Spok1978/hybrid-radio/hardware/kicad/carriers/README.md

# Лист для макетирования доп. плат IP-Radio — отчёт

Срез на 2026-10-09. Это выполнение промпта «Схема одним листом для макетирования и
проверок». Формат — KiCad 10: установленная версия, по указанию заказчика вместо
KiCad 8.

## 1–3. Файлы

| № | Файл | Что это |
|---|---|---|
| 1 | `hybrid-radio-carriers.kicad_pro` | проект KiCad |
| 2 | `hybrid-radio-carriers.kicad_sch` | один лист A1, без иерархии, три зоны в рамках |
| 3 | `hybrid-radio-carriers.net` | нетлист, выгружен из листа командой `kicad-cli sch export netlist` |
| — | `sym-lib-table`, `fp-lib-table` | ссылки на библиотеки проекта `../hybrid-radio.*` |

Лист генерирует скрипт `hardware/skidl/make_carriers_sheet.py` из
`hardware/skidl/carrier.py` (через нетлист `hardware/kicad/Hybryd Radio.net`).
Правки схемы вносить в `carrier.py`, затем перезапускать скрипт.

Проверки, выполненные на этих файлах:

| Проверка | Результат |
|---|---|
| ERC, все уровни серьёзности (`kicad-cli sch erc --severity-all`) | 0 нарушений |
| Сверка соединений с нетлистом SKiDL (`compare_netlists.py`, без P4) | 66 цепей из 66, расхождений 0 |
| P4 ↔ J3, контакт в контакт | 40 из 40 совпадают |
| Деталей плат в нетлисте листа | 91 (плюс P4 и служебные #PWR, #FLG) |
| Позиционные обозначения | как в `docs/35-carrier-boards-parts.md`, без переаннотации |
| DNP | R14, R15 |
| Выводов без провода | 0 (провода: 938 отрезков, точек соединения 176) |

## Отличия от промпта и почему

| Требование промпта | Как сделано | Почему |
|---|---|---|
| KiCad 8, формат 20231120 | KiCad 10 | указание заказчика: формат установленной версии |
| «Полная прорисовка всех соединений» | Внутри каждой зоны все цепи, включая силовые, проведены проводами от вывода к выводу (938 отрезков, 176 точек соединения). У каждой силовой цепи в зоне один символ питания, подключённый проводом. Между зонами цепи связаны одноимёнными метками, как требует промпт. На каждой цепи стоит метка с её именем | Провода прокладывает `hardware/skidl/sch_router.py`: ортогонально, по сетке 1,27 мм. Чужие провода только пересекаются насквозь, без изгиба и ответвления в точке пересечения — KiCad их не соединяет. Отсутствие замыканий подтверждено сверкой нетлиста |
| Сверка скриптом `netlist/check_netlist.py` | сверка скриптом `hardware/skidl/compare_netlists.py` | `check_netlist.py` читает только `netlist/ip-radio.yaml` и не принимает `.net`; к тому же yaml описывает сборку на Raspberry Pi (см. «Расхождения») |
| Символы модулей «по присланной распиновке» | символы проекта из `hybrid-radio.kicad_sym`, распиновки — из `docs/33` §6, §13 | данные уже есть в репозитории (см. Фазу 1) |
| Плата P4 — коннектор «внешнее устройство» | символ P4 (`ESP32-P4-Board`): выводы 1–40 — гребёнка J3 по `docs/33` §2, выводы 41–42 — USB-C | `docs/30` содержит два варианта раскладки, итоговая — в `docs/33` |

## Фаза 1. Распиновки модулей

| Модуль | Какие выводы нужны | Что известно и откуда | Что ещё нужно |
|---|---|---|---|
| RRD-102 (RDA5807M) | VCC, GND ×3, SDA, SCL, LOUT, ROUT, ANT | все 10 выводов: библиотека JLCEDA/EasyEDA (LCSC C9900205627), совпадает с реверсом модуля (`docs/33` §13) | — |
| GY-PCM5102A | VIN, GND, BCK, LCK, DIN, SCK, FLT, DEMP, FMT, XSMT, L, R, AGND, A3V3 | ряды — по фото продавца; подписи 11–15 сняты с обратной стороны (`docs/33` §6) | сверить подписи на модуле при монтаже |
| MCP23017 CJMCU | VCC, GND, SDA, SCL, A0–A2, RESET, INTA, GPA0–6, GPB0–1 | по модулю (`docs/33` §6, §13); GPA7 и GPB7 — только выходы (Microchip DS20001952E) | какой столбец двойного ряда — GPA, какой — GPB (`docs/33` §8) |
| WeAct SY8205 | IN+, IN−, OUT+, OUT−, EN | по фото и замерам заказчика (`docs/33` §13) | работает ли модуль при неподключённом EN (`docs/33` §8) |
| HW-327 (TPA3118) | PWR±, OUT±, IN±, MUTE (2 площадки) | по фото (`docs/33` §6) | **на какой вывод TPA3118 идёт площадка MUTE: 2 (SDZ) или 12 (MUTE)** — от этого зависит выбор R14 или R15 |
| Вилка J3 ↔ гребёнка P4 | 40 контактов | таблица `docs/33` §2, сверена со схемой Waveshare, шелкографией и таблицей производителя | — |

## 5. Электрический аудит

### IRF4905 — защита от переполюсовки
- **Выводы.** По символу KiCad (`Transistor_FET:IRF4905`, наследует `IRF9540N`): 1 — G, 2 — D, 3 — S. По нетлисту: D (2) = 12V_FUSED (вход после F1), S (3) = +12V (нагрузка), G (1) = Q1_GATE через R1 100 кОм на GND.
- **Включение правильное** для P-канального ключа на «плюсе». При верной полярности ток сначала идёт через внутренний диод D→S, затвор оказывается на −12 В относительно истока, и канал открывается. При обратной полярности диод заперт, VGS ≈ 0 — ключ закрыт.
- **Напряжение затвора.** Предел VGS ±20 В; RDS(on) не больше 0,02 Ом при VGS = −10 В (даташит Infineon IRF4905PbF, Rev. 2.1, 2026-04-08). При 12 В на входе VGS = −12 В — в пределах.
- **Стабилитрон D1** (1N4744A, 15 В) стоит катодом на исток (+12V), анодом на затвор. Выводы `Device:D_Zener`: 1 — K, 2 — A; по нетлисту D1-1 = +12V, D1-2 = Q1_GATE. Он ограничивает VGS при выбросах значением 15 В, что меньше 20 В. Напряжение 15 В взято из номинала в перечне; с даташитом 1N4744A в этой сессии не сверено.

### Делитель PWR_SENSE (R2 39 кОм / R3 12 кОм, C3 100 нФ → GPIO50)
- **Коэффициент:** U = Uвх · 12 / (39 + 12) = 0,2353 · Uвх. При 12 В на выводе 2,82 В, при 11 В — 2,59 В, при 13 В — 3,06 В.
- **Пороги ESP32-P4:** VIH ≥ 0,75 · VDD = 2,48 В, предел — VDD + 0,3 = 3,6 В (даташит ESP32-P4 v0.7, табл. 5-4; `docs/ref/esp32-p4-datasheet-v0.7.pdf`).
- **Предельные входы:** 3,6 В на выводе получается при 3,6 / 0,2353 = 15,3 В на входе. Требование промпта «не больше 3,3 В» выполняется до 3,3 / 0,2353 = 14,0 В.
- **Сопротивление и фильтр:** выходное сопротивление делителя 39 ‖ 12 = 9,18 кОм; вместе с C3 постоянная времени 9,18 кОм × 100 нФ = 0,92 мс.
- **Риск.** Выброс, который пропускает TVS D2 (P6KE16A), даёт на выводе больше 3,6 В. При 22 В (оценка уровня ограничения из `docs/33` §14) будет 22 × 0,2353 = 5,2 В. Ток ограничен сопротивлением 9,18 кОм, но насколько вход ESP32-P4 выдерживает такой ток, в этой сессии не проверено. Варианты защиты: стабилитрон 3,3 В параллельно R3 или диод Шоттки на +3V3_ESP. **В схему не внесено — решение за заказчиком.**

### HT7333-A — 3,3 В для тюнера
- **Выводы TO-92:** 1 — GND, 2 — VIN, 3 — VOUT. Источник — даташит Holtek HT73xx rev. 1.30, сверено при создании символа (`make_symbols.py`). По нетлисту U2-1 = GND, U2-2 = LDO_IN, U2-3 = LDO_OUT — совпадает.
- **Цепочка питания:** +5V → L1 10 мкГн → +5V_FILT → FB1 → LDO_IN (C6 10 мкФ, C7 100 нФ) → U2 → LDO_OUT (C8 10 мкФ, C9 100 нФ) → FB2 → +3V3_FM, C27 100 нФ у вывода питания тюнера.
- **Запас по напряжению:** RDA5807M работает от 2,7…3,0…3,3 В (даташит RDA5807M V1.1, таблица рабочих режимов; `docs/ref/RDA5807M_datasheet.pdf`). 3,3 В — верхняя граница; допуск выходного напряжения HT7333 в этой сессии не сверен.
- **Не сверено:** какие конденсаторы на входе и выходе HT7333 рекомендует даташит и какие у них требования (ёмкость, ESR). Скачать даташит не удалось: ссылки Holtek и LCSC отвечают «файл не найден».

### C10, C11 — разделительные на выходах тюнера
- **Потенциалы:** выходы RDA5807M сидят на постоянном напряжении 1,0…1,05…1,1 В («Audio Output Common Mode», даташит RDA5807M V1.1, с. 7). Со стороны микшера 0 В: узел SUM привязан к GND через R9/R12 100 кОм.
- **Полярность верная.** По нетлисту C10-1 (+) = RDA_LOUT, C10-2 = TUNER_L; C11-1 (+) = RDA_ROUT, C11-2 = TUNER_R. Плюс — на стороне с большим потенциалом.
- **Номинал:** 25 В — с большим запасом к 1,1 В. Ёмкость 4,7 мкФ — как C3/C4 в типовой схеме производителя (рис. 8-1, с. 15).

### R4–R6, 47 Ом в линиях I²S
- Это последовательные демпфирующие резисторы у входа PCM5102A: линия идёт через шлейф.
- Довод «ограничивают ток через защитные диоды ЦАП» таблицей PCM5102A не подтверждается: абсолютный предел цифрового входа −0,3…3,9 В (`docs/33` §5, ссылка на с. 6 даташита).
- По `docs/33` §5 можно сначала впаять перемычки, а резисторы ставить, если на осциллографе виден звон.

### Подтяжки и фильтры энкодеров (R16–R19 10 кОм к +3V3_ESP, C23–C26 10 нФ на GND)
- **Постоянная времени:** τ = 10 кОм × 10 нФ = 100 мкс. До порога VIH = 0,75 · VDD фронт дорастает за t = τ · ln(1 / (1 − 0,75)) = 100 мкс × 1,386 = 139 мкс.
- **Запас:** это примерно в 70 раз быстрее интервала между импульсами при быстром ручном вращении. Пример для оценки: 20 импульсов на оборот и 5 об/с дают переход каждые 10 мс. Число импульсов на оборот у купленных EC11 не сверено.

### Микшер: тюнер через 1 кОм, ЦАП через 10 кОм, 100 кОм на землю, RV1/RV2 10 кОм
Расчёт для левого канала, правый такой же. Второй источник по переменному току считается землёй: выходные сопротивления ЦАП и тюнера малы по сравнению с плечами. Входное сопротивление усилителя за C14 не учтено.
- **Тюнер → SUM_L.** Нагрузка R8 ‖ R9 ‖ RV1 = 10 ‖ 100 ‖ 10 = 4,76 кОм; коэффициент K = 4,76 / (1 + 4,76) = 0,826.
- **ЦАП → SUM_L.** Нагрузка R7 ‖ R9 ‖ RV1 = 1 ‖ 100 ‖ 10 = 0,901 кОм; коэффициент K = 0,901 / (10 + 0,901) = 0,083.
- **Соотношение плеч** около 10 : 1 в пользу тюнера выравнивает уровни двух источников:
  - ЦАП: 2,1 В × 0,083 = 0,17 В — сходится с `docs/33` §12;
  - тюнер: 0,36 В (уровень по `docs/33` §12) × 0,826 = 0,30 В.
- **R9/R12 100 кОм** держат узел SUM на постоянном потенциале 0 В. На этом основан вывод о полярности C10/C11 выше.

## 6. Расхождения и УТОЧНИТЬ

### Расхождения источников

| Источник | Что в нём | Как поступлено |
|---|---|---|
| `netlist/ip-radio.yaml` (ревизия 2026-08-21, помечен «НЕАКТУАЛЬНО») | Сборка на Raspberry Pi: A1 — Raspberry Pi 3 B+, свои обозначения (B1, B2, C1, C2, E…, G…), одна цепь +3V3, один моно-сумматор SUM, AMP_IN, кнопки MENU/MEM/PREV/NEXT/SEEK | Для доп. плат не применим: другие обозначения и состав. Цепи взяты из нетлиста `carrier.py`, по которому составлен перечень 35 |
| `docs/16-connection-list.md` | Помечен в шапке «НЕАКТУАЛЬНО — ревизия на Raspberry Pi» | Не использован |
| `docs/30-pin-assignment.md` | Два варианта раскладки; GPIO3, 21, 22, 28–32, 46–49 совпадают с J3 в `docs/33` §2 | Совпадения подтверждают раскладку |
| `docs/30` против `docs/33` | В `docs/30` GPIO50 свободен; в `docs/33` §5 и в схеме это PWR_SENSE (предложение, нужна поддержка в прошивке) | В схеме — как в `docs/33` и `carrier.py` |
| Приоритет промпта «parts > yaml > connection-list > pin-assignment» | Перечень 35 не содержит цепей, а yaml и docs/16 описывают другую сборку | Цепи взяты из нетлиста `carrier.py` — того же источника, из которого сделан перечень 35 |

### УТОЧНИТЬ
1. **R14 или R15.** Нужно прозвонкой выяснить, на какой вывод TPA3118 модуля HW-327 идёт площадка MUTE:
   - вывод 2 (SDZ, LOW — выключено) → впаять R14 на GND;
   - вывод 12 (MUTE, HIGH — выключено) → впаять R15 на +3V3_ESP и инвертировать AMP_SD в прошивке.

   На листе оба резистора DNP, пояснение — у блока.
2. **Защита GPIO50** от выбросов через делитель PWR_SENSE (см. аудит).
3. **Конденсаторы HT7333** — сверить с даташитом Holtek.
4. **GAIN усилителей 26 дБ** — проверить номиналы делителя на модулях HW-327 (`docs/33` §8).
5. **GY-PCM5102A** — перемычки H1–H4 на обороте должны быть разомкнуты (`docs/33` §8).
6. **MCP23017 CJMCU** — какой столбец GPA, какой GPB (`docs/33` §8).
7. **SY8205** — работает ли модуль при неподключённом EN (`docs/33` §8).

## 7. Инструкция

1. **Где файлы:** `hardware/kicad/carriers/` в репозитории. Библиотеки подключаются по относительным путям из `hardware/kicad/hybrid-radio.kicad_sym` и `hybrid-radio.pretty`, поэтому папку не переносить отдельно от `hardware/kicad`.
2. **Открыть:** `hybrid-radio-carriers.kicad_pro` в KiCad 10, затем лист — в редакторе схем.
3. **ERC:** меню «Проверка → Проверка электрических правил» или команда `kicad-cli sch erc --severity-all hardware/kicad/carriers/hybrid-radio-carriers.kicad_sch`. Ожидается 0 нарушений.
4. **Сверка нетлиста:**
   ```
   kicad-cli sch export netlist --format kicadxml -o sch.xml hardware/kicad/carriers/hybrid-radio-carriers.kicad_sch
   .venv/Scripts/python hardware/skidl/compare_netlists.py sch.xml
   ```
   Выводы P4 скрипт покажет лишними: P4 — внешнее устройство, в нетлисте SKiDL его нет. Остальное должно сойтись: 66 цепей, 0 расхождений.
5. **Пересборка листа** после правок в `carrier.py`:
   ```
   .venv/Scripts/python hardware/skidl/carrier.py
   .venv/Scripts/python hardware/skidl/make_carriers_sheet.py
   ```

## 4. Таблица полноты: 91 деталь

Выгружено из нетлиста листа (`kicad-cli`). NC — вывод помечен «не подключено».

| № | Обозн. | Номинал | Зона листа | Цепи (вывод: цепь) | Статус |
|---|---|---|---|---|---|
| 1 | A1 | HW-327 | УСИЛИТЕЛИ | 1: +12V; 2: GND; 3: SPK_L+; 4: SPK_L-; 5: AMP_L_INP; 6: AMP_L_INN; 7: AMP_SD; 8: GND | учтена |
| 2 | A2 | HW-327 | УСИЛИТЕЛИ | 1: +12V; 2: GND; 3: SPK_R+; 4: SPK_R-; 5: AMP_R_INP; 6: AMP_R_INN; 7: AMP_SD; 8: GND | учтена |
| 3 | C1 | 470u 25V | ПИТАНИЕ | 1: +12V; 2: GND | учтена |
| 4 | C2 | 100n | ПИТАНИЕ | 1: +12V; 2: GND | учтена |
| 5 | C3 | 100n | ПИТАНИЕ | 1: PWR_SENSE; 2: GND | учтена |
| 6 | C4 | 470u 16V | ПИТАНИЕ | 1: +5V; 2: GND | учтена |
| 7 | C5 | 100n | ПИТАНИЕ | 1: +5V; 2: GND | учтена |
| 8 | C6 | 10u | СИГНАЛЬНАЯ | 1: LDO_IN; 2: GND | учтена |
| 9 | C7 | 100n | СИГНАЛЬНАЯ | 1: LDO_IN; 2: GND | учтена |
| 10 | C8 | 10u | СИГНАЛЬНАЯ | 1: LDO_OUT; 2: GND | учтена |
| 11 | C9 | 100n | СИГНАЛЬНАЯ | 1: LDO_OUT; 2: GND | учтена |
| 12 | C10 | 4u7 25V | СИГНАЛЬНАЯ | 1: RDA_LOUT; 2: TUNER_L | учтена |
| 13 | C11 | 4u7 25V | СИГНАЛЬНАЯ | 1: RDA_ROUT; 2: TUNER_R | учтена |
| 14 | C12 | 100p C0G | СИГНАЛЬНАЯ | 1: ANT_IN; 2: ANT | учтена |
| 15 | C13 | 100n | СИГНАЛЬНАЯ | 1: +5V; 2: GND | учтена |
| 16 | C14 | 3u3 film 63V | СИГНАЛЬНАЯ | 1: MIX_L; 2: AMP_L_INP | учтена |
| 17 | C15 | 3u3 film 63V | СИГНАЛЬНАЯ | 1: AMP_L_INN; 2: GND | учтена |
| 18 | C16 | 1000u 25V | УСИЛИТЕЛИ | 1: +12V; 2: GND | учтена |
| 19 | C17 | 100n | УСИЛИТЕЛИ | 1: +12V; 2: GND | учтена |
| 20 | C18 | 3u3 film 63V | СИГНАЛЬНАЯ | 1: MIX_R; 2: AMP_R_INP | учтена |
| 21 | C19 | 3u3 film 63V | СИГНАЛЬНАЯ | 1: AMP_R_INN; 2: GND | учтена |
| 22 | C20 | 1000u 25V | УСИЛИТЕЛИ | 1: +12V; 2: GND | учтена |
| 23 | C21 | 100n | УСИЛИТЕЛИ | 1: +12V; 2: GND | учтена |
| 24 | C22 | 100n | СИГНАЛЬНАЯ | 1: +3V3_ESP; 2: GND | учтена |
| 25 | C23 | 10n | СИГНАЛЬНАЯ | 1: ENC1_A; 2: GND | учтена |
| 26 | C24 | 10n | СИГНАЛЬНАЯ | 1: ENC1_B; 2: GND | учтена |
| 27 | C25 | 10n | СИГНАЛЬНАЯ | 1: ENC2_A; 2: GND | учтена |
| 28 | C26 | 10n | СИГНАЛЬНАЯ | 1: ENC2_B; 2: GND | учтена |
| 29 | C27 | 100n | СИГНАЛЬНАЯ | 1: +3V3_FM; 2: GND | учтена |
| 30 | D1 | 1N4744A 15V | ПИТАНИЕ | 1: +12V; 2: Q1_GATE | учтена |
| 31 | D2 | P6KE16A TVS | ПИТАНИЕ | 1: +12V; 2: GND | учтена |
| 32 | D3 | +12V green | ПИТАНИЕ | 1: GND; 2: LED_12V | учтена |
| 33 | D4 | +5V green | ПИТАНИЕ | 1: GND; 2: LED_5V | учтена |
| 34 | F1 | T5A | ПИТАНИЕ | 1: +12V_IN; 2: 12V_FUSED | учтена |
| 35 | FB1 | bead | СИГНАЛЬНАЯ | 1: +5V_FILT; 2: LDO_IN | учтена |
| 36 | FB2 | bead | СИГНАЛЬНАЯ | 1: LDO_OUT; 2: +3V3_FM | учтена |
| 37 | J1 | 12V 5.5x2.1 | ПИТАНИЕ | 1: +12V_IN; 2: GND; 3: NC | учтена |
| 38 | J2 | 5V to P4 USB-C | ПИТАНИЕ | 1: +5V; 2: NC; 3: NC; 4: GND; SH: GND | учтена |
| 39 | J3 | to P4 J3 | СИГНАЛЬНАЯ | 1: NC; 2: +3V3_ESP; 3: NC; 4: I2C_SDA; 5: GND; 6: I2C_SCL; 7: NC; 8: NC; 9: NC; 10: GND; 11: SPARE_GPIO5; 12: BTN_PWR; 13: GND; 14: SPARE_GPIO4; 15: ENC1_A; 16: ENC1_SW; 17: ENC1_B; 18: +3V3_ESP; 19: GND; 20: ENC2_A; 21: NC; 22: ENC2_B; 23: NC; 24: ENC2_SW; 25: NC; 26: GND; 27: NC; 28: NC; 29: GND; 30: NC; 31: EXP_INT; 32: AMP_SD_GPIO49; 33: GND; 34: PWR_SENSE; 35: I2S_BCK; 36: SPARE_GPIO51; 37: I2S_LRCK; 38: SPARE_GPIO52; 39: I2S_DIN; 40: GND | учтена |
| 40 | J4 | ANT | СИГНАЛЬНАЯ | 1: ANT_IN; 2: GND | учтена |
| 41 | J5 | SPK L | УСИЛИТЕЛИ | 1: SPK_L+; 2: SPK_L- | учтена |
| 42 | J6 | SPK R | УСИЛИТЕЛИ | 1: SPK_R+; 2: SPK_R- | учтена |
| 43 | J7 | PRESETS 1-4 | СИГНАЛЬНАЯ | 1: BTN_P1; 2: BTN_P2; 3: BTN_P3; 4: BTN_P4; 5: GND | учтена |
| 44 | J8 | SPARE | СИГНАЛЬНАЯ | 1: SPARE_GPIO4; 2: SPARE_GPIO5; 3: SPARE_GPIO51; 4: SPARE_GPIO52; 5: +3V3_ESP; 6: GND | учтена |
| 45 | J9 | EC11 | СИГНАЛЬНАЯ | 1: ENC1_A; 2: GND; 3: ENC1_B; 4: ENC1_SW; 5: GND | учтена |
| 46 | J10 | EC11 | СИГНАЛЬНАЯ | 1: ENC2_A; 2: GND; 3: ENC2_B; 4: ENC2_SW; 5: GND | учтена |
| 47 | J11 | BTN PWR | СИГНАЛЬНАЯ | 1: BTN_PWR; 2: GND | учтена |
| 48 | J12 | PRESETS 5-8 + MODE | СИГНАЛЬНАЯ | 1: BTN_P5; 2: BTN_P6; 3: BTN_P7; 4: BTN_P8; 5: BTN_MODE; 6: GND | учтена |
| 49 | J13 | 12V to AMP | ПИТАНИЕ | 1: +12V; 2: GND | учтена |
| 50 | J14 | 5V to SIGNAL | ПИТАНИЕ | 1: +5V; 2: GND; 3: PWR_SENSE | учтена |
| 51 | J15 | 5V IN | СИГНАЛЬНАЯ | 1: +5V; 2: GND; 3: PWR_SENSE | учтена |
| 52 | J16 | TO AMPS | СИГНАЛЬНАЯ | 1: AMP_L_INP; 2: AMP_L_INN; 3: AMP_R_INP; 4: AMP_R_INN; 5: AMP_SD; 6: GND | учтена |
| 53 | J17 | 12V IN | УСИЛИТЕЛИ | 1: +12V; 2: GND | учтена |
| 54 | L1 | 10uH 3A | СИГНАЛЬНАЯ | 1: +5V; 2: +5V_FILT | учтена |
| 55 | Q1 | IRF4905 | ПИТАНИЕ | 1: Q1_GATE; 2: 12V_FUSED; 3: +12V | учтена |
| 56 | R1 | 100k | ПИТАНИЕ | 1: Q1_GATE; 2: GND | учтена |
| 57 | R2 | 39k | ПИТАНИЕ | 1: +12V; 2: PWR_SENSE | учтена |
| 58 | R3 | 12k | ПИТАНИЕ | 1: PWR_SENSE; 2: GND | учтена |
| 59 | R4 | 47 | СИГНАЛЬНАЯ | 1: I2S_BCK; 2: DAC_BCK | учтена |
| 60 | R5 | 47 | СИГНАЛЬНАЯ | 1: I2S_LRCK; 2: DAC_LCK | учтена |
| 61 | R6 | 47 | СИГНАЛЬНАЯ | 1: I2S_DIN; 2: DAC_DIN | учтена |
| 62 | R7 | 1k | СИГНАЛЬНАЯ | 1: TUNER_L; 2: SUM_L | учтена |
| 63 | R8 | 10k | СИГНАЛЬНАЯ | 1: DAC_L; 2: SUM_L | учтена |
| 64 | R9 | 100k | СИГНАЛЬНАЯ | 1: SUM_L; 2: GND | учтена |
| 65 | R10 | 1k | СИГНАЛЬНАЯ | 1: TUNER_R; 2: SUM_R | учтена |
| 66 | R11 | 10k | СИГНАЛЬНАЯ | 1: DAC_R; 2: SUM_R | учтена |
| 67 | R12 | 100k | СИГНАЛЬНАЯ | 1: SUM_R; 2: GND | учтена |
| 68 | R13 | 1k | СИГНАЛЬНАЯ | 1: AMP_SD_GPIO49; 2: AMP_SD | учтена |
| 69 | R14 | 100k (SDZ) | СИГНАЛЬНАЯ | 1: AMP_SD; 2: GND | учтена (DNP) |
| 70 | R15 | 100k (MUTE) | СИГНАЛЬНАЯ | 1: AMP_SD; 2: +3V3_ESP | учтена (DNP) |
| 71 | R16 | 10k | СИГНАЛЬНАЯ | 1: ENC1_A; 2: +3V3_ESP | учтена |
| 72 | R17 | 10k | СИГНАЛЬНАЯ | 1: ENC1_B; 2: +3V3_ESP | учтена |
| 73 | R18 | 10k | СИГНАЛЬНАЯ | 1: ENC2_A; 2: +3V3_ESP | учтена |
| 74 | R19 | 10k | СИГНАЛЬНАЯ | 1: ENC2_B; 2: +3V3_ESP | учтена |
| 75 | R20 | 2k2 | ПИТАНИЕ | 1: +12V; 2: LED_12V | учтена |
| 76 | R21 | 1k | ПИТАНИЕ | 1: +5V; 2: LED_5V | учтена |
| 77 | RV1 | 10k 3296W | СИГНАЛЬНАЯ | 1: SUM_L; 2: MIX_L; 3: GND | учтена |
| 78 | RV2 | 10k 3296W | СИГНАЛЬНАЯ | 1: SUM_R; 2: MIX_R; 3: GND | учтена |
| 79 | TP1 | +12V | ПИТАНИЕ | 1: +12V | учтена |
| 80 | TP2 | +5V | ПИТАНИЕ | 1: +5V | учтена |
| 81 | TP3 | GND | ПИТАНИЕ | 1: GND | учтена |
| 82 | TP4 | +3V3_FM | СИГНАЛЬНАЯ | 1: +3V3_FM | учтена |
| 83 | TP5 | PWR_SENSE | СИГНАЛЬНАЯ | 1: PWR_SENSE | учтена |
| 84 | TP6 | SUM_L | СИГНАЛЬНАЯ | 1: SUM_L | учтена |
| 85 | TP7 | SUM_R | СИГНАЛЬНАЯ | 1: SUM_R | учтена |
| 86 | TP8 | GND | СИГНАЛЬНАЯ | 1: GND | учтена |
| 87 | U1 | WeAct-SY8205 | ПИТАНИЕ | 1: +12V; 2: GND; 3: +5V; 4: GND; 5: NC | учтена |
| 88 | U2 | HT7333-A | СИГНАЛЬНАЯ | 1: GND; 2: LDO_IN; 3: LDO_OUT | учтена |
| 89 | U3 | RRD-102 | СИГНАЛЬНАЯ | 1: I2C_SDA; 2: I2C_SCL; 3: NC; 4: NC; 5: +3V3_FM; 6: GND; 7: RDA_LOUT; 8: RDA_ROUT; 9: NC; 10: ANT | учтена |
| 90 | U4 | GY-PCM5102A | СИГНАЛЬНАЯ | 1: +5V; 2: GND; 3: DAC_LCK; 4: DAC_DIN; 5: DAC_BCK; 6: GND; 7: DAC_L; 8: GND; 9: DAC_R; 10: GND; 11: DAC_A3V3; 12: GND; 13: DAC_A3V3; 14: GND; 15: GND | учтена |
| 91 | U5 | MCP23017-CJMCU | СИГНАЛЬНАЯ | 1: GND; 2: GND; 3: GND; 4: +3V3_ESP; 5: NC; 6: NC; 7: I2C_SDA; 8: I2C_SCL; 9: GND; 10: +3V3_ESP; 11: +3V3_ESP; 12: NC; 13: BTN_MODE; 14: BTN_P8; 15: NC; 16: NC; 17: NC; 18: NC; 19: NC; 20: NC; 21: GND; 22: EXP_INT; 23: BTN_P1; 24: BTN_P2; 25: BTN_P3; 26: BTN_P4; 27: BTN_P5; 28: BTN_P6; 29: BTN_P7; 30: NC | учтена |
