Spok1978/hybrid-radio/docs/10-shutdown-and-data-safety.md

# 10. Выключение питания и сохранность данных

> **НЕАКТУАЛЬНО — ревизия на Raspberry Pi.** С 2026-08-26 приёмник строится
> только на плате Waveshare ESP32-P4-WIFI6-Touch-LCD-5 ([24](24-main-build-p4.md)),
> Raspberry Pi в проекте не используется. Документ сохранён как история
> решений; для сборки, схемы и прошивки не применять. Актуальное: доп. платы —
> [33](33-carrier-board.md), перечень деталей — [35](35-carrier-boards-parts.md),
> выводы P4 — [33](33-carrier-board.md) §2, прошивка — [26](26-firmware-spec.md).

> **Статус на 2026-08-26: применимо только к ревизии на Raspberry Pi.**
> Всё обоснование построено на Linux — overlayfs, `remount ro/rw`, атомарный
> `rename()` на ext4. У основной сборки на ESP32-P4 ([24](24-main-build-p4.md))
> ничего из этого нет, поэтому вывод «батарея не нужна» для неё **не
> доказан и отменён**: 2026-08-26 принято ставить батарею в штатный разъём
> платы. Что осталось установить — вопрос Q14 в [06](06-open-questions.md).

Вопрос: можно ли сделать так, чтобы дёрганье шнура не убивало карту памяти
и контроллер, и не придётся ли ради этого ставить батарею.

**Короткий ответ: батарея не нужна.** Причина порчи карты — не сам обрыв
питания, а **запись, прерванная на середине**. Если в обычной работе на карту
ничего не пишется, рвать питание можно сколько угодно.

## 1. Что на самом деле ломается

| Что | Ломается ли от снятия питания | Комментарий |
|---|---|---|
| Процессор Pi, модули, усилитель | **нет** | обрыв питания сам по себе электронику не повреждает |
| Электроника от **выбросов** при втыкании/выдёргивании | может | ровно для этого на входе TVS и фильтр, см. [09](09-power-supply.md), п. 4 |
| Файловая система на microSD | **да, это главный риск** | прерванная запись → повреждённые метаданные, «не грузится» |
| Сама карта на внутреннем уровне | **да, реже, но насмерть** | контроллер карты в момент записи переписывает свои служебные таблицы; обрыв здесь может окирпичить карту целиком |

То есть «сжечь контроллер» дёрганьем шнура нельзя. Убить можно карту — и
только если в этот момент шла запись.

Отсюда стратегия: **сделать так, чтобы записи в обычной работе не было вообще**,
а редкие записи сделать атомарными. Дальше по уровням, от бесплатного к дорогому.

## 2. Уровень 1 — корень только для чтения (обязательно)

Штатная возможность Raspberry Pi OS: `raspi-config` → Performance Options →
Overlay File System. Система монтирует корень **только для чтения** и все
изменения держит в оперативной памяти поверх него.

Что это даёт:

- в обычной работе на карту **не пишется ничего** — ни логи, ни временные
  файлы, ни отметки времени;
- питание можно снимать в любой момент, портиться нечему;
- побочный плюс: карта перестаёт изнашиваться, а прибор всегда стартует
  из одного и того же известного состояния.

Что настроить вместе с этим:

- `/var/log` и `/tmp` — в tmpfs (при overlayfs это получается само);
- **swap выключить** (`dphys-swapfile swapoff` и отключить службу) — иначе
  идёт постоянная запись;
- раздел `/boot` тоже смонтировать `ro`.

Остаточный риск: момент, когда мы сами что-то сохраняем. Про него — уровень 2.

## 3. Уровень 2 — атомарная запись пользовательских данных

Что мы вообще пишем: список станций, пресеты, профили Wi-Fi, настройки.
Это редкие события по команде пользователя, а не фоновая работа.

Правила:

1. **Отдельный небольшой раздел** под данные (например 200–500 МБ), а не
   корень. Тогда даже испорченный раздел данных не мешает прибору загрузиться —
   он поднимется с пустым списком станций, а не «не поднимется вообще».
2. Раздел смонтирован **`ro` по умолчанию**. Перед записью — `mount -o remount,rw`,
   после — сразу `remount,ro`. Окно записи меряется долями секунды.
3. **Запись только атомарная**, тремя шагами:

   ```
   1) пишем во временный файл  stations.json.tmp
   2) fsync()  — данные реально легли на карту, а не в кеш
   3) rename() — атомарная замена: либо старый файл, либо новый, третьего нет
   ```

   При обрыве питания в любой момент этой последовательности получаем либо
   прежний список станций, либо новый. Испорченного файла не бывает.

4. Дополнительно — **две копии по очереди** (A/B) с контрольной суммой:
   при старте берём ту, что проходит проверку. Дёшево и снимает вопрос совсем.

После уровней 1 и 2 дёрганье шнура перестаёт быть опасным **по конструкции**,
а не «если повезёт».

## 4. Уровень 3 — кнопка мягкого выключения со снятием питания

Это уже не про безопасность (её закрыли выше), а про удобство и про то, чтобы
дёрганье шнура вообще перестало быть обычным способом выключения.

Работает на двух штатных оверлеях Raspberry Pi OS:

```
dtoverlay=gpio-shutdown,gpio_pin=17     # кнопка → корректное выключение
dtoverlay=gpio-poweroff,gpiopin=26      # сигнал «выключился» → снять питание
```

Параметры из документации оверлеев (проверено 2026-08-18):

- **`gpio-shutdown`** — «Initiates a shutdown when GPIO pin changes»; вывод
  настраивается как кнопка, генерирующая событие `KEY_POWER`.
  Параметры: `gpio_pin` (по умолчанию 3), `active_low` (по умолчанию 1),
  `gpio_pull` (по умолчанию `up`), `debounce` (по умолчанию 100 мс).
  **Берём свободный вывод, не 3** — GPIO3 занят шиной I²C тюнера.
- **`gpio-poweroff`** — «Drives a GPIO high or low on poweroff (including halt)».
  Параметры: `gpiopin` (по умолчанию 26), `active_low` («Set if power control
  device requires high→low transition»), `active_delay_ms` (100),
  `inactive_delay_ms` (100), `timeout_ms` (3000).
  **Оговорка из той же документации:** «Using this overlay interferes with the
  normal power-down sequence, preventing the kernel from resetting the SoC» —
  то есть после этого плата уже не перезагружается сама, а ждёт снятия питания.
  Нам это и нужно, но знать надо.

Схема управления питанием:

```
   12 В ──[P-MOSFET, высокая сторона]──► остальная схема
              │ затвор
              │
        ┌─────┴───────────────────────────┐
        │  фиксирующий ключ (защёлка):    │
        │   • кнопка ВКЛ — включает       │◄── кнопка на панели
        │   • сигнал с GPIO26 — снимает   │◄── gpio-poweroff
        └─────────────────────────────────┘
```

Порядок работы получается такой:

1. нажал кнопку → защёлка включила питание → Pi загрузился, играет;
2. нажал кнопку ещё раз → `gpio-shutdown` увидел событие → система корректно
   завершилась → `gpio-poweroff` дёрнул GPIO26 → защёлка сняла питание.

Прибор ведёт себя как бытовая техника, и шнур трогать незачем.

Реализация защёлки — либо два транзистора россыпью, либо готовый модуль
«latching power switch / soft power controller» (продаются как раз под Pi).
Конкретную схему выберем при разводке; на макете можно жить и без неё.

## 5. Уровень 4 — запас хода на конденсаторах (не рекомендую)

Это единственный способ сделать **настоящее** корректное выключение при
внезапной пропаже питания без батареи: детектор пропадания 12 В на GPIO плюс
накопитель, который держит плату, пока идёт завершение работы.

Считаем честно. Держим на шине 12 В, преобразователь работает до ~7,5 В:

```
E = ½·C·(U₁² − U₂²) = ½·C·(12² − 7,5²) = 43,9·C   [Дж, C в фарадах]
```

Нагрузка при завершении работы (усилитель глушим сразу) ≈ 8 Вт.

| Что хотим успеть | Время | Нужная энергия | Нужная ёмкость |
|---|---|---|---|
| Дописать файл и перемонтировать в ro | 0,3 с | 2,4 Дж | **≈55 000 мкФ** |
| Полное корректное выключение Pi | ~8 с | 64 Дж | **≈1,5 Ф** (ионисторы) |

Первое — это две банки по 27 000 мкФ на 25 В: реально, но громоздко.
Второе — сборка из шести ионисторов 2,7 В / 10 Ф последовательно, плюс
балансировочные резисторы, плюс ограничитель пускового тока (иначе при
включении такая ёмкость просто посадит блок питания в защиту).

**Вывод: после уровней 1–3 это лишнее.** Если писать нечего, то и дописывать
при пропадании питания нечего.

## 6. Ещё один рычаг: сама карта памяти

Есть промышленные microSD с защитой от потери питания (power-loss protection),
у которых контроллер сам доводит начатую внутреннюю операцию до конца.
Стоят заметно дороже бытовых, но это прямое лекарство от самого неприятного
сценария — окирпичивания карты на уровне её собственных служебных таблиц.

Для нашего случая это **необязательно** (при read-only корне карта почти не
пишется), но если попадётся под руку — брать её, а не самую дешёвую.

## 7. Что делаем

| Уровень | Стоимость | Берём? |
|---|---|---|
| 1. Корень read-only (overlayfs), swap выключен | 0 | **да, обязательно** |
| 2. Отдельный раздел данных, `ro` по умолчанию, атомарная запись + A/B | 0 | **да** |
| 3. Кнопка мягкого выключения + автоматическое снятие питания | одна плата/пара транзисторов | **да, но после того как заработает основное** |
| 4. Ионисторы и детектор пропадания питания | дорого и громоздко | нет |
| Батарея | — | **не нужна** |

## 8. Что проверить на макете

1. Убедиться, что при работе на карту действительно ничего не пишется:
   ```bash
   sudo iotop -o -b -n 5     # либо grep -c '' /proc/diskstats до и после
   ```
2. **Тест на выживание:** 20 раз подряд снять питание рубильником во время
   работы (в том числе во время воспроизведения) и убедиться, что система
   каждый раз поднимается.
3. Отдельно: снять питание **в момент сохранения станции** несколько раз.
   Ожидаемый результат — либо старый список, либо новый, но система жива.
4. Проверить, что после `poweroff` GPIO26 действительно меняет уровень
   (тестером), прежде чем подключать к нему силовую защёлку.

## 9. Источники

- Описание и параметры оверлеев `gpio-shutdown` и `gpio-poweroff` (включая
  оговорку про вмешательство в последовательность выключения):
  https://github.com/raspberrypi/linux/blob/rpi-6.6.y/arch/arm/boot/dts/overlays/README
  (прочитано 2026-08-18)
- Overlay File System в `raspi-config` — штатная возможность Raspberry Pi OS.
- Расчёты энергии накопителя в п. 5 — арифметика по формуле E = ½CU²,
  показана в тексте.
