Spok1978/hybrid-radio/docs/12-audit-response.md

# 12. Ответ на внешний аудит от 2026-08-21

> **НЕАКТУАЛЬНО — ревизия на Raspberry Pi.** С 2026-08-26 приёмник строится
> только на плате Waveshare ESP32-P4-WIFI6-Touch-LCD-5 ([24](24-main-build-p4.md)),
> Raspberry Pi в проекте не используется. Документ сохранён как история
> решений; для сборки, схемы и прошивки не применять. Актуальное: доп. платы —
> [33](33-carrier-board.md), перечень деталей — [35](35-carrier-boards-parts.md),
> выводы P4 — [33](33-carrier-board.md) §2, прошивка — [26](26-firmware-spec.md).

Заказчик получил независимый аудит проекта, выполненный другой ИИ-системой,
и передал его на проверку. Здесь: что я перепроверил по первоисточникам,
с чем согласился, что исправлено и где ошибся сам аудит.

**Метод проверки.** Каждое проверяемое утверждение сверялось не с текстом
аудита, а с первоисточником: локальные копии даташитов RDA5807M и TPA31xxD2
(разбор текста из PDF), официальный список оверлеев Raspberry Pi (файл README
скачан целиком и просмотрен поиском по трём веткам ядра), живые запросы к API
Radio Browser.

## 1. Итог одной таблицей

| Замечание аудита | Вердикт | Что сделано |
|---|---|---|
| D6 (XL4015) противоречит требованию «синхронный buck» из документа 09 | **верно, моя ошибка** | D6 заменён, в 09 добавлен признак «как отличить синхронный» |
| TVS P6KE15A (V_RWM 12,8 В) стоит впритык к шине 12 В | **верно** | D9 → **P6KE16A**, документы 09 и 11 приведены к одному номиналу |
| Питание RDA5807M — 2,7–3,3 В, а не 2,7–3,6 В | **верно** | исправлено в 02 со ссылкой на страницы даташита |
| Усиление TPA3118 на 20 дБ: R1 = 5,6 кОм, R2 = OPEN; модули часто идут на 36 дБ | **верно** | внесено в 04, добавлен резистор E9 в список покупок |
| Разделительные конденсаторы: даташит рекомендует 1,5 мкФ при 20 дБ | **верно** | E3: 1 мкФ → **2,2 мкФ** |
| Чувствительность RDA5807M — не «средняя», узкое место в модуле | **верно** | формулировка в 02 уточнена |
| Панель Waveshare заводится мейнлайн-оверлеем, риск драйвера снят | **частично неверно** | см. §2 — для нашей 5″ (C) параметра нет, экран заменён |
| «Синхронный модуль класса MP1584» | **неверно** | MP1584 несинхронный, см. §2 |
| Оверлеи `rotary-encoder` и `gpio-key` вместо опроса GPIO | **верно и полезно** | принято, см. [13](13-gpio-map.md) |
| Составить карту GPIO до разводки | **верно** | сделано: [13-gpio-map.md](13-gpio-map.md) |
| Q7 (эфир OIRT) — главный стратегический риск | согласен, уже так и стоит | без изменений |

## 2. Где ошибается сам аудит

### 2.1. `5_0_inchC` в мейнлайн-оверлее не существует

Аудит утверждает: панель Waveshare 5inch DSI LCD (C) работает без драйвера
производителя, «достаточно строки `dtoverlay=vc4-kms-dsi-waveshare-panel,5_0_inchC`».

Проверка: файл README списка оверлеев скачан целиком (258 КБ) из репозитория
`raspberrypi/linux` и просмотрен поиском по веткам **rpi-6.6.y, rpi-6.12.y и
rpi-6.17.y**. Оверлей `vc4-kms-dsi-waveshare-panel` действительно есть,
но **строки `5_0_inchC` нет ни в одной ветке — 0 совпадений**. Все
пятидюймовые записи там — 720×1280 (`5_0_inch`, `5_0_inch_a`), а единственная
мейнлайн-панель 1024×600 — это **`7_0_inchC   7.0" C 1024x600`**.

Следствие: заявленный аудитом «снятый риск» для нашей панели **не снят**.
Зато нашлось решение лучше — перейти на **Waveshare 7inch DSI LCD (C)**:
те же ландшафтные 1024×600, но со штатной поддержкой. Требование R3
допускает и 5″, и 7″, так что переписывать требования не нужно.
Изменения внесены в [05](05-display-and-ui.md) и [11](11-shopping-list.md).

Побочно из того же списка параметров выяснилось полезное: у оверлея есть ключ
`i2c1`, сажающий тачскрин на GPIO2/3. По умолчанию тач сидит на шине
i2c_csi_dsi по шлейфу и с тюнером не конфликтует — **но этот ключ включать
нельзя**, иначе тач и тюнер окажутся на одних выводах.

### 2.2. MP1584 — не синхронный преобразователь

Аудит правильно ловит противоречие с XL4015, но в качестве замены называет
«класс распространённых модулей — на MP1584 и аналогах». По даташиту
Monolithic Power Systems MP1584 — «3A, 1.5MHz, 28V Step-Down Converter» со
**встроенным только верхним ключом**, и в типовой схеме ему нужен внешний
диод Шоттки. То есть он несинхронный ровно как XL4015, только на другой
частоте. Замена по такой рекомендации не исправила бы исходную ошибку.

В документ 09 внесён работающий признак: **у синхронного модуля нет внешнего
диода Шоттки рядом с дросселем**. Несинхронные из распространённых —
LM2596, XL4015, XL4016, MP1584. Синхронные — SY8205, MP2307, MP2315.

### 2.3. Мелочь: часть ссылок аудита ведёт на перепродавцов и обзоры

Номиналы и параметры я перепроверял по даташитам и официальной документации,
а не по этим ссылкам. На выводы это не повлияло — но брать оттуда цифры
в проект не стоит.

## 3. Что перепроверено и подтвердилось

**Даташит RDA5807M** (локальная копия, разбор текста PDF):

- стр. 1: «2.7 to 3.3 V operation voltage»;
- стр. 5: `VDD Supply Voltage 2.7 / 3.0 / 3.3 V`, `IVDD ... ENABLE=1 20 mA`
  — это подтверждает и поправку по питанию, и нашу оценку тока ~25 мА;
- стр. 6: чувствительность 1,2–1,5 мкВ на 65 МГц и 1,3–1,5 мкВ на 108 МГц.

**Даташит TPA31xxD2**, таблица 1 «Gain and Master/Slave»:

```
MODE    GAIN    R1 (to GND)   R2 (to GVDD)   INPUT IMPEDANCE
Master  20 dB   5.6 kΩ        OPEN           60 kΩ
Master  26 dB   20 kΩ         100 kΩ         30 kΩ
Master  32 dB   39 kΩ         100 kΩ         15 kΩ
Master  36 dB   47 kΩ         75 kΩ          9 kΩ
```

и рекомендованные разделительные конденсаторы: при 20 дБ — 1,5 мкФ (срез 1,8 Гц).

**Radio Browser**, живой запрос 2026-08-21: 62 725 станций, 241 страна,
софт 0.7.44, по коду RU — 3 191 станция. Аудит приводил 62 719 и 3 191 —
расхождение в пределах роста каталога за несколько часов. То есть аудит
действительно делал живые проверки, а не пересказывал документ.

**Оверлеи `gpio-shutdown` и `gpio-poweroff`** — параметры совпадают с тем,
что уже записано в [10](10-shutdown-and-data-safety.md).

## 4. Принятые рекомендации

| Что | Куда внесено |
|---|---|
| Оверлеи `rotary-encoder` и `gpio-key` вместо опроса GPIO из Python | [13](13-gpio-map.md) |
| Карта распределения GPIO до разводки | [13](13-gpio-map.md) |
| Кнопка питания: `gpio-shutdown` с `debounce` ≈ 3000 мс → выключение удержанием | [13](13-gpio-map.md), помечено «проверить на макете» |
| ОС: 64-битная Raspberry Pi OS **Lite**, минимум Bookworm | [13](13-gpio-map.md) |
| Проверить наличие `hls+https` в сборке MPD; разворачивать `.m3u8` своим кодом либо играть через mpv | [13](13-gpio-map.md) |
| Аппаратный watchdog + надзор systemd за службой воспроизведения | [13](13-gpio-map.md) |
| Честный ориентир по звуку: ~7–8 Вт при 1 % THD, 12–15 Вт — пиковые при 10 % | [04](04-audio-path.md) |
| Не блокировать архитектурно «прямую установку частоты» RDA5807 (рег. 08H) | ниже, §5 |

## 5. Принято к сведению, но не внесено в конструкцию

- **«Экспертный режим» прямой частоты RDA5807M** (регистр 07H бит FREQ_MODE +
  регистр 08H, шаг 1 кГц во всём диапазоне 50–115 МГц). Возможность
  недокументированная, известна по экспериментам радиолюбителей. В схеме
  ничего не меняет; учтено как требование к драйверу — не завязывать
  архитектуру жёстко на переключение BAND.
- **Внешнее антенное гнездо на корпусе.** Согласен, что для OIRT это часто
  разница между «шум» и «станция», но позиция зависит от корпуса и уже
  отложена вместе с Q8.
- **«Младшая» ревизия на Zero 2 W + SPI-экран 3,5″.** Как отдельный будущий
  прибор — имеет право на жизнь, но это другое устройство: R3 пришлось бы
  переписывать, а типовой SPI-экран даёт около 5 кадров в секунду штатно.
  В текущий проект не берём.
- **Подделки и перемаркировка TPA31xx.** Учтено как замечание к закупке C2,
  на конструкцию не влияет: нам нужны 8–12 Вт из заявленных 2×30.

## 6. Что это меняет в списке покупок

| Позиция | Было | Стало |
|---|---|---|
| A3 | Waveshare 5inch DSI LCD (C) | **Waveshare 7inch DSI LCD (C)**, мейнлайн-оверлей `7_0_inchC` |
| D6 | модуль на XL4015 | **синхронный** модуль без внешнего диода (SY8205 / MP2307) |
| D9 | P6KE15A | **P6KE16A** (или SMBJ14A) |
| E3 | плёночный 1 мкФ | плёночный **2,2 мкФ** |
| E9 | — | **резистор 5,6 кОм** под усиление 20 дБ |

## 7. Источники проверки

- Список оверлеев Raspberry Pi, ветки rpi-6.6.y / rpi-6.12.y / rpi-6.17.y:
  `https://raw.githubusercontent.com/raspberrypi/linux/<ветка>/arch/arm/boot/dts/overlays/README`
  (файлы скачаны целиком и просмотрены поиском 2026-08-21)
- Даташит RDA5807M — локальная копия, стр. 1, 5, 6, 9, 12
- Даташит TPA31xxD2 (Texas Instruments) — локальная копия, раздел 7.3.1 и таблица 1
- MP1584, топология: https://www.monolithicpower.com и подтверждающие обзоры
  («integrated internal high-side MOSFET», требуется внешний диод Шоттки)
- Radio Browser: `GET https://de1.api.radio-browser.info/json/stats` и
  `/json/countrycodes`, 2026-08-21
