Spok1978/hybrid-radio/docs/16-connection-list.md

# 16. Перечень соединений «откуда → куда»

> **НЕАКТУАЛЬНО — ревизия на Raspberry Pi.** С 2026-08-26 приёмник строится
> только на плате Waveshare ESP32-P4-WIFI6-Touch-LCD-5 ([24](24-main-build-p4.md)),
> Raspberry Pi в проекте не используется. Документ сохранён как история
> решений; для сборки, схемы и прошивки не применять. Актуальное: доп. платы —
> [33](33-carrier-board.md), перечень деталей — [35](35-carrier-boards-parts.md),
> выводы P4 — [33](33-carrier-board.md) §2, прошивка — [26](26-firmware-spec.md).

Для расстановки в Fritzing или для монтажа по списку. Обозначения позиций —
из [11-shopping-list.md](11-shopping-list.md), выводы Pi — из
[13-gpio-map.md](13-gpio-map.md). Пояснения — в [15](15-wiring-breadboard.md).

Узлы (цепи), к которым всё сходится: **+12V**, **+5V**, **+3V3**, **GND**, **SUM**.

Резисторы дозаказа обозначены `R1k`, `R20k`, `R100k+`.

---

## 1. Ввод 12 В — пайка, провод 20 AWG

| № | Откуда | Куда |
|---|---|---|
| 1 | D2 гнездо, центральный контакт | D3 выключатель, контакт 1 |
| 2 | D3 выключатель, контакт 2 | D4 держатель предохранителя, контакт 1 |
| 3 | D4 держатель, контакт 2 | D7 IRF4905, **сток** (вывод 2, он же фланец) |
| 4 | D7 IRF4905, **исток** (вывод 3) | цепь **+12V** |
| 5 | D7 IRF4905, **затвор** (вывод 1) | E2 100 кОм, вывод 1 |
| 6 | E2 100 кОм, вывод 2 | **GND** |
| 7 | D8 1N4744A, **анод** | D7 затвор |
| 8 | D8 1N4744A, **катод** (полоска) | D7 исток |
| 9 | D2 гнездо, внешний контакт | **GND** |
| 10 | D9 P6KE16A, **катод** (полоска) | **+12V** |
| 11 | D9 P6KE16A, **анод** | **GND** |
| 12 | E5 470 мкФ/25 В, «+» | **+12V** |
| 13 | E5 470 мкФ/25 В, «−» | **GND** — полярность электролитов не перепутать |
| 14 | E8 0,1 мкФ | параллельно E5 |

## 2. Преобразователь и цепь +5V

| № | Откуда | Куда |
|---|---|---|
| 15 | **+12V** | D6 преобразователь, IN+ |
| 16 | **GND** | D6 преобразователь, IN− |
| 17 | D6 преобразователь, OUT+ | цепь **+5V** |
| 18 | — | *(дроссель D11 перенесён в ветвь LDO, строки 26–27)* |
| 19 | D6 преобразователь, OUT− | **GND** |
| 20 | E6 470 мкФ/16 В, «+» | **+5V** |
| 21 | E6 470 мкФ/16 В, «−» | **GND** |
| 22 | E8 0,1 мкФ | параллельно E6 |

## 3. Питание Raspberry Pi

| № | Откуда | Куда |
|---|---|---|
| 23 | **+5V** | кабель micro-USB (дозаказ), красный провод (VBUS) |
| 24 | **GND** | кабель micro-USB (дозаказ), чёрный провод (GND) |
| 25 | разъём micro-USB | A1 Pi, гнездо питания |

## 4. Цепь +3V3 для тюнера

| № | Откуда | Куда |
|---|---|---|
| 26 | **+5V** | D11 дроссель 10 мкГн, вывод 1 |
| 27 | D11 дроссель, вывод 2 | F2 ферритовая бусина №1, вывод 1 |
| 27а | F2 бусина №1, вывод 2 | D10 HT7333-A, **VIN** |
| 28 | D10 HT7333-A, **GND** | **GND** |
| 29 | D10 HT7333-A, **VOUT** | F2 ферритовая бусина №2, вывод 1 |
| 30 | F2 бусина №2, вывод 2 | цепь **+3V3** |
| 31 | E7 10 мкФ №1, «+» / «−» | D10 VIN / **GND** |
| 32 | E7 10 мкФ №2, «+» / «−» | **+3V3** / **GND** |
| 33 | E8 0,1 мкФ | параллельно каждому E7 (2 шт.) |

## 5. Тюнер RDA5807M (B1)

| № | Откуда | Куда |
|---|---|---|
| 34 | **+3V3** | B1, вывод VCC |
| 35 | **GND** | B1, вывод GND |
| 36 | A1 Pi, **контакт 3** (GPIO2 / SDA) | B1, вывод SDIO (SDA) |
| 37 | A1 Pi, **контакт 5** (GPIO3 / SCL) | B1, вывод SCLK (SCL) |
| 38 | B1, вывод ANT | B3 RG-174, центральная жила |
| 39 | B3 RG-174, оплётка | B1, вывод GND |
| 40 | B3 RG-174, центральная жила (второй конец) | B2 антенна телескопическая |

## 6. ЦАП PCM5102A (C1)

| № | Откуда | Куда |
|---|---|---|
| 41 | **+5V** | C1, вывод VCC |
| 42 | **GND** | C1, вывод GND |
| 43 | A1 Pi, **контакт 12** (GPIO18) | C1, вывод BCK |
| 44 | A1 Pi, **контакт 35** (GPIO19) | C1, вывод LCK (LRCK) |
| 45 | A1 Pi, **контакт 40** (GPIO21) | C1, вывод DIN |
| 46 | C1, вывод **SCK** | **GND** — обязательно, иначе тишины |
| 47 | C1, площадка FLT | **GND** |
| 48 | C1, площадка DEMP | **GND** |
| 49 | C1, площадка FMT | **GND** |
| 50 | C1, площадка **XSMT** | **3,3 В платы C1** |

## 7. Сумматор звука

| № | Откуда | Куда |
|---|---|---|
| 51 | B1, вывод LOUT | R1k №1, вывод 1 |
| 52 | R1k №1, вывод 2 | цепь **SUM** |
| 53 | B1, вывод ROUT | R1k №2, вывод 1 |
| 54 | R1k №2, вывод 2 | цепь **SUM** |
| 55 | C1, выход L | E1 10 кОм №1, вывод 1 |
| 56 | E1 10 кОм №1, вывод 2 | цепь **SUM** |
| 57 | C1, выход R | E1 10 кОм №2, вывод 1 |
| 58 | E1 10 кОм №2, вывод 2 | цепь **SUM** |
| 59 | E2 100 кОм, вывод 1 | цепь **SUM** |
| 60 | E2 100 кОм, вывод 2 | **GND** |
| 61 | цепь **SUM** | C4 подстроечник, крайний вывод 1 |
| 62 | C4 подстроечник, крайний вывод 3 | **GND** |
| 63 | C4 подстроечник, средний вывод (движок) | E3 **3,3 мкФ**, вывод 1 |
| 64 | E3 3,3 мкФ, вывод 2 | C2, вход рабочего канала (IN) |

## 8. Усилитель TPA3118D2 (C2) и динамик

| № | Откуда | Куда |
|---|---|---|
| 65 | **+12V** | C2, вывод VCC (12 V) |
| 66 | **GND** | C2, вывод GND |
| 67 | E4 1000 мкФ/25 В, «+» / «−» | C2 VCC / **GND** |
| 68 | E8 0,1 мкФ | параллельно E4 |
| 69 | C2, вход неиспользуемого канала | **GND** |
| 70 | C2, выход рабочего канала «+» | H6 клеммник, контакт 1 |
| 71 | C2, выход рабочего канала «−» | H6 клеммник, контакт 2 |
| 72 | H6 клеммник, контакт 1 | C3 динамик, «+» |
| 73 | H6 клеммник, контакт 2 | C3 динамик, «−» |
| 74 | A1 Pi, **контакт 23** (GPIO11) | R1k №3, вывод 1 |
| 74а | R1k №3, вывод 2 | C2, вывод SD (SHDN) |
| 75 | E2 100 кОм, вывод 1 | C2, вывод SD |
| 76 | E2 100 кОм, вывод 2 | **GND** |
| 77 | R20k, вывод 1 / вывод 2 | C2 вывод GAIN/SLV / **GND** |
| 78 | R100k+, вывод 1 / вывод 2 | C2 вывод GAIN/SLV / GVDD платы C2 |

Строки 77–78: делитель усиления **уже стоит на плате** — эти два резистора
**заменяют** заводские, а не добавляются к ним. Нужное усиление — 26 дБ.

## 9. Кнопки и энкодеры

Второй вывод каждой кнопки — на **GND**. Внешние подтяжки не нужны.

| № | Откуда | Куда |
|---|---|---|
| 79 | G3 кнопка MENU, вывод 1 | A1 Pi, **контакт 7** (GPIO4) |
| 80 | G3 кнопка MEM, вывод 1 | A1 Pi, **контакт 13** (GPIO27) |
| 81 | G3 кнопка ◄, вывод 1 | A1 Pi, **контакт 15** (GPIO22) |
| 82 | G3 кнопка ►, вывод 1 | A1 Pi, **контакт 16** (GPIO23) |
| 83 | G3 кнопка SEEK, вывод 1 | A1 Pi, **контакт 18** (GPIO24) |
| 84 | G5 кнопка питания, вывод 1 | A1 Pi, **контакт 11** (GPIO17) |
| 85 | G1 энкодер 1, вывод A | A1 Pi, **контакт 29** (GPIO5) |
| 86 | G1 энкодер 1, вывод B | A1 Pi, **контакт 31** (GPIO6) |
| 87 | G1 энкодер 1, средний вывод (C) | **GND** |
| 88 | G1 энкодер 1, кнопка, вывод 1 | A1 Pi, **контакт 22** (GPIO25) |
| 89 | G1 энкодер 2, вывод A | A1 Pi, **контакт 26** (GPIO7) |
| 90 | G1 энкодер 2, вывод B | A1 Pi, **контакт 24** (GPIO8) |
| 91 | G1 энкодер 2, средний вывод (C) | **GND** |
| 92 | G1 энкодер 2, кнопка, вывод 1 | A1 Pi, **контакт 32** (GPIO12) |
| 93 | G6 кнопка MODE, вывод 1 | A1 Pi, **контакт 21** (GPIO9) |
| 94 | G6 кнопка MODE, вывод 2 | **GND** |
| 95 | все вторые выводы кнопок (79–84, 88, 92) | **GND** |

## 10. Дисплей (A3)

| № | Откуда | Куда |
|---|---|---|
| 96 | A3 шлейф FFC | A1 Pi, разъём DSI |
| 97 | **+5V** | A3, вход питания (отдельный кабель питания панели) |
| 98 | **GND** | A3, земля питания — вместе со строкой 97 |

Ревизию панели и способ её питания сверить с вики Waveshare при получении:
у старых ревизий сенсор выведен на I2C1 (GPIO2/3), см. [15](15-wiring-breadboard.md), п. 9.

## 11. Что сходится в точке GND-звезды

Внешний контакт D2 · вход и выход D6 · GND C2 · GND A1 (через micro-USB) ·
GND B1 вместе с оплёткой антенны · GND C1 · земляная шина макетки ·
нижний вывод C4 · вторые выводы всех кнопок и средние выводы энкодеров.

## 12. Не подключается на этом этапе

| Что | Почему |
|---|---|
| A1 Pi, контакт 37 (GPIO26) | сигнал `gpio-poweroff` для фиксирующего ключа; сам ключ ещё не разведён, [10](10-shutdown-and-data-safety.md), п. 4 |
| C2, второй канал усилителя | резерв под стерео |
| E9 резистор 5,6 кОм | остался от варианта с усилением 20 дБ |
