Spok1978/hybrid-radio/docs/21-board-search-criteria.md

# 21. Задание на поиск плат ESP32 с экраном

Чек-лист для отбора. Сначала отсекающие требования, затем балльная оценка.

## Отсекающие требования

Не выполняется хотя бы одно — плата не рассматривается.

| № | Требование | Почему |
|---|---|---|
| 1 | **PSRAM не менее 4 МБ** | буфер потока и рабочая память декодера; MiniWebRadio требует именно столько |
| 2 | **Wi-Fi** — свой или через сопроцессор | режим интернет-радио |
| 3 | **Цветной экран с подсветкой** | R3 |
| 4 | **Шина I²C, выведенная наружу** | тюнер RDA5807M управляется только по I²C |
| 5 | **Есть в продаже** | плата Waveshare на P4 отсутствовала на складе при проверке |

## Балльная оценка, всего 100

| Функция | Вес | Почему столько |
|---|---|---|
| **Кодек с аналоговым входом** (ES8311 или аналог, АЦП на входе) | **20** | выход тюнера заводится внутрь, микширование программное. Убирает целый узел: сумматор, аналоговый ключ, смещение |
| **Дисплей из списка, поддерживаемого MiniWebRadio** | **18** | SPI ILI9341, ILI9486, ILI9488, ST7796; RGB 800×480; DSI 1024×600. Иначе дисплейный порт писать самим |
| **Свободных GPIO не менее 8 на гребёнке 2,54 мм** | **16** | требование **R4.1**: энкодер и кнопки обязательны, прибор рассчитан в том числе на пожилых пользователей |
| **Диагональ 5–7″** | **12** | требование R3. Заказчик считает меньший экран допустимым, поэтому не отсекающее |
| **Слот microSD** | **10** | файл списка станций |
| **Разрешение не менее 800×480** | **8** | список станций плюс крупная частота на одном экране |
| **Wi-Fi на том же кристалле**, без сопроцессора | **8** | у связки P4 + C6 есть сообщения о нестабильности |
| **Ёмкостный тач** | **5** | второй способ управления по R4.1 и ввод пароля Wi-Fi |
| **Цена до 60 долларов** | **3** | |

### Две правки от 2026-08-21

**Критерий «поддержка Arduino» убран.** Он мерил не то: MiniWebRadio —
проект **ESP-IDF**, в репозитории лежат `CMakeLists.txt`, `sdkconfig.esp32s3`,
`sdkconfig.esp32p4` и определение платы `ESP32-P4-DevKitC-NRW32.json`.
Отсутствие Arduino ничего не усложняет.

**Вес свободных GPIO поднят с 10 до 16.** Причина — требование R4.1.
Сама прошивка физических органов не требует («no additional components such
as switches, rotary encoders… are required»), но **нам они нужны**, и
добавление модуля ввода — наша работа. Значит выводы должны быть, и лучше
на нормальной гребёнке 2,54 мм, а не на фирменных разъёмчиках.

## Что нам не нужно и баллов не даёт

Камера, датчик положения, микрофоны, Ethernet, RS485, реле, аккумулятор
с зарядкой, часы реального времени (есть свой DS3231), усилитель и динамик
на борту (есть свой TPA3118 на 10–15 Вт против типовых 3 Вт).

Эти позиции часто занимают половину описания платы и создают впечатление
богатой комплектации — на нашу задачу они не работают.

## Оценка уже рассмотренных плат

Пересчитано после правок от 2026-08-21.

| Плата | Баллы | Что теряет |
|---|---|---|
| **Espressif ESP32-P4-Function-EV-Board** | **92** | Wi-Fi через сопроцессор, форм-фактор отладочной платы |
| **Waveshare ESP32-P4-WIFI6-Touch-LCD-5** | **74** | дисплей 720×1280 не из списка, Wi-Fi через сопроцессор |
| Sunton ESP32-8048S050C, 5″ | 64 | нет аналогового входа у MAX98357A, гребёнки 2,54 нет — уточнять |
| Waveshare ESP32-S3-Touch-LCD-4.3B | 52 | **звука на плате нет вовсе**, свободных GPIO нет |
| Waveshare ESP32-P4-WIFI6-Touch-LCD-4B | 50 | дисплей не из списка, 4″, **нет в продаже** |
| Espressif ESP32-S3-BOX-3 | 34 | дисплей не из списка, 2,4″, нет карты, GPIO через Pmod |
| Waveshare ESP32-S3-Touch-LCD-2.8 | 26 | нет аналогового входа, дисплей не из списка, 2,8″, мало GPIO |
| M5Stack CoreS3 | 24 | нет аналогового входа, 2,0″, дисплей не из списка |
| Seeed SenseCAP Indicator D1 | 20 | нет аналогового входа, дисплей не из списка, два Grove |
| LILYGO T-Display-S3 | 11 | нет звука, нет тача, 1,9″, нет карты |

Обе платы на P4 вышли вперёд именно из-за R4.1: у них **40-контактная
гребёнка 2,54 мм**.
Это единственные две платы в списке, куда энкодер и кнопки подключаются
без расширителя портов.

## Минусы трёх лучших

**Espressif ESP32-P4-Function-EV-Board, 92 балла.** В комплекте за 55 долларов
идут плата, экран 7″ 1024×600 с ёмкостным тачем, камера 2 Мп и кабели.
На борту ES8311 с усилителем 3 Вт, микрофон, разъём динамика, слот microSD,
16 МБ флеш, Ethernet, два USB и **40-контактная гребёнка J1**.

- Wi-Fi не на кристалле, а через модуль ESP32-C6-MINI-1; у этой связки есть
  сообщения о нестабильности;
- разработка практически только в ESP-IDF, поддержка Arduino для P4 сырая —
  в обсуждениях у людей не заводится тот самый ES8311;
- это **отладочная плата, а не изделие**: камера, Ethernet, два USB и
  отладочный мост занимают место и нам не нужны;
- экран — отдельная панель на шлейфе, «моноблока» нет, крепление в корпус
  придётся придумывать;
- встроенный усилитель 3 Вт против наших 10–15 Вт.

**Waveshare ESP32-P4-WIFI6-Touch-LCD-4B, 50 баллов.**

- **нет в продаже** на момент проверки — отсекающее требование не выполнено;
- дисплей 720×720 не из списка MiniWebRadio, дисплейный порт писать самим;
- 4″, требование R3 не выполняется;
- форм-фактор настенной панели 86×86 мм под монтажную коробку;
- Wi-Fi через сопроцессор, только ESP-IDF.

**Espressif ESP32-S3-BOX-3, 34 балла.**

- экран 2,4″ 320×240 — мало под список станций;
- **нет слота карты**, список станций пришлось бы держать во флеш-памяти,
  а MiniWebRadio ожидает карту;
- дисплей ILI9342C не из списка прошивки;
- 16 GPIO выведены через разъёмы Pmod, а не гребёнки 2,54 мм — на макетке
  неудобно;
- закрытый корпус голосового ассистента: выводить наружу тюнер и антенну
  неудобно.

## Sunton ESP32-8048S050C, 5″ — 64 балла

Проверено 2026-08-21. Семейство Sunton: одинаковые платы на ESP32-S3,
**8 МБ PSRAM, 16 МБ флеш, экран 800×480 IPS RGB с ёмкостным тачем**,
в трёх размерах — 4,3″, 5″ и 7″.

**Усилитель MAX98357A стоит на версиях 5″ и 7″, на 4,3″ его нет.**

Почему 5″ лучше рассмотренных Waveshare:

- **дисплей RGB 800×480 с тачем по I²C** — из списка MiniWebRadio, порт писать не надо;
- **5 дюймов — требование R3 выполняется**;
- звук на плате есть, значит выводы I²S разведены и к ним можно подключить
  наш ЦАП с усилителем, если 3,2 Вт комплектного мало;
- цена заметно ниже комплекта на P4.

Минусы: у MAX98357A **аналогового входа нет** — он только ЦАП с усилителем,
поэтому эфирный тракт остаётся с нашим сумматором, как и спроектировано;
сколько GPIO реально выведено, надо проверять по конкретной ревизии.

## Waveshare ESP32-S3-Touch-LCD-4.3B, 52 балла

Проверено по вики Waveshare (SKU 27848, есть версия в корпусе — 28141).

**Что даёт баллы:** ESP32-S3-WROOM-1-N16R8 с **8 МБ PSRAM** и 16 МБ флеш;
экран **4,3″ 800×480 RGB IPS с ёмкостным тачем по I²C** — это в точности
то сочетание, которое MiniWebRadio поддерживает; слот TF-карты; Wi-Fi
на кристалле; Arduino и ESP-IDF оба поддержаны.

**Два плюса сверх таблицы:**

- **питание 7–36 В постоянного тока** помимо Type-C. Наш блок 12 В
  подключается напрямую, понижающий преобразователь для платы не нужен —
  из силового узла уходит целая позиция;
- **часы PCF85063 на борту** — DS3231 не понадобится.

**Главный риск, который надо снять до покупки: свободен ли I²S.**
Звука на плате нет вообще — ни кодека, ни усилителя, ни разъёма динамика.
Значит наш ЦАП PCM5102A с усилителем остаются как есть, но для них нужны
три вывода I²S. А выводов на плате в обрез: параллельный RGB на 800×480
съедает около двадцати линий, плюс тач, карта, CAN, RS485 и опто-развязанные
входы-выходы. Косвенный признак нехватки — **на плате стоит расширитель
портов по I²C**, его ставят именно тогда, когда выводы кончились.

Проверять по схеме платы, которую Waveshare выкладывает в вики. Если I²S
свободного нет — плата для нас непригодна независимо от остальных баллов.

**Прочие минусы:** 4,3″ вместо 5–7″ по R3; CAN, RS485 и промышленные
опто-входы нам не нужны, но занимают выводы; свободных линий под энкодеры
и кнопки, скорее всего, нет — управление уйдёт на тач и на шину I²C.

## Что спрашивать в описании платы

1. Объём PSRAM цифрой, а не «стековая память».
2. Точное название микросхемы кодека и есть ли у неё **вход** АЦП.
3. Контроллер дисплея и разрешение — именно контроллер, а не «IPS 2,8″».
4. Сколько GPIO выведено на разъёмы и какие из них не заняты внутри платы.
5. Есть ли слот карты и по какому интерфейсу.
6. Wi-Fi на том же кристалле или через сопроцессор.
7. Заявлена ли поддержка Arduino или только ESP-IDF.
