Spok1978/hybrid-radio/docs/33-carrier-board.md

# 33. Плата-носитель модулей

Решение заказчика от 2026-10-01: отдельная плата, на которой стоят все
вспомогательные модули — FM-тюнер, ЦАП, усилитель, микшер, расширитель
кнопок, питание. Плата ESP32-P4, динамики, кнопки, энкодеры, питание
и антенна подключаются к ней проводами.

Проект KiCad — `hardware/kicad/Hybryd Radio.kicad_pro`.

## 1. Исходные решения

| Что | Решение | Откуда |
|---|---|---|
| Звук | стерео: PCM5102A → микшер → оба канала TPA3118D2 → два динамика | заказчик, 2026-10-01 |
| Кнопки | вариант 1 из [30](30-pin-assignment.md): 8 пресетов + MODE на MCP23017 | заказчик, 2026-10-01 |
| Питание | один вход 12 В; усилитель от 12 В, плата P4 через DC-DC 12→5,0 В | заказчик, 2026-10-01 |
| Модули | купленные модули на гребёнках, не микросхемы | заказчик, 2026-10-01 |
| Монтаж | ручная пайка, только выводные детали, по возможности без SMD | заказчик, 2026-10-01 |
| Разъёмы | JST XH 2,5 мм для сигналов, винтовые клеммы для силовых цепей | заказчик, 2026-10-01 |
| Габарит | под плату P4: тот же контур и крепёж, «бутерброд» за экраном | заказчик, 2026-10-01 |

## 2. Гребёнка J3 платы P4 — сверено

Открытый пункт из [30](30-pin-assignment.md) («привязка цепь → номер
контакта двоилась») закрыт. Три независимых источника совпадают
во всех сорока контактах:

- таблица 40PIN на странице `docs.waveshare.com/ESP32-P4-WIFI6-Touch-LCD-5`;
- фото шелкографии с той же страницы;
- символ J3 на листе 1 схемы `ref/ESP32-P4-WIFI6-Touch-LCD-5-Schematic.pdf`;
- **подписи на живом экземпляре**, прочитанные заказчиком 2026-10-01
  (верхняя строка — чётные контакты, нижняя — нечётные, счёт от края
  с разъёмом RTC).

| Конт. | Сигнал | Наше назначение | | Конт. | Сигнал | Наше назначение |
|---|---|---|---|---|---|---|
| 1 | VCC_5V | **не подключать** (§3) | | 2 | ESP_3V3 | питание MCP23017 |
| 3 | VCC_5V | **не подключать** (§3) | | 4 | GPIO7 SDA | I²C SDA |
| 5 | GND | GND | | 6 | GPIO8 SCL | I²C SCL |
| 7 | GPIO37 | занят платой (UART) | | 8 | GPIO2 | не подключать |
| 9 | GPIO38 | занят платой (UART) | | 10 | GND | GND |
| 11 | GPIO5 | резерв | | 12 | GPIO3 | кнопка питания |
| 13 | GND | GND | | 14 | GPIO4 | резерв |
| 15 | GPIO21 | энкодер 1 A | | 16 | GPIO28 | энкодер 1 кнопка |
| 17 | GPIO22 | энкодер 1 B | | 18 | ESP_3V3 | питание MCP23017 |
| 19 | GND | GND | | 20 | GPIO29 | энкодер 2 A |
| 21 | GPIO24 (USB1P1_N) | не подключать | | 22 | GPIO30 | энкодер 2 B |
| 23 | GPIO25 (USB1P1_P) | не подключать | | 24 | GPIO31 | энкодер 2 кнопка |
| 25 | USBD_N | не подключать | | 26 | GND | GND |
| 27 | USBD_P | не подключать | | 28 | GPIO34 | резерв (strapping) |
| 29 | GND | GND | | 30 | GPIO35 | занят платой (автосброс) |
| 31 | GPIO32 | прерывание MCP23017 | | 32 | GPIO49 | приглушение TPA3118 (SD) |
| 33 | GND | GND | | 34 | GPIO50 | **признак 12 В** (§5, предложение) |
| 35 | GPIO46 | I²S BCK | | 36 | GPIO51 | резерв |
| 37 | GPIO47 | I²S LRCK | | 38 | GPIO52 | резерв |
| 39 | GPIO48 | I²S DIN | | 40 | GND | GND |

Соединение — **плоский шлейф 2×20 IDC**: на плате P4 штыри, на нашей
плате угловая или прямая вилка 2×20 в кожухе с ключом. Нумерация
контактов на обоих концах совпадает, перепутать провода нельзя.

## 3. Питание платы P4: через USB-C, а не через гребёнку

По листу 1 схемы Waveshare:

- контакты 1 и 3 гребёнки — шина `VCC_5V`, с TVS SMF5.0CA на землю;
- `USB0_5V` (разъём H1) и `USB1_5V` (H2) идут через идеальные диоды
  Q2/Q3 (AO3401 + MMDT3906) на `VCC'_5V`, оттуда через Q4 на `VCC_5V`;
- **зарядник батареи ETA6098 (U19) питается от `VCC'_5V`**, то есть
  только со стороны USB;
- батарея через повышающий SCT12A0 (U17) и диод Q7 тоже выходит на `VCC_5V`.

Следствие: 5 В, поданные на гребёнку, плату запитают, но **батарею
заряжать не будут** — `VCC'_5V` от гребёнки отделён диодом Q4. А батарея
в изделии нужна для сохранности данных ([24](24-main-build-p4.md), Q14).

**Поэтому 5,0 В с нашего DC-DC отдаются в разъём USB-A на плате, а оттуда
коротким кабелем USB-A → USB-C в порт H2 платы P4.** Контакты 1 и 3
шлейфа на нашей плате ни к чему не подключаются.

Не проверено на железе: что идеальные диоды действительно не пускают
ток обратно и что ETA6098 нормально заряжает от 5,0 В. Проверяется
амперметром в разрыве кабеля при первом включении.

## 4. Блоки платы

| Блок | Состав | Источник номиналов |
|---|---|---|
| Вход 12 В | клеммник, предохранитель **T5A** (было 3 А, изменено 2026-10-02, §10), защита от переполюсовки на IRF4905 (затвор: 100 кОм + стабилитрон 15 В), TVS P6KE16A, 470 мкФ/25 В + 100 нФ | [09](09-power-supply.md), [16](16-connection-list.md), прошли три внешних разбора |
| 5,0 В | модуль WeAct SY8205 (синхронный, 5 А) → 470 мкФ/16 В + 100 нФ → USB-A | [11](11-shopping-list.md), D6 |
| 3,3 В тюнера | LDO HT7333-A от 5,0 В через ферритовые бусины, 10 мкФ + 100 нФ с обеих сторон | [16](16-connection-list.md) |
| Тюнер | RRD-102V2.0; разделительные 4,7 мкФ на LOUT/ROUT (выходы на постоянке ~1,05 В); антенна на клеммник через 100 пФ (§11) | [02](02-fm-frontend.md) |
| ЦАП | GY-PCM5102A, I²S с шлейфа | [04](04-audio-path.md) |
| Микшер | на каждый канал: тюнер через 1 кОм, ЦАП через 10 кОм, узел 100 кОм на землю, подстроечник 10 кОм 3296W, плёночный 3,3 мкФ на вход усилителя | [04](04-audio-path.md), [17](17-audit-response-wiring.md): при 26 дБ вход TPA3118 30 кОм, даташит рекомендует 3,3 мкФ |
| Усилитель | два модуля HW-327 (моно), 12 В, у каждого 1000 мкФ/25 В + 100 нФ; линия отключения через 1 кОм с GPIO49, 100 кОм вниз или вверх — по прозвонке (§11) | [04](04-audio-path.md), [30](30-pin-assignment.md) |
| Расширитель | MCP23017, адрес 0x20, питание от ESP_3V3 со шлейфа, 100 нФ. Пресеты 1–7 на GPA0–6, пресет 8 на **GPB1**, MODE на GPB0; GPA7/GPB7 не подключены (§10) | [30](30-pin-assignment.md) |
| Кнопки и энкодеры | органы стоят на корпусе, провода **паяются в плату**: отверстия под провод 0,25 мм², шаг 4,2 мм (`Connector_Wire:SolderWire-0.25sqmm`). J9/J10 — энкодеры (A, C, B, кнопка, кнопка), J11 — кнопка питания, J7 — пресеты 1–4 + GND, J12 — пресеты 5–8, MODE + GND (серия в KiCad до 6 контактов). J8 «резерв» остался на JST XH. Решение 2026-10-07 | [30](30-pin-assignment.md) |

Схема микшера — на каждый канал свой экземпляр (стерео), без сведения
в моно. Номиналы 1 к / 10 к выведены для
PCM5102A (2,1 В) и тюнера. **[исправлено 2026-10-05]** Уровень тюнера в
даташите есть: 360 мВ типовой при девиации 22,5 кГц (§11). Как он
соотносится с уровнем ЦАП на реальном вещании — проверяется замером;
подстроечники и регистр громкости тюнера на этот случай.

## 5. Что добавлено сверх прежних решений

- **Признак внешнего питания.** Делитель 39 кОм / 12 кОм от шины 12 В
  на GPIO50 с конденсатором 100 нФ. При 12 В на выводе 2,82 В,
  при 11 В — 2,59 В. Порог логической единицы ESP32-P4 — 0,75 × VDD
  = 2,48 В, предел — VDD + 0,3 = 3,6 В (даташит ESP32-P4 v0.7, с. 89),
  3,6 В достигается при 15,3 В на входе. Это закрывает открытый пункт
  «обнаружение пропадания питания» ([26](26-firmware-spec.md), §9):
  прошивка видит, что 12 В пропали, а сама живёт от батареи.
  **Предложение, нужна поддержка в прошивке.**
- **MCP23017 питается от ESP_3V3**, а не от своего LDO:
  тогда расширитель включается и выключается вместе с P4 и не может
  подпитать P4 через линию прерывания, когда она выключена.
- **Места под резисторы 47 Ом в I²S** у входа PCM5102A. По умолчанию
  впаять перемычки; резисторы — если на осциллографе виден звон.
  **[исправлено 2026-10-05]** Прежний довод «ограничивают ток через
  защитные диоды ЦАП» таблицей PCM5102A не подтверждается: предел
  цифрового входа там абсолютный, −0,3…3,9 В (с. 6).

## 6. Купленные модули — по фото продавцов (2026-10-01)

| Модуль | Выводы | Замечания |
|---|---|---|
| RRD-102 V2.0 | 10 полуотверстий, шаг 2,0 мм, ряды через 11,0 мм. 1 SDA, 2 SCL, 3 NC, 4 NC, 5 VCC, 6 GND, 7 L-OUT, 8 R-OUT, 9 NC, 10 ANT (3 и 9 в библиотеке JLCEDA — GND, но на модуле заказчика на землю не звонятся, прозвонка 2026-10-18; ANT–GND — обрыв) | распиновка и площадки — из официальной библиотеки JLCEDA/EasyEDA (LCSC C9900205627). Ставится на SMD-площадки 2×1,2 мм — единственная «SMD-пайка» на плате |
| GY-PCM5102A (TZT) | ряд 6: VIN, GND, LCK, DIN, BCK, SCK; ряд 9: L, G, R, G, A3V3, FMT, XSMT, DEMP, FLT | подписи 5–9 сняты с обратной стороны (зеркально лицевым «4 3 2 1»), сверить на модуле |
| TPA3118 (HW-327) | POWER +/−, OUT +/−, INPUT +/−, MUTE — по 2 площадки | **один выход и один вход — моно (PBTL).** Для стерео нужны два модуля |
| ~~XL4015 5A~~ | IN+, IN−, OUT+, OUT− по углам | несинхронный, с диодом SS54 — тот тип, от которого [11](11-shopping-list.md) отказался из-за помех в полосе FM. **Не ставим** |
| **WeAct SY8205, 5 В / 5 А** (ставим) | IN+, IN−, OUT+, OUT− — по две площадки на вывод; площадка EN; перемычки 3,3 / 9 / 12 В на обороте, по умолчанию 5 В | вход 7–30 В. Синхронный, как требует [11](11-shopping-list.md) |
| TPA3118D2 стерео с Bluetooth («Digital audio amplification board») | гнездо питания с надписью DC24V, клеммы OUTL, OUTR, гнездо 3,5 мм, потенциометр B50K | в проект не берём: свой Bluetooth-приёмник и регулятор громкости в тракте, отдельного входа и линии приглушения по фото не видно |
| MCP23017 (CJMCU) | ряд 10: A2, A1, A0, RESET, NC/SO, NC/CS, SDA, SCL, GND, VCC; двойной ряд 2×10: VCC/GND, INTB/INTA, B0/A0 … B7/A7 | A0–A2 на землю (адрес 0x20), RESET (активный низкий) на VCC. Есть ли подтяжки на самом модуле, по фото не видно — на нашей плате задаём явно |
| EC11 | A, C, B (шаг 2,5 мм) + кнопка D, E | ставятся на панель, к плате — проводом через JST XH 5 |

## 7. Схема: как она собирается и проверяется

Источник истины — `hardware/skidl/carrier.py` (SKiDL). Схему в KiCad
руками не править: правка в коде, затем пересборка.

```
.venv/Scripts/python hardware/skidl/make_symbols.py    # символы модулей
.venv/Scripts/python hardware/skidl/carrier.py         # ERC SKiDL + нетлист
.venv/Scripts/python hardware/skidl/check_carrier.py   # сверка с прошивкой и с J3
.venv/Scripts/python hardware/skidl/make_schematic.py  # Hybryd Radio.kicad_sch
kicad-cli sch export netlist --format kicadxml -o sch.xml "hardware/kicad/Hybryd Radio.kicad_sch"
.venv/Scripts/python hardware/skidl/compare_netlists.py sch.xml
```

- `check_carrier.py` сводит три источника: макросы `board_pins.h`,
  таблицу 40PIN Waveshare и нетлист. Проверка на поломку проводилась:
  вывод BCK, перенесённый с контакта 35 на 33, она ловит.
- `compare_netlists.py` сравнивает, какие выводы соединены в нетлисте
  SKiDL и в схеме, которую прочитал сам KiCad.
- Встроенный в SKiDL генератор схемы (`generate_schematic`, версия 2.3.0)
  **не используется**: он клал детали друг на друга, и в схеме
  замыкались GND с выходами тюнера и ЦАП, вход LDO с выходом — поймано
  `compare_netlists.py`. Своя раскладка в `make_schematic.py`: каждая
  деталь в отдельной клетке, соединения только метками, проводов нет.
- Состояние на 2026-10-05 (после §11): 86 деталей, 66 цепей. ERC SKiDL — 0 ошибок и 0 предупреждений;
  ERC KiCad — 6 предупреждений «нет посадочного места hybrid-radio:…»
  (ждут замеров модулей); сверка с прошивкой и J3 — сошлось; схема
  против нетлиста — 66 цепей из 66, расхождений 0.

## 8. Что сверить на модулях до разводки

| Модуль | Что проверить | Чем |
|---|---|---|
| HW-327 | на какой вывод TPA3118 идёт площадка MUTE: 2 (SDZ, LOW — выкл.) или 12 (MUTE, HIGH — выкл.); вторая площадка — земля? | прозвонка до выводов микросхемы |
| HW-327 | есть ли на модуле свои разделительные конденсаторы на входе | осмотр от площадок INPUT к микросхеме |
| HW-327 | какое усиление выставлено делителем GAIN; микшер рассчитан на 26 дБ ([04](04-audio-path.md)) | номиналы резисторов у вывода GAIN |
| GY-PCM5102A | перемычки H1–H4 на обороте разомкнуты. Прозвонено заказчиком 2026-10-18: H1L — FLT, H2L — DEMP, H3L — XSMT, H4L — FMT (средняя площадка — вывод, крайние — H = 3,3 В и L = земля). Либо задавать выводы проводами (так в схеме), либо перемычками: H1L, H2L, H4L на L, H3L на H; одновременно провода и перемычки нельзя — замыкание 3,3 В на землю | осмотр; соответствие — **проверено** |
| MCP23017 | какой столбец двойного ряда — GPA, какой — GPB | подписи на модуле |
| WeAct SY8205 | включён ли модуль при неподключённом EN | подать 12 В, измерить выход |

## 9. Чего не хватает для разводки

Посадочные места модулей. У клонов с одинаковым названием расстояния
и порядок выводов разные ([30](30-pin-assignment.md), примечание в шапке
`netlist/ip-radio.yaml`), брать их из чужих библиотек нельзя. Нужно
по каждому купленному модулю: фото с обеих сторон, габарит, расположение
и шаг выводов, подписи.

Размеры платы P4 на чертеже со страницы Waveshare: 118,50 мм
по горизонтали и 64,50 мм по вертикали, отверстия в 3,25 и 3,75 мм
от края. К чему именно привязаны выносные линии — к краю платы или
к центрам отверстий — по картинке однозначно не читается. Сверить
штангенциркулем на живой плате перед выводом контура.

## 10. Внешние разборы схемы (2026-10-02) и что из них внесено

Четыре разбора разными нейросетями проверены по нетлисту, документам
проекта и даташитам производителей. Разбор №3 описывал другую плату
(SMAJ15A, QM9005, MP2315, AMS1117, TDA2822M, плата LCD-7B) — из него
верен один пункт, но важный.

**Внесено в схему:**

| Изменение | Основание |
|---|---|
| Пресет 8 перенесён с GPA7 на **GPB1**; GPA7/GPB7 не подключены | Microchip DS20001952E, с. 1 и таблица выводов на с. 11: «GPA7, GPB7 are output only for MCP23017». Входом использовать нельзя — по описанию производителя искажается SDA. В ревизии C даташита этого не было |
| F1 3 А → **T5A**, БП **12 В / 5 А** (решение заказчика) | Предел мостового выхода при 12 В на 4 Ом: U²/(2R) = 144/8 = 18 Вт на канал; 2 канала при КПД ~0,9 — ~40 Вт, ~3,3 А, плюс P4 |
| Светодиоды +12 В (2,2 кОм, 4,5 мА) и +5 В (1 кОм, 3 мА) | разборы №2, №4 |
| Контрольные точки +12V, +5V, +3V3_FM, PWR_SENSE, SUM_L, SUM_R, GND × 2 | разбор №2 |
| Надписи на схеме: GAIN 26 дБ у A1/A2, перемычки H1L–H4L у U4, подбор R14, GPA7/GPB7 | разбор №4: требования были только в документах |

**Отклонено:**

| Утверждение | Почему |
|---|---|
| «TVS стоит до предохранителя» (№1) | D2 на +12V, после F1 и Q1 |
| «Добавить ёмкость после Q1» (№2) | C1 470 мкФ уже на +12V |
| LC 10 мкГн + 0,68 мкФ на выход усилителя (№2) | на HW-327 уже есть выходные дроссели «100»; второй фильтр подряд не просчитан |
| Подтяжки I²C 4,7–10 кОм (№2, №3) | на плате P4 уже 2,2 кОм (схема и вики Waveshare) |
| Микшер 1,5 кОм / 12 кОм (№2) | не обосновано измерением; номиналы — после замера уровня тюнера |
| Нижнее плечо PWR_SENSE 12k → 10k (№4) | при 12 В дало бы 2,45 В — ниже порога 0,75 × VDD = 2,48 В (даташит ESP32-P4 v0.7, с. 89), цифровой признак перестал бы работать |
| Убрать PCM5102A в пользу ES8311 (№3) | ES8311 моно (даташит Everest), выбрано стерео |
| Перенести I²C на другие выводы (№3) | адреса не пересекаются: 0x10/0x11, 0x20 против 0x5D/0x14, 0x18, 0x40 |

**Осталось открытым:** подтяжка линии отключения — по прозвонке MUTE на HW-327 (§11); прошивка — включить
расширитель, GPPU у MCP23017 (по умолчанию выключены), чтение PWR_SENSE
(GPIO50 = ADC2_CH1, даташит ESP32-P4 v0.7, с. 25); документы — перевести
[04](04-audio-path.md) и [06](06-open-questions.md) на стерео, «5,0 В»
в [09](09-power-supply.md).

## 11. Самопроверка 2026-10-05: найденные ошибки

| Было | Что не так | Исправлено |
|---|---|---|
| Выходы тюнера соединены с микшером напрямую | У RDA5807M выходы на постоянном напряжении 1,0–1,1 В (даташит V1.1, с. 7, «Audio Output Common Mode Voltage»); в типовой схеме производителя (рис. 8-1) стоят разделительные 4,7 мкФ. Без них постоянка шла в узел микшера и через 10 кОм — в выход ЦАП | электролиты 4,7 мкФ / 25 В на LOUT и ROUT, плюс к тюнеру |
| «Антенне ничего не нужно, документа нет» (ответ на разборы) | В той же типовой схеме RDA5807M на входе FMIN — разделительный 100 пФ (C7) и TVS | последовательный 100 пФ C0G между J4 и ANT; TVS — по желанию, если антенна выносная |
| «Перепаять перемычку GAIN» | Перемычки нет: усиление задаётся делителем на выводе 8 (GAIN/SLV): R1 на GND, R2 на GVDD (вывод 7). 26 дБ — 20 к / 100 к (даташит TI, табл. на с. 14) | формулировки на схеме и в документах |
| «MUTE модуля = SD, 100 кОм вниз удерживает усилитель выключенным» | У TPA3118 два вывода с обратной логикой: 2 SDZ (LOW — выкл.) и 12 MUTE (HIGH — выкл.), даташит с. 4. Куда идёт площадка MUTE на HW-327, неизвестно | места под 100 кОм вниз (SDZ) и вверх на +3V3_ESP (MUTE), впаивается один по прозвонке; при MUTE — инвертировать PIN_AMP_SD в прошивке |
| «Уровень тюнера даташитом не подтверждён» (здесь, в [04](04-audio-path.md), [26](26-firmware-spec.md)) | Даташит даёт 360 мВ типовой при громкости 1111 и девиации 22,5 кГц (с. 7). Выход ЧМ-детектора пропорционален девиации, поэтому на пиках вещания (75 кГц) — около 360 × 75 / 22,5 ≈ 1,2 В: это вывод из пропорциональности, не цифра даташита | баланс тюнер/ЦАП — регистром громкости тюнера и подстроечниками; уточнить замером |
| В прошивке не записано, как читать кнопки порта B | Прерывание заведено только INTA, а MODE и пресет 8 на порту B. Нужен бит IOCON.MIRROR = 1 — тогда INTA и INTB объединены (даташит MCP23017 DS20001952E, с. 20) | добавлено в открытые пункты прошивки |
| «5,1 В» в §1, §3, §4 | Модуль WeAct SY8205 выдаёт 5,0 В по перемычкам | исправлено на 5,0 В |
| §5: 47 Ом «ограничивают ток через диоды ЦАП» | см. правку в §5 | исправлено |

Проверено и подтвердилось: подтяжка ESP32-P4 45 кОм (даташит v0.7, с. 90);
GPIO50 = ADC2_CH1 (с. 25); порог единицы 0,75 × VDD (с. 89); подтяжки I²C
2,2 кОм на плате P4 (R49/R50 на листе 1 схемы Waveshare); распиновка HT7333-A
(Holtek rev. 1.30); входы TPA3118 смещены на 3 В, вход 30 кОм при 26 дБ.

Не проверено мной (взято из разборов): адрес ES7210 0x40; цифры P6KE16A.

**Открыто по прошивке:** включить расширитель; IOCON.MIRROR = 1; GPPU
у MCP23017; чтение PWR_SENSE; при площадке MUTE на выводе 12 — инверсия
PIN_AMP_SD.

## 12. Динамики и уровни (2026-10-05)

Динамики: 2 шт., маркировка LY2102-3 (сменные для JBL Charge 3, 53 мм),
4 Ом, 10 Вт, 82 ± 2 дБ/Вт, 130 Гц – 17 кГц — по данным продавца; по
маркировке документации не нашлось. Второй HW-327 и второй динамик заказаны.

- Совместимость: минимальная нагрузка TPA3118D2 — 3,2 Ом в BTL и 1,6 Ом
  в PBTL (даташит TI SLOS708G, с. 5). 4 Ом подходит.
- Потолок 10 Вт на 4 Ом — √(10 · 4) = 6,3 В эфф. на динамике; при 26 дБ
  (×20) это 0,32 В на входе усилителя. Усилитель от 12 В способен на
  большее (идеальный предел 8,5 В эфф., 18 Вт), поэтому ограничение нужно.
- Ток при 2 × 10 Вт и КПД ~0,9: 22 Вт / 12 В ≈ 1,9 А плюс P4 — БП 5 А и
  T5A с запасом.

Уровни на динамике при текущем микшере, 26 дБ и подстроечнике на максимуме
(расчёт; веса узла: тюнер 0,826, ЦАП 0,083):

| Источник | В узле | На динамике | Мощность на 4 Ом |
|---|---|---|---|
| ЦАП, 0 dBFS (2,1 В, даташит PCM5102A) | 0,17 В | 3,5 В | 3,0 Вт |
| Тюнер, 360 мВ (девиация 22,5 кГц, даташит RDA5807M) | 0,30 В | 5,9 В | 8,8 Вт |
| Тюнер на пиках вещания, ~1,2 В (вывод из пропорциональности) | 0,99 В | ограничение | перегрузка |

Вывод: при 26 дБ интернет-радио упирается в ~3 Вт, а эфир на пиках
перегружает динамик. Решать вместе с усилением HW-327 (по замеру U8/U7):
либо 26 дБ и R8/R11 10 к → 5,1 к (ЦАП 0 dBFS ≈ 10 Вт), либо заводское
усиление и калибровка подстроечником. В обоих случаях — потолок регистра
громкости тюнера в прошивке. Схему не меняем до замера.

## 13. Габариты модулей и платы (замеры заказчика, 2026-10-07)

| Модуль | Габарит, мм | Ещё |
|---|---|---|
| GY-PCM5102A | 36,9 × 22,4 | «расстояние между пинами 8,2 мм» — уточнить, между чем |
| HW-327 | 40,5 × 51,2 | — |
| MCP23017-CJMCU | 31,7 × 26,2 | у продавца на фото 26,4 × 21,4 — расхождение, уточнить; «8,2 мм между пинами» — уточнить |
| WeAct SY8205 | 25 × 32,3 | — |

Решение заказчика: плата-носитель может быть больше платы P4. Корпус
шире P4 примерно на 10 см (динамики) и выше примерно на 5 см (кнопки).
Оценка площади деталей без дорожек — 8 000–9 000 мм², из них два
HW-327 — 4 150 мм²; на плату размером с P4 (габарит со стеклом
126,9 × 70,7 мм по чертежу Waveshare) с дорожками не помещается.

**Посадочные места** (`hardware/skidl/make_footprints.py`, проверены 2026-10-07):

| Модуль | Монтаж | Источник геометрии | Состояние |
|---|---|---|---|
| RRD-102 | SMD-площадки, **микросхемой вверх** | библиотека JLCEDA (LCSC C9900205627); раскладка совпала с реверсом модуля (briankhuu.com, 2015, вид со стороны RDA5807M) | готово |
| GY-PCM5102A | гнёзда 2,54, микросхемой вверх, штыри вниз (подтверждено) | шаг 2,54 — стандартная гребёнка встала; ряды — по центрам отверстий на фото продавца: «1» на 6,43 мм левее и 0,43 мм ниже SCK; сходится с замером 7,13 − 0,64 = 6,49 мм | готово, проверить печатью 1:1 |
| MCP23017-CJMCU | гнёзда 2,54, микросхемой вверх, штыри вниз (подтверждено) | ряды напротив друг друга (заказчик); одиночный ряд — столбец A 7 шагов = 17,78 мм (замер 18,57 по штырям; 8 шагов не влезает в 21,4 мм); A — внешний (маркировка на обороте) | готово, проверить печатью 1:1 |
| WeAct SY8205 | 2 стойки по диагонали + провода 0,5 мм² (штырей модуль не предусматривает) | отверстия 15,4 × 14,6 мм между центрами, ~1,8 мм (под M1,6) — замер; IN слева, OUT справа, отверстия у OUT− и IN+ — фото продавца; симметрия отверстий принята | готово, проверить печатью 1:1 |
| HW-327 | 4 стойки + провода 0,5 мм² | отверстия по углам 29,2 × 39,8 мм между центрами, 2,55 мм — замер; MUTE и INPUT сверху, POWER и OUT снизу — фото продавца | готово, проверить печатью 1:1 |

Номера площадок всех пяти посадочных мест совпадают с выводами символов —
проверка в `make_footprints.py` (на поломке проверена: удалённую площадку
находит). ERC KiCad после этого — 0 нарушений.

**Открыто:** крепёж модулей. Отверстия на нашей плате под стойки сейчас
3,2 мм — заглушка; диаметр поставить, когда выбран крепёж (отверстия
модулей: SY8205 ~1,8 мм — M1,6; HW-327 2,55 мм — M2 или M2,5).

**Контур платы** (решение заказчика 2026-10-07): **200 × 70 мм**. Основная
плата с двумя динамиками по бокам занимает 25 × 9 см, плата-носитель — не
больше. Четыре отверстия M3 (3,2 мм) по углам, центры в 4 мм от краёв.
Делает `hardware/skidl/make_board.py` (запускать питоном KiCad); отверстия
помечены «только на плате». DRC пустой платы — 0 нарушений.

## 14. Плата: требования и правила по руководству разводки (2026-10-08)

Руководство заказчика «Руководство по разводке печатных плат для ИИ (KiCad)»,
этапы 0–4.

| Параметр | Значение | Откуда |
|---|---|---|
| Слои | 2, 1,6 мм, медь 1 oz; низ — сплошная GND, верх — сигналы + GND со сшивкой | руководство, §3, 2-слойный стек |
| Напряжения | ≤ 13 В (TVS ограничивает импульсы ~22 В) → зазор по IPC-2221 0,1 мм; ставим 0,2 мм | §4.3 |
| Быстрые сигналы | нет: I²S BCK 1,4 МГц, I²C 100 кГц; длинный участок — шлейф | §4.4 |
| Ток +12 В | 2 × 10 Вт / 0,9 + DC-DC ~11 Вт ≈ 33 Вт → 2,75 А; × 1,5 = 4,1 А | расчёт |
| Ток +5 В | до 2 А (P4, оценка) × 1,5 = 3 А | оценка, не замер |
| Ток динамика | 10 Вт / 4 Ом → 1,58 А эфф.; × 1,5 = 2,4 А | расчёт |

Ширина по IPC-2221 (I = 0,048 · ΔT^0,44 · A^0,725, ΔT = 10 °C, 1 oz;
формула воспроизводит таблицу руководства 0,5…5 А):

| Класс цепей | Цепи | По IPC-2221 | Задано |
|---|---|---|---|
| POWER_12V | +12V, +12V_IN, 12V_FUSED | 2,1 мм | 2,5 мм, виа 0,8/0,4 |
| POWER_5V | +5V | 1,37 мм | 1,5 мм, виа 0,8/0,4 |
| SPEAKER | SPK_* | 1,0 мм | 1,5 мм |
| GND | GND | — (полигон) | 1,5 мм для отдельных дорожек |
| Default | остальные | — | 0,25 мм, зазор 0,2, виа 0,6/0,3 |

Ограничения платы (Constraints): дорожка/зазор ≥ 0,2 мм, виа ≥ 0,6/0,3 мм,
кольцо ≥ 0,13 мм, медь до края ≥ 0,5 мм — с запасом к минимумам JLCPCB
для 2 слоёв из руководства (0,127 / 0,3 / 0,13 / 0,3 мм). Классы
применяются: проверено через pcbnew (`FindNet().GetNetClassName()`).

**Блокер компоновки (§6.3 руководства):** в один ярус на 200 × 70 не
помещается 32 детали из 85 (place_parts.py). Разводить по руководству
нельзя, пока компоновка не проходит — нужен выбор: второй ярус для HW-327,
уплотнение или иная форма платы.

## 15. Сигнальная плата: сверка с руководством разводки (2026-10-08)

Плата 230 × 70 мм, 2 слоя, самостоятельное изготовление. Конвейер:
`place_parts.py signal` → `route_board.py signal 40` (Freerouting, затем
расширение узких дорожек и срез углов) → `add_gnd_zone.py signal` → DRC
`kicad-cli pcb drc --schematic-parity --refill-zones`.

Итог DRC: 0 нарушений, 0 неразведённых, 0 расхождений со схемой.

| Пункт руководства | Что сделано | Результат |
|---|---|---|
| §4.5 развязка у вывода питания | Добавлен C27 100 нФ на +3V3_FM у вывода 5 RRD-102 (в типовой схеме RDA5807M — C2 22 нФ «close to pin7», рис. 8-1 даташита; есть ли он на модуле — не подтверждено). Расстановка ставит развязку к выводу (`near` в boards.py) | между площадками: C27 1,2; C22 (MCP VCC) 1,9; C7/C9 (HT7333) 1,9/0,9; C13 (PCM VIN) 3,7 мм — ближе не пускает контур модуля (площадка в 2,0 мм от края модуля); 10 мкФ C6/C8 — вторыми, 4,2/3,7 мм |
| §7.2, §11.7 без углов 90° и острых | срез отрезком 45° после трассировки (`chamfer` в route_board.py) | 0 (углы внутри площадок закрыты медью и не считаются) |
| §7.5, §8.1 земля обеих сторон, сшивка | полигоны GND F/B, зазор 0,6 мм (был 1,0 — резал спицы и рвал заливку); переходы GND сеткой 20 мм (λ/20 при ~350 МГц; на FM 108 МГц λ/20 ≈ 65 мм в FR-4) и не меньше двух на кусок заливки; выводные площадки GND считаются сшивкой | 29 переходов сшивки |
| §5.2 термобарьеры, ≥ 2 спиц | solid для J15-2 (земля входа 5 В — силовая) и 5 площадок с мелкими кусками заливки (`SOLID_PADS` в add_gnd_zone.py) | 0 starved_thermal |
| §9.2 шелкография не на падах, читаемые обозначения | контур RRD-102 охватывает площадки; обозначения ставятся в свободное место | 0 silk-замечаний; R13, R14 — внутри своего корпуса (снаружи места нет), после пайки закрыты |
| §9.2 название, ревизия, дата | надпись `IP-Radio signal board rev 1 2026-10-08` | есть |
| §7.2 минимум переходов на сигналах | J3 отодвинут от края на 6 мм, вокруг мелких ИС поле 3 мм | переходов сигнальных цепей 30 (было 54) |

Каждый переход на самодельной плате — отверстие 0,8 мм и проволочка,
пропаянная с двух сторон: всего 60 (30 сигнальных + 30 GND).

Не проверено: соответствие 3D-корпусов (коллизии по высоте), печать 1:1
по модулям.

### 15.1. Плата питания: сверка с руководством (2026-10-08)

Плата 125 × 70 мм, односторонняя (медь только B.Cu), тот же конвейер.
DRC: 0 расхождений со схемой; 1 неразведённая связь — проволочная перемычка
+12V Q1-3 → D1-1 (цепь стабилитрона затвора, ток ничтожный); 2 замечания
silk_edge_clearance — линия края платы в посадочном месте USB-A J2 (Molex
67643) выходит за край на 0,11 мм: гнездо стоит фланцем по краю (вариант 2,
принят заказчиком), оставлено осознанно.

| Пункт | Что сделано | Результат |
|---|---|---|
| §4.7 DC-DC: входной керамический вплотную к VIN | C2/C5 100 нФ к выводам VIN/VOUT модуля U1 (SY8205), C1/C4 470 мкФ — вторыми | C2 и C5 — 1,4 мм между площадками; C1 8,2, C4 7,2 мм |
| §4.1 ширина по току | после трассировки дорожки уже своего класса расширяются до него (`fit_class_widths` в route_board.py), где не даёт зазор — остаются | +12V 2,5 мм (был участок 25 мм шириной 1,9); остались короткие сужения у площадок: +12V/12V_FUSED 1,9 мм на 2,3–2,7 мм, +5V 0,9–1,1 мм на ~1 мм |
| §5.2 solid для силовых площадок | J1-2, J13-2, J14-2, J2-4, U1-2, U1-4, C1-2, C4-2, D2-2 | паять паяльником помощнее |
| §7.2 углы | срез 45° | 0 углов 90° |
| §7.5 земля | полигон GND на B.Cu, зазор 0,6 мм | один кусок, островов нет |
| §9.2 надпись | `IP-Radio power board rev 1 2026-10-08` | есть |

Переходных отверстий нет (одна сторона).

## 16. Питание: модули AC-DC внутри корпуса — рассмотрено и отклонено (2026-10-13)

Вариант заказчика: вместо платы питания поставить готовые модули AC-DC
(Hi-Link / Mean Well) на 12 В, 5 В и 3,3 В от сети 220 В.

**Решение: оставляем внешний блок питания 12 В / 5 А** и плату питания как есть.

| Довод | Суть |
|---|---|
| 220 В в корпусе | появляются сетевой разъём, выключатель и провода 220 В внутри; самодельная плата с сетью требует больших зазоров и закрытого корпуса. Сейчас сеть остаётся снаружи ([06](06-open-questions.md), Q6) |
| 3,3 В тюнеру | импульсный модуль шумнее линейного HT7333 от 5 В; третий модуль не нужен при любом варианте |
| Hi-Link | по 12 В на ток ≥ 2,8 А (2 × 10 Вт / 0,9 / 12 В × 1,5) модели не найдено; цифры у продавцов расходятся (HLK-10M12: 0,83 или 0,9 А), официальные даташиты получить не удалось |
| Mean Well | годится, если вернуться к варианту: IRM-60-12 (12 В 5 А, до 120 мВ п-п) + IRM-30-5 (5 В 6 А), EN55032 Class B — спецификации IRM-60 2025-11-21, IRM-30 2026-04-03 |

Не проверено: реальная помеха модулей на тюнер в корпусе — только на макете.
