Spok1978/hybrid-radio/docs/26-firmware-spec.md

# 26. ТЗ на прошивку гибридного радиоприёмника (ESP32-P4)

Основа — черновик заказчика от 2026-08-26 (`ТЗ_гибридное_радио_ESP32-P4.md`).
Здесь он дополнен данными проекта и исправлен там, где расходился с принятыми
решениями. Правки помечены **[исправлено]** и **[добавлено]**, чтобы заказчик
видел, что именно изменилось.

> **Кто исполнитель.** Уточнено 2026-08-26: прошивку пишем сами, внешнему
> подрядчику документ не передаётся. Поэтому это не задание на сторону,
> а рабочая спецификация: то, к чему приводится код, и то, с чем сверяются
> решения по ходу работы.
>
> Пункты, помеченные **[не подтверждено]**, содержат данные, ещё не снятые
> с реального железа. Не выдавать их за факты и предусматривать, что значения
> изменятся.

---

## 1. Цель и общее описание

Прошивка гибридного радиоприёмника с двумя источниками сигнала:

1. **Эфирный тюнер** (аппаратный чип RDA5807M).
2. **Интернет-радио** (потоковое вещание через Wi-Fi).

Список интернет-станций формируется поиском в открытом каталоге
**Radio-Browser.info** и хранится на карте microSD. Управление — два энкодера
с кнопками, кнопки пресетов, кнопка режима и сенсорный экран. Интерфейс
на русском языке, в стиле Material Design.

**[добавлено]** Прибор рассчитан в том числе на пожилых пользователей.
Требование R4.1 проекта: **сенсорный экран и физические органы управления
работают одновременно и равноправно**. Физические органы — не запасной
вариант, а заявленная особенность прибора. Ни один сценарий не должен
требовать обязательного касания экрана, кроме ввода длинных строк.

## 2. Аппаратная платформа

| Компонент | Модель / интерфейс | Назначение |
|---|---|---|
| Микроконтроллер | ESP32-P4, плата **Waveshare ESP32-P4-WIFI6-Touch-LCD-5** **[исправлено]** | Центральный контроллер |
| Wi-Fi | **сопроцессор ESP32-C6 по SDIO** **[добавлено]** | У ESP32-P4 своего радиомодуля нет |
| Дисплей | Штатная панель платы, **5″, 720×1280, MIPI-DSI**, ёмкостный тач **[исправлено]** | Интерфейс, сенсорный ввод |
| Эфирный тюнер | RDA5807M, I²C, адреса **0x10** и **0x11** **[добавлено]** | УКВ OIRT и FM CCIR, RDS |
| Аудиокодек | **ES8311 на плате** **[исправлено]** | ЦАП для интернет-радио; про аналоговый вход — §2.2 |
| Карта памяти | microSD, слот TF на плате | Список станций, пресеты, настройки |
| Энкодер 1 с кнопкой | инкрементальный EC11, 20 импульсов на оборот | Навигация, выбор, перестройка |
| Энкодер 2 с кнопкой | инкрементальный EC11, 20 импульсов на оборот | Громкость; кнопка — Mute |
| Кнопка MODE | без фиксации, 1 GPIO | Переключение эфир ↔ интернет |
| Кнопка питания | 1 GPIO | Включение и выключение |
| Кнопки пресетов | 6 или 8, по числу свободных GPIO **[не подтверждено]** | Быстрый вызов пресетов обоих режимов |
| Батарея | Li-Ion 3,7 В в штатный разъём MX1.25 платы **[добавлено]** | Защита данных от провалов питания |

**[исправлено] Плата не Espressif ESP32-P4-Function-EV-Board.** Заказана
и будет использоваться Waveshare ESP32-P4-WIFI6-Touch-LCD-5: плату Espressif
найти в продаже не удалось. Последствия существенные:

- панель **720×1280, книжной ориентации**, а не 1024×600 альбомной;
- ~~готового драйвера дисплея под неё нет, дисплейный порт пишется~~
  **[исправлено 2026-08-26] по результатам проверки:** готовый стек
  опубликован в ESP Component Registry — BSP платы
  `waveshare/esp32_p4_wifi6_touch_lcd_5` (в т.ч. управление подсветкой
  `bsp_display_brightness_set(0–100)`) и драйвер панели
  `waveshare/esp_lcd_hx8394`; параметры панели и тача берутся из них
  и из схемы платы в репозитории Waveshare, снимать с железа не требуется (§2.1);
- на плате **ES8311**, отдельный ЦАП PCM5102A не нужен;
- на плате держатель батарейки RTC **1220, только перезаряжаемые 3–3,3 В**
  (LIR1220/ML1220; обычную CR1220 ставить нельзя) **[исправлено]**,
  отдельные часы DS3231 не нужны;
- на плате штатная кнопка **POWER** (длинное нажатие 2 с — выключение).
  **Решение заказчика 2026-08-26: она остаётся внутри корпуса и в
  пользовательских сценариях не участвует** — только сервисная роль
  (аварийное полное обесточивание при вскрытии). Пользовательская кнопка
  питания — своя, на GPIO (§6.4) **[добавлено]**.

### 2.1. Дисплей: ориентация и поворот

Интерфейс **альбомный** — решение заказчика, пересмотру не подлежит.
Панель физически книжная, поэтому кадр поворачивается на 90°.

**[добавлено]** У DSI-панелей в video mode собственного поворота, как правило,
нет. На ESP32-P4 поворот делается **аппаратно**: в чипе есть PPA — Pixel
Processing Accelerator, операция SRM (scale-rotate-mirror), углы 0/90/180/270
против часовой стрелки (`ppa_srm_rotation_angle_t`), заголовок `driver/ppa.h`,
функция `ppa_do_scale_rotate_mirror()`. Программного разворота буфера
не требуется. Источник — документация ESP-IDF по ESP32-P4, раздел PPA,
прочитано 2026-08-26.

**[добавлено 2026-08-26] по проверке:** в порте LVGL от Espressif поворот
через PPA включается одной опцией `CONFIG_LVGL_PORT_ENABLE_PPA`, без
дополнительного кода. Оговорка: производительность PPA зависит от
пропускной способности PSRAM, при конкуренции за неё с другой периферией
падает — поэтому draw-буферы LVGL делаем частичными, а не полноэкранными.

**[исправлено 2026-08-26]** Параметры панели с железа снимать не нужно —
они известны из документации платы и готовых компонентов:

| Параметр | Значение | Источник |
|---|---|---|
| Контроллер панели | **HX8394** | драйвер `waveshare/esp_lcd_hx8394` в ESP Component Registry |
| Режим | **video mode** | документация платы Waveshare |
| Интерфейс | MIPI-DSI, 2 data lanes | спецификация платы |
| Тачскрин | **GT911**, ёмкостный, I²C (адреса 0x5D/0x14), до 5 точек | спецификация платы |
| Тайминги, последовательность инициализации, reset/питание/подсветка | готовые в драйвере и BSP | `waveshare/esp_lcd_hx8394`, BSP `waveshare/esp32_p4_wifi6_touch_lcd_5` |
| Подсветка | через BSP: `bsp_display_brightness_init()`, `bsp_display_brightness_set(0–100)` | BSP платы |

Исполнителю: использовать BSP и драйвер как есть; собственные значения,
если понадобятся, по-прежнему выносить в один конфигурационный заголовок.

### 2.2. Коммутация звука

Два источника на один усилитель. **[исправлено]** Решение зависит от факта,
который проверяется первым при получении платы: **выведен ли аналоговый вход
кодека ES8311 наружу**.

| Случай | Схема |
|---|---|
| ~~Вход ES8311 выведен~~ **ОТПАЛ 2026-08-27** | По схеме платы выводы 17 и 18 кодека **ни к чему не подключены** (§2.5). Вариант был бы лучшим, но физически невозможен без пайки к корпусу QFN |
| Вход не выведен | **Схема 1:** пассивная сумма на резисторах, неактивный источник глушится программно. Номиналы **разные** — выходные уровни источников не равны. **[исправлено 2026-08-26]** Уровень «2,1 В у ЦАП» из черновика относился к удалённому PCM5102A и к ES8311 неприменим: полношкальный выход кодека берётся из его даташита (зависит от AVDD) или измеряется на плате; уровень тюнера 360 мВ **[не подтверждено]** — в даташите RDA5807M заявлено лишь «line-level», измерить. **[исправлено 2026-10-05]** В даташите RDA5807M V1.1 на с. 7 есть: 360 мВ типовой при девиации 22,5 кГц; выходы смещены на 1,0–1,1 В ([33](33-carrier-board.md), §11). Расчёт делителей — по измеренным значениям |
| Схема 1 не проходит по шуму | **Схема 2, запасная:** аналоговый ключ ADG884 под управлением GPIO. Односупплайному ключу нужны смещение к середине питания и развязка конденсаторами с обеих сторон: диапазон сигнала ADG884 ограничен шиной питания 0…VDD (по даташиту Analog Devices) |

**[добавлено 2026-08-26]** К проверке входа ES8311: делается **заранее по
опубликованной схеме платы**, не дожидаясь железа. Схема найдена 2026-08-27
в репозитории `waveshareteam/ESP32-P4-WIFI6-Touch-LCD-5`, каталог
`hardware/schematic` (§2.3).

**[уточнено 2026-08-27] Свидетельство скорее против «предпочтительного»
варианта.** По `docs/IO.md` того же репозитория линия **I²S DIN (GPIO11)
занята записью с ES7210**, а за ES8311 закреплено только воспроизведение
(DOUT, GPIO9). То есть слот записи на общей шине I²S уже отдан микрофонному
кодеку. Это не доказывает, что аналоговый вход ES8311 никуда не разведён,
но означает, что даже при наличии входа завести его звук внутрь по I²S
без переделки не выйдет — шину пришлось бы делить.

Прежний косвенный довод «микрофоны обслуживает ES7210, значит вход ES8311
свободен» **ослаблен**: свободен он или нет, тракт записи всё равно занят.
Окончательный ответ — по схеме.

Во всех случаях **режимом распоряжается программа**, а не орган на панели:
физического переключателя тракта в приборе нет.

**Решено 2026-08-26: внешний усилитель ставим.** **TPA3118D2**, один канал
BTL от 12 В, динамик **4 Ω, 10 Вт** — штатных 2 Вт платы может не хватить.
Динамик подобран, но ещё не куплен **[не подтверждено]**. Каналы L и R
сводятся в моно. Схема питания усилителя за заказчиком, решение не принято.
Разделительный конденсатор на входе усилителя обязателен: входы смещены на 3 В
(по даташиту TI).

**[добавлено 2026-08-26] по проверке:**

- **Точка подключения:** TPA3118 подключается к выходу кодека ES8311
  **до штатного усилителя платы NS4150B** (2 Вт, 8 Ом, линия включения
  `PA_Ctrl` = GPIO53), а не к клеммам динамика — иначе двойное усиление.
  Штатный NS4150B в изделии не используется и удерживается выключенным.
- **Защита динамика:** на 12 В / 4 Ω усилитель способен отдать больше 10 Вт;
  мощность ограничивается аппаратно через вывод **PLIMIT** (встроенный
  лимитер мощности семейства TPA31xxD2, по даташиту TI) и/или программным
  потолком громкости.
- Линия **SD** у TPA3118 — shutdown (LOW → выходы в Hi-Z); использование
  в §6.4 для приглушения перед сном корректно.

### 2.3. Карта выводов платы

**[добавлено 2026-08-27]** Найден официальный репозиторий платы —
`waveshareteam/ESP32-P4-WIFI6-Touch-LCD-5`. В нём 12 примеров под ESP-IDF,
заводская прошивка и **схема платы** (каталог `hardware/schematic`), которой
не было ни на странице товара, ни в вики. Файл `docs/IO.md` — список выводов,
о котором сказано, что он сверен с исходником BSP и со схемой.

| Назначение | Вывод | Примечание |
|---|---|---|
| I²C SDA | **GPIO7** | общая шина платы: кодеки и тач |
| I²C SCL | **GPIO8** | там же |
| Подсветка панели | **GPIO26** | LEDC PWM, 5 кГц, 10 бит |
| Сброс панели | **GPIO27** | HX8394 |
| I²S MCLK | **GPIO13** | шина ES8311 / ES7210 |
| I²S BCLK | **GPIO12** | |
| I²S LRCK / WS | **GPIO10** | |
| I²S DOUT | **GPIO9** | воспроизведение, ES8311 |
| I²S DIN | **GPIO11** | **запись, ES7210** |
| Включение усилителя динамика | **GPIO53** | активный высокий уровень |
| microSD D0…D3 | **GPIO39…GPIO42** | SDMMC, 4 бита |
| microSD CMD | **GPIO44** | |
| microSD CLK | **GPIO43** | |
| Сброс тача TP_RST | GPIO23 | через R37 (0 Ω) |
| Прерывание тача TP_INT | GPIO2 | через **необязательный** R108 (NC/0R) — зависит от того, что напаяно |

Панель: 720×1280, MIPI-DSI на **2 линии**, контроллер HX8394, скорость линии
**700 Мбит/с**. Память платы: **32 МБ PSRAM и 32 МБ флеш** — буферам потока
и декодеру этого с запасом.

Адреса на шине I²C: **GT911** — 0x5D или 0x14 (выбирается уровнем INT при
сбросе, поэтому драйвер репозитория опрашивает оба), **ES8311** — 0x18,
**ES7210** — 0x40. Тюнер RDA5807M (0x10/0x11) и расширитель портов
(0x20–0x27) с ними не конфликтуют.

**Что это значит для нас.** Заняты выводы 7, 8, 9, 10, 11, 12, 13, 23, 26,
27, 39–44 и 53, плюс, возможно, 2. Что бы ни оказалось выведено на
40-контактную гребёнку, эти выводы для наших кнопок и энкодеров недоступны.
Самой таблицы гребёнки в `IO.md` нет: сказано, что это разъём и что смотреть
надо схему. Схема теперь есть — Q11 из «нечего читать» превратился
в «прочитать схему».

**Важное предупреждение оттуда же:** транспортные выводы P4 ↔ C6 в документе
намеренно не приводятся, и прямо сказано — **не переносить их с другой
платы**. Это ровно тот случай, о котором предупреждает
[27](27-reference-sheet.md), §1.5: сведения про esp-hosted у нас взяты
из проекта под CrowPanel, а не под нашу плату.

### 2.4. Совместимость версий Wi-Fi через сопроцессор

**[добавлено 2026-08-27]** Из `docs/P4_C6_HOSTED_WIFI.md` того же
репозитория — диапазоны, заявленные в манифесте примера и проверяемые
сборкой в CI:

| Ветка ESP-IDF | `esp_wifi_remote` | `esp_hosted` |
|---|---|---|
| до 6.0, включая v5.5.5 | 0.14.* | 1.4.* |
| 6.0 и новее, включая v6.0.2 | ≥1.6, <2.0 | ≥2.12, <3.0 |

**Складывается с нашим выбором:** ADF закрепляет ESP-IDF v5.5.3
([27](27-reference-sheet.md), §1.1), то есть верхняя строка — `esp_wifi_remote`
0.14.\* и `esp_hosted` 1.4.\*. Драйвер панели требует IDF не ниже 5.3, что
тоже выполняется. Конфликта версий между звуковым трактом, сетью и дисплеем
на бумаге нет.

Две оговорки прямо из документа: **успешная сборка не доказывает связь
с конкретным образом прошивки C6**, а исходников и инструкций сборки этой
прошивки в репозитории нет — заводской образ поставляется как есть.

#### [добавлено 2026-08-27] ADF требует другую версию esp_hosted

ESP-ADF склонирован, и его собственный манифест прочитан:
`examples/player/pipeline_http_mp3/main/idf_component.yml`, правила для цели
`esp32p4`:

| Компонент | Правило ADF |
|---|---|
| `espressif/esp_hosted` | IDF < 5.4.0 → `~1.1`; **IDF ≥ 5.4.0 → `^2.6.4`** |
| `espressif/esp_wifi_remote` | IDF ≤ 5.4.0 → `~0.4`; 5.4–5.5 → `~0.6`; **IDF ≥ 5.5.0 → `>=0.10,<2.0`** |

Сопоставление с таблицей Waveshare при закреплённой ADF версии IDF 5.5.3:

| Компонент | Waveshare (под свою плату) | ADF | Пересекается? |
|---|---|---|---|
| `esp_wifi_remote` | `0.14.*` | `>=0.10,<2.0` | **да**, 0.14 попадает в диапазон |
| `esp_hosted` | **`1.4.*`** | **`^2.6.4`** | **НЕТ** |

**Диапазоны по `esp_hosted` не пересекаются.** Это не мелочь: они отвечают
на разные вопросы. Waveshare говорит, какая версия **хоста** разговаривает
с тем образом прошивки C6, который залит на их плату. ADF говорит, с чем
**он сам** проверялся. Отсюда риск: собрать по версиям ADF — соберётся,
но может не заговорить с нашим сопроцессором. Waveshare об этом
и предупреждает дословно: «Compile success does not prove communication
with every C6 slave image».

#### [СНЯТО 2026-08-27] Конфликта нет: это требование примеров, а не ADF

Разобрано по склонированному дереву. **Ни один компонент ESP-ADF
не требует `esp_hosted`** — проверено по манифестам всех компонентов
в `components/`. И **код ADF не вызывает ни одной функции `esp_hosted`**:
поиск по исходникам компонентов не даёт ни единого совпадения.

Требование `^2.6.4` живёт только в манифестах **примеров** ADF —
`examples/player/pipeline_http_mp3/main/idf_component.yml` и подобных.
Пример объявляет зависимость для себя, чтобы собраться на плате
Espressif; к компонентам, которые мы берём в проект, это отношения
не имеет.

**Следствие для нас.** Мы не собираем примеры ADF — мы берём его
компоненты (`audio_pipeline`, `audio_stream`, кодеки) в свой проект,
а `esp_hosted` объявляем сами, по версиям Waveshare. Никто ни с кем
не спорит.

Подтверждено разрешением зависимостей нашего проекта:

| Компонент | Разрешилось у нас | У вендора платы |
|---|---|---|
| `espressif/esp_hosted` | **1.4.7** | 1.4.7 |
| `espressif/esp_wifi_remote` | **0.14.5** | 0.14.5 |

Совпадает до версии. Прежний разбор ниже оставлен как история —
он объясняет, почему тревога вообще возникла.

> Три пути, которые рассматривались, пока конфликт считался настоящим:
> закрепить `esp_hosted` на `1.4.*` поверх требования ADF; обновить
> прошивку сопроцессора до совместимой с 2.x; либо начать с примера
> самой Waveshare, а не ADF. Был выбран третий, и он же привёл
> к разгадке: собрав сначала пример вендора, а затем свой проект
> на его версиях, мы увидели, что ADF в этот спор не вступает.

### 2.5. Разбор схемы платы

**[добавлено 2026-08-27]** Схема `ESP32-P4-WIFI6-Touch-LCD-5-Schematic.pdf`
из репозитория платы прочитана. Два вопроса, висевших с самого начала,
закрыты.

#### Аналоговый вход ES8311 наружу не выведен

**Выводы 17 (MIC1N) и 18 (MIC1P/DMIC_SDA) кодека U12 ни к чему
не подключены** — у них нет ни цепи, ни площадки, ни контрольной точки.
Проверено визуально на большом увеличении: соседние выводы 21 (EP),
20 (CE), 19 (CDATA) и 16 (VMID) имеют отходящие проводники, а 17 и 18
заканчиваются обрубком вывода символа.

Прежний косвенный довод «микрофоны обслуживает ES7210, значит вход ES8311
свободен» оказался верным по факту и бесполезным по следствию: вход
действительно свободен, но никуда не разведён. Цепи `MIC1_P`/`MIC1_N`,
которые могли навести на мысль об обратном, идут к **ES7210** (U14,
выводы 15 и 16) через конденсаторы C128 и C130.

**Следствие: «предпочтительный» вариант из §2.2 невозможен.** Завести эфир
в АЦП кодека без пайки к выводу корпуса QFN нельзя. Работаем по **Схеме 1**
(пассивная сумма), запасной остаётся **Схема 2** (ключ ADG884).

#### Штатный звуковой тракт платы

| Звено | Что |
|---|---|
| Кодек | **U12 ES8311**, выходы **OUTP (вывод 12)** и **OUTN (13)** |
| Развязка | C107 и C106, по 1 мкФ |
| Вход усилителя | через C115/C133 (100 нФ) и R94/R96 (150 кОм) на `PA_INL+` / `PA_INL−` |
| Усилитель | **U15 NS4150B**, входы IN+ (3) и IN− (4), выходы OUT+ (8) и OUT− (5) |
| Включение | `PA_CTRL` ← **GPIO53** через R100 (0 Ω), подтяжка вниз R101 10 кОм |
| Выход | через ферриты L5 и L7 на разъём динамика |

**Важное следствие, которого не было в расчётах:** выход кодека
**дифференциальный**, а не однотактный. Для TPA3118D2 это удобно — у него
дифференциальные входы, и пара `OUTP`/`OUTN` заводится прямо на них.
Но **пассивное подмешивание однотактного стерео с тюнера в дифференциальную
пару — задача сложнее той, что описана в [04](04-audio-path.md)**: тот расчёт
делался под однотактный выход PCM5102A. Схему сумматора надо пересчитывать
под дифференциальный вход, либо ставить перед усилителем свой узел.

Точка врезки TPA3118 подтверждена: цепи `OUTP`/`OUTN` **до** NS4150B,
а сам NS4150B удерживается выключенным низким уровнем на GPIO53.

#### Куда физически можно подключиться

**[добавлено 2026-08-27]** Заказчик заметил на фотографии платы разъём
**Speaker Header, GH1.25, 2 контакта, с замком**. Это верное и важное
наблюдение: разъём есть, но на нём **уже усиленный** сигнал — выход
NS4150B после ферритов L5 и L7. Отсюда пришлось пересобрать всю картину
доступности.

| Точка | Что там | Как добраться |
|---|---|---|
| Разъём динамика GH1.25 | выход класса D, мостовой, после ферритов | **разъём**, паять не надо |
| `OUTP` / `OUTN` — линейный выход кодека | дифференциальный, до усилителя | только площадки C106/C107 (1 мкФ, типоразмер 0201) |
| `PA_INL+` / `PA_INL−` — вход усилителя | тот же сигнал после развязки | только площадки C115/C133 (100 нФ, 0201) |
| Шина I²S | GPIO9…GPIO13 | **на гребёнку не выведена** |

**Контрольных точек на звуковом тракте нет.** Во всей схеме их всего две,
TP1 и TP2, и обе у дисплея. То есть единственный разъёмный аудиовыход платы —
динамиковый, и он усиленный.

#### Три пути, и рекомендация

**A. Обойтись штатным усилителем.** Динамик прямо в разъём, ничего не паяем.
Но: разъём рассчитан на **8 Ω / 2 Вт**, а подобран динамик **4 Ω / 10 Вт** —
такую нагрузку NS4150B не тянет, пришлось бы менять динамик на 8-омный.
И главное — **эфир всё равно некуда завести**: вход кодека не разведён
(см. выше), значит подмешивать тюнер пришлось бы к тем же площадкам 0201.
Простоты, ради которой этот путь и рассматривается, не получается.

**B. Внешний TPA3118, врезка на площадках `PA_INL±`.** Два провода к 0201,
туда же пассивная сумма с тюнером, NS4150B держим выключенным низким уровнем
на GPIO53. Сигнал линейного уровня и чистый. Минусы: пайка к площадкам
0,6×0,3 мм и **дифференциальная** пара вместо однотактной — сумматор
из [04](04-audio-path.md) под неё не считался.

**C. Свой ЦАП по I²S на выводах гребёнки — рекомендую.** У ESP32-P4
**три контроллера I²S** (документация ESP-IDF, раздел I2S), штатный кодек
занимает один. Если вывести I²S на свободные выводы гребёнки, снаружи
ставится собственный **PCM5102A** (уже куплен), и дальше всё по уже посчитанной схеме.

Что это даёт:

- **пайки к 0201 нет вообще**, всё на гребёнке и на своей плате;
- выход ЦАП **однотактный**, а значит расчёт пассивного сумматора
  из [04](04-audio-path.md) — четыре резистора, 2,1 В у ЦАП против
  360 мВ у тюнера — **снова становится верным**, а не требует пересмотра;
- штатные кодек и усилитель просто не используются, GPIO53 держим низким;
- динамик 4 Ω / 10 Вт остаётся как выбран, его питает наш TPA3118.

**[не подтверждено]** Условие, от которого этот путь зависит: **маршрутизируется
ли I²S у ESP32-P4 на произвольные выводы через матрицу GPIO.** Страница I2S
в документации ESP-IDF об этом не говорит; проверять по Technical Reference
Manual. У прежних ESP32 такая маршрутизация есть, но переносить это
на P4 без проверки нельзя. Если окажется, что выводы жёсткие — работаем
по варианту **B**.

#### Гребёнка J3: 40 контактов

Гребёнка на схеме — **J3**, чётные выводы слева, нечётные справа.
На неё выведены:

| Что | Цепи |
|---|---|
| Питание | `ESP_3V3`, `VCC_5V` |
| Земля | несколько выводов `GND` |
| Шина I²C платы | **GPIO7 (SDA), GPIO8 (SCL)** — та же, где GT911, ES8311 и ES7210 |
| Свободные GPIO | **3, 4, 5, 21, 22, 28, 29, 30, 31, 32, 34, 46, 47, 48, 49, 50, 51, 52** — исправлено 2026-08-27, см. ниже |
| Выведены, но **занятые** | **GPIO35** — цепочка автосброса (U7); **GPIO37**, **GPIO38** — отладочный UART моста CH343P |
| Условно занятые | `GPIO2` — прерывание тача, только если напаян R108; `GPIO24`/`GPIO25` — альтернатива цепям `USB1P1_N`/`USB1P1_P` |
| USB | `USBD_N`, `USBD_P`, `USB1P1_N`, `USB1P1_P` |

**Это закрывает Q11.** Свободных выводов **восемнадцать**, а нужно
семнадцать: восемь пресетов, два энкодера по три линии, кнопка MODE, кнопка
питания и линия приглушения усилителя. **Расширитель портов не нужен**,
восемь кнопок ставятся. Тюнер садится на ту же шину I²C, которая
на гребёнку уже выведена.

**[исправлено 2026-08-27]** Сначала здесь стояло «порядка двадцати одного,
с запасом». Это было неверно: **GPIO35** занят транзисторной цепочкой
автосброса (U7 EMH4T2R, по DTR/RTS), а **GPIO37** и **GPIO38** — отладочным
UART моста CH343P (выводы RXD и TXD). Кнопка на любом из трёх сломала бы
прошивку или консоль. Разбор — [29](29-yaml-review.md).

Восемнадцать против семнадцати — **запаса практически нет**. Если он нужен:
шесть кнопок вместо восьми (заказчик 2026-08-26: число некритично), либо
две ячейки на экранные плитки.

**[не подтверждено]** Две вещи проверить перед разводкой:

1. **Точная нумерация выводов J3.** Состав цепей прочитан надёжно, но
   привязка «цепь → номер вывода» снималась с картинки: метки на схеме стоят
   между строками, и автоматическое сопоставление двоило часть значений.
   Перед пайкой сверить по схеме ещё раз или прозвонить.
2. **Какие из этих GPIO у ESP32-P4 являются strapping-выводами** и что
   у них на уровне при старте. Кнопка, посаженная на strapping-вывод, может
   мешать загрузке.

### 2.6. Подключение эфирного модуля RDA5807M

**[добавлено 2026-08-27]** Три из четырёх соединений тюнера решаются
однозначно и уже проверены по схеме.

| Вывод модуля | Куда на J3 | Основание |
|---|---|---|
| **VCC** | `ESP_3V3` | Питание чипа **2,7–3,3 В**, 5 В подавать нельзя ([02](02-fm-frontend.md)). Ток около 20 мА по даташиту |
| **GND** | любой из выводов `GND` | их на гребёнке несколько |
| **SDA / SDIO** | **GPIO7** | шина I²C платы, `ESP_I2C_SDA` |
| **SCL / SCLK** | **GPIO8** | шина I²C платы, `ESP_I2C_SCL` |
| **ANT** | антенна | около 1 м для УКВ, коаксиалом |
| **L / R** | зависит от варианта в §2.5 | единственный открытый пункт |

**Шина I²C годится как есть.** Проверено по схеме 2026-08-27: подтяжки
**R49 и R50 по 2,2 кОм к `ESP_3V3`** уже стоят на плате, то есть шина
**трёхвольтовая** и своих резисторов подтяжки ставить не надо. Адреса
тюнера `0x10` и `0x11` не конфликтуют с GT911 (`0x5D`/`0x14`),
ES8311 (`0x18`) и ES7210 (`0x40`).

**Свою шину I²C заводить нельзя — не по стилю, а по бюджету выводов.**
Отдельная шина съела бы ещё две линии из восемнадцати свободных, а нужно
уже семнадцать. Штатная шина выведена на гребёнку именно для этого,
и другого варианта бюджет не оставляет.

#### Бюджет выводов: вариант C по звуку в него не влезает

Пересчёт с учётом поправок от 2026-08-27:

| Что | Линий |
|---|---|
| Кнопки пресетов | 8 |
| Энкодер 1: A, B, кнопка | 3 |
| Энкодер 2: A, B, кнопка | 3 |
| Кнопка MODE | 1 |
| Кнопка питания | 1 |
| Приглушение нашего TPA3118 (вход SD) | 1 |
| **Итого** | **17** |

Свободно **18**. Пока сходится.

Но **вариант C** из §2.5 — свой ЦАП по I²S — требует вывести на гребёнку
ещё **BCLK, LRCK и DOUT**, то есть **плюс три линии**. Итого 20 против 18.
**Не влезает.** (MCLK, скорее всего, не нужен: PCM5102A умеет получать
тактирование из BCLK внутренней ФАПЧ — **[не подтверждено]**, сверить
с даташитом.)

Отдельно: `PA_CTRL` штатного усилителя сидит на **GPIO53**, а он
**на гребёнку не выведен**. Это не проблема — держать NS4150B выключенным
можно прямо из прошивки, вывод наружу для этого не нужен.

#### Три выхода из конфликта

| Путь | Кнопок пресетов | Чем платим |
|---|---|---|
| **Вариант B** (врезка на `PA_INL±`) | **8** | пайка к двум площадкам 0201 и пересчёт сумматора под дифференциальный вход |
| **Вариант C + меньше кнопок** | **6** (18 линий ровно) или 5 (запас 1) | заказчик 2026-08-26 сказал, что число некритично |
| **Вариант C + расширитель портов** | **8** | лишняя микросхема MCP23017 на той же шине I²C плюс одна линия прерывания |

Третий путь стоит пояснить: расширитель возвращается **не потому, что
не хватает выводов под кнопки**, а чтобы освободить место под I²S. Восемь
кнопок уходят на расширитель, взамен тратится одна линия прерывания — итого
десять линий вместо семнадцати, и три линии I²S помещаются свободно.
Адрес расширителя `0x20–0x27` с тюнером и платой не конфликтует, а шина
и подтяжки уже есть.

**Рекомендую третий путь**, если подтвердится маршрутизация I²S на
произвольные выводы (§2.5). Он даёт и чистый звук по уже посчитанной
схеме, и восемь кнопок без ухищрений. Если маршрутизация не подтвердится —
остаётся вариант B с восемью кнопками и пайкой к 0201.

### 2.7. Ограничения по выводам: strapping и пробуждение из сна

**[добавлено 2026-08-27]** Два ограничения, которые раньше стояли как
непроверенные, закрыты по даташиту ESP32-P4 (v0.7) и документации esptool.

#### Strapping-выводы

Даташит, раздел 3 «Boot Configurations», таблица 3-1:

| Вывод | Что задаёт | Состояние по умолчанию |
|---|---|---|
| **GPIO34** | источник сигналов JTAG | не подтянут |
| **GPIO35** | режим загрузки чипа | слабая подтяжка вверх (=1) |
| **GPIO36** | режим загрузки + вывод сообщений ПЗУ | не подтянут |
| **GPIO37** | режим загрузки | не подтянут |
| **GPIO38** | режим загрузки | не подтянут |

Важная деталь оттуда же: у всех strapping-выводов есть защёлки, которые
считывают уровень при сбросе и хранят его до выключения, **«и далее выводы
освобождаются для использования как обычные IO»**. То есть strapping-вывод
не запрещён к применению — ограничение только на уровень **в момент сброса**.

Из нашего списка свободных под это попадает **только GPIO34**: GPIO35, 37
и 38 уже исключены как занятые платой, GPIO36 на гребёнку не выведен.

Кнопка на GPIO34 при нажатии в момент включения переключила бы источник
JTAG. Не смертельно — тем более что соответствующий бит eFuse по умолчанию
не прошит, — но при нашем нулевом запасе по выводам лучше держать GPIO34
в резерве, а не занимать кнопкой.

#### Пробуждение из deep sleep — только LP-домен

Документация ESP-IDF: «Only GPIOs powered by the VDD_LP power domain can be
used as Deep-sleep GPIO wakeup sources», а конкретный список — в даташите.
Разобрана сводная таблица выводов (приложение A):

> **LP-домен, то есть способные будить из сна: GPIO0 … GPIO15.** Всего 16.
> Всё остальное, GPIO16 … GPIO54, питается от доменов VDD_IO_0, VDD_IO_4,
> VDD_IO_5 и VDD_IO_6 и **будить не умеет**.

Наложение на наши восемнадцать свободных выводов даёт жёсткий вывод:

| Вывод | Домен | Пригодность |
|---|---|---|
| **GPIO3** | VDD_LP/VDD_BAT | **будит из сна** |
| **GPIO4** | VDD_LP | **будит из сна** |
| **GPIO5** | VDD_LP | **будит из сна** |
| GPIO21, 22 | VDD_IO_0 | обычный ввод-вывод |
| GPIO28–32, 34 | VDD_IO_4 | обычный ввод-вывод (34 — ещё и strapping) |
| GPIO46–48 | VDD_IO_5 | обычный ввод-вывод |
| GPIO49–52 | VDD_IO_6 | обычный ввод-вывод |

**Кнопка питания обязана сидеть на GPIO3, GPIO4 или GPIO5** — других
вариантов на гребёнке нет. Это не пожелание, а свойство кремния.

Побочно: GPIO2–GPIO5 несут альтернативные функции JTAG (MTCK, MTDI, MTMS,
MTDO), а выбор источника JTAG задаёт как раз GPIO34. Заняв GPIO3–GPIO5
кнопками, мы отказываемся от отладки через выводы в пользу отладки через
USB — она и стоит по умолчанию, бит eFuse не прошит. Для нас это приемлемо.

#### Что это меняет в бюджете

Число свободных выводов не изменилось — **восемнадцать**. Изменилось
распределение: три из них теперь «именные», и один нежелателен.

| Конфигурация | Нужно | Влезает |
|---|---|---|
| 8 кнопок + I²S, без расширителя | 20 | нет |
| **6 кнопок + I²S, без расширителя** | 18 | **только заняв strapping-вывод GPIO34** |
| 8 кнопок на расширителе + I²S | 11 | да, с запасом в семь линий |

То есть ответ на вопрос «поможет ли уменьшение до шести кнопок» стал
точнее: **поможет, но ценой занятия strapping-вывода**, и запас при этом
остаётся нулевым. Раньше выглядело так, будто шесть кнопок просто влезают.

## 3. Программная платформа и требования к коду

**Решено 2026-08-26: прошивка пишется с нуля**, не на базе
`schreibfaul1/ESP32-MiniWebRadio`. Следствия:

- список станций — просто наш файл, чужого формата обходить не надо.
  Решение по Q13 о проекции `/stations.json` этим **отменяется**
  ([25](25-station-storage.md), §10);
- предел в 999 станций, четырёхполевой формат и особенности чужого парсера
  перестают быть ограничениями;
- **но приём потока и декодирование ложатся на нас.**

**Оговорка по «с нуля».** Писать декодеры mp3, aac, opus, vorbis и flac
руками нереалистично и здесь не имеется в виду. «С нуля» означает **своё
приложение на готовом звуковом тракте**. Своими остаются приложение,
интерфейс, эфирный тракт, хранение и вся логика; чужими — приём потока
и кодеки.

**Решено 2026-08-26: звуковой тракт берём из ESP-ADF.** Официальный
аудиофреймворк Espressif **поддерживает ESP32-P4** — подтверждено по README
репозитория `espressif/esp-adf`, где P4 назван в списке поддерживаемых SoC.
Даёт MP3, AAC, FLAC, WAV, OGG, OPUS, источники HTTP и HLS, и прямо называет
Internet Radio среди сценариев. Ближайшие примеры — `pipeline_http_mp3`
и особенно `pipeline_http_select_decoder`: выбор декодера по типу потока,
без которого часть станций играть не будет.

Условия, которые ADF накладывает: ветка **`release/v2.x`** (master с ней
несовместим), ESP-IDF подключён подмодулем с закреплённой версией и
**патчится** каталогом `idf_patches`, то есть версию IDF выбирает ADF,
а не мы. Разбор и грабли — [27](27-reference-sheet.md), §1.1.

**Первая проверка, до всего остального:** собрать `pipeline_http_mp3` под
нашу плату и получить звук. ADF писался под чипы с собственным радио, а у нас
Wi-Fi через сопроцессор; стык ADF с `esp_wifi_remote` **[не подтверждено]**
и обесценивает или подтверждает весь этот выбор. Предпосылка благоприятная:
`esp_wifi_remote` предоставляет приложению стандартный API `esp_wifi` поверх
транспорта сопроцессора, так что ADF видит обычный Wi-Fi (документация
esp-hosted-mcu). **[добавлено]** Два условия совместимости: компонент
`esp-extconn` из проекта удалить (несовместим с esp_hosted) и версии
host/slave компонентов держать синхронными.

**[добавлено 2026-08-26]** С версии ADF v2.7 `user_agent` в `http_stream`
настраивается штатно — требование Radio-Browser о «внятном User-Agent» (§4)
выполняется конфигурацией, без патчей.

- **Фреймворк:** ESP-IDF, актуальная стабильная ветка 5.x, FreeRTOS.
- **GUI:** LVGL 9.x поверх собственного дисплейного порта (§2.1).
- Язык: C, для отдельных модулей допустим C++.
- Комментарии и документация в коде — на русском.
- Модульная структура компонентов ESP-IDF: `fm_tuner` (RDA5807M),
  `net_radio` (HTTP и ICY-поток, декодирование), `audio` (I²S, ES8311,
  громкость и mute), `storage` (SD, файлы), `ui` (LVGL), `input` (энкодеры,
  кнопки, очередь событий), `net` (Wi-Fi через C6, DHCP, NTP, Radio-Browser).
- Весь ввод — через единую очередь событий FreeRTOS; программный антидребезг
  с параметрами, вынесенными в конфигурацию.
- Поддержка одинарного, двойного и длинного нажатия (§6.1).
- Конфигурация через Kconfig: пины, параметры сети, NTP, таймауты.

**[добавлено] Один владелец состояния.** Режим, станция, частота, громкость
и mute живут в одном месте — конечном автомате. Остальные компоненты его
читают, а меняют только отправкой сообщения в очередь. Двух копий истины быть
не должно. Это требование, а не рекомендация: из него прямо следует поведение
громкости и пресетов (§6.2, §6.3).

**[добавлено] Wi-Fi идёт через сопроцессор.** У ESP32-P4 нет ни Wi-Fi,
ни Bluetooth. На плате их обслуживает ESP32-C6 по SDIO. Исполнителю учесть
это в компоненте `net` (esp_wifi_remote / esp_hosted), предусмотреть время
инициализации сопроцессора при старте и обработку его недоступности.

**[добавлено] PSRAM.** Буфер потока и рабочая память декодера живут в PSRAM.
Проверять её наличие и объём при старте, при нехватке деградировать
предсказуемо, а не падать.

### 3.1. Как прошивка запускается

**[добавлено]** На ESP32 нет операционной системы, нет служб и нет списка
автозапуска. **Прошивка и есть приложение**: в флеш-памяти лежит ровно одна
программа, и она стартует сама. Добавлять что-либо в автозапуск не нужно,
потому что запускать больше нечего.

Цепочка старта:

1. ROM-загрузчик в кристалле;
2. второй загрузчик из ESP-IDF — читает таблицу разделов и выбирает раздел
   приложения;
3. приложение стартует, ESP-IDF поднимает FreeRTOS и вызывает `app_main()`;
4. в `app_main()` создаются наши задачи, дальше прибор живёт ими.

Подали питание — работает. Это и есть «автозапуск».

Что действительно проектируется — **таблица разделов** (`partitions.csv`):

| Раздел | Зачем |
|---|---|
| `nvs` | настройки, которые должны пережить обновление прошивки |
| `phy_init` | калибровочные данные радиотракта |
| `ota_0`, `ota_1` | две копии приложения, нужны для обновления по воздуху |
| `otadata` | какая из копий активна |

Карта microSD в таблице разделов не участвует — это отдельный носитель
со своей файловой системой.

### 3.2. Порядок инициализации

**[добавлено]** Порядок подчинён одному требованию: **эфир не ждёт сеть.**

1. Базовое железо: тактирование, I²C, карта.
2. Панель и LVGL — **как можно раньше**, чтобы показать заставку, а не чёрный
   экран на всё время подъёма остального.
3. Чтение сохранённого состояния: последний режим, станция, громкость.
4. Если последний режим эфирный — тюнер поднимается за миллисекунды, звук
   появляется почти сразу.
5. Параллельно и не блокируя пункты выше: инициализация сопроцессора C6,
   Wi-Fi, DHCP, NTP.
6. Если последний режим интернет — воспроизведение начинается после
   подключения и наполнения буфера; до этого на экране «подключение»,
   а не тишина без объяснений.

## 4. Сеть

- Wi-Fi STA, DHCP-клиент.
- Автоматический реконнект с отображением статуса в интерфейсе.
- NTP-клиент (`pool.ntp.org`), при недоступности — ручная установка (§5.3.3.2).

**[добавлено] Правила обращения к Radio-Browser**, из документации сервиса:

- список зеркал берётся **через DNS**: A-записи `all.api.radio-browser.info`
  либо SRV-запись `_api._tcp.radio-browser.info`; сервер выбирается
  **случайно**, при отказе — переключение на другой;
- **обязателен внятный `User-Agent`** вида `ipradio/0.1` — требование
  документации сервиса; в ESP-ADF настраивается штатно (§3);
- **[добавлено]** поле `country` в ответах API устарело — использовать
  **`countrycode`** (явное указание документации сервиса); идентификатор
  станции — `stationuuid`;
- ключа и регистрации не требуется, лимиты не документированы;
- при запуске станции полагается дёрнуть `/json/url/{stationuuid}` — это
  счётчик кликов каталога. Вежливость, не обязанность.

Основные запросы: `/json/stations/byname/…`, `/json/stations/bytag/…`,
`/json/stations/bycountrycodeexact/XX?hidebroken=true`,
`/json/stations/search?…`, справочники `/json/countries`, `/json/tags`.

**[добавлено] Каталог не является источником истины.** Radio-Browser
используется **только как поисковик**. Найденная станция сохраняется в базу
прибора, и дальше прибор играет из своей базы: интернет нужен для потока,
а не для каталога. Кэш результатов поиска — одноразовый, при повреждении
просто удаляется, атомарности не требует. В оперативную память его класть
нельзя: прибор гасят питанием, и кэш терялся бы ровно тогда, когда нужен.

## 5. Глобальные режимы работы

Три основных режима и один ждущий.

### 5.1. Режим «Эфир»

#### [РЕШЕНИЕ ЗАКАЗЧИКА 2026-08-28] УКВ пока не делаем

Работы хватает и без него; вернуть решено потом, если понадобится.

**Диапазон не вырезан из кода, а выключен.** Тюнер умеет оба — коды
диапазона и шага пишутся в регистр 03H, это уже написано и работает.
Удалять рабочий код, чтобы через месяц писать заново, — плохой размен.
Выключено ровно то, что торчит наружу: выбор диапазона, подписи
и перестройка по сетке УКВ.

Выключатель один: `IPRADIO_ENABLE_OIRT` в `firmware/main/ipradio_state.h`.
Чтобы вернуть — поставить единицу и добавить орган переключения
на экране настройки эфира. Больше ничего.

Одна тонкость, из-за которой чтение диапазона из файла настроек
пришлось обойти: в `ipradio.json` может лежать `last_band = УКВ`
от сборки, где он был включён. Прочитав его при выключенном УКВ,
приёмник встал бы на частоту, которой в FM не существует. Поэтому
при `IPRADIO_ENABLE_OIRT = 0` диапазон всегда CCIR, что бы ни лежало
в файле.

Ниже — исходное требование, оно остаётся в силе на будущее.

**[исправлено] Диапазонов два, а не один.** Требование R1.1 проекта:

| Диапазон | Границы | Состояние |
|---|---|---|
| **УКВ OIRT** | 65,8–74 МГц | **отложен 2026-08-28** |
| FM CCIR | 87,5–108 МГц | делаем |

**[добавлено 2026-08-26] На экране диапазоны подписываются коротко — «УКВ»
и «FM», без OIRT и CCIR.** Решение заказчика по итогам просмотра образцов
экранов ([28](28-screen-mockups.md)). Стандартные обозначения остаются
в документации: пользователю они ничего не говорят, а место на экране
занимают. Это относится и к переключателю диапазона в §5.3.1.

В черновике ТЗ был указан только 87,5–108. RDA5807M перекрывает оба штатно:
регистр `BAND=3` даёт 65–76 МГц (дополнительно бит `65M_50M MODE` в регистре
07H). Питание чипа **2,7–3,3 В, 5 В подавать нельзя**. Автопоиск аппаратный —
SEEK вверх и вниз с порогом по уровню (`SEEKTH[3:0]`), то есть делается
командой в чип, а не перебором частот в коде. RDS в чипе есть: регистр 0AH,
флаги `RDSR` (группа готова) и `RDSS` (декодер синхронизирован).

**[добавлено 2026-08-26] из даташита RDA5807M:**

- бит `DMUTE` (регистр 02H, бит 14) имеет **инверсную логику**: 0 — mute,
  1 — нормальная работа; учесть в драйвере;
- при `VOLUME=0000` выход не просто тихий, а переходит в **высокоимпедансное
  состояние** — на пользу схеме пассивной суммации (§2.2): «заглушённый»
  тюнер почти отключён от сумматора;
- есть бит `DHIZ` (регистр 02H, бит 15) — принудительный Hi-Z выхода.

- Главный экран: название станции крупно по центру (из RDS); если названия
  нет — только частота. Время мелко в левом верхнем углу.
- Энкодер 1 — перебор сохранённых станций. Энкодер 2 — громкость,
  его кнопка — Mute.

### 5.2. Режим «Интернет-радио»

- Пресеты, сохранённый список, поиск по Radio-Browser, сохранение найденного.
- Главный экран: название станции крупно (из базы или из ICY-метаданных),
  время мелко в левом верхнем углу.
- Энкодер 1 — перебор станций. Энкодер 2 — громкость, кнопка — Mute.
- Буферизация потока и восстановление воспроизведения при обрывах сети.

**[добавлено 2026-08-26] Поведение, когда сети нет.** «Нет Wi-Fi» —
это три разных состояния, и обходятся с ними по-разному:

Уточнено заказчиком 2026-08-26, поведение у трёх состояний **разное**:

| № | Состояние | Кнопка MODE | Что на экране |
|---|---|---|---|
| 1 | Сеть **не настроена** | не переключает, а **приглашает настроить** | «Wi-Fi ещё не настроен» + кнопка «Настроить Wi-Fi», ведущая прямо в настройку сети, и «Не сейчас» |
| 2 | Настроена, **связи нет** | **не переключает**, выдаёт предупреждение | «Нет связи с сетью *имя*», идёт переподключение. В настройки **не ведём** — связь, скорее всего, вернётся сама |
| 3 | Связь есть, **станции нет** | — (мы уже в интернет-режиме) | «Станция не отвечает», прямо сказано, что дело в станции, а не в сети; сразу предлагаются другие станции, включая эфирную |

Общие правила:

1. **Переключение в интернет-режим блокируется**, пока сеть недоступна.
   Экраны 10–12 в [28](28-screen-mockups.md) показывают все три случая.
2. **NET-ячейки пресетов гаснут заранее** и получают значок перечёркнутого
   Wi-Fi. Недоступность видна **до** нажатия, а не после — нажатие не должно
   отвечать тишиной.
3. **Прибор ни в одном из случаев не замолкает.** Диалог показывается поверх
   играющего эфира, и на нём прямо написано, что эфир не прерывался. Иначе
   человек решит, что сломалось всё, а не только интернет.
4. **При старте**, если последняя станция была интернетная, а сеть за 15 секунд
   не поднялась — включается последняя эфирная станция и мелко пишется
   «интернет недоступен, играет эфир». Радио, молчащее после включения,
   выглядит неисправным. Самовольно переключаться обратно, когда сеть
   появится, **нельзя** — решение уже показано пользователю.
5. Как только связь появилась, кнопка MODE и NET-ячейки **работают снова**
   без каких-либо действий пользователя.

**[добавлено] Переход «эфир → интернет» не мгновенный.** Перестройка тюнера —
запись в регистр по I²C, единицы миллисекунд. Запуск потока — разрешение
имени, TCP-соединение и наполнение буфера, то есть секунды. Требования:

- Wi-Fi держится подключённым постоянно, в том числе пока играет эфир;
- задача плеера не выгружается при уходе в эфирный режим;
- на экране показывается «буферизация», а не молчание;
- обратный переход практически мгновенный, дополнительных мер не требует.

### 5.3. Режим настройки (меню)

Навигация: энкодер 1 — перемещение, кнопка энкодера 1 — вход в пункт,
кнопка энкодера 2 — выход на уровень вверх.

#### 5.3.1. Настройка эфирных станций

- На экране шкала диапазона. **[исправлено]** Диапазон переключается
  (УКВ или FM), шкала рисуется по текущему.
- Энкодер 1 — плавная перестройка; кнопка энкодера 1 — автопоиск по всему
  диапазону с сохранением найденного в банк пресетов.
- После автопоиска — предложение подписать станции без RDS-названия: список
  найденного, энкодер 1 выбирает, кнопка входит в редактирование, экранная
  клавиатура; крутилка выбирает букву, кнопка вводит, **двойное нажатие
  сохраняет**.

**[добавлено]** Пользовательское имя станции и RDS-имя хранятся **раздельно**,
чтобы показывать «как в эфире» и «как назвал пользователь» по отдельности.

#### 5.3.2. Поиск и настройка интернет-станций

Поиск по каталогу (название, жанр, страна), добавление в список и пресеты.
**[исправлено]** Формат хранения задан в §8 и в проектировании не нуждается —
в черновике он был оставлен исполнителю.

#### 5.3.3. Системные настройки

- **5.3.3.1. Wi-Fi:** сканирование, список сетей (энкодер 1 — навигация,
  кнопка — выбор), ввод пароля экранной клавиатурой (русская, английская,
  спецсимволы), сохранение, выход кнопкой энкодера 2.
- **5.3.3.2. Часы:** по умолчанию NTP. Ручной режим — время, часовой пояс,
  дата; формат 24 часа по умолчанию, переключаемый на AM/PM.
- **5.3.3.3. Яркость дисплея** в процентах.
- **5.3.3.4. Редактирование списка станций:** переименование, удаление,
  правка пресетов обоих режимов.
- **5.3.3.5. Состояние прибора [добавлено].** Экран диагностики без
  подключения к компьютеру: IP и уровень сигнала Wi-Fi, состояние карты,
  наличие внешнего питания и заряд батареи, версия прошивки, последняя ошибка.

### 5.4. Ждущий режим

- Вход: 3 минуты без нажатий, поворотов и касаний.
- Часы во весь экран, яркость принудительно 50 %.
- Любое действие возвращает экран играющей станции; воспроизведение
  не прерывается.

## 6. Органы управления

### 6.1. Сводная таблица

**[исправлено]** Кнопка MODE работает в обоих режимах воспроизведения,
а не только в эфирном.

| Орган | Эфир | Интернет | Меню |
|---|---|---|---|
| Энкодер 1, вращение | перебор сохранённых станций | перебор станций | навигация; перестройка частоты; выбор букв; настройка часов и яркости |
| Кнопка энкодера 1 | коротко — ОК и играть, длинно — вход в меню | то же | вход в пункт; автопоиск; ввод буквы; двойное — сохранить |
| Энкодер 2, вращение | громкость | громкость | громкость, глобально |
| Кнопка энкодера 2 | Mute вкл/выкл | Mute вкл/выкл | выход на уровень вверх |
| Кнопка MODE | переход в интернет на последнюю игравшую станцию | переход в эфир на последнюю частоту | — |
| Кнопки пресетов | вызов пресета; длинное нажатие — записать текущую станцию | то же | — |
| Кнопка питания | вкл/выкл | вкл/выкл | вкл/выкл |

Предлагаемые тайминги, уточняются на макете: короткое нажатие — до 400 мс,
двойное — два коротких с паузой между ними до 350 мс, длинное — от 700 мс.

**[исправлено]** В черновике вход в меню был у кнопки энкодера 1 без
различения длительности, при том что короткое нажатие уже занято выбором.
Разведено: коротко — ОК, длинно — меню.

### 6.2. Пресеты: один банк на оба режима

**[исправлено]** В черновике было «на кнопки сохраняются станции 1–3 при
шести кнопках или 1–4 при восьми» — это противоречит и самому себе,
и назначению кнопок.

Принятое решение проекта: **один банк ячеек, тип хранится в самой записи.**

```json
{"n": 1, "type": "fm",  "band": "ccir", "freq_khz": 102500, "name": "Retro FM"}
{"n": 2, "type": "net", "url": "http://...", "name": "Radio Record"}
```

Нажатие пресета делает две вещи: выставляет режим по полю `type` и запускает
станцию. **Пресет сам переключает прибор между эфиром и интернетом** — именно
поэтому физического переключателя режимов в приборе нет, а есть кнопка MODE.

Число кнопок — 6 или 8, по числу свободных выводов **[не подтверждено]**.
Заказчик 2026-08-26: вопрос не критичный, решается по ходу, докупить кнопки
не проблема. Поэтому число кнопок **не должно быть зашито в логику** —
только в конфигурацию.
Размер банка от числа кнопок **не зависит**: банк может быть больше, а кнопки
адресуют первые N ячеек; остальные доступны плитками на экране и перебором
энкодером. Скрытых вторых функций у кнопок пресетов быть не должно —
запрещено вешать ячейки 7 и 8 на долгое нажатие кнопок 1 и 2, это прямо
противоречит R4.1.

### 6.3. Громкость и Mute

**[добавлено]** Громкость — **одно логическое значение 0–100** в конечном
автомате плюс поправка, своя для каждого режима. При смене режима значение
перекладывается на активный механизм:

| Режим | Чем регулируется физически |
|---|---|
| Эфир | регистр 05 тюнера RDA5807M, поле `VOLUME` |
| Интернет | микшер программного тракта или кодек |

Без этого громкость скачет при нажатии пресета другого типа, потому что
у двух трактов оказываются разные значения.

**У эфирной громкости 16 ступеней, и это потолок.** Поле `VOLUME` — 4 бита,
`0000` минимум, `1111` максимум. В аналоговом тракте тюнера программной
ступени нет, поэтому больше ступеней взять негде. Принято как рабочий
вариант, пересматривается по результатам эксплуатации. Энкодер даёт
20 импульсов на оборот — сколько щелчков приходится на ступень, подбирается
на макете. **[исправлено 2026-08-26]** Форма шкалы тюнера подтверждена
даташитом: **логарифмическая** («Volume scale is logarithmic», даташит
RDA5807M). Кривая пересчёта и согласование с кривой интернет-тракта считаются
от логарифмической шкалы, чтобы ручка ощущалась одинаково в обоих режимах.

**Mute — это отдельный бит, а не громкость в ноль.** У RDA5807M для этого
есть свой бит. В схеме с пассивной суммой оба источника постоянно связаны
электрически, и работоспособность держится на том, что неактивный источник
заглушён по-настоящему. Выход из Mute возвращает прежний уровень — значение
не теряется.

**[добавлено 2026-08-26] Индикация Mute.** Значок динамика в статусной строке
становится **красным и перечёркнутым**, число громкости — зачёркнутым. Плюс
крупная плашка «ЗВУК ВЫКЛЮЧЕН» по центру экрана: значка 22 пикселя в углу
пользователю, ради которого заведено R4.1, недостаточно. Воспроизведение при
этом **не прерывается** — поток идёт, тюнер настроен; отключён только звук.

**[добавлено 2026-08-26] Поворот энкодера 2 снимает Mute** и сразу выставляет
новый уровень. Альтернатива — менять уровень молча, оставаясь в Mute — отклонена:
пользователь крутит ручку, ничего не происходит, он крутит дальше, и при снятии
Mute получает неожиданно громко.

### 6.4. Кнопка питания

**Решено 2026-08-26: удержание кнопки переводит прибор в deep sleep.**
Внешний фиксирующий ключ, снимающий питание, не делаем. Кнопка — своя,
на GPIO, на лицевой панели. Штатная кнопка POWER платы (длинное нажатие 2 с —
аппаратное выключение) находится **внутри корпуса, в пользовательских
сценариях не участвует** и остаётся сервисной: аварийное полное
обесточивание при вскрытии (§2). При сборке убедиться, что штатная цепь
питания не мешает пробуждению от внешней кнопки.

Перед уходом в сон:

- остановить воспроизведение и приглушить усилитель по линии SD у TPA3118;
- погасить подсветку панели;
- сохранить состояние (§8, §9);
- настроить пробуждение по кнопке питания.

**Особенность, которую надо заложить в код:** выход из deep sleep — это
**не продолжение с места остановки**. Выполнение начинается заново
с `app_main()`, переживают только RTC-память и NVS. То есть путь «проснулись»
и путь «подали питание» — один и тот же, различаются лишь причиной
пробуждения (`esp_sleep_get_wakeup_cause()`). Отдельной ветки «возобновить
работу» писать не нужно; нужно быстро восстанавливать состояние — §3.2.

**[не подтверждено]** Ток в deep sleep на этой плате микроамперным не будет:
рядом висят DSI-панель, сопроцессор C6 и карта. Сколько они потребляют
в этом режиме и можно ли их обесточить, по схеме неизвестно — меряется
на плате. Если «выключенный» прибор будет заметно есть, вопрос внешнего
ключа питания придётся открыть заново.

## 7. Пользовательский интерфейс

- Язык интерфейса — русский, все надписи и сообщения.
- Стиль Material Design: цветовая схема, экраны-списки, AppBar со статусом
  (Wi-Fi, время). **[добавлено]** Опираться на готовый фреймворк
  **ESP-Brookesia** (Android-подобный UI поверх LVGL от Espressif): в примерах
  платы есть `esp_brookesia_phone`, демонстрирующий Android-подобный интерфейс
  именно на этом железе. С нуля стилизацию не рисовать без необходимости.
- **Экранная клавиатура** в стиле Android: русская раскладка по умолчанию,
  переключение на английскую, спецсимволы. Управляется **и энкодером 1,
  и пальцем одновременно** — по R4.1.
- Кириллические шрифты LVGL подключить или сгенерировать, способ указать.

**[добавлено]** Раскладка проектируется под **альбомную** ориентацию;
рабочее разрешение после поворота — 1280×720.

**[добавлено]** Крупный шрифт названия станции — не декоративное пожелание,
а требование к читаемости с расстояния для пожилого пользователя. То же
относится к элементам списков и к экранным кнопкам.

## 8. Хранение данных

Всё на microSD, человекочитаемым JSON.

**[добавлено] Один файл — источник истины**, `/ipradio.json`. Прошивка своя
(§3), поэтому чужой формат не поддерживается и проекция не нужна:

| Раздел | Содержимое |
|---|---|
| `presets` | банк ячеек, каждая с полем `type` (`fm` или `net`), см. §6.2 |
| `stations` | интернет-станции: `name`, `url`, `countrycode` **[исправлено]** — поле `country` в API Radio-Browser устарело (§4), `stationuuid`, `codec`, `bitrate`, `last_verified`, `source` (`radiobrowser` / `manual` / `import`); пользовательское имя отдельно от каталожного |
| `fm_stations` | эфирные: диапазон, частота, RDS-имя, пользовательское имя |
| `settings` | сети Wi-Fi и пароли, часовой пояс, формат времени, яркость, последний режим и станция, громкость |

`stationuuid` хранится ради двух вещей: отметить клик в каталоге и
**подтянуть новый URL, когда вещатель его сменил**.

Правила записи:

- запись **атомарная**: временный файл, сброс на носитель, переименование;
- при отсутствии или повреждении файла создаётся дефолтный, прибор
  поднимается с пустым списком, а не отказывается стартовать;
- кэш результатов поиска — отдельным файлом, одноразовый, атомарности
  не требует;
- имена станций **санитизируются** при записи: кавычки и переводы строк
  из них вычищаются.

**[не подтверждено]** Что гарантирует драйвер FAT в ESP-IDF при пропадании
питания в момент записи и является ли переименование атомарным — не
установлено. Исполнителю не полагаться на это как на данность: предусмотреть
**две копии по очереди с контрольной суммой** и выбор исправной при старте.

## 9. Нефункциональные требования

- Watchdog; корректная работа без карты, без сети, без RDS.
- Отзывчивость интерфейса; **звук не прерывается при навигации по меню**
  и при перерисовке экрана.
- После подачи питания: автоматический вход в последний режим,
  автоподключение к сохранённой сети, воспроизведение последней станции.

**[добавлено] Питание и сохранность данных.** В штатный разъём платы ставится
литиевая батарея, чтобы снятие внешнего питания не обрывало запись на карту.
Батарея сама по себе задачу не решает: прибор должен **узнавать о пропадании
внешнего питания** и по этому признаку прекращать запись и предупреждать
на экране. Наличие такой линии на плате **[не подтверждено]**, выясняется
по факту. Усилитель питается от внешних 12 В и на батарее не работает —
речь только о сохранности данных.

## 10. Критерии приёмки

1. Проект собирается ESP-IDF без ошибок под ESP32-P4.
2. Режимы и ждущий режим работают по §5; органы управления соответствуют §6.
3. Эфир: приём **обоих диапазонов**, RDS-названия, автопоиск, запись пресетов.
4. Интернет: поиск в Radio-Browser, воспроизведение, сохранение пресетов.
5. Пресет с записью другого типа **сам переключает режим**, без кнопки MODE.
6. Громкость не скачет при переходе между режимами.
7. Все настройки переживают перезагрузку и снятие питания.
8. Интерфейс полностью на русском, клавиатура с переключением раскладок,
   и каждый сценарий проходим **без касания экрана**, кроме ввода длинных строк.

## 11. Что осталось решить

1. Схема коммутации звука — по §2.2, в зависимости от наличия аналогового
   входа ES8311. **[исправлено]** Проверяется **заранее по схеме платы**
   из репозитория Waveshare, до получения железа.
2. Финальная распиновка и число кнопок пресетов — по остатку свободных
   выводов. Если их не хватает, расширитель портов по I²C (диапазон адресов
   `0x20–0x27` с тюнером не конфликтует). **[добавлено]** Уже заняты платой:
   I²C — GPIO7 (SDA) и GPIO8 (SCL), I²S — GPIO9–13, включение штатного
   усилителя `PA_Ctrl` — GPIO53; на шине I²C висят GT911 (0x5D/0x14) и
   ES8311 (0x18) — тюнер 0x10/0x11 и расширитель 0x20–0x27 с ними
   не конфликтуют.
3. Тайминги короткого, двойного и длинного нажатия — уточнить на макете.
4. ~~Библиотека декодирования~~ — **решено:** ESP-ADF (§3). Осталось
   подтвердить его совместимость с Wi-Fi через сопроцессор.
5. Стратегия восстановления потока при обрыве сети: сколько попыток,
   с какими паузами, когда показывать ошибку.
6. Схема питания внешнего усилителя — за заказчиком.
7. Потребление в deep sleep и нужен ли внешний ключ питания (§6.4).
8. **[добавлено 2026-08-26] Ревизия кристалла ESP32-P4.** Свежие ESP-IDF
   по умолчанию поддерживают только ревизии ≥3.1; для rev1.x нужны особые
   настройки SDK. Определить ревизию на своём экземпляре при первом запуске.

   **[уточнено 2026-08-27]** У вендора платы для этого есть два готовых
   профиля, `sdkconfig.defaults.rev1_3` и `sdkconfig.defaults.rev3_x`
   (пример `04_wifistation`). Оба скопированы к нам в `firmware/`.
   Что в них:

   | Ключ | rev1.x | rev3.x |
   |---|---|---|
   | `CONFIG_ESP32P4_SELECTS_REV_LESS_V3` | `y` | `n` |
   | `CONFIG_ESP32P4_REV_MIN_*` | `_100=y` | `_300=y` |
   | `CONFIG_SPIRAM_SPEED` | **200** | **250** |

   **Главное отсюда: скорость PSRAM зависит от ревизии кристалла.**
   Это объясняет расхождение, на которое я едва не наступила: в наборе
   ADF стоит 200 МГц, у Waveshare — 250. ADF выбрал консервативное
   значение, работающее на обеих ревизиях. Ставить 250 на rev1.x нельзя.

   До определения ревизии собирать по профилю **rev1_3**.

**Закрыто 2026-08-26:** прошивка пишется с нуля (§3), кнопка питания
переводит в deep sleep (§6.4), внешний усилитель ставим (§2.2), число
кнопок пресетов уходит в конфигурацию (§6.2). Штатная кнопка POWER платы —
внутри корпуса, сервисная (§2, §6.4).

**Закрыто проверкой по документации 2026-08-26:** драйвер дисплея и BSP
готовы — порт не пишется (§2.1); параметры панели и тача известны (§2.1);
шкала громкости тюнера логарифмическая по даташиту (§6.3); уровень «2,1 В
у ЦАП» относился к удалённому PCM5102A и пересчитывается под ES8311 (§2.2).
