Spok1978/hybrid-radio/docs/02-fm-frontend.md

# 02. Приёмный тракт УКВ/FM (режим 1)

Задача: R1.1–R1.7. Диапазоны **УКВ OIRT 65,8–74 МГц** и **FM CCIR 87,5–108 МГц**,
автопоиск, индикация частоты, название станции, пресеты.

Строим из готовых модулей: собственный супергетеродин на россыпи не делаем —
современные однокристальные DSP-тюнеры дают лучше параметры и сразу отдают
цифровой интерфейс для автопоиска и RDS.

## 1. Важное про «название станции» — прочитать до выбора железа

Название станции в эфире передаётся службой **RDS**, поле PS (Programme Service,
8 символов), плюс RadioText. RDS — это поднесущая 57 кГц в стандартном
FM-вещании CCIR (87,5–108 МГц).

В диапазоне **УКВ OIRT** ситуация другая (это знание модели, требует проверки
приёмом на месте):

- стереовещание там исторически с **полярной модуляцией** (поднесущая 31,25 кГц),
  а не с пилот-тоном 19 кГц как в CCIR;
- RDS в этом диапазоне, как правило, **не передаётся**.

Из этого два практических следствия:

1. **В диапазоне 65,8–74 МГц названия станций из эфира взять, скорее всего,
   не получится.** Их придётся подписывать вручную при сохранении в пресет
   (или брать из локального справочника «частота → название» для города).
2. **Стерео в OIRT DSP-тюнер, скорее всего, не декодирует** — чипы рассчитаны
   на пилот-тон 19 кГц. Ожидать надо моно. Проверяется на макете за 10 минут.

Отдельно: OIRT-вещание в большинстве стран бывшего СССР уже выключено
(по сообщениям профильных форумов — в Азербайджане, Грузии, Казахстане,
Латвии, Литве, Узбекистане, Эстонии станций в 64–74 МГц нет). В России часть
станций ещё работала, но диапазон много лет сокращается. **Перед закупкой
стоит проверить, есть ли вообще что принимать в 65,8–74 МГц в твоём городе** —
иначе требование R1.1 выполняется формально (диапазон поддержан), но слушать
там будет нечего.

## 2. Кандидаты

### Вариант A — RDA5807M (модуль RRD-102V2.0 и аналоги)

Проверено по даташиту RDA5807M (RDA Microelectronics), регистр 03H:

```
Fin  FM Input Frequency Range (Adjust BAND Register)  50 … 115 MHz

03H  bits 3:2  BAND[1:0]  Band Select
     00 = 87–108 MHz (US/Europe)
     01 = 76–91  MHz (Japan)
     10 = 76–108 MHz (world wide)
     11 = 65–76  MHz (East Europe)  или 50–65 MHz
                (что именно — задаёт бит 9 регистра 07H)

     частота = BAND=0: SPACE × CHAN + 87,0 МГц
               BAND=1|2: SPACE × CHAN + 76,0 МГц
               BAND=3: SPACE × CHAN + 65,0 МГц
```

RDS/RBDS в чипе есть (регистр 0AH: `RDSR` — группа готова, `RDSS` —
декодер синхронизирован, есть FIFO-режим).

- Интерфейс: **I²C** (SCLK/SDIO), питание **2,7–3,3 В** — **5 В на модуль нельзя**.
  (Исправлено 2026-08-21: раньше здесь стояло «2,7–3,6 В» — это с описания
  на сайте-обзоре. Даташит на стр. 1 говорит «2.7 to 3.3 V operation voltage»,
  а таблица электрических параметров на стр. 5 — `VDD Supply Voltage 2.7 / 3.0 / 3.3 V`.
  Там же ток потребления: `IVDD ... ENABLE=1 20 mA`.)
- **Адреса на шине I²C: `0x10`** — последовательный доступ, сразу набор
  регистров, и **`0x11`** — доступ к одному заданному регистру. Взято из
  `src/RDA5807.h` библиотеки `pu2clr/RDA5807`, ветка master, прочитано
  2026-08-25: `I2C_ADDR_FULL_ACCESS 0x10`, `I2C_ADDR_DIRECT_ACCESS 0x11`.
  С диапазоном `0x20–0x27`, где сидят расширители портов, не пересекается.
- **Регистровые детали, важные для драйвера** (даташит RDA5807M, прочитано
  2026-08-26): диапазон УКВ включается `BAND=3` плюс бит `65M_50M MODE`
  в регистре 07H; порог автопоиска — поле `SEEKTH[3:0]`; бит `DMUTE`
  (регистр 02H, бит 14) **инверсный** — 0 это mute; при `VOLUME=0000` выход
  уходит в **высокоимпедансное состояние**, есть и отдельный бит `DHIZ`
  (02H, бит 15). Шкала громкости **логарифмическая**. Разбор последствий —
  [23](23-volume-control.md), §3.
- Автопоиск: аппаратный SEEK up/down с порогом по уровню — то есть R1.2
  делается одной командой в чип, а не перебором частот в коде.
- Выход: аналоговый звуковой, рассчитан на наушники; в линейный вход
  усилителя заводится через разделительные конденсаторы и делитель.
- Антенна: кусок провода ≈75 см (четвертьволновый на 100 МГц) на вывод
  антенны; для 65–74 МГц оптимальнее ≈1 м.
- Библиотека: `pu2clr/RDA5807` (Arduino/ESP32); регистры простые, в прошивке
  на ESP32-P4 работа с ними идёт напрямую по I²C.

Плюсы: самый дешёвый и распространённый, **штатно перекрывает оба диапазона**,
RDS есть, автопоиск аппаратный.

Минусы — формулировка уточнена 2026-08-21. **У самого чипа чувствительность
хорошая**: по даташиту (стр. 6) 1,2–1,5 мкВ при S/N = 26 дБ на 65 МГц и
1,3–1,5 мкВ на 108 МГц. Слабое место — не кристалл, а **конкретный дешёвый
модуль**: разводка, отсутствие входного фильтра и работа вплотную к цифровой
плате. Поэтому план «проверить на макете, при нехватке перейти на Si4735»
остаётся в силе, но причина — окружение, а не характеристики микросхемы.

### Вариант B — Si4735-D60 / Si4732-A10 (модуль «all band receiver»)

По данным библиотеки `pu2clr/SI4735` и обзоров на datasheet4u:
FM (VHF) **64–108 МГц**, плюс AM/LW/MW/SW 150 кГц – 30 МГц, у -D60/-A10
дополнительно SSB. RDS есть.

- Интерфейс I²C, питание 3,3 В.
- Перекрывает УКВ OIRT целиком (64 < 65,8).
- Заметно лучше по приёму, чем RDA5807, и даёт бонусом ДВ/СВ/КВ.
- Дороже; модулей-«кирпичиков» меньше, чаще встречается в виде готовых
  плат приёмников (ATS-20 и клоны) или отдельной платы под пайку.

### Вариант C — RTL-SDR + программный демодулятор

> **Неактуально: отклонён.** Вариант требовал Linux-платформы (ранняя ревизия
> на Raspberry Pi, отменена 2026-08-26, [24](24-main-build-p4.md)). С ESP32-P4
> он не работает — см. строку «Работает с ESP32» в таблице ниже.

Свисток на R820T2/RTL2832U, тюнер перекрывает примерно 24–1766 МГц,
то есть оба наших диапазона с запасом. Демодуляция и RDS — софтом
(`rtl_fm`, `redsea`).

Плюсы, которые важны именно нам:

- **Единый звуковой тракт.** Звук эфира выходит из той же звуковой карты Pi,
  что и интернет-радио → не нужен коммутатор аналоговых сигналов,
  не нужен второй регулятор громкости (см. [04](04-audio-path.md)).
- Один и тот же код рисует спектр/уровень, легко сделать «водопад» на экране.
- Потом можно добавить что угодно: авиадиапазон, любительские, даже DAB+
  (через отдельный софт).

Минусы: постоянная нагрузка на CPU (демодуляция FM в реальном времени),
свисток греется и шумит по питанию/эфиру рядом с самим Pi, чувствительность
в 65–74 МГц у R820T2 хуже, чем в 100 МГц — нужен нормальный антенный вход.

### Отвергнутые

| Модуль | Почему нет |
|---|---|
| TEA5767 | 76–108 МГц, **нет RDS** → не выполняет ни R1.1 (нет OIRT), ни R1.4 |
| Si4703 / Si4705 | 76–108 МГц → не перекрывает УКВ OIRT (R1.1) |

## 3. Сравнение

| Критерий | A. RDA5807M | B. Si4735/Si4732 | C. RTL-SDR |
|---|---|---|---|
| УКВ 65,8–74 МГц | да (BAND=3) | да (от 64 МГц) | да |
| FM 87,5–108 | да | да | да |
| RDS | да, в чипе | да, в чипе | софтом (redsea) |
| Автопоиск | аппаратный SEEK | аппаратный SEEK | скан софтом |
| Нагрузка на процессор | ~ноль | ~ноль | заметная |
| Звук | аналоговый выход → нужен коммутатор | то же | цифровой, общий тракт |
| Доп. диапазоны | нет | ДВ/СВ/КВ/SSB | всё до 1,7 ГГц |
| Работает с ESP32 | да | да | **нет** |
| Цена модуля | самый дешёвый | средняя | средняя |

## 4. Что предлагаю

**A (RDA5807M) как основной вариант для первой сборки** — потому что он
единственный, кто одновременно: дёшев, перекрывает ровно оба нужных диапазона
штатным регистром, имеет аппаратные автопоиск и RDS, и работает с ESP32.

**B (Si4735/Si4732)** — как замена «капля в каплю» по I²C, если на макете
выяснится, что чувствительности RDA5807 не хватает. Схема и код меняются мало,
разъём тот же.

**C (RTL-SDR)** — неактуально: на ESP32-P4 не работает (см. выше).

Решение вынесено в [06-open-questions.md](06-open-questions.md), вопрос Q2.

## 5. Как это выглядит на схеме (блок-уровень, вариант A)

```
   антенна ~75 см…1 м
        │
   ┌────┴──────────┐  I²C (SDA/SCL, 3,3 В)   ┌──────────────┐
   │  RDA5807M     │◄───────────────────────►│              │
   │  модуль       │                          │ управляющая  │
   │               │  L/R аналог (наушн.)     │  плата       │
   └───────┬───────┘──────────────┐           │ (док. 03)    │
                                  │           │              │
                                  ▼           └──────┬───────┘
                          коммутация/сумма           │ I²S
                          источников (док. 04)◄──────┘
                                  │
                                  ▼
                            УНЧ → динамик
```

## 6. Источники

- Даташит RDA5807M (RDA Microelectronics), стр. 6, 9, 12 — диапазоны, регистр
  BAND, регистры RDS. Файл получен с https://done.land/assets/files/rda5807m_datasheet.pdf,
  прочитан локально 2026-08-17.
- Библиотека и описание Si473X: https://pu2clr.github.io/SI4735/ и
  https://github.com/pu2clr/SI4735 (прочитано 2026-08-17) — «FM (VHF) from 64 to 108 MHz».
- Библиотека RDA5807: https://github.com/pu2clr/RDA5807
- Пример двухрежимного приёмника (RDA5807 + интернет-радио на XIAO ESP32S3):
  https://www.pcbway.com/project/shareproject/All_in_one_DSP_Radio_RDA5807_and_Internet_Radio_xiao_esp32s3_5874fd0a.html
- redsea (декодер RDS для RTL-SDR): https://www.rtl-sdr.com/new-rtl-sdr-radio-data-system-rds-decoder-redsea/
- Состояние вещания в УКВ OIRT — обсуждения на профильных форумах:
  https://www.radioscanner.ru/forum/topic52110.html ,
  https://forum.vcfm.ru/viewtopic.php?f=5&t=1658 (просмотрено 2026-08-17,
  форумные данные — не официальный источник, требуют перепроверки на месте)
