Spok1978/hybrid-radio/docs/04-audio-path.md

# 04. Звуковой тракт: ЦАП, усилитель, динамик, коммутация режимов

Требование R5: **один громкоговоритель работает в обоих режимах**. Значит надо
свести два источника звука в один усилитель и иметь одну общую громкость.

## 1. Откуда берётся звук в каждом режиме

| Режим | Источник | Вид сигнала |
|---|---|---|
| 1. Эфир (тюнер RDA5807/Si4735) | выход тюнера | **аналоговый**, уровень наушников |
| 1. Эфир (вариант RTL-SDR) | звуковая карта вычислителя | цифровой → аналог там же |
| 2. Интернет | вычислитель | цифровой I²S / USB-звук |

В сборке на ESP32-P4 звук интернет-радио выходит по I²S на внешний ЦАП
PCM5102A, а эфир — аналоговым выходом тюнера; оба сводятся пассивным
микшером ([33](33-carrier-board.md)).

## 2. Три схемы сведения источников

### Схема 1 — «программное приглушение + пассивная сумма» (рекомендую)

Оба аналоговых источника заводятся на вход усилителя через резисторы
(суммирующий узел). Неактивный источник **глушится программно**: у RDA5807
есть регистры mute и громкости 0–15, у вычислителя — микшер ALSA.

```
   тюнер L ──╮ 10 к
   тюнер R ──┴───┬─── 4,7 мк ──► вход УНЧ (моно)
                 │
   ЦАП L ────╮ 10 к
   ЦАП R ────┴───┘
```

- Деталей: 4 резистора + 1 конденсатор.
- Щелчков при переключении нет — переход делается плавно (mute → пауза → unmute).
- Минус: два источника всегда электрически связаны, поэтому шум/наводка
  от неактивного слышна, если он не заглушён по-настоящему. Проверяется
  на макете.

### Схема 2 — аналоговый коммутатор

Ключ CD4053 / TS3A24159 / малогабаритное реле, управляется отдельной линией
GPIO — режим задаёт софт, а не орган на панели ([22](22-mode-switching.md)).

- Полная развязка источников.
- Минус: лишний корпус, щелчок при переключении, ещё один узел, который
  может шуметь.

**Уточнение 2026-08-21.** Разбор двух похожих проектов показал, что оба их
автора выбрали именно этот путь: MAX4544 у одного, ADG884 у другого. Схема 2
переведена из отклонённых в **запасной план №1** на случай, если измерение
покажет проблемы с пассивной суммой. Важная деталь, которой нет ни в одном
из тех проектов: наш сигнал с ЦАП центрирован на земле и уходит ниже нуля,
поэтому односупплайному ключу нужны смещение к середине питания и развязка
конденсаторами с обеих сторон. Разбор — [18](18-similar-projects.md).

### Схема 3 — единый цифровой тракт

> **Неактуально.** Схема требовала Linux-платформы (ранняя ревизия на
> Raspberry Pi, отменена 2026-08-26, [24](24-main-build-p4.md)); на ESP32-P4
> не применяется.

- либо **RTL-SDR** (вариант C в [02](02-fm-frontend.md)) — эфир демодулируется
  софтом, звук идёт из той же звуковой карты. Коммутация не нужна **вообще**;
- либо аналоговый выход тюнера заводится в **линейный вход USB-звуковой карты**,
  а вычислитель проигрывает его через ALSA. Тоже единый тракт и единая
  громкость, но добавляется задержка (десятки миллисекунд — для радио не
  важно) и лишний АЦП в тракте.

## 3. ЦАП и усилитель

Три рабочих комплектации, от простой к качественной:

| Вариант | Состав | Мощность | Комментарий |
|---|---|---|---|
| **Минимум** | MAX98357A (I²S → ЦАП + УНЧ в одном) | 3,2 Вт на 4 Ω при 5 В (10 % THD), 1,8 Вт на 8 Ω | Моно. Питание 2,7–5,5 В. Подключается по I²S. Для настольного приёмника достаточно |
| **Стерео** | PCM5102A (I²S → линейный выход) + PAM8403 или TPA3116 | 2×3 Вт (PAM8403) / 2×50 Вт (TPA3116) | Разделены ЦАП и УНЧ → проще бороться с шумом, легче подмешать аналог с тюнера |

**[добавлено 2026-08-26] Точка подключения внешнего усилителя на плате P4.**
TPA3118D2 подключается к выходу кодека ES8311 **до штатного усилителя платы
NS4150B** (2 Вт на 8 Ω, линия включения `PA_Ctrl` = GPIO53), а не к клеммам
динамика — иначе получится двойное усиление. Штатный NS4150B в изделии
не используется и удерживается выключенным.

Мощность: на 12 В при 4 Ω TPA3118 способен отдать больше 10 Вт, то есть
больше, чем выдержит выбранный динамик. Ограничивается аппаратно выводом
**PLIMIT** (встроенный лимитер мощности семейства TPA31xxD2) и программным
потолком громкости.

**Для схемы 1 (пассивная сумма) удобнее вариант «стерео»**: MAX98357A принимает
только I²S, аналог с тюнера в него не подмешать — пришлось бы городить схему 3.

## 3.1. Решение от 2026-08-17

**Стерео-ЦАП PCM5102A + моно-усилитель + один динамик.** Каналы сводятся в
моно в том же пассивном узле, что и оба источника — то есть один узел решает
сразу две задачи: стерео→моно и «эфир + интернет».

Почему стерео-ЦАП, а не MAX98357A: MAX98357A принимает только I²S, аналог
с тюнера в него подмешать нечем. С линейного выхода ЦАП и тюнер приходят
в одну точку.

Почему один динамик: в УКВ OIRT стерео всё равно не будет (см. [02](02-fm-frontend.md)),
корпус проще, а возможность стерео остаётся — ЦАП стерео, при желании позже
ставится второй усилитель и второй динамик, схема не переделывается.

### Усилитель — уточнено 2026-08-18 после выбора питания 12 В

Изначально был выбран **PAM8302A** (2,5 Вт на 4 Ω, питание до 5,5 В). После
решения питать прибор от 12 В (см. [09](09-power-supply.md)) он заменён на
**TPA3118D2**: PAM8302A выше 5,5 В не питается и упирается в свои 2,5 Вт,
а TPA3118 работает от 12 В напрямую, мимо преобразователя.

Что даёт: расчётный потолок мостового каскада `P ≈ V²/(2R) = 12²/8 = 18 Вт`
на 4 Ω. Практический ориентир (уточнён 2026-08-21): **12–15 Вт — это пиковые
цифры при 10 % искажений**, а «громко и чисто», при 1 % THD, — примерно
**7–8 Вт**. Динамик на 15 Вт это выдерживает с запасом.

Параметры из даташита TPA31xxD2 (Texas Instruments), важные для схемы:

| Параметр | Значение | Что из этого следует |
|---|---|---|
| Питание PVCC | до 26 В | 12 В — рабочая точка, запас есть |
| Усиление | фиксированное **20 / 26 / 32 / 36 дБ**, задаётся делителем на выводе GAIN/SLV, **защёлкивается при подаче питания** | берём **26 дБ** (уточнено 2026-08-21 после расчёта уровней, см. [15](15-wiring-breadboard.md), п. 7): по таблице 1 даташита это **R1 = 20 кОм на землю, R2 = 100 кОм на GVDD**. Покупные модули часто выпаяны на 36 дБ (R1 = 47 к, R2 = 75 к) — **делитель проверить и перепаять** |
| Входное сопротивление | 60 кОм при 20 дБ … 9 кОм при 36 дБ | при 20 дБ наши резисторы 10 кОм в сумматоре не «сажают» вход |
| Смещение входов | **+3 В** | разделительные конденсаторы на входе **обязательны** |
| Вывод SD | ноль — выключен, единица — включён; даташит требует **держать SD в нуле при подаче питания** | цепь приглушения при загрузке, [09](09-power-supply.md), п. 10 |
| Режим PBTL | есть (LINP/LINN на землю) | **нам не нужен**: PBTL для 2 Ω, на 4 Ω хватает одного канала BTL |

Модуль берём обычный стерео, задействуем **один канал** — второй вход сажаем
на землю через конденсатор, выход не подключаем.

### Итоговый узел

```
   тюнер L ──[1 к]───┐
   тюнер R ──[1 к]───┤            подстроечник 10 к
                     ├──┬────────►│ верх / движок ├──[3,3 мк]──► IN TPA3118
   ЦАП L  ───[10 к]──┤  │                                        (усиление 26 дБ)
   ЦАП R  ───[10 к]──┘  │                                             │
                        │                                        динамик 4 Ω
                    [100 к] на землю                              10–15 Вт
```

**Номиналы разные не случайно:** у тюнера выход 360 мВ (даташит, стр. 6),
у ЦАП — 2,1 В, разница около 15 дБ. Одинаковые резисторы дали бы заметно
более тихий эфир, а регулятор громкости общий. Расчёт — [15](15-wiring-breadboard.md), п. 7.1.

> **[уточнено 2026-08-27]** Нужен ли пересчёт — зависит от выбора точки
> подключения, см. [26](26-firmware-spec.md), §2.5. Если ставится **свой
> ЦАП PCM5102A по I²S** (рекомендуемый путь), то расчёт ниже **верен как
> есть**: выход однотактный, 2,1 В, всё как считалось. Пересчёт нужен только
> при врезке в дифференциальный тракт платы.
>
> **[снято 2026-10-10]** В сборке на P4 стоит свой PCM5102A
> ([33](33-carrier-board.md)), поэтому значение 2,1 В действует. Ниже —
> прежняя оговорка, на случай врезки в кодек платы.
>
> **[пересчитать 2026-08-26]** Значение 2,1 В — это выход PCM5102A; если
> вместо него использовать кодек платы **ES8311**, и полношкальный уровень у него свой,
> зависящий от AVDD, — берётся из даташита Everest или меряется на плате.
> Значение 360 мВ у тюнера тоже помечено как **[не подтверждено]**:
> в даташите RDA5807M заявлено только «line-level». **[исправлено
> 2026-10-05]** Это неверно: даташит RDA5807M V1.1, с. 7 даёт 360 мВ
> типовой при громкости 1111 и девиации 22,5 кГц, и там же — постоянное
> смещение выходов 1,0–1,1 В, поэтому нужны разделительные конденсаторы
> ([33](33-carrier-board.md), §11). Делители считаются
> по измеренным значениям, а не по этим. Подробности —
> [26](26-firmware-spec.md), §2.2.
>
> Отдельно: **ES8311 монофонический**, поэтому стереовыход тюнера сводится
> в моно **до** входа кодека.

**Зачем подстроечник, а не как раньше.** У PCM5102A на выходе около 2,1 В
действующего значения. При усилении 20 дБ (×10) это дало бы 21 В на выходе —
далеко за пределы питания, то есть жёсткий клиппинг. Поэтому между сумматором
и усилителем ставится делитель-подстроечник, который выставляется **один раз**:
на максимальной программной громкости не должно быть искажений. Дальше
громкость регулируется только программно — регистром громкости RDA5807 (0–15)
в эфире и микшером ALSA в интернет-режиме.

Отсюда следствие, записанное 2026-08-25: **в эфире у громкости ровно
16 ступеней, и в этой схеме это потолок** — программной ступени в аналоговом
тракте тюнера нет. Энкодер даёт 20 импульсов на оборот, то есть меньше оборота
проходит весь диапазон. Принято 2026-08-26 оставить 16 ступеней как рабочий
вариант и пересмотреть по результатам макета или эксплуатации — разбор и
поводы вернуться в [23](23-volume-control.md), §3.

**Разделительный конденсатор на входе усилителя обязателен** — входы TPA3118
смещены на 3 В. При выбранном усилении **26 дБ** входное сопротивление 30 кОм,
и таблица даташита для этого случая рекомендует **3,3 мкФ** (срез 1,6 Гц).
Уточнено 2026-08-21: раньше здесь стояло 2,2 мкФ — значение под усиление
20 дБ, от которого отказались.

**А вот на выходе ЦАП конденсаторы не нужны.** У PCM5102A выходы типа
DirectPath: сигнал 2,1 В действующего центрирован относительно земли,
постоянной составляющей нет. Лишний конденсатор там только завалит низы.
Постоянка есть только у тюнера, и её блокирует тот же общий конденсатор
на входе усилителя.

**Динамик пересмотрен:** под 10–15 Вт нужен **4 Ω, 10–15 Вт, 4″ (100 мм)**
вместо прежних 3–5 Вт. Иначе на большой громкости он долго не проживёт.

## 4. Громкоговоритель

Для настольного приёмника с 5–7″ экраном:

- широкополосный динамик **4 Ω, 3–5 Вт, диаметр 3″ (77 мм) или 4″ (100 мм)**;
- обязателен **закрытый объём** (корпус) — динамик «в воздухе» звучит
  как телефон;
- вариант с двумя динамиками имеет смысл только если решим делать стерео
  (см. вопрос Q5 в [06](06-open-questions.md)); в эфире УКВ OIRT стерео,
  скорее всего, не будет в любом случае.

Мощности 3 Вт на канал хватает для комнаты. Больше 10 Вт для этой задачи —
это уже про корпус и питание, а не про громкость.

## 5. Питание

- Блок **12 В / 5 А**: усилители питаются от 12 В напрямую отдельной парой
  проводов (звёздная земля), плата P4 — через DC-DC 12 → 5 В по USB-C
  ([33](33-carrier-board.md)). Иначе в динамике будет слышна работа процессора.
- Развязка: электролит 470–1000 мкФ у входа питания УНЧ + керамика 0,1 мкФ.
- Тюнер питать 3,3 В **от отдельного линейного стабилизатора**, а не от шины,
  на которой сидит цифра — это самый дешёвый способ убрать «цыканье» в эфирном
  режиме.

## 6. Источники

- MAX98357A, параметры:
  https://learn.adafruit.com/adafruit-max98357-i2s-class-d-mono-amp
  (прочитано 2026-08-17)
- PAM8302A, параметры платы (вариант до перехода на 12 В):
  https://www.adafruit.com/product/2130 (проверено 2026-08-17)
- Даташит TPA31xxD2 (TPA3116D2 / TPA3118D2 / TPA3130D2), Texas Instruments —
  питание до 26 В, усиления 20/26/32/36 дБ через вывод GAIN/SLV, входы
  смещены на 3 В, входное сопротивление 60 кОм…9 кОм, режим PBTL, требование
  держать SD в нуле при подаче питания:
  https://www.ti.com/lit/ds/symlink/tpa3118d2.pdf (прочитан локально 2026-08-18)
