Spok1978/hybrid-radio/docs/06-open-questions.md

# 06. Открытые вопросы — решаем вместе

Пока вопрос не закрыт, дальше по нему не проектируем. Закрытые вопросы
переносятся в соответствующий документ с датой и обоснованием.

## Q1. Откуда берём список интернет-станций

Разбор — [01-station-directories.md](01-station-directories.md).

| Вариант | Суть |
|---|---|
| **Q1-a (предлагаю)** | Radio Browser как поисковик + своя локальная база станций + ручной ввод URL |
| Q1-b | Только свой файл-список: никакой зависимости от внешнего сервиса |
| Q1-c | Q1-a + периодический снапшот каталога, чтобы поиск работал и без интернета |

Статус: **РЕШЕНО 2026-08-17 — вариант Q1-a.**
Radio Browser используется только как поисковик, найденные станции сохраняются
в локальную базу приёмника, ручной ввод URL остаётся.

**Формат уточнён 2026-08-26:** локальная база — штатный `/stations.json`
прошивки MiniWebRadio в корне карты; одна запись — массив из четырёх строк
(признак избранного, код страны, название, URL потока). Проверено по
исходникам, разбор — [24](24-main-build-p4.md), §2. Прежняя запись про
`stations.csv` в документах 03 и 08 была устаревшей и исправлена. Чего в этом
формате не хватает и где жить эфирным пресетам — вопрос Q13.

## Q2. Эфирный тракт

Разбор — [02-fm-frontend.md](02-fm-frontend.md).

| Вариант | Суть |
|---|---|
| **Q2-a (предлагаю)** | Модуль RDA5807M: дёшево, оба диапазона штатно, RDS и SEEK в чипе |
| Q2-b | Si4735-D60 / Si4732-A10: дороже, лучше приём, бонусом ДВ/СВ/КВ/SSB |
| Q2-c | RTL-SDR: единый звуковой тракт, спектр на экране, но грузит процессор и требует Linux-платформы — **неактуально** (ревизия на Pi отменена) |

Статус: **РЕШЕНО 2026-08-17 — вариант Q2-a, модуль RDA5807M.**
Причина: единственный дешёвый модуль, который штатным регистром BAND
перекрывает и УКВ OIRT, и FM, имеет аппаратные SEEK и RDS.
Si4735/Si4732 остаётся заменой по тому же I²C, если не хватит чувствительности.

## Q3. Платформа управления, конкретная плата

**Действует: плата Waveshare ESP32-P4-WIFI6-Touch-LCD-5** (решение 2026-08-26,
[24](24-main-build-p4.md)). Ниже — история вопроса; всё про Raspberry Pi
**неактуально**.

Разбор — [03-controller-platform.md](03-controller-platform.md),
стоимость и выбор платы — [08-cost-and-board-choice.md](08-cost-and-board-choice.md).

**Решено 2026-08-17:** платформа — **Raspberry Pi** (не ESP32). Требование:
плата поменьше и подешевле, «не ставить большую плату под простую задачу».

Осталось выбрать комплектацию:

| Вариант | Плата | Экран |
|---|---|---|
| **V1** | Pi 3A+ | Touch Display 2 **5″** ($40) — самый дешёвый комплект с родным DSI |
| **V2** | Pi 3A+ | Touch Display 2 **7″** ($60) |
| V3 | Pi Zero 2 W | HDMI-панель (Touch Display 2 **физически не подходит** — у Zero нет DSI) |
| V4 | Pi 4 2 ГБ | Touch Display 2 7″ — с запасом, работает браузерный стек как в cable-tester |

Следствие выбора V1/V2/V3: **512 МБ ОЗУ → интерфейс не браузерный**,
пишем на PyQt5 или pygame поверх KMS, воспроизведение — MPD/mpv в фоне.

Статус: **РЕШЕНО.**
2026-08-17 — вариант V1: Touch Display 2 5″, интерфейс без браузера.
**2026-08-18 — плата уточнена: Raspberry Pi 3 Model B+** вместо 3A+.
Тот же SoC BCM2837B0 @1,4 ГГц и тот же шлейф 15→15, но **1 ГБ ОЗУ** вместо
512 МБ, плюс Ethernet и 4×USB. Разбор — [08](08-cost-and-board-choice.md), п. 9.
**2026-08-26 — решение изменено: основная сборка на ESP32-P4**, плата
Waveshare ESP32-P4-WIFI6-Touch-LCD-5. Ревизия на Pi отменена, её документы
помечены «НЕАКТУАЛЬНО». Разбор и последствия — [24](24-main-build-p4.md).

## Q4. Экран

**Действует: штатный экран платы P4, 5″ DSI 720×1280, книжный, сенсорный**
(2026-08-26, [24](24-main-build-p4.md)); отдельная панель не покупается.
Ниже — история вопроса для ревизии на Raspberry Pi, **неактуально**.

Разбор — [05-display-and-ui.md](05-display-and-ui.md).

**Решено 2026-08-17:** Raspberry Pi **Touch Display 2**, с сенсором
(сенсор снимает проблему ввода пароля Wi-Fi). Панель портретная 720×1280,
в ландшафт поворачивается программно — учесть при проектировании корпуса.

**Уточнено 2026-08-18 по доступности.** Оригинальный Touch Display 2
(артикул SC1975) продаётся только через авторизованных продавцов, на
AliExpress его нет.

**Пересмотрено 2026-08-21 по итогам аудита** ([12](12-audit-response.md), §2.1).
Решающим критерием оказался не размер, а наличие панели в **штатном оверлее**
`vc4-kms-dsi-waveshare-panel`: если она там есть, драйвер производителя не
нужен и обновление ОС ничего не ломает.

| | Модель | Разрешение | Ориентация | Штатный оверлей |
|---|---|---|---|---|
| A3-a | Raspberry Pi Touch Display 2, 5″, **SC1975** | 720×1280 | портрет, нужен поворот | есть, но нет на AliExpress |
| **A3-b** | **Waveshare 7inch DSI LCD (C)** | **1024×600** | **ландшафт** | **есть: `7_0_inchC`** |
| A3-c | Waveshare 5inch DSI LCD (C) | 1024×600 | ландшафт | **нет** — только вендорский |

Статус: **РЕШЕНО — вариант A3-b, Waveshare 7inch DSI LCD (C), 1024×600,
сенсорный, интерфейс DSI.** Требование R3 допускает и 5″, и 7″.
A3-c берётся, только если 7″ не влезет в корпус, и тогда риск вендорского
драйвера принимается осознанно.

Интерфейс рассчитываем на **1024×600**. Подробности и что проверить в
карточке товара — [11-shopping-list.md](11-shopping-list.md), раздел A3.

**Отменено 2026-08-26 переносом основной сборки на ESP32-P4**
([24](24-main-build-p4.md)): экран у платы свой, 5″ 720×1280 книжной
ориентации, отдельная панель не покупается. Варианты выше относились к отменённой
ревизии на Pi и неактуальны. Раскладка интерфейса под новое разрешение — Q12.

## Q5. Стерео или моно, мощность звука

Статус: **РЕШЕНО 2026-08-17, уточнено 2026-08-18 — стерео-ЦАП PCM5102A,
усилитель TPA3118D2 (один канал BTL) от 12 В, один динамик 4 Ω на 10–15 Вт.**

Замена PAM8302A → TPA3118D2 — следствие перехода на питание 12 В: PAM8302A
выше 5,5 В не питается. Подробности — [04](04-audio-path.md), п. 3.1.

Каналы L/R сводятся в моно в том же пассивном узле, где подмешивается аналог
с тюнера — один узел на четырёх резисторах решает обе задачи. Возможность
стерео сохраняется: ЦАП стерео, позже ставится второй усилитель и динамик
без переделки схемы. Подробности — [04-audio-path.md](04-audio-path.md), п. 3.1.

**Частично отменено 2026-08-26** ([24](24-main-build-p4.md)): отдельный ЦАП
PCM5102A на плате ESP32-P4 не нужен, там свой кодек ES8311. Усилитель
TPA3118D2, динамик 4 Ω и сведение в моно остаются в силе. Нужен ли вообще
пассивный сумматор, зависит от того, выведен ли аналоговый вход ES8311
наружу — первый пункт приёмки платы, [08](08-cost-and-board-choice.md), §10.

## Q6. Питание и режим включения

**Действует (сборка на P4, [33](33-carrier-board.md)):** блок 12 В / 5 А,
предохранитель T5A, защита от переполюсовки на IRF4905 и TVS P6KE16A;
усилители — от 12 В напрямую, плата P4 — 5 В от DC-DC SY8205 через USB-C
(иначе не заряжается её батарея), тюнер — свой LDO HT7333 с ферритами;
батарея в штатный разъём платы ставится (Q14). Ниже — решение 2026-08-18
для ревизии на Raspberry Pi: блок 3 А, ввод в Pi через micro-USB,
overlayfs, «аккумулятор не нужен» — **неактуально**.

Разбор — [09-power-supply.md](09-power-supply.md).

**РЕШЕНО 2026-08-18: вход 12 В от внешнего блока питания** (вариант C).
Разбор трёх вариантов — [09-power-supply.md](09-power-supply.md), раздел 0.

- блок **внешний, 12 В / 3 А**, стабилизированный, гнездо 5,5×2,1, «плюс»
  в центре; сетевое напряжение в корпус прибора не заводится;
- на входе: предохранитель 3 А, защита от переполюсовки на P-MOSFET,
  TVS **на 12 В** (не на 5!);
- усилитель питается 12 В напрямую, Pi и дисплей — через понижающий
  преобразователь ≥3 А, выставленный на 5,1 В, ввод в Pi через micro-USB;
- тюнер — через свой малошумящий LDO 3,3 В с ферритом;
- корневая ФС только для чтения (overlayfs), поэтому снимать питание можно
  в любой момент.

**Принятая плата:** помеха от преобразователя ложится прямо в полосу приёма
65–108 МГц. Меры заложены (разнос, экран, LC-фильтр, ферриты, отдельный LDO),
но проверяются только приёмом на макете — [09](09-power-supply.md), п. 6 и 13.

**Аккумулятор — РЕШЕНО 2026-08-18: не нужен.** Защита карты памяти решается
не запасом энергии, а тем, что в обычной работе на карту ничего не пишется:
read-only корень, отдельный раздел данных и атомарная запись. Разбор и
расчёты (в том числе почему ионисторы не нужны) —
[10-shutdown-and-data-safety.md](10-shutdown-and-data-safety.md).

Дополнительно принято: **кнопка мягкого выключения** — `gpio-shutdown` на
свободном выводе плюс `gpio-poweroff` на GPIO26, снимающий питание через
фиксирующий ключ. Ставим после того, как заработает основное.

Статус: **закрыт**

## Q7. Есть ли что принимать в 65,8–74 МГц

**Проверить фактом, а не рассуждением.** До закупки: взять любой приёмник с
УКВ OIRT (или SDR-свисток) и прослушать диапазон в твоём городе. Если пусто —
требование R1.1 остаётся, но приоритет диапазона падает, и это может изменить
выбор в Q2.

Статус: **открыт, нужна проверка на месте**

## Q8. Корпус

Настольный? Материал (фанера/пластик/печать)? Кто изготавливает? Влияет на
выбор экрана (портрет/ландшафт), динамика и компоновки антенны.

Статус: **открыт**

## Q9. Веб-интерфейс с телефона

Вопрос попал в список в самом начале, когда рассматривалась Linux-платформа
(Raspberry Pi 4, ревизия отменена) с интерфейсом на NiceGUI: там веб-интерфейс получался сам собой, как в cable-tester,
и решал ввод пароля Wi-Fi при несенсорном экране.

**С тех пор оба основания отпали:**

1. Экран выбран **сенсорный** (Touch Display 2) — пароль Wi-Fi набирается
   пальцем на экранной клавиатуре, никакого телефона для этого не нужно.
2. Интерфейс решено писать **нативным** (PyQt5/pygame без браузера) —
   значит веб-интерфейс стал бы **вторым, отдельным интерфейсом**: свой
   список станций, свои пресеты, свои настройки, и всё это надо держать
   в согласии с основным. Это уже не «бесплатно», а заметная работа.

Что закрывает те же потребности дешевле:

| Потребность | Чем закрываем |
|---|---|
| Обслуживание, логи, обновление | **SSH** — работы ноль |
| Добавить станцию | поиск по Radio Browser прямо на приборе, ввода текста почти нет |
| Ввести длинный URL руками | редкий случай: экранная клавиатура, либо воткнуть USB-клавиатуру (у 3B+ четыре порта) |
| Залить сразу много станций | **импорт `.m3u`/`.pls` с USB-флешки**: воткнул → «импортировать станции?» → готово. Проще веб-сервера и работает без сети |

Статус: **РЕШЕНО 2026-08-18 — не делаем.**

Единственное, что делаем сейчас ради возможного будущего: держим ядро
(база станций, управление воспроизведением, тюнер) **отдельным модулем
с внятным API**, чтобы веб-слой при желании можно было надстроить сверху,
а не переписывать прибор. Это ничего не стоит и просто хорошая структура.

## Q10. Бюджет и сроки

Ориентир по стоимости комплекта и к какому сроку хочется рабочий макет.

Статус: **открыт**

## Q11. Чем нажимать восемь пресетов

Поставлен 2026-08-25 вместе с отменой тумблера ([22](22-mode-switching.md)).
Пресеты стали одним банком из 8 ячеек со станциями обоих типов, и появилось
желание иметь восемь отдельных кнопок 1–8.

На отменённой ревизии на Raspberry Pi они не помещались (свободно было
четыре вывода на восемь кнопок, [13](13-gpio-map.md) — неактуально).

Направление, выбранное заказчиком: делать на второй платформе, Waveshare
ESP32-P4-WIFI6-Touch-LCD-5 с 40-контактной гребёнкой, плюс дублирование
плитками на сенсорном экране.

Чего не хватает для решения: **таблицы распределения 40 контактов этой платы.**
Проверено 2026-08-25 — Waveshare её не публикует: страница вики представляет
собой заглушку «Wiki resources are under urgent production», страница
документации таблицы не содержит, схемы платы в разделе Resources нет вовсе.
Заявлено только «40PIN, 2.54 mm».
Остаётся прозвонка по приходу платы либо тикет в поддержку Waveshare.

**Схема платы найдена 2026-08-27.** Прежний вывод «Waveshare её не
публикует» был верен для страницы товара и вики, но неверен вообще: схема
лежит в официальном репозитории платы `waveshareteam/ESP32-P4-WIFI6-Touch-LCD-5`,
каталог `hardware/schematic`. Там же `docs/IO.md` — список выводов, сверенный
с исходником BSP и со схемой.

Полная карта занятых выводов перенесена в [26](26-firmware-spec.md), §2.3.
Коротко: платой заняты **GPIO7, 8, 9, 10, 11, 12, 13, 23, 26, 27, 39–44, 53**
и, возможно, GPIO2. На шине I²C — GT911 (0x5D/0x14), ES8311 (0x18),
ES7210 (0x40); тюнер (0x10/0x11) и расширитель (0x20–0x27) с ними
не конфликтуют.

**Чего по-прежнему нет:** таблицы самой 40-контактной гребёнки. В `IO.md`
сказано, что это разъём и что смотреть надо схему. То есть вопрос перешёл
из «нечего читать» в **«прочитать схему»** — работа, которую можно сделать
до прихода платы.

Запасные варианты выбраны 2026-08-25 и расписаны в [22](22-mode-switching.md),
§6: сначала уменьшить число кнопок на панели, не трогая размер банка, затем —
расширитель MCP23017 по I²C. Адреса сверены: тюнер `0x10`/`0x11`, расширитель
`0x20–0x27`, конфликта нет. Отдельно учтено, что `gpio-key` к выводам
расширителя не привязывается и читать их придётся из программы.

**ЗАКРЫТ 2026-08-27 по схеме платы.** На гребёнку J3 выведены питание,
земля, шина I²C платы (GPIO7/GPIO8, на неё садится тюнер) и свободные
выводы:

> **GPIO3, 4, 5, 21, 22, 28, 29, 30, 31, 32, 34, 46, 47, 48, 49, 50, 51, 52**

Нужно семнадцать линий: восемь пресетов, два энкодера по три, MODE, питание
и приглушение усилителя. Свободных **восемнадцать**.

**[исправлено в тот же день]** Первая редакция насчитала двадцать один
и называла это запасом. Ошибка: **GPIO35** сидит в цепочке автосброса,
**GPIO37** и **GPIO38** — отладочный UART. Кнопка на любом из них сломала бы
прошивку или консоль. Разбор — [29](29-yaml-review.md).

Статус: **РЕШЕНО** — ставим **восемь** кнопок пресетов, расширитель портов
не нужен. Разбор — [26](26-firmware-spec.md), §2.5. Осталось сверить точную
нумерацию выводов гребёнки и проверить, нет ли среди выбранных
strapping-выводов.

## Q12. Раскладка интерфейса под экран 720×1280

Поставлен 2026-08-26 переносом основной сборки на ESP32-P4
([24](24-main-build-p4.md)).

Весь документ [05](05-display-and-ui.md) построен на 1024×600 **альбомной**
ориентации: главный экран с частотой и списком пресетов в строку, структура
меню. Панель выбранной платы — 720×1280, то есть **книжная**. Прежняя
оговорка «раскладка та же, строк в списке меньше» ([08](08-cost-and-board-choice.md),
§10) к этому случаю не относится.

Два пути:

| Вариант | Суть |
|---|---|
| Книжная раскладка заново | частота сверху, список станций вниз по всей высоте — под 720×1280 это естественно |
| Повернуть на 90° | получаем 1280×720 и сохраняем логику документа 05 |

Что надо выяснить перед выбором: поддерживает ли поворот дисплейный порт,
который нам всё равно писать под HX8394, и как при повороте ведёт себя
сенсор. Плюс углы обзора у IPS-панелей несимметричны, и «положенный на бок»
экран может выглядеть хуже — проверяется только глазами по приходу платы.

Отдельно: у MiniWebRadio раскладка живёт в `src/mwr_src/layout.hpp` и написана
под поддерживаемые разрешения. Насколько она параметризуется — не смотрел.

**РЕШЕНО 2026-08-26 — раскладка альбомная.** Указание заказчика: ориентация
однозначно альбомная, и если ради этого придётся писать дисплейный порт —
пишем.

Панель физически 720×1280, поэтому альбомный вид получается поворотом
картинки на 90°. У DSI-панелей в video mode собственного поворота обычно нет:
контроллер непрерывно гонит строки, и приём с регистром адресации, как у
SPI-панелей, здесь не работает. Значит поворачивать надо кадр.

**На ESP32-P4 это делается железом.** Проверено 2026-08-26 по документации
ESP-IDF (`esp32p4/api-reference/peripherals/ppa.html`): в чипе есть PPA,
Pixel Processing Accelerator, операция SRM (scale-rotate-mirror), углы
поворота 0/90/180/270 против часовой стрелки (`ppa_srm_rotation_angle_t`),
заголовок `driver/ppa.h`, функция `ppa_do_scale_rotate_mirror()`. То есть
поворот не съедает процессор и не требует программного разворота буфера.

### Что понадобится, когда придёт плата

| Что | Зачем |
|---|---|
| Модель контроллера панели (ожидается HX8394) | под неё пишется таблица инициализации |
| Video mode или command mode | определяет всю схему вывода |
| Число линий MIPI DSI и скорость на линию | расчёт пропускной способности |
| Тайминги HSA, HBP, HFP, VSA, VBP, VFP и пиксельная частота | без них панель не синхронизируется |
| Последовательность инициализации от вендора | набор DCS- и фирменных команд |
| Выводы reset, включения питания панели, подсветки (PWM или драйвер) | порядок включения имеет значение |
| Модель тачскрина, шина и адрес I²C, выводы INT и RESET | сенсор нужен по R4.1 |

Откуда это берётся: схема платы, если Waveshare её опубликует; пример из их
SDK; либо чтение прошивки-примера, если она идёт с платой.

**ЗАКРЫТ 2026-08-26 по проверке в ESP Component Registry.** Снимать
параметры с железа не требуется — Waveshare публикует готовый стек
в собственном пространстве имён реестра компонентов:

| Компонент | Версия | Что даёт |
|---|---|---|
| `waveshare/esp32_p4_wifi6_touch_lcd_5` | 1.0.4 | BSP платы: инициализация HX8394, подсветка `bsp_display_brightness_init()`, `bsp_display_backlight_on/off()`, `bsp_display_brightness_set(0–100)` |
| `waveshare/esp_lcd_hx8394` | 2.1.0 | драйвер контроллера панели по MIPI-DSI, `HX8394_PANEL_BUS_DSI_2CH_CONFIG()` — две линии; требует ESP-IDF 5.3 и выше |

Оба заявлены под цель `esp32p4`, проверено 2026-08-26.

Поворот в альбомную ориентацию включается опцией `CONFIG_LVGL_PORT_ENABLE_PPA`
в порте LVGL от Espressif — своего кода не требует. Оговорка: пропускная
способность PSRAM у PPA делится с остальной периферией, поэтому draw-буферы
LVGL делаем **частичными**, а не полноэкранными.

**Одна деталь остаётся к проверке при первой сборке.** В примере драйвера
фигурирует конфигурация `HX8394_1024_600_PANEL_30HZ_DPI_CONFIG` — под
1024×600, а не под нашу панель 720×1280. Тайминги нашей панели должны
приходить из BSP платы, а не из этого макроса; убедиться при первом выводе
картинки.

Статус: **РЕШЕНО** — раскладка альбомная, порт не пишем, берём BSP и драйвер
как есть. Подробности — [26](26-firmware-spec.md), §2.1.

## Q13. Где живут эфирные пресеты и недостающие поля станции

Поставлен 2026-08-26. Разбор — [24](24-main-build-p4.md), §3.

Штатный `/stations.json` MiniWebRadio держит в записи четыре строки:
признак избранного, код страны, название, URL. В него не влезают
`stationuuid`, `codec`, `bitrate`, `last_verified`, `source`, которые мы
собирались хранить ([14](14-software-stack.md), §3), и **нет места для
эфирных пресетов** — прошивка про УКВ/FM ничего не знает, а в
[22](22-mode-switching.md) принят единый банк из 8 ячеек с типом в записи.

| Вариант | Суть | Цена |
|---|---|---|
| Отдельный файл под наше | `/stations.json` не трогаем, рядом кладём свой файл с пресетами и дополнительными полями | два файла надо держать согласованными |
| Расширить формат | пятое и далее поля в той же записи | это уже форк парсера прошивки, обновления апстрима придётся переносить руками |
| Отказаться от лишних полей | живём тремя полями | теряем подтягивание URL по `stationuuid` при смене вещателем |

Наиболее болезненная потеря — `stationuuid`: без него нельзя ни отметить
клик в каталоге, ни обновить URL станции, когда вещатель его сменил
([14](14-software-stack.md), §3).

**Развёрнутая постановка — [25](25-station-storage.md)**, написана 2026-08-26
как самостоятельный документ для обсуждения со стороны. Там же разобрано,
**почему пятое поле в записи не работает**: парсер прошивки не разбирает JSON,
а считает кавычечные строки по кругу и не сбрасывает счётчик на границе
записи, поэтому лишний элемент сдвигает весь остаток файла на одно поле.

**РЕШЕНО 2026-08-26 — «перевёрнутый» вариант 1.** Мастером становится наш
файл `/ipradio.json`, а `/stations.json` — производная проекция, которую
генерирует наш код и перечитывает прошивка вызовом `updateStationsList()`.
Связь нужна только в одну сторону, поэтому вопрос ключа исчезает, а не
решается. Форк не берём.

Решение принято по двум сторонним разборам; их ключевые утверждения
проверены по исходникам, плюс проверено то, чего не проверил ни один разбор:
`updateStationsList()` начинается с `clearStations()` и сброса счётчика,
поэтому повторный вызов не удваивает список. Разбор целиком —
[25](25-station-storage.md), §9.

Подтверждено там же: веб-интерфейс переписывает `/stations.json` целиком
при любой правке; предел 999 станций реально зашит в парсере
(`if (m_staCnt > 999) break;`); поле `fav` занято прошивкой под отметки
`*`, `1`, `2`, `3`.

**Отменено 2026-08-26 в тот же день.** Прошивка пишется с нуля
([26](26-firmware-spec.md), §3), чужого парсера в приборе нет, и схема
«мастер + проекция» вместе с ним теряет смысл. Список станций — просто наш
файл `/ipradio.json`. Разбор сохранён: [25](25-station-storage.md), §10.

Статус: **снят** — вопрос исчез вместе с зависимостью, а не был решён

## Q14. Сохранность данных при снятии питания на ESP32

Поставлен 2026-08-26.

Документ [10](10-shutdown-and-data-safety.md) обосновывает, почему прибор
можно гасить питанием и почему **батарея не нужна**. Всё обоснование
построено на Linux: корень в overlayfs, отдельный раздел данных под `ro`
с `remount,rw` на время записи, атомарная замена через `rename()` на ext4.
На ESP32 с картой, смонтированной как FAT, ничего из этого нет — значит,
и вывод «дёрнуть шнур безопасно **по конструкции**» больше ничем не
подкреплён.

Что надо установить, прежде чем повторять этот вывод:

1. что гарантирует драйвер FATFS в ESP-IDF при пропадании питания в момент
   записи — и является ли там переименование файла атомарным;
2. насколько устойчива NVS, куда по [08](08-cost-and-board-choice.md), §9
   пишутся настройки Wi-Fi, громкость и последняя станция;
3. нужна ли схема A/B с контрольной суммой на уровне наших файлов, раз
   файловая система гарантий не даёт.

Ни один из трёх пунктов по документации не проверялся — это работа,
а не пересказ.

**Решение заказчика 2026-08-26: ставим батарею**, чтобы не было провалов
питания. Штатный разъём на плате для этого есть — в описании товара Waveshare
указан «MX1.25 Lithium Batt header, MX1.25 2PIN, for 3.7V Lithium Batt,
supports charging and discharging» (прочитано 2026-08-26).

Что батарея даёт и чего не даёт:

| | |
|---|---|
| **Закрывает** | внезапное пропадание питания в момент записи на карту: начатая запись успевает завершиться |
| **Не закрывает сама по себе** | софт не узнаёт, что внешнее питание исчезло, и прибор работает дальше, пока батарея не сядет — тогда получаем тот же резкий обрыв, только позже и в непредсказуемый момент |
| **Не закрывает** | случай снятой или деградировавшей батареи; атомарности записи от батареи не появляется |

Поэтому к батарее нужны две вещи:

1. **Признак «внешнее питание пропало»** — линия состояния зарядника либо
   наличие VBUS. Выведена ли такая линия на этой плате, неизвестно: схему
   Waveshare не публикует (та же причина, что в Q11). Выясняется по приходу.
2. **Что прибор по этому признаку делает** — как минимум перестать писать
   на карту и предупредить на экране, лучше — завершиться корректно.

Усилителя TPA3118 это не касается: он питается от внешних 12 В, на батарее
звук пропадёт в любом случае. Речь только о сохранности данных.

**[добавлено 2026-08-27 по схеме]** Измерение напряжения батареи на плате
**есть**: `BAT` → R12 200 кОм → `BAT_ADC` → R15 100 кОм → земля, то есть
делитель **1:3**, и цепь заведена на **GPIO20**. Полные 4,2 В дают 1,4 В
на входе АЦП.

Это **не прямой** признак «внешнее питание исчезло», но косвенно работает:
пока внешние 5 В есть, зарядник держит батарею у напряжения заряда, как
только пропали — напряжение начинает падать. С неизбежной задержкой.

**[проверено 2026-08-27] У зарядника ETA6098 (U19) выход состояния есть —
вывод 9 `STAT`, цепь подписана «change» (очевидная описка разработчика
платы вместо «charge»). Но на процессор он не разведён: идёт только
на контрольную точку **TP1** и больше никуда.**

Это, впрочем, хорошая новость. Контрольная точка — нормальная площадка,
паять к ней несравнимо проще, чем к конденсатору типоразмера 0201. Провод
с TP1 на любой свободный вывод даёт **прямой** признак.

Как их сочетать:

| Источник | Что даёт | Чего не даёт |
|---|---|---|
| `STAT` с TP1 | быстрый фронт в момент пропадания питания | сам по себе не различает «заряд окончен» и «питания нет» — в обоих случаях выход обычно в высокоимпедансном состоянии |
| `BAT_ADC` на GPIO20 | уровень напряжения батареи | реагирует с задержкой |

Вместе они дают однозначную картину: `STAT` ловит момент, `BAT_ADC`
отличает «зарядились и стоим» от «питание пропало и разряжаемся».

Свободные выводы под провод с TP1 есть в обеих раскладках
([30](30-pin-assignment.md)); в варианте с расширителем их шесть.

Статус: **батарея принята, обоснование неполное** — нужен признак пропадания
внешнего питания и проверка гарантий FATFS и NVS (пункты 1 и 2 выше).
