Spok1978/hybrid-radio/docs/09-power-supply.md

# 09. Питание

> **НЕАКТУАЛЬНО — ревизия на Raspberry Pi.** С 2026-08-26 приёмник строится
> только на плате Waveshare ESP32-P4-WIFI6-Touch-LCD-5 ([24](24-main-build-p4.md)),
> Raspberry Pi в проекте не используется. Бюджет тока, ввод 5 В и измерения
> здесь — под Pi. Из документа в действующую схему перенесены только входная
> защита (§4) и отдельные 3,3 В тюнера (§8); их актуальное описание и номиналы —
> [33](33-carrier-board.md) и [35](35-carrier-boards-parts.md). Остальное для сборки не применять.

**Решение от 2026-08-18: вход 12 В от внешнего блока питания.**
Плата — Raspberry Pi 3 Model B+.

Раздел 0 — почему так, а не 5 В (сохранён разбор трёх вариантов).
Дальше расписан принятый вариант.

## 0. Почему 12 В, а не 5 В

Вопрос возник так: «раз с Type-C столько возни, не проще ли 12 В?»
Честный ответ: **сама по себе 12 В не проще** — она не убирает узлы, а
добавляет понижающий преобразователь. Возня с Type-C сводилась к двум
резисторам 5,1 кОм и исчезала при покупке готовой платы-переходника.

| | A. Type-C 5 В | B. Гнездо 5 В | **C. Гнездо 12 В** |
|---|---|---|---|
| Лишние узлы | нет | нет | **buck 12→5 В** |
| Резисторы CC 5,1 к | нужны | не нужны | не нужны |
| Чувствительность к проводам | высокая (запас 0,3 В) | высокая | **отсутствует** |
| Источник | зарядник телефона | блок 5 В / 3 А | блок 12 В / 3 А |
| Максимум по звуку | 2,5 Вт | 2,5 Вт | **10–15 Вт** |
| Риск помех приёмнику | низкий | низкий | **средний, требует проверки** |
| Автономная работа | повербанк | повербанк | 12 В свинец / авто |

Выбран **вариант C** ради двух вещей:

1. **Проблема просадки снимается полностью.** Стабилизатор стоит внутри
   прибора, поэтому сопротивление шнура и разъёма перестаёт иметь значение.
   Вся дисциплина «20 AWG, короткий кабель, запас 0,3 В» уходит с повестки.
2. **Усилитель питается 12 В напрямую, мимо преобразователя.** Это меняет
   класс звука: вместо 2,5 Вт получаем расчётный потолок

   ```
   P_max ≈ V² / (2·R) = 12² / (2·4) = 18 Вт   на 4 Ω, теоретический предел
   ```

   реально меньше на потери в ключах и выходном фильтре — ориентир
   10–15 Вт при 10 % THD; точное значение смотреть по графику
   «Maximum Output Power vs Supply Voltage» в даташите модуля.

Плата за это — раздел 6: преобразователь шумит ровно в той полосе, которую
мы принимаем.

**Следствие для звукового тракта:** усилитель меняется с PAM8302A (максимум
5,5 В питания) на **TPA3118D2**, см. [04-audio-path.md](04-audio-path.md).

## 1. Архитектура

```
   внешний блок 12 В / 3 А
            │
   гнездо 5,5×2,1 (центр «+»)
            │
     [предохранитель 3 А]
            │
     [защита от переполюсовки: P-MOSFET]
            │
     [TVS на 12 В: SMBJ13A]───GND
            │
      ТОЧКА ЗВЕЗДЫ 12 В ──────┬──────────────────────────┐
            │                 │                          │
            │          УНЧ TPA3118D2                buck 12→5 В
            │          + 470…1000 мкФ / 25 В        (модуль ≥3 А,
            │                 │                      выход 5,1 В)
            │              динамик 4 Ω                    │
            │                                    ТОЧКА ЗВЕЗДЫ 5 В
            │                                             │
            │                              ┌──────────────┴────────┐
            │                        Pi 3B+ (micro-USB)      LDO 3,3 В
            │                        └─ дисплей с GPIO       → тюнер
            │                                                (феррит + LC)
           GND ── все земли сходятся в одной точке у гнезда
```

## 2. Исходные данные (официальные)

Из документации Raspberry Pi (`power-supplies.adoc`, проверено 2026-08-18):

| Параметр Pi 3 Model B+ | Значение |
|---|---|
| Рекомендуемый ток блока питания | 2,5 А (по шине 5 В) |
| Типовое потребление самой платы | 500 мА |
| Максимальный суммарный ток на USB-порты | 1,2 А |
| Порог схемы контроля напряжения | срабатывает ниже **4,63 В (±5 %)** |

Порог 4,63 В никуда не делся — просто теперь за него отвечает преобразователь
внутри прибора, а не шнур от зарядника. Поэтому выход buck настраиваем на
**5,1 В** (не выше 5,25 В — это предел шины 5 В по спецификации USB).

## 3. Бюджет тока и выбор блока питания

По шине 5 В (за преобразователем):

| Потребитель | Ток |
|---|---|
| Pi 3B+ в работе | 0,5 А типовое, пики выше при Wi-Fi и загрузке |
| Экран 7″ DSI (C) | ≈0,5 А — **оценка**, производители цифру не публикуют |
| Тюнер через LDO 3,3 В | ~25 мА |
| **Итого по 5 В** | **≈1,0–1,7 А** |

Пересчёт на вход 12 В при КПД преобразователя ~85 %:

```
P(5 В) = 5,1 В × 1,7 А ≈ 8,7 Вт   →   I(12 В) ≈ 8,7 / (12 × 0,85) ≈ 0,85 А
```

Усилитель питается от 12 В напрямую:

```
при отдаче 12 Вт и КПД класса D ~90 %  →  P(вход) ≈ 13,5 Вт  →  I ≈ 1,1 А
на музыке средний ток заметно ниже, пики выше
```

**Итого: ~2 А в пике. Блок питания берём 12 В / 3 А (36 Вт)** — запас нужен,
иначе на басовых пиках просядет напряжение и вылезут искажения.

Требования к блоку:

- **стабилизированный импульсный**, а не трансформаторный нестабилизированный:
  у последних без нагрузки на выходе бывает 16–18 В;
- разъём **5,5×2,1 мм, центральный контакт «плюс»** — записать в документацию
  прибора и подписать на корпусе;
- внешний, в корпус прибора сетевое напряжение не заводим вообще.

## 4. Входной узел

| Элемент | Номинал | Зачем |
|---|---|---|
| Гнездо питания | 5,5×2,1 мм | вход |
| Предохранитель | 3 А (плавкий или самовосстанавливающийся) | КЗ внутри прибора |
| **Защита от переполюсовки** | P-канальный MOSFET в плюсовой шине | «плюс» на гнезде — не стандарт де-факто, рано или поздно воткнут не тот блок |
| TVS-диод | **P6KE16A** (осевой) либо SMBJ14A (SMD) | выбросы при горячем подключении |
| Электролит на входе | 220–470 мкФ / 25 В | буфер перед преобразователем |

Про переполюсовку — **включение исправлено 2026-08-21**, раньше здесь было
написано наоборот и защита бы не работала:

```
   от предохранителя ──► СТОК (вывод 2, он же фланец TO-220)
                          IRF4905
   шина 12 В        ◄──── ИСТОК (вывод 3)
   ЗАТВОР (вывод 1) ──[100 кОм]──► GND
   стабилитрон 1N4744A: анод к затвору, катод к истоку
```

Почему именно так. У P-канального транзистора паразитный диод направлен
**от стока к истоку** (анод — сток). При правильной полярности он смещён
в прямом направлении, ток идёт сразу, а затем затвор оказывается на 12 В
ниже истока и канал открывается полностью. При переполюсовке паразитный
диод заперт, и затвор не ниже истока — транзистор закрыт, нагрузка
обесточена.

Если поменять сток и исток местами (как было написано в первой редакции),
то при переполюсовке паразитный диод окажется **смещён в прямом направлении**
и пропустит обратный ток в устройство. Защита превратится в её видимость.

Потери: RDSon около 0,02 Ом при VGS −10 В, то есть ~0,2 Вт при 3 А —
радиатор не нужен. Диод Шоттки на этом же месте рассеивал бы ~0,8 Вт.

**Внимание на номинал TVS:** здесь 12 В, а не 5. TVS на 5 В, поставленный
по привычке, просто закоротит вход.

**И на запас по напряжению.** Рабочее обратное напряжение TVS (V_RWM) должно
быть заметно выше 12 В: у стабилизированного блока с допуском ±5 % на выходе
бывает 12,6 В, а ток утечки TVS растёт задолго до напряжения пробоя.
Поэтому **P6KE16A (V_RWM 13,6 В)**, а не P6KE15A (12,8 В) и не SMBJ13A (13 В) —
последние стоят к шине слишком близко. Исправлено 2026-08-21 по итогам аудита.

## 5. Преобразователь 12 → 5 В

Требования:

- ток **не менее 3 А непрерывно** при выходе 5 В (нужно 1,6 А, берём вдвое);
- **синхронный** модуль. Как отличить: у синхронного нет внешнего диода
  Шоттки — нижний ключ встроен в микросхему. Если на плате рядом с дросселем
  стоит диод (SS34, B540 и т. п.) — модуль несинхронный, не берём.
  **Несинхронные, вопреки распространённому мнению: LM2596, XL4015, XL4016,
  MP1584.** Синхронные из распространённых — SY8205, MP2307 («Mini360»),
  MP2315. Проверено по даташитам 2026-08-21;
- почему это важно именно нам: у несинхронного модуля весь ток в фазе
  выключения идёт через внешний диод, а его жёсткое восстановление даёт
  широкополосный «мусор» — прямо в нашу полосу приёма 65–108 МГц;
- выход регулируемый — **выставить 5,1 В до подключения Pi**, измерив
  тестером на холостом ходу, и только потом подключать нагрузку;
- собственная развязка: 220 мкФ на входе, 220–470 мкФ на выходе, керамика
  0,1 мкФ рядом с выводами;
- **регулируемый, а не с фиксированными 5,0 В.** У SY8205 в продаже есть обе
  версии, на фиксированной выставить 5,1 В не получится;
- про MP2307 («Mini360»): чип заявлен на 3 А, но сам модуль с крошечным
  дросселем и без теплоотвода длительно отдаёт заметно меньше. Нам нужно
  1,7 А непрерывно — запас почти нулевой. **Предпочтителен SY8205.**

### Фильтр: не в общей шине, а в чувствительных ветвях

**Исправлено 2026-08-21.** В первой редакции дроссель 10 мкГн стоял
последовательно в общей шине 5 В, перед всеми потребителями. Так делать не надо:

- последовательный дроссель с большой ёмкостью после него образует
  колебательный контур, а нагрузка со стороны Pi импульсная;
- на активном сопротивлении дросселя теряется напряжение как раз там, где
  запас и так мал.

Правильнее фильтровать **только те ветви, которым это нужно**:

```
   выход преобразователя ──┬──► Pi + дисплей   (напрямую, + 470 мкФ и 0,1 мкФ)
                           │
                           └──[дроссель 10 мкГн]──► LDO 3,3 В → тюнер
                                                     (+ ферриты, п. 8)
```

ЦАП PCM5102A питается от общей шины: у него своя внутренняя стабилизация,
и по шине 5 В он некритичен.

Порядок настройки (обязательно именно так):

1. подать 12 В на модуль, к выходу ничего не подключать;
2. крутить подстроечник, пока тестер не покажет **5,10 В**;
3. отключить питание, подключить Pi, включить, измерить снова под нагрузкой —
   должно остаться не ниже 4,9 В;
4. измерить **на самой плате Pi** (контакты 2 и 6 колодки), а не только на
   выходе преобразователя: падение на кабеле micro-USB как раз то, что
   съедает запас.

## 6. Помеха от преобразователя — главный риск конструкции

Buck работает на сотнях килогерц, и его гармоники с широкополосным «мусором»
попадают ровно в наши **65–108 МГц**. Проявление: подъём шума, «цыканье»,
пропадание слабых станций. Это плата за 12 В, и она реальна.

Меры, по убыванию эффективности:

1. **Разнести физически.** Преобразователь — в дальнем от тюнера и антенны
   углу корпуса. Антенный ввод и тюнер — в противоположном.
2. **Экран.** Преобразователь в жестяной коробочке, соединённой с землёй
   в одной точке.
3. **LC-фильтр на выходе преобразователя**: дроссель 10 мкГн + 100–220 мкФ,
   затем керамика 0,1 мкФ.
4. **Ферритовые кольца** на входном и выходном проводах преобразователя
   (2–3 витка).
5. **Отдельный LDO 3,3 В для тюнера** (раздел 8) — линейный стабилизатор
   давит остатки пульсаций, которые прошли фильтр.
6. Питание тюнера и его земля — отдельной витой парой от точки звезды,
   а не «по дороге» вместе с цифрой.

**Проверяется только приёмом на макете.** Порядок проверки — раздел 13, п. 4.
Если помеха окажется неустранимой, запасной ход: питать тюнер от отдельного
маленького линейного источника или вернуться к варианту B (5 В на входе).

## 7. Ввод 5 В в Raspberry Pi

| Способ | Плюсы | Минусы |
|---|---|---|
| **micro-USB разъём Pi** (короткий кабель от преобразователя) | сохраняется штатная входная защита платы | контактное сопротивление разъёма |
| GPIO, контакты 4 (+5 В) и 6 (GND) | нет потерь на micro-USB | обходит входную защиту Pi |

Рекомендую micro-USB: через него идут только Pi и дисплей (≈1,0–1,6 А).
При переходе на питание через GPIO обязательно ставить свой предохранитель
2,5–3 А взамен обойдённого штатного.

**Никогда не подавать питание одновременно и в micro-USB, и в GPIO.**

Дисплей питается штатно — своим кабелем с контактов 2 и 6 GPIO, то есть
его ток идёт через вход Pi. Так предусмотрено производителем.

## 8. Отдельные 3,3 В для тюнера

RDA5807M питается **2,7–3,3 В** (по даташиту, см. [02](02-fm-frontend.md)),
**5 В на него подавать нельзя**.

Брать 3,3 В с колодки GPIO технически можно (25 мА — мелочь), но эта шина
общая с цифрой и шумная, а на ней у нас висит радиоприёмник. Ставим свой
LDO от шины 5 В:

- **MCP1700-3302 / HT7333 / LP2985-3.3 — малошумящие**, предпочтительны;
- AMS1117-3.3 — доступнее, но шумнее и с большим током покоя.

Обвязка: 10 мкФ + 0,1 мкФ на входе и на выходе, ферритовая бусина
последовательно по питанию тюнера.

## 9. Земля и разводка

- Все земли сходятся в **одной точке** — у входного гнезда.
- Земля усилителя и земля цифровой части в других местах не соединяются.
- Земля суммирующего аудиоузла (см. [04](04-audio-path.md), п. 3.1) —
  одним проводом к земле усилителя.
- Оплётка антенного кабеля — к земле тюнера, оттуда одним проводом к точке звезды.
- Силовые линии 12 В внутри корпуса — 20 AWG (0,5 мм²), пайка. Требование
  мягче, чем было при 5 В, но DuPont-перемычкам в цепи питания по-прежнему
  не место: у них велико и сопротивление, и переходное сопротивление контакта.

## 10. Приглушение усилителя при загрузке

TPA3118 имеет вход SD (shutdown): логический ноль выключает выходной каскад,
единица включает. Даташит семейства TPA31xxD2 прямо рекомендует **держать
вывод SD в нуле при подаче питания**.

Делаем так:

```
   SD усилителя ──┬── резистор 100 кОм ── GND   (по умолчанию выключен)
                  │
                  └── GPIO Raspberry Pi        (софт поднимает, когда готов)
```

Зачем: при подаче питания и во время загрузки Pi на его выходах мусор, и без
этой цепочки в динамике будут щелчки и хлопки на каждом включении. С резистором
на землю усилитель молчит, пока программа не скажет обратное. Она же глушит
его при выключении и при переключении режимов.

## 11. Выключение и целостность карты памяти

Вынесено в отдельный документ: **[10-shutdown-and-data-safety.md](10-shutdown-and-data-safety.md)**.

Коротко, что оттуда влияет на схему питания:

- корень файловой системы — **только для чтения** (overlayfs), поэтому снимать
  питание можно в любой момент; батарея и запас хода на ионисторах не нужны;
- предусматриваем **кнопку мягкого выключения**: `gpio-shutdown` на свободном
  выводе (не GPIO3 — он занят шиной I²C тюнера) и `gpio-poweroff` на GPIO26,
  который через фиксирующий ключ снимает 12 В;
- значит на входной шине 12 В, кроме механического выключателя, появляется
  **электронный ключ с защёлкой** — учесть при компоновке.

## 12. Диагностика питания

```bash
vcgencmd get_throttled
```

Битовая маска: бит 0 — просадка **сейчас**, бит 16 — просадка **была** с
момента включения. Опрашивать раз в несколько секунд и показывать значок
питания в меню «О приборе». Прибор сам скажет, что виноват блок питания,
а не программа.

## 13. Что проверить на макете

1. **До подключения Pi:** выход преобразователя выставлен на 5,10 В на холостом ходу.
2. Полярность гнезда и работа защиты от переполюсовки — подать 12 В наоборот
   и убедиться, что дальше защиты напряжения нет.
3. Напряжение на плате Pi (контакты 2 и 6 GPIO) под нагрузкой: громкий звук
   плюс загрузка Wi-Fi. **Не ниже 4,9 В.**
4. **Помеха от преобразователя.** Настроиться на слабую станцию, послушать.
   Затем выключить преобразователь (питая Pi временно от отдельного блока
   5 В) и сравнить уровень шума. Разница и есть вклад buck.
5. `vcgencmd get_throttled` после часа работы — должно быть `0x0`.
6. Реальный ток дисплея — амперметром в его питающий провод.
7. Отсутствие щелчков при включении и выключении (проверка цепи SD).
8. Десять циклов «выключил рубильником — включил» — система должна подниматься
   (это проверка overlayfs).

## 14. Перечень по питанию

| Поз. | Наименование | Кол-во |
|---|---|---|
| P1 | Блок питания внешний **12 В / 3 А**, стабилизированный, штекер 5,5×2,1 «+» в центре | 1 |
| P2 | Гнездо питания 5,5×2,1 на корпус | 1 |
| P3 | Держатель предохранителя + предохранитель 3 А | 1 |
| P4 | P-канальный MOSFET для защиты от переполюсовки + резистор 100 кОм + стабилитрон 12–15 В | 1 компл. |
| P5 | TVS-диод **SMBJ13A / SMAJ14A** (12 В) | 1 |
| P6 | Понижающий преобразователь 12→5 В, синхронный, **≥3 А**, регулируемый | 1 |
| P7 | Электролиты: 220–470 мкФ / 25 В (вход), 220–470 мкФ / 10 В (выход buck), 470–1000 мкФ / 25 В (у УНЧ) | 3 |
| P8 | Керамика 0,1 мкФ | 5–6 |
| P9 | Дроссель 10 мкГн (фильтр на выходе buck) | 1 |
| P10 | LDO 3,3 В малошумящий (MCP1700-3302 / HT7333) + 10 мкФ ×2 | 1 |
| P11 | Ферритовые бусины / кольца | 3–4 |
| P12 | Провод 20 AWG (0,5 мм²) | ~1 м |
| P13 | Выключатель питания на входе 12 В (3 А и выше) | 1 |
| P14 | Короткий кабель от преобразователя к micro-USB Pi | 1 |

## 15. Источники

- Официальная таблица питания Raspberry Pi (2,5 А для 3B+, типовое потребление
  платы 500 мА, порог контроля напряжения 4,63 В ±5 %):
  https://github.com/raspberrypi/documentation/blob/master/documentation/asciidoc/computers/raspberry-pi/power-supplies.adoc
  (прочитано 2026-08-18)
- Даташит TPA31xxD2 (TPA3116D2 / TPA3118D2 / TPA3130D2), Texas Instruments:
  диапазон питания до 26 В; фиксированные усиления 20 / 26 / 32 / 36 дБ,
  задаются делителем на выводе GAIN/SLV; входы смещены на 3 В (нужны
  разделительные конденсаторы); входное сопротивление от 60 кОм при 20 дБ
  до 9 кОм при 36 дБ; режим PBTL (LINP/LINN на землю); рекомендация держать
  вывод SD в нуле при включении питания.
  https://www.ti.com/lit/ds/symlink/tpa3118d2.pdf (прочитан локально 2026-08-18)
- Питание дисплея с контактов 2 и 6 GPIO:
  https://www.raspberrypi.com/documentation/accessories/touch-display-2.html
- `gpio-shutdown` и пробуждение замыканием GPIO3 (вывод пробуждения не
  переносится): https://forums.raspberrypi.com/viewtopic.php?t=113200
- Расчёт мощности мостового каскада P ≈ V²/(2R) и пересчёт токов через КПД —
  арифметика, показана в тексте.

Ссылки проверены 2026-08-18.
