Spok1978/hybrid-radio/docs/18-similar-projects.md

# 18. Разбор похожих проектов

Оба — гибриды «эфир + интернет» с тем же тюнером RDA5807, что у нас.
Смотрела на предмет решений, которые можно забрать.

## 1. Что это за проекты

**A. «1960s Clock Radio Pi Makeover», Alan Boris** (Hackster, апрель 2024, GPL3+).
Часы-радио шестидесятых, переделанные на Raspberry Pi.

| Узел | Что стоит |
|---|---|
| Вычислитель | Raspberry Pi 4 Model B |
| Экран | Adafruit PiTFT Plus 480×320, 3,5″ |
| Тюнер | модуль RDA5807 (по I²C) |
| **Коммутация звука** | **аналоговый ключ MAX4544 (SPDT), управляется с GPIO** |
| Усилитель | TPA2016, 2×2,8 Вт класс D |
| Ввод | энкодер Stemma QT по I²C, кнопки |
| Питание | панельное гнездо USB-C |
| Софт | balenaCloud, пять контейнеров: звук, браузер, контроллер на Python, fbcp, веб-сервер на Node |

**B. «All in one DSP Radio + Internet Radio», asmnoak** (PCBWay + GitHub).
XIAO ESP32S3, тюнер RDA5807FP, ЦАП PCM5102, экран SSD1306 64×32,
управление через браузер, недельное расписание включения.

| Узел | Что стоит |
|---|---|
| **Коммутация звука** | **аналоговый ключ ADG884** |
| Громкость | **регулируется отдельно для каждого режима** |
| Список станций | частоты и названия **прописаны в скетче руками** |

## 2. Главная находка: оба выбрали аналоговый ключ, а не пассивную сумму

Два независимых автора решали ровно нашу задачу — свести эфирный тракт и
интернет-тракт на один усилитель — и **оба поставили аналоговый ключ**:
MAX4544 у одного, ADG884 у другого. Пассивным сумматором не пошёл никто.

Это ровно тот вариант, который у нас разобран в [04](04-audio-path.md) как
«Схема 2 — аналоговый коммутатор» и отклонён в пользу пассивной суммы. И это
именно то место, к которому цеплялись внешние аудиты: предположение, что
заглушённый источник ведёт себя как низкоомный шунт, расчётом не доказывается.

### Чем ключ реально лучше в нашем случае

- источники полностью развязаны, взаимного влияния нет;
- **у каждого источника может быть свой подстроечник уровня** — а это снимает
  всю возню с подбором резисторов 1 кОм против 10 кОм под разницу 360 мВ и
  2,1 В. Уровни выставляются раздельно и независимо;
- управление ложится на отдельную линию GPIO, режимом распоряжается софт.

### Чего оба автора не написали, а нам это важно

**Односупплайный аналоговый ключ не пропустит наш сигнал без смещения.**
Выход PCM5102A центрирован относительно земли, 2,1 В действующего — это
около **±3 В амплитуды**, то есть сигнал уходит ниже нуля. КМОП-ключ с
питанием от одной шины 5 В отрежет всю отрицательную полуволну.

Лечится, но не бесплатно: каждый вход ключа надо развязать конденсатором и
подтянуть к середине питания делителем, а после ключа снова развязать.
Это плюс четыре-шесть деталей и ещё одно место, где можно ошибиться.

У Alan Boris этой проблемы почти нет: он коммутирует выход звуковой карты
Pi, у которого уровень заметно ниже, а MAX4544 умеет работать и от
двуполярного питания. У нас источник горячее.

### Что делаем

**Порядок не меняем, макет собираем на пассивном сумматоре как спроектировано.**
Причины: детали уже едут, сумматор — это четыре резистора, а его слабое место
проверяется измерением за десять минут ([15](15-wiring-breadboard.md), п. 7.2).

**Аналоговый ключ переводим из отклонённых в запасной план №1.** Если замер
покажет, что источники влияют друг на друга или уровни не выравниваются
номиналами — ставим ключ, и тогда:

- MAX4544 (SPDT) или ADG884 (два SPDT) — если найдутся; 74HC4053 — бюджетная
  замена, у неё выше сопротивление открытого канала, но вход усилителя 30 кОм
  это стерпит;
- L и R каждого источника по-прежнему суммируются двумя резисторами, ключ
  выбирает уже готовое моно;
- **обязательно** смещение середины питания на входах ключа и развязка
  конденсаторами с обеих сторон;
- перед переключением звук глушится программно, иначе будет щелчок.

## 3. Приём с интерфейсом у Alan Boris — интересный, но не наш

Он не стал писать интерфейс вообще. Локальный веб-сервер на Node отдаёт
страницы, браузер показывает их на экране через fbcp, а нажатия кнопок с GPIO
уходят по WebSocket и дёргают JavaScript на этой же странице.

Побочный эффект: **веб-интерфейс с телефона получается сам собой** — это та
самая развилка, которую мы закрыли в Q9 отказом. У него она разрешена в другую
сторону: интерфейс один, и он веб.

Почему не берём: у нас плата ESP32-P4 с нативным интерфейсом на сенсорном
экране, браузера нет, веб-интерфейс отклонён (Q9 в [06](06-open-questions.md)).
Плюс пять контейнеров на balena — это инфраструктура толще самого прибора.

## 4. Мелочи, которые стоит забрать

**Раздельная громкость по режимам** (проект B) — ровно то, что у нас уже
записано как `VolumeBackend` в [14](14-software-stack.md). Независимое
подтверждение, что это не выдумка, а нормальная практика.

**Механическая кнопка старого корпуса плюс микропереключатель на стойках**
(проект A): он сохранил родную большую кнопку «дремать» с длинным толкателем,
подставив под неё игровой микрик. Пригодится, если по Q8 пойдём в корпус
от старой техники.

**Недельное расписание включения** (проект B) — приёмник сам включается в
заданное время. В наших требованиях этого нет, но идея хорошая: будильник из
радиоприёмника получается почти бесплатно.

Часы для этого у платы P4 свои, на плате есть разъём батарейки
([24](24-main-build-p4.md), §1), отдельный модуль RTC не нужен.

*Неактуально (ревизия на Raspberry Pi, отменена 2026-08-26):* принято в
развитие 2026-08-21 — модули DS3231 у заказчика уже есть,
покупать нечего. Проработка — [19-future-features.md](19-future-features.md), п. 1,
включая приём, до которого авторы обоих проектов не дошли: выход будильника
DS3231 подаётся на тот же фиксирующий ключ, что и кнопка питания, и прибор
включается сам, ничего не потребляя в выключенном состоянии.

**Adafruit делает фирменный модуль RDA5807** с документированной распиновкой.
Если у купленного клона RRD-102V2.0 окажется каша с выводами — это запасной
вариант, где хотя бы понятно, что куда.

## 5. Итог

| Что | Решение |
|---|---|
| Аналоговый ключ вместо пассивной суммы | **запасной план №1**, с обязательным смещением середины питания |
| Браузер как единственный интерфейс | не берём (Q9) |
| Раздельная громкость по режимам | уже есть у нас |
| Родная кнопка корпуса через микрик | забрать, если корпус будет винтажный |
| Расписание включения | отложенная идея; часы у платы P4 свои |
| Фирменный модуль RDA5807 | запасной вариант при проблемах с клоном |

Из заказа при этом ничего не меняется.

## 6. Третий проект: iRadio (radiolab81) — архитектура из демонов

Прочитано 2026-08-21. Сначала поправка к описанию, которое пришло вместе
со ссылкой: `mediaplayerd` там отвечает не за воспроизведение вообще, а за
**обнаружение и проигрывание с USB-носителей**; звук рендерит **VLC**,
завёрнутый в демон `vlcd`. Отдельного демона тюнера RDA5807 нет — есть
`dabd` для DAB+, а RDA5807 один из нескольких способов приёма.

### Что это

C/C++, Raspbian, платы от Pi 1A до Pi 4. Демоны: `gpiod` (кнопки, энкодеры,
жесты), `displayd` (экраны), `dabd`, `mediaplayerd`, `vlcd`, `speakingd`
(синтез речи), `magicEyed` (имитация лампового индикатора EM34/EM84),
`noised` (шум настройки). Обмен — **UDP на localhost** (например, порт 9914
для команд DAB, 9294 для сведений о звуке). Центрального хранилища состояния
нет: каждый демон держит своё и синхронизируется сообщениями.

Приёмные тракты: RDA5807 по I²C, RTL-SDR, DAB+, и даже передача на GPIO4.

### Почему у них так — и почему это не наш случай

Разделение на демоны у них не про надёжность, а про **комбинаторику
железа**. iRadio — это конструктор: платы от Pi 1 до Pi 4, экраны LCD /
OLED / TFT / e-Ink, приём интернет / DAB+ / УКВ / SDR. Демон на класс
устройств — естественная граница подключаемого модуля. У нас **одна**
зафиксированная конфигурация и один разработчик.

### Разбор по каждому демону применительно к нам

| Их демон | Что он изолирует | У нас |
|---|---|---|
| `gpiod` | потерю нажатий, если UI занят | **уже решено ядром**: ввод идёт через оверлеи `gpio-key` и `rotary-encoder`, события ждут в очереди `/dev/input` и не теряются |
| `vlcd` / плеер | падение проигрывателя | **уже отдельный процесс** — MPD, и его писали не мы |
| тюнер | зависание управления приёмом | RDA5807 после настройки **играет аппаратно**, без софта в звуковом тракте: наш процесс может умереть, эфир продолжит звучать |
| `displayd` | падение отрисовки | единственное место, где падение реально видно. Но при этом MPD играет, тюнер играет, а systemd поднимает процесс за секунды |

То есть три изоляции из четырёх у нас **уже есть**, просто получены другими
средствами. Отдельные процессы добавили бы к ним межпроцессный обмен.

### Чем платят они

Выбор UDP показателен: это обмен без гарантий доставки и порядка. На
localhost потери редки, но при переполнении буфера возможны. Для «крутнули
ручку на три щелчка» это терпимо, для «режим сменился на эфирный» потерянный
пакет означает неверное состояние на экране до следующей рассылки — значит
состояние приходится периодически перевещать. Плюс **центрального владельца
состояния нет**, а это классическая почва для расхождения: два компонента
по-разному думают, что сейчас играет.

Отдельно про наше железо: каждый демон на Python — свой интерпретатор,
десятки мегабайт. Четыре штуки на плате с 1 ГБ — заметная доля памяти,
ради которой мы эту плату и выбирали.

### Что забираем

Не количество процессов, а **дисциплину**: один владелец состояния, обмен
через очередь сообщений, ввод-вывод в отдельных потоках и маленький
управляющий сокет для отладки «послал команду — посмотрел». Записано в
[14](14-software-stack.md), §2. При такой структуре вынести любой компонент
в отдельный процесс — механическая работа.

## 7. Источники

- Alan Boris, «1960s Clock Radio Pi Makeover»:
  https://www.hackster.io/alan-boris/1960s-clock-radio-pi-makeover-867e49
  (прочитано 2026-08-21; страница отдаёт 403 обычному запросу, читалась браузером)
- Заметка о нём же на Adafruit:
  https://blog.adafruit.com/2024/05/01/upcycling-a-1960s-clock-with-raspberry-pi/
- iRadio (radiolab81): https://github.com/radiolab81/iRadio (прочитано 2026-08-21)
- asmnoak, «All in one DSP Radio-RDA5807 and Internet Radio-xiao_esp32s3»:
  https://github.com/asmnoak/All_in_one_DSP_Radio-RDA5807_and_Internet_Radio-xiao_esp32s3
  и карточка проекта на PCBWay (схема, гербер, BOM в CSV)
