Spok1978/hybrid-radio/docs/19-future-features.md

# 19. Развитие: что делаем после рабочего макета

Одно место для всего, что решено не тащить в первую сборку. Раньше это было
разбросано по документам 06, 09, 10, 14 и 18.

## 1. Часы реального времени и расписание — принято в развитие

> **Неактуально в части подключения.** Раздел написан для ревизии на
> Raspberry Pi (отменена 2026-08-26, [24](24-main-build-p4.md)): у неё не было
> часов, отсюда модуль DS3231 и выводы колодки Pi. У платы ESP32-P4 часы свои,
> на плате разъём батарейки ([24](24-main-build-p4.md), §1). Идея будильника
> (включение по расписанию через фиксирующий ключ) остаётся.

**Статус: принято 2026-08-21.** Модули **DS3231 уже есть в наличии**,
покупать ничего не нужно.

Зачем: у Raspberry Pi 3B+ **нет часов реального времени**. Без сети после
включения он не знает, который час. С DS3231 появляются сразу две вещи:
корректное время всегда и **включение по расписанию** — приёмник становится
ещё и будильником. Идея пришла из проекта asmnoak ([18](18-similar-projects.md)).

### Подключение

Та же шина I²C, что у тюнера — контакты 3 и 5 (GPIO2/GPIO3). Конфликта нет:

| Устройство | Адрес |
|---|---|
| Тюнер RDA5807M | 0x10 и 0x11 |
| DS3231 | **0x68** |
| EEPROM AT24C32 на том же модуле (если есть) | 0x57 |

Питание — с шины 3,3 В, той же, что у тюнера: тогда уровни на шине
совпадают. DS3231 работает в диапазоне, который 3,3 В перекрывает.

В `config.txt`:

```ini
dtoverlay=i2c-rtc,ds3231
```

Параметр проверен по официальному списку оверлеев: `i2c-rtc` — «Adds support
for a number of I2C Real Time Clock devices», среди параметров есть `ds3231`.

После включения оверлея нужно **отключить `fake-hwclock`**, иначе система при
загрузке будет подставлять время из файла вместо чтения микросхемы.

### Ловушка дешёвых модулей — проверить свой

У распространённых плат DS3231 (типа ZS-042) на борту стоит цепь **заряда**
батарейки. Она рассчитана на аккумуляторную LIR2032. Если в такой модуль
поставить обычную **неперезаряжаемую CR2032**, её начнёт «заряжать» — это
приводит к вздутию и течи. Лечится выпаиванием резистора зарядной цепи.

Перед установкой: посмотреть, что за батарейка стоит и есть ли цепь заряда.

### Как это ложится на наше выключение — красиво

У DS3231 есть выход будильника (INT/SQW). У нас в планах фиксирующий ключ
питания, который включается кнопкой и выключается сигналом `gpio-poweroff`
([10](10-shutdown-and-data-safety.md), п. 4).

Эти две вещи соединяются напрямую: **выход будильника DS3231 подаётся на тот
же вход защёлки, что и кнопка питания.** Тогда прибор:

- в выключенном состоянии не потребляет ничего, кроме батарейки часов;
- сам включается в заданное время и начинает играть.

Это настоящий будильник, а не «контроллер всё время включён и ждёт». Схему защёлки
проектировать сразу с двумя входами — кнопка и будильник.

## 2. Аналоговый ключ вместо пассивного сумматора: чего он стоит

Проработка запасного плана №1 по запросу от 2026-08-21. **Сейчас ничего
не меняем** — замер сумматора занимает десять минут и может показать, что
всё это не нужно ([15](15-wiring-breadboard.md), п. 7.2).

> **Поправка от 2026-08-21.** В первой редакции этого раздела я смотрела
> корпус микросхемы и не проверила готовые платы. Плата в этом классе
> существует и снимает почти все возражения — но она **не на ADG884**,
> а на MAX4544. Причём для нас она подходит лучше, чем подошёл бы ADG884.
> См. «Готовая плата» ниже; итоговая рекомендация изменена.

### Откуда взялись «±3 В» и почему это проблема только для ключа

Речь **не о питании прибора** — там всё в порядке. Речь об амплитуде
звукового сигнала.

Выход ЦАП PCM5102A — **2,1 В действующего значения**. Для синусоиды
амплитуда получается умножением на √2:

```
2,1 В × 1,414 ≈ 2,97 В  ≈ ±3 В
```

И второе: у PCM5102A выход типа **DirectPath, центрированный относительно
земли**, без постоянной составляющей. Значит сигнал ходит **от −3 В до +3 В
относительно нашей земли**, то есть половину времени находится ниже нуля.

Для сравнения, тюнер даёт 360 мВ действующего — это ±0,51 В, и он ни в
какие ограничения не упирается.

**В нынешней схеме проблемы нет вообще.** Пассивный сумматор — это резисторы
и конденсатор, а они полярности не различают: сигнал ниже нуля проходит
через резистор ровно так же, как выше. Вход усилителя TPA3118 сам смещён
внутри на +3 В, и разделительный конденсатор E3 переносит наш переменный
сигнал на это смещение. Всё сходится само.

**Проблема появляется ровно в тот момент, когда мы ставим аналоговый ключ.**
КМОП-ключ — это микросхема с питанием, и пропускать она умеет только то, что
лежит **между её шинами питания**. Сигнал, уходящий ниже нуля, ей не просто
«обрежется»: он открывает внутренние защитные диоды. Отсюда и требование
поднять сигнал к середине питания ключа.

Дальше уже арифметика запаса:

| Ключ | Питание | Середина | Максимальный размах | Наши ±3 В влезают? |
|---|---|---|---|---|
| ADG884 | до 5,5 В | 2,75 В | ±2,75 В | **нет** |
| ADG884 при питании 3,3 В (под логику контроллера) | 3,3 В | 1,65 В | ±1,65 В | **нет** |
| Плата на MAX4544 | **до 12 В** | 6 В | **±5 В** | **да, с запасом** |

Вот это и есть причина, по которой рекомендация сменилась с ADG884 на плату
с MAX4544: у неё хватает питания, чтобы наш сигнал прошёл целиком, без
предварительного ослабления.

### Что за деталь

ADG884 (Analog Devices), «0.5 Ω CMOS, Dual 2:1 MUX/SPDT Audio Switch»:

| Параметр | Значение | Следствие для нас |
|---|---|---|
| Питание | **однополярное 1,8–5,5 В** | сигнал должен лежать **между шинами питания** |
| Диапазон сигнала | «extends to the supplies» | центрированный на земле сигнал **не пройдёт без смещения** |
| Сопротивление открытого канала | 0,41–0,5 Ом | отлично, потерь нет |
| Каналы | два независимых SPDT | один под наше моно, второй — резерв под стерео |
| Переключение | break-before-make | правильно, замыкания источников не будет |
| **Корпуса** | **WLCSP 2×1,5 мм, LFCSP, MSOP-10** | **все SMD, корпуса DIP не существует** |

### Три статьи расходов

**1. Корпус — главная цена на макете.** В беспаечную плату ADG884 не
воткнуть. Нужен переходник MSOP-10 → DIP и пайка шага 0,5 мм.

**2. Смещение сигнала.** Питание однополярное, значит каждый вход ключа
надо развязать конденсатором и подтянуть к середине питания делителем.
Плюс блокировочный конденсатор по питанию ключа.

**3. Уровни.** При питании 3,3 В (чтобы совпадало с логикой контроллера) середина
1,65 В, практический размах около ±1,4 В. Наши сигналы после подстроечников
(~0,3 В действующего) влезают с запасом. Но **полный сигнал ЦАП 2,1 В
действующего — это ±3 В, и через ключ он не пройдёт.** Значит подстроечник
обязательно **до** ключа, а не после.

### Как меняется схема

```
   тюнер L ──[1 к]──┐
   тюнер R ──[1 к]──┴──► подстроечник 1 ──[C]──┬──► вход A ключа
                                    делитель смещения ┘
                                                       ключ ──[E3]──► усилитель
   ЦАП L ────[10 к]─┐                                  ▲
   ЦАП R ────[10 к]─┴──► подстроечник 2 ──[C]──┬──► вход B      │
                                    делитель смещения ┘         │
                                              GPIO ─────────────┘
```

Вместо одного сумматора с общим подстроечником — **две независимые ветви**,
у каждой свой уровень. Ключ выбирает готовое моно.

### Что придётся докупить

| Что | Кол-во |
|---|---|
| ADG884 | 1 |
| Переходник MSOP-10 → DIP | 1 |
| Подстроечник 10 кОм (второй) | 1 |
| Резистор 10 кОм для делителей смещения | 4 |
| Конденсатор плёночный 2,2–3,3 мкФ на входы ключа | 2 |
| Конденсатор керамический 0,1 мкФ по питанию ключа | 1 |
| Электролит 10 мкФ на узел смещения | 1 |

Итого около девяти позиций плюс пайка мелкого шага.

### Что получаем и что теряем

Получаем: источники развязаны полностью; уровни выставляются **раздельно**,
то есть разница 360 мВ против 2,1 В решается настройкой, а не подбором
резисторов; исчезает зависимость от предположения о низкоомном шунте и вся
возня с битом DHIZ.

Теряем: щелчок при переключении (лечится программно — mute, переключение,
unmute), девять деталей, SMD-пайку и время на заказ.

### Готовая плата: есть, но на MAX4544

**Adafruit STEMMA Analog SPDT Switch — MAX4544 12V**, артикул 5892
(файлы печатной платы у них же на GitHub). Готовый модуль с разъёмами
JST PH 2 мм, паять микросхему не надо.

Ключевое — почему она нам подходит **лучше**, чем подошёл бы ADG884:

| Параметр | Плата на MAX4544 | ADG884 |
|---|---|---|
| Питание | **3–12 В** | 1,8–5,5 В |
| Максимум коммутируемого сигнала | до величины питания, то есть **до 12 В** | до 5,5 В |
| Порог управляющего входа | **не менее 2,5 В** → 3,3 В с GPIO хватает **даже при питании 12 В** | привязан к своему низкому питанию |
| Исполнение | готовая плата с разъёмами | только SMD, переходник и пайка 0,5 мм |
| Переключение | break-before-make, ~30 нс | break-before-make |

Что это меняет практически: **питаем ключ от нашей шины 12 В**, которая
уже есть, смещение ставим на 6 В — и получаем размах ±5 В. Полный сигнал
ЦАП (±3 В) проходит **без предварительного ослабления**, то есть исчезает
требование ставить подстроечник до ключа. У ADG884 с его 5,5 В такого
запаса нет и близко.

И это ровно та плата, которую применил Alan Boris в самом близком к нашему
проекте ([18](18-similar-projects.md)).

Что докупить в этом варианте:

| Что | Кол-во |
|---|---|
| Плата Adafruit MAX4544 (артикул 5892) | 1 |
| Резистор 10 кОм — делитель смещения 12 В → 6 В | 2 |
| Резистор 100 кОм — развязка входов от узла смещения | 2 |
| Конденсатор плёночный 2,2–3,3 мкФ на входы ключа | 2 |
| Электролит 10 мкФ на узел смещения | 1 |
| Керамика 0,1 мкФ по питанию платы | 1 |

Ни переходников, ни мелкой пайки. Второй подстроечник при этом **не нужен**:
уровни можно оставить как есть и подстраивать уже после ключа.

### Насколько сложна схема с ADG884 — по официальной отладочной плате

Единственная доступная «настоящая схема» с этой микросхемой — отладочная
плата **EVAL-ADG884EBZ**, руководство **UG-428** (Analog Devices, ред. 0,
август 2012). Ниже — перечень элементов из таблицы 3 этого руководства,
прочитан из самого документа:

| Поз. | Кол-во | Что это |
|---|---|---|
| U1 | 1 | ADG884 (корпус WLCSP) |
| C1, C51 | 2 | 0,1 мкФ |
| C2, C52 | 2 | 10 мкФ (один танталовый) |
| R1, R2 | 2 | 10 кОм |
| J5 | 1 | разъём питания |
| J10–J12, J15–J17 | 6 | разъёмы RCA |
| C15, C16, C17, C27 | 4 | низкопрофильные сокеты под подключение нагрузок |
| D1, D2, T1–T5, T9 | 8 | контрольные точки |
| K5, K9 | 2 | джамперы |

**Собственно схема вокруг микросхемы — четыре пассивных элемента:**
конденсаторы по питанию (0,1 мкФ и 10 мкФ) и два резистора 10 кОм на
управляющих входах, чтобы те не висели в воздухе. В самом руководстве это
записано как отдельная особенность платы: «Logic control input always tied
either high/low to prevent a floating voltage».

Всё остальное в списке — разъёмы, контрольные точки, джамперы и посадочные
места под нагрузки. Это измерительная обвязка, а не схема включения.

**Но именно этот перечень показывает главное: узла смещения на плате нет
вообще.** Analog Devices исходит из того, что на вход подадут сигнал,
который и так лежит между шинами питания. То есть простота отладочной платы
не включает ровно ту часть, которая сложна **у нас**.

Ответ на «насколько это сложно» получается двойным:

- сама микросхема — проще некуда, четыре пассивных элемента;
- сложность не в ней, а в согласовании с нашим сигналом ±3 В относительно
  земли, и эту задачу ADI за нас не решает.

**Готовых открытых проектов с ADG884 не нашлось.** Поиск по GitHub и по
подборкам KiCad-проектов не дал ничего: деталь профессиональная, в
любительских схемах не встречается. Для сравнения, у платы Adafruit на
MAX4544 исходники открыты — EagleCAD, файлы `.sch` и `.brd` в репозитории
`adafruit/Adafruit-STEMMA-Analog-SPDT-Switch-PCB`; готовой картинки схемы
там нет, надо открывать в CAD.

### Про сам ADG884: плата существует, но не та

У Analog Devices есть **EVAL-ADG884EBZ** — отладочная плата для проверки
ADG884 в корпусе WLCSP, продаётся через DigiKey. Это лабораторный
инструмент под измерения, а не встраиваемый модуль: ставить такое внутрь
приёмника смысла нет. Массового любительского брейкаута на ADG884
не нашлось — деталь просто не из тех, что популярны в самоделках.

### Что из этого искать на AliExpress

Проверено 2026-08-21: сама плата Adafruit 5892 — **их собственный продукт,
клонов у него нет**, на AliExpress её не будет. Она продаётся у Adafruit,
Pi Hut, Pimoroni и подобных. Микросхему MAX4544 россыпью найти можно,
но это опять SMD-пайка.

Что реально есть на AliExpress, тремя группами:

**а) Микросхемы россыпью.** Нам нужен именно корпус **DIP-16**:

```
CD4053BE DIP-16
74HC4053N DIP16
```

Не брать `CD4053BM SOP-16` и подобные — это SMD.

**б) Готовые модули аудиоселектора на реле** — самое интересное для нас.
Законченные платы «переключатель входов» для усилителей: два-четыре
стереовхода, реле, выход один.

```
audio input selector relay board
2 way audio switch board relay
аудио селектор входов реле
input selector module amplifier
```

Смотреть в карточке: **чем управляется** — кнопкой с фиксацией или
логическим уровнем. Нам нужен вход управления уровнем, чтобы дёргать
с GPIO. И какое питание катушек: 5 или 12 В — у нас есть обе шины.

**в) Реле россыпью или модуль реле.**

Здесь важная тонкость: обычные модули реле, которых на AliExpress тысячи, —
это **силовые** реле на 10 А / 250 В с серебряными контактами. Для
линейного сигнала они плохи: при микротоках у силовых контактов бывает
неустойчивый переход. Нужны **сигнальные реле с позолоченными контактами**:

```
G5V-2 5V relay
signal relay gold contact DPDT
сигнальное реле G5V-2
```

Модуль реле с оптронной развязкой (`1 channel relay module 5V`) удобен тем,
что на плате уже стоят транзистор, диод и оптрон, а вход рассчитан на
логику 3,3 В — но реле там почти всегда силовое, и его стоит заменить
сигнальным.

### Найденная плата: модуль 74HC4051 / 74HCT4051 (HW-529)

Заказчик нашёл на AliExpress готовый модуль восьмиканального аналогового
мультиплексора — плата HW-529, 29×18 мм, с гребёнками по обеим сторонам.
Выводы: `E`, `S0`, `S1`, `S2`, `Z`, `Y0…Y7`, `VCC`, `GND` и — вот это главное —
**`VEE`**.

**Она решает задачу лучше, чем плата на MAX4544.** Причина одна и весомая:
у этой микросхемы есть отдельный вывод отрицательного питания, а значит
**узел смещения не нужен вообще** — сигнал проходит как есть.

#### Что говорит даташит (Nexperia, 74HC4051/74HCT4051)

- VCC — не менее 2 В и не более 10 В относительно земли; VEE — ниже VCC;
  **разность VCC − VEE не должна превышать 10 В**;
- аналоговые выводы Y0…Y7 и Z «swing between VCC as a positive limit and
  VEE as a negative limit» — то есть диапазон сигнала задаётся этими двумя
  шинами;
- **двуполярное питание ±5 В поддерживается явно**;
- при разности питаний около 2 В сопротивление открытого канала становится
  сильно нелинейным — на низком питании эти микросхемы годятся только для
  логики, не для звука.

#### Как это включается у нас

```
   VCC  = +5 В  (наша шина)
   GND  =  0 В
   VEE  = −5 В  (преобразователь ICL7660 / MAX1044)
   → диапазон сигнала ±5 В, наши ±3 В проходят с запасом,
     смещать ничего не надо

   Y0 ◄── эфир (сумма L+R тюнера)
   Y1 ◄── интернет (сумма L+R с ЦАП)
   Z  ──► [E3 3,3 мкФ] ──► вход усилителя

   S1, S2 ── на GND      (нужен выбор из двух, а не из восьми)
   S0     ── GPIO        (выбор режима, одна линия)
   E      ── GPIO        (см. ниже)
```

Из восьми каналов используем два — это не расточительство, а удобство:
`S1` и `S2` просто сажаются на землю, и мультиплексор превращается в
обычный переключатель на два положения, управляемый одной линией.

#### Бонус, которого нет ни у MAX4544, ни у ADG884: вывод E

По описанию платы: «When E is HIGH, the switches are turned off». То есть
**высокий уровень на `E` отключает все каналы разом** — это аппаратное
глушение, независимое от усилителя.

Практическая польза: при переключении режима порядок становится таким —
подняли `E` (звук отключён) → переключили `S0` → опустили `E`. Щелчка от
переключения не будет вовсе, и это дешевле, чем возиться с программным
mute обоих источников.

#### Что докупить

| Что | Кол-во | Зачем |
|---|---|---|
| Модуль 74HCT4051 (HW-529) | 1 | сам ключ |
| ICL7660 или MAX1044, корпус DIP-8 | 1 | получить −5 В из +5 В |
| Электролит 10 мкФ | 2 | обвязка преобразователя |
| Конденсатор плёночный 2,2–3,3 мкФ | 1 | развязка эфирной ветви, см. ниже |

**Четыре позиции против семи** в варианте с MAX4544, и ни одного резистора
в сигнальном пути.

Про преобразователь: нагрузка на шине VEE у аналогового ключа мизерная —
микроамперы, а ICL7660 отдаёт 10 мА. С огромным запасом. У MAX1044 есть
вывод BOOST, поднимающий частоту преобразования **выше звукового диапазона** —
если брать, то лучше именно его и с задействованным BOOST.

#### Три вещи, которые надо проверить до подачи питания

1. **Какая микросхема реально стоит на плате — HC или HCT.** Это не
   придирка: у `74HC` порог логического входа около 0,7 от VCC, то есть при
   VCC = 5 В нужно ~3,5 В, а контроллер (ESP32-P4) даёт 3,3 В — **впритык и ненадёжно**.
   У `74HCT` вход TTL-совместимый, 3,3 В хватает уверенно. В описании лота
   написано «74HCT4051», на фотографии микросхемы читается «74HC4051D» —
   то есть **надо смотреть маркировку полученной платы**. Если окажется HC:
   либо взять HCT, либо поднять управляющий сигнал транзисторным ключом
   с подтяжкой к 5 В (две детали).
2. **Не соединены ли `VEE` и `GND` на самой плате.** Прозвонить тестером
   **до** подключения преобразователя: если они замкнуты, подача −5 В
   закоротит его выход.
3. **Постоянная составляющая на эфирной ветви.** У выхода RDA5807 есть
   смещение около половины его питания, у ЦАП смещения нет. Если завести обе
   ветви на ключ как есть, при переключении получится скачок постоянного
   напряжения и глухой удар в динамике. Лечится одним разделительным
   конденсатором в эфирной ветви **перед** ключом — он в списке выше.

#### Сравнение с платой на MAX4544

| | Модуль 74HCT4051 | Плата Adafruit MAX4544 |
|---|---|---|
| Отрицательное питание | **есть вывод VEE** | нет, только однополярное |
| Смещение сигнала | **не нужно вообще** | нужно, 6 В от шины 12 В |
| Деталей докупить | **4** | 7 |
| Аппаратное глушение | **есть, вывод E** | нет |
| Управление с 3,3 В | у HCT да, у HC впритык | да, порог 2,5 В |
| Каналов | 8 (нужно 2) | 2 |
| Доступность | **AliExpress** | только Adafruit и его дилеры |
| Сопротивление канала | ~70–120 Ом | ~60–100 Ом |

Сопротивление канала в обоих случаях безразлично: вход усилителя 30 кОм,
потеря доли процента.

### Рассмотренные аналоги от TI: TS5A23157 и TS3A5018

Проверено по даташитам Texas Instruments 2026-08-21. Приведённые цифры
верны, но **решающий параметр в этом сравнении другой**.

| | TS5A23157 | TS3A5018 | Модуль 74HCT4051 |
|---|---|---|---|
| Конфигурация | двойной SPDT | четверной SPDT | 1 из 8 |
| Питание | 1,65–5,5 В, **однополярное** | 1,8–3,6 В, **однополярное** | VCC до 10 В **и отдельный VEE** |
| Отрицательная шина | **нет** | **нет** | **есть** |
| Максимальный размах при смещении | ±2,75 В (при 5,5 В) | ±1,8 В (при 3,6 В) | **±5 В при ±5 В** |
| Наши ±3 В проходят? | **нет** | **нет** | **да** |
| Сопротивление канала | 10 Ом | 10 Ом | 70–120 Ом |
| Break-before-make | да | да | да |
| Аппаратное глушение | по даташиту только входы выбора канала — уточнять | **есть, вывод EN** | **есть, вывод E** |

#### Сопротивление канала здесь не имеет значения вообще

Это главное недоразумение в таком сравнении. Ключ работает на вход
усилителя сопротивлением **30 кОм**. Считаем потерю сигнала на делителе:

```
Ron = 0,38 Ом →  30000 / 30000,38  = 99,9987 %
Ron = 10 Ом   →  30000 / 30010     = 99,967 %
Ron = 120 Ом  →  30000 / 30120     = 99,6 %
```

Разница между лучшим и худшим — **четыре десятых процента**, то есть
0,03 дБ. Неразличимо ничем.

Сопротивление канала было бы важно, если бы ключ работал на низкоомную
нагрузку вроде наушников 32 Ом: там оно и ослабляет сигнал, и вносит
искажения, потому что зависит от мгновенного напряжения. У нас не тот
случай, и выбирать по этому параметру не нужно.

#### А значение имеет наличие отрицательной шины

**У обеих микросхем TI питание однополярное.** Значит обе наследуют ровно
ту проблему, которую снимает 4051: наш сигнал ±3 В относительно земли
через них не пройдёт без смещения, а с учётом их предельного питания —
не пройдёт и со смещением:

- TS5A23157 при максимальных 5,5 В даёт середину 2,75 В и размах ±2,75 В —
  **меньше наших ±3 В**, придётся ещё и ослаблять сигнал ЦАП;
- TS3A5018 ограничен 3,6 В, то есть ±1,8 В — вдвое меньше нужного.

#### Вывод

Обе микросхемы работоспособны и хороши сами по себе, но **для нашей задачи
это шаг назад относительно модуля 4051**: те же узлы смещения, что у
ADG884, плюс меньший запас по размаху, плюс необходимость ослаблять
интернет-ветвь до ключа.

Держим их третьим эшелоном — на случай, если 4051 и MAX4544 окажутся
недоступны, а лишний делитель напряжения не смутит.

**Одно место, где TS5A23157 был бы уместнее 4051** — переход на стерео.
Он двойной SPDT и коммутирует левый и правый каналы независимо одной
микросхемой, а один 4051 так не умеет: он переключает **один** сигнал из
восьми источников. Под стерео на 4051 понадобились бы два модуля или
микросхема 4052 (сдвоенный мультиплексор 1 из 4). Пока тракт моно, это
замечание в сноску.

### Ещё две альтернативы

**А. 74HC4053 или CD4053 в корпусе DIP-16.** Втыкается в макетку без
переходника. Сопротивление открытого канала 60–80 Ом — при входе усилителя
30 кОм это потеря около 0,3 %, то есть ничто. Смещение нужно. У CD4053
есть вывод VEE: с отрицательной шиной он пропускает центрированный на земле
сигнал напрямую, но отрицательной шины у нас нет.

**Б. Малогабаритное сигнальное реле.** Смещение не нужно **вообще** — это
просто контакты. Цена: транзистор с диодом, ток катушки 30–50 мА и
механический щелчок.

### Рекомендация — изменена дважды

Итоговый порядок предпочтений на 2026-08-21:

1. **Модуль 74HCT4051 (HW-529) с отрицательным питанием −5 В.** Единственный
   вариант, где в сигнальном пути **нет ни одного узла смещения**, плюс
   бесплатный аппаратный mute на выводе `E`. Четыре позиции докупки,
   продаётся на AliExpress. Проверить маркировку HC/HCT и прозвонить
   VEE↔GND до включения.
2. **Плата Adafruit на MAX4544**, питание 12 В, смещение 6 В. Проще по
   идее (однополярное питание, ничего не надо инвертировать), но семь
   деталей и делитель смещения прямо в звуковом тракте.
3. **Сигнальное реле** — для того, кто не хочет ни смещения, ни
   преобразователя. Ценой механики и щелчка.
4. **ADG884** — только на собственной печатной плате. На макете проигрывает
   по всем статьям: SMD-корпус, мало запаса по размаху, узел смещения
   обязателен.

История правок этого раздела: сначала я рекомендовала реле, потом плату на
MAX4544, теперь модуль 4051. Каждый раз причиной было то, что находилась
деталь, снимающая ограничение предыдущей. Это нормальный ход проработки,
но полезно помнить: **всё это по-прежнему запасной план.** Сначала замер
пассивного сумматора.

## 3. Остальное отложенное

| Что | Откуда | Условие возврата |
|---|---|---|
| **Аналоговый ключ вместо пассивного сумматора** | [18](18-similar-projects.md) | запасной план №1, проработан в п. 2 выше: модуль 74HCT4051 (HW-529) с питанием ±5 В, смещение не нужно |
| **Стерео** | [04](04-audio-path.md) | **сделано**: два модуля HW-327 и два динамика ([33](33-carrier-board.md)) |
| **RTL-SDR** | [02](02-fm-frontend.md) | *неактуально*: требует Linux-платформы, с ESP32-P4 не работает |
| **Веб-интерфейс с телефона** | [06](06-open-questions.md) Q9 | отклонён (Q9) |
| **Голосовое озвучивание (Piper TTS)** | [14](14-software-stack.md) | *неактуально*: Piper рассчитан на Linux, на ESP32-P4 не переносится |
| **Младшая ревизия на ESP32-S3** | [08](08-cost-and-board-choice.md), п. 10 | *неактуально*: основная сборка уже на ESP32 (P4) |
| **Модуль Si4735/Si4732** | [02](02-fm-frontend.md) | если не хватит чувствительности RDA5807 |
| **Родная кнопка старого корпуса через микрик** | [18](18-similar-projects.md) | если по Q8 пойдём в винтажный корпус |
| **Промышленная microSD с защитой от потери питания** | [06](06-open-questions.md) Q14 | решается вместе с Q14 (сохранность данных на ESP32-P4) |

## 4. Порядок

Ничего из списка не начинается, пока не работает базовая сборка на ESP32-P4
с доп. платами ([33](33-carrier-board.md)). Часы у платы P4 свои — первым из
развития идёт **будильник** на них.

## 5. Источники

- Плата Adafruit STEMMA Analog SPDT Switch — MAX4544 12V, артикул 5892:
  https://www.adafruit.com/product/5892 и https://learn.adafruit.com/adafruit-stemma-analog-spdt-switch
  (питание 3–12 В, порог управляющего входа не менее 2,5 В; проверено 2026-08-21)
- 74HC4051 / 74HCT4051, даташит Nexperia (диапазоны VCC и VEE, ограничение
  VCC − VEE не более 10 В, поддержка двуполярного питания ±5 В):
  https://assets.nexperia.com/documents/data-sheet/74HC_HCT4051.pdf
- ICL7660 / MAX1044, преобразователь полярности (вход +1,5…+10 В, выход до
  −10 В, 10 мА; у MAX1044 вывод BOOST выводит частоту выше звукового
  диапазона): https://www.analog.com/media/en/technical-documentation/data-sheets/icl7660-max1044.pdf
- TS5A23157 «Dual 10-Ω SPDT Analog Switch» (питание 1,65–5,5 В, однополярное)
  и TS3A5018 «10-Ω Quad SPDT Analog Switch» (питание 1,8–3,6 В, однополярное,
  вывод EN): https://www.ti.com/product/TS5A23157 и https://www.ti.com/product/TS3A5018
  (проверено 2026-08-21)
- ADG884: руководство по отладочной плате UG-428 (Analog Devices, ред. 0,
  08/2012) — перечень элементов прочитан из самого документа 2026-08-21.
  Даташит и страница платы:
  https://www.analog.com/en/products/adg884.html
- Идея расписания — проект asmnoak, разбор в [18](18-similar-projects.md).
