Spok1978/hybrid-radio/docs/22-mode-switching.md

# 22. Переключение режимов: почему тумблер отменён

Решение от 2026-08-25. Вопрос заказчика: если пресеты 1–8 хранят станции обоих
типов, то нажатие пресета само по себе переводит прибор из эфира в интернет
и обратно — нужен ли тогда тумблер вообще.

Ответ: не нужен. Требование R2 переписано, [00](00-requirements.md).

## 1. Тумблер и так ничего не коммутировал

Проверено по проектным документам, а не по общим соображениям:

| Где | Что там сказано |
|---|---|
| [13](13-gpio-map.md), §1 | GPIO9 — обычный вход, `dtoverlay=gpio-key,gpio=9,label=MODE` |
| [05](05-display-and-ui.md), §2 | в таблице органов управления у тумблера обе функции были пустые |
| [04](04-audio-path.md), §2 | принята Схема 1: пассивная сумма на резисторах, неактивный источник глушится **программно** |
| [04](04-audio-path.md), §2 | даже в запасной Схеме 2 ключ ADG884 управляется «тем же GPIO, что читает тумблер», то есть логикой, а не контактами органа |
| [20](20-adg884-pinout.md) | вывод X4 макетки ADG884 подписан «управление» — это логический вход |

То есть режим уже был программным состоянием. Тумблер лишь сообщал софту
своё положение.

## 2. Почему он не просто лишний, а вредный

Как только пресет умеет переключать режим, у одного состояния появляется
**два источника истины**: положение органа на панели и переменная в программе.
Тумблер в «FM», нажали пресет с интернет-станцией — дальше любой выход плохой:

| Как разрешать конфликт | Что получится |
|---|---|
| Побеждает тумблер | пресеты не могут пересекать режимы, то есть исходная задача не решается |
| Побеждает софт | орган стоит в «FM», играет интернет; подпись на панели врёт |
| Ловим только фронт | чтобы вернуться в эфир, надо щёлкнуть туда и обратно — два движения вместо одного |

Третий вариант — это тумблер, работающий как плохая кнопка.

## 3. Принято: кнопка MODE без фиксации

Физический орган остаётся: **R4.1** прямо требует дублировать управление
физическими органами ради пожилых пользователей, а «перейти в эфир и покрутить
настройку» — частое действие, гонять его через меню неудобно.

Меняется только механика: вместо тумблера MTS-202 — тактовая кнопка,
GPIO9 и строка оверлея остаются прежними.

> **Номера выводов, `config.txt` и оверлеи в этом документе — неактуально**
> (ревизия на Raspberry Pi, отменена 2026-08-26, [24](24-main-build-p4.md)).
> Действующие выводы платы ESP32-P4 — [33](33-carrier-board.md), §2; само
> решение от платформы не зависит.

Что это даёт:

- у кнопки нет положения, поэтому рассинхрон невозможен **по построению**;
- `gpio-key` рассчитан именно на кнопку — оговорка о чтении уровня при старте
  снята из [13](13-gpio-map.md), §3 и [14](14-software-stack.md), §1.3;
- режим при включении берётся из сохранённого состояния прибора, а не с панели.

Поведение: короткое нажатие — сменить режим и продолжить с последней станции
этого режима; сам режим определяет, что делает энкодер 1 (перестройка частоты
против прокрутки списка) и что нарисовано на главном экране.

## 4. Пресеты становятся одним банком с типом в записи

Сейчас в меню они разделены: «Пресеты эфира» и «Станции интернет»
([05](05-display-and-ui.md), §3). Вместо этого — один список из 8 ячеек, где
тип хранится в самой записи:

```json
[
  {"n": 1, "type": "fm",  "freq_khz": 102500, "band": "ccir", "name": "Retro FM"},
  {"n": 2, "type": "net", "url": "http://...", "name": "Radio Record"}
]
```

Нажатие пресета делает две вещи: выставляет режим по полю `type` и запускает
станцию. Разделение по типам остаётся только на экранах редактирования —
частоту и поток правят по-разному.

Файл кладётся туда же, где список интернет-станций, и с тем же правилом
атомарной замены (решение по хранению — [01](01-station-directories.md)).

## 5. Переход эфир → интернет не мгновенный

Перестройка тюнера — запись в регистр по I²C, единицы миллисекунд.
Запуск потока — разрешение имени, TCP-соединение и наполнение буфера, то есть
секунды.

**Числа не привожу: железа нет, это рассуждение о свойстве буферизованного
потока, а не измерение.** Проверяется на макете вместе с остальным.

Что закладываем в софт заранее:

- Wi-Fi держится подключённым постоянно, в том числе пока играет эфир;
- процесс плеера не выгружается при уходе в эфирный режим;
- на экране показывается «буферизация», а не молчание;
- обратный переход интернет → эфир практически мгновенный, дополнительных мер
  не требует.

## 6. Чем нажимать восемь пресетов — решено

**Решено:** восемь кнопок пресетов и MODE — через расширитель MCP23017 на
I²C платы ESP32-P4, прерывание на GPIO32 ([33](33-carrier-board.md), §2;
[30](30-pin-assignment.md)). Ниже — как к этому пришли.

*Неактуально (ревизия на Raspberry Pi):* в свободные выводы той платы восемь
кнопок не влезали — четыре вывода на восемь кнопок ([13](13-gpio-map.md)).

Направление, выбранное заказчиком 2026-08-25: делать это на второй платформе,
**Waveshare ESP32-P4-WIFI6-Touch-LCD-5** с 40-контактной гребёнкой
([08](08-cost-and-board-choice.md), §10), и дублировать пресеты плитками на
сенсорном экране.

**Не подтверждено, и подтвердить сейчас нечем.** Проверено 2026-08-25:

- страница вики `waveshare.com/wiki/ESP32-P4-WIFI6-Touch-LCD-5` — заглушка:
  «Our Wiki resources are under urgent production, please stay tuned»;
- `docs.waveshare.com/ESP32-P4-WIFI6-Touch-LCD-5` таблицы распределения
  40 контактов не содержит;
- в разделе Resources страницы товара **схемы платы нет**, единственная
  ссылка ведёт на ту же пустую страницу документации;
- всё, что заявлено про гребёнку: «40PIN expansion header, 2.54 mm pitch,
  ...» (дальше в описании — про совместимость с платами расширения).

Значит, распределение выводов выясняется только прозвонкой по приходу платы
либо запросом в поддержку Waveshare (на странице есть форма тикета).

До этого закладывать восемь кнопок в схему нельзя. Запасной вариант, если
свободных выводов окажется мало, — расширитель портов по I²C (MCP23017 даёт 16
входов и одну линию прерывания); при этом надо сверить его адрес с адресом
RDA5807M, который в документах проекта пока не зафиксирован.

### Если выводов не хватит

Указание заказчика от 2026-08-25: «можно будет их уменьшить до 6, например,
или поставить расширитель». Оба пути годятся, но у них разный порядок.

**Размер банка и число кнопок — разные величины.** Банк живёт в файле и может
остаться восьмиместным независимо от того, сколько кнопок влезло на панель.
Нехватка выводов урезает панель, а не функцию: пресеты, не попавшие на кнопки,
остаются на экранных плитках и на кнопках ◄ ►. Поэтому «уменьшить до 6» —
решение про переднюю панель, и принимать его можно последним, уже по факту
известного числа свободных выводов.

Чего делать не стоит: вешать пресеты 7 и 8 на долгое нажатие кнопок 1 и 2.
Скрытая вторая функция у кнопки — ровно то, что путает пользователя, ради
которого в **R4.1** физические органы и заведены.

**Расширитель — MCP23017, не PCF8574.** 16 линий против 8, две линии
прерывания, внутренние подтяжки настраиваются регистром GPPU, поэтому внешние
резисторы под кнопки не нужны. PCF8574 даёт ровно 8 линий, без запаса.
(Характеристики — по описаниям микросхем; перед закупкой сверить с даташитом.)

Проверено 2026-08-25:

- *неактуально (Linux, ревизия на Raspberry Pi):* у Raspberry Pi есть **штатный оверлей** `mcp23017-overlay.dts` в
  `raspberrypi/linux`, ветка `rpi-6.6.y`; параметры `addr`, `gpiopin`,
  `mcp23008`, `noints`, по умолчанию `reg = <0x20>` и прерывание на GPIO4;
- **GPIO4 у нас занят кнопкой MENU** ([13](13-gpio-map.md), §1), поэтому
  `gpiopin=` задавать обязательно. Тот же класс ошибки, что оговорка 3
  в [13](13-gpio-map.md), §3 про умолчание GPIO3 у `gpio-key`;
- адреса не конфликтуют: тюнер RDA5807M — `0x10` и `0x11`
  ([02](02-fm-frontend.md)), расширитель — `0x20–0x27`;
- **`gpio-key` к выводам расширителя не привязывается.** В `overlays/README`
  той же ветки, прочитано 2026-08-25, у оверлея всего пять параметров:
  `gpio`, `active_low`, `gpio_pull`, `label`, `keycode`. Указать чужой
  контроллер GPIO нечем.

Последний пункт важен: принцип «ввод через оверлеи, а не опрос из Python»
([13](13-gpio-map.md), §4) на кнопки расширителя **не распространяется**. Их
читаем сами — по спаду на линии прерывания опрашиваем регистр по I²C. Для
пресетов это приемлемо: фаз, как у энкодера, там нет, антидребезг 20–30 мс
пишется в несколько строк. Энкодеры и остальные кнопки остаются на выводах
SoC и на оверлеях, как записано.

На платформе ESP32-P4 вопрос стоит иначе: оверлеев там нет вообще, модуль
ввода мы пишем сами ([21](21-board-search-criteria.md)), и расширитель
читается как любая другая микросхема на I²C.

## 7. Что правится в других документах

| Документ | Что изменено |
|---|---|
| [00](00-requirements.md) | R2 переписано: переключение программное |
| [03](03-controller-platform.md) | §4 «Роль тумблера режима» → «Роль кнопки MODE» |
| [05](05-display-and-ui.md) | строка таблицы органов управления |
| [07](07-bom-draft.md), [11](11-shopping-list.md) | G6: MTS-202 → тактовая кнопка с колпачком другого цвета |
| [13](13-gpio-map.md) | GPIO9 — кнопка MODE; оговорка 5 о чтении уровня снята |
| [14](14-software-stack.md) | §1.3 переписан |
| [15](15-wiring-breadboard.md), [16](16-connection-list.md) | подключение G6 двумя выводами, как у прочих кнопок |
