Spok1978/hybrid-radio/docs/23-volume-control.md

# 23. Громкость: одна ручка на два тракта

Решение от 2026-08-25. Вопрос заказчика: можно ли использовать энкодер как
регулятор громкости в обоих режимах.

Ответ: да, и это было заложено изначально — [13](13-gpio-map.md), §1:
«Энкодер 1 — перестройка частоты и навигация по меню. Энкодер 2 — громкость».
Документ нужен потому, что одна ручка крутит **два разных механизма**, и это
имеет последствия, которых в проекте записано не было.

## 1. Принято

| Что | Как |
|---|---|
| Орган | энкодер 2 (G1), каналы на GPIO7 / GPIO8 |
| Вращение | громкость, одинаково в обоих режимах |
| Нажатие (GPIO12) | mute вкл/выкл, одинаково в обоих режимах |
| Выход из mute | возврат на прежний уровень, значение не теряется |

Кнопка энкодера 2 была заведена в `config.txt` ещё 2026-08-21, но функции
у неё не было ни в одной таблице. Метка оверлея сменена с `ENC2` на `MUTE`.

> **Номера выводов, `config.txt` и оверлеи в этом документе — неактуально**
> (ревизия на Raspberry Pi, отменена 2026-08-26, [24](24-main-build-p4.md)).
> Действующие выводы платы ESP32-P4 — [33](33-carrier-board.md), §2; само
> решение от платформы не зависит.

## 2. Громкость — одно число, а не два

Пункт «Один владелец состояния» ([14](14-software-stack.md), §3) относится и
к громкости. В автомате живёт **одно логическое значение 0–100**, а при смене
режима оно перекладывается на тот механизм, который сейчас активен:

| Режим | Чем регулируется физически |
|---|---|
| Эфир | регистр 05 тюнера RDA5807M, поле `VOLUME` |
| Интернет | микшер ALSA |

Без этого получается неприятность ровно на пресетах: нажал пресет с
интернет-станцией — и громкость скакнула, потому что у ALSA было своё
значение. Та же проблема двух источников истины, что была с тумблером
([22](22-mode-switching.md)), только про громкость.

**Поправка на режим.** При отображении логического значения на механизм
закладывается смещение, своё для каждого режима. Уровни источников сведены
железом: резисторы сумматора разные, потому что у тюнера выход 360 мВ, а у
ЦАП 2,1 В — разница около 15 дБ ([04](04-audio-path.md), §5). Это разовая
калибровка, остаток разницы добирается поправкой в софте, а не перепайкой
после первого прослушивания.

**Mute — это не «громкость в ноль».** В Схеме 1 оба источника постоянно
электрически связаны, и работоспособность держится на том, что неактивный
заглушён по-настоящему ([04](04-audio-path.md), §2). У RDA5807M для этого есть
отдельный бит mute помимо регистра громкости. Поэтому и кнопка mute, и
переключение режима глушат источник битом, а не сведением регистра к нулю.

## 3. У эфирной громкости 16 ступеней, и это потолок

Проверено 2026-08-25 по `src/RDA5807.h` библиотеки `pu2clr/RDA5807`, ветка
master: поле `VOLUME` в регистре 05 занимает **4 бита**, комментарий в
исходнике — `DAC Gain Control Bits (Volume); 0000 = min volume;
1111 = max volume`. Шестнадцать положений, включая нижнее.

**Подтверждено 2026-08-26 по даташиту RDA5807M: шкала логарифмическая**
(«Volume scale is logarithmic»). Раньше здесь стояла пометка «не
подтверждено» — в заголовочном файле библиотеки формы шкалы нет, и я
не бралась её утверждать. Теперь есть источник. Кривая пересчёта и
согласование с кривой интернет-тракта считаются от логарифмической шкалы.

Оттуда же ещё три детали, важные для драйвера:

- бит `DMUTE` (регистр 02H, бит 14) имеет **инверсную логику**: 0 — mute,
  1 — нормальная работа;
- при `VOLUME=0000` выход переходит в **высокоимпедансное состояние**, а не
  просто становится тихим. Для схемы пассивной суммы это в плюс: заглушённый
  тюнер почти отключён от сумматора;
- есть отдельный бит `DHIZ` (регистр 02H, бит 15) — принудительный Hi-Z.

Энкодер EC11 из закупки даёт **20 импульсов на оборот** ([11](11-shopping-list.md),
позиция G1). То есть меньше одного оборота ручки проходит весь диапазон
громкости эфира, тогда как в интернет-режиме микшер ALSA регулирует
практически непрерывно. Одна ручка — ощутимо разное поведение.

Софтом со стороны эфира это не лечится: в Схеме 1 аналоговый выход тюнера
идёт прямо в сумматор и усилитель, программной ступени в этом тракте нет
вообще. Регистр тюнера — единственный регулирующий элемент.

### Варианты

| Вариант | Что даёт | Чем платим |
|---|---|---|
| Принять как есть | 2 щелчка на ступень, полный оборот ≈ весь диапазон | грубый шаг в эфире, заметен на слух |
| Цифровой потенциометр после сумматора | общая громкость в железе, одинаковое ощущение в обоих режимах | лишняя микросхема и ещё один интерфейс |
| Схема 3: эфир через АЦП | один тракт, один микшер, полное разрешение | задержка в десятки мс, лишний АЦП |

**Статус: принят первый вариант — 16 ступеней.** Решение заказчика
от 2026-08-26: оставляем как рабочий, пересматриваем по результатам макета
или эксплуатации, а не заранее.

Два других варианта не отброшены, а отложены с конкретными поводами вернуться:

- **Схема 3** — если при приёмке платы ESP32-P4 окажется, что аналоговый вход
  кодека ES8311 выведен наружу. Эта проверка и так стоит первым пунктом
  приёмки ([08](08-cost-and-board-choice.md), §10). Тогда эфир заходит
  в кодек, громкость становится одна на оба режима с полным разрешением,
  и вопрос закрывается сам собой;
- **цифровой потенциометр** — если на слух шаг окажется неприемлемым и при
  этом первый повод не сработает. Заводить отдельную микросхему только ради
  шага громкости не хочется, поэтому вариант последний.

Пересмотр дешёвый: софт пишется под логическую шкалу 0–100, и сколько ступеней
получается на выходе в эфирном режиме — деталь отображения, которая меняется
в одном месте.

### Что подобрать на макете

1. **Сколько щелчков энкодера на одну ступень.** Энкодер бесконечный, упоров
   нет, поэтому «оборот» ничем не ограничивает: 1:1 даёт весь диапазон за
   16 щелчков — быстро и дёргано, 2:1 растягивает на 32 щелчка. Выбирается
   на слух вместе с `steps-per-period` ([13](13-gpio-map.md), §3, п. 1).
2. **Кривая громкости в интернет-режиме.** Чтобы ручка ощущалась одинаково
   в обоих режимах, шкала ALSA должна быть согласована с формой шкалы тюнера
   (см. неподтверждённый пункт выше). Линейный по амплитуде микшер на слух
   ведёт себя иначе, чем шкала в децибелах.
3. **Поправка на режим** — насколько эфир и интернет расходятся по громкости
   при одном логическом значении после того, как резисторы сумматора выставлены.

## 4. Что правится в других документах

| Документ | Что изменено |
|---|---|
| [05](05-display-and-ui.md) | в таблицу органов управления добавлен энкодер 2 с нажатием |
| [13](13-gpio-map.md) | метка оверлея GPIO12: `ENC2` → `MUTE`; в §1 дописано назначение нажатия |
| [14](14-software-stack.md) | к пункту «один владелец состояния» дописана модель громкости |
| [04](04-audio-path.md) | к абзацу о программной громкости дописано следствие про 16 ступеней |
