Spok1978/hybrid-radio/docs/32-task-model.md

# Модель задач

Кто в прошивке работает параллельно, с какими приоритетами, на каких
ядрах, где лежат стеки и кто за чем следит.

**Дата:** 2026-09-17. Все числа взяты из кода, ссылки на `файл:строку`
проставлены. Приоритеты системных задач сняты с работающей платы
переписью `uxTaskGetSystemState()` 2026-09-06.

---

## Зачем этот документ

Полдня работы 2026-09-06 ушло на поиск причины, по которой экран
замирал во время проигрывания. Оказалось: задача вывода звука у ADF
идёт с приоритетом **23** и по умолчанию привязана к **ядру 0**,
а задача отрисовки — с приоритетом **6** и без привязки вовсе.
Пока поток не играл, это было незаметно.

Ни одного места, где эти два числа стояли бы рядом, в проекте не было.
Каждое лежало в своём файле, одно — вообще в чужом компоненте.
Понять, что они конфликтуют, можно было только сопоставив их вручную,
чем я и занималась полдня.

Этот документ существует ровно затем, чтобы такое сопоставление
занимало минуту.

---

## Лестница приоритетов

Снизу вверх. Чем выше — тем меньше задача имеет права ждать.

```
 24  ipc0, ipc1                служебные, межъядерные вызовы ESP-IDF
 23  i2s                       вывод звука: прервётся — будет щелчок
 23  sdio_*, rpc_*             обмен с сопроцессором Wi-Fi
 22  esp_timer                 программные таймеры
 20  sys_evt                   события системы
 18  tiT                       сетевой стек lwIP
─────────────────────────────  выше: система и звук, не наше
  7  ipradio_input             ввод: нажатие не должно теряться
  6  ipradio_state             автомат состояния
  6  lvgl                      отрисовка
  5  ipradio_tuner             опрос тюнера
  5  ipradio_wdt               сторож
  5  netradio_evt              события конвейера звука
  5  dec, alc                  декодер и громкость
  5  ipradio_off               выключение
  4  ipradio_ui                обновление интерфейса
  4  netradio_cmd              работник: пуск и остановка потока
  4  http                      приём потока
  4  cat_search, wifi_scan     разовые поиски
  4  tuner_scan                проход по диапазону
  3  click                     отметка в каталоге, вежливость
  1  Tmr Svc                   таймеры FreeRTOS
  1  main                      после подъёма только тик раз в секунду
  0  IDLE0, IDLE1              простой
```

**Правило.** Всё, что выше 7, — не наше и трогать нельзя. Из нашего
выше всех стоит ввод: человек нажал — событие должно попасть в очередь,
даже если прибор занят. Ниже всех — то, что может подождать секунду
и никем не замечено.

---

## Наши задачи

| Задача | Прио | Ядро | Стек | Где стек | Сторож | Что делает |
|---|---:|---:|---:|---|---:|---|
| `ipradio_input` | 7 | любое | 3072 | внутр. | 1000 мс | опрос кнопок и энкодеров раз в 5 мс |
| `ipradio_state` | 6 | любое | 6144 | **PSRAM** | 3000 мс | разбор очереди событий, единственный владелец состояния |
| `ipradio_tuner` | 5 | любое | 3072 | внутр. | 2000 мс | опрос RDA5807M: уровень, поиск, RDS |
| `ipradio_wdt` | 5 | любое | 3072 | внутр. | — | следит за остальными |
| `netradio_evt` | 5 | любое | 4096 | **PSRAM** | 10 000 мс | события конвейера ADF, повторы при обрыве |
| `ipradio_off` | 5 | любое | 3072 | внутр. | — | разовая: гашение и уход в сон |
| `ipradio_ui` | 4 | любое | 6144 | **PSRAM** | 5000 мс | обновление экрана раз в 50 мс |
| `netradio_cmd` | 4 | любое | 4096 | **PSRAM** | 20 000 мс | работник: пуск и остановка конвейера |
| `cat_search` | 4 | любое | 12288 | **PSRAM** | — | разовая: поиск в каталоге станций |
| `wifi_scan` | 4 | любое | 4096 | **PSRAM** | — | разовая: поиск сетей |
| `tuner_scan` | 4 | любое | 4096 | внутр. | — | разовая: проход по диапазону |
| `click` | 3 | любое | 6144 | внутр. | — | разовая: отметка запуска в каталоге |

Источники: [ipradio_input.c:35](../firmware/main/ipradio_input.c:35),
[ipradio_state.c:46](../firmware/main/ipradio_state.c:46),
[ipradio_tuner.c:817](../firmware/main/ipradio_tuner.c:817),
[ipradio_netradio.c:436](../firmware/main/ipradio_netradio.c:436),
[ipradio_ui.c:1608](../firmware/main/ipradio_ui.c:1608),
[ipradio_ui_search.c:179](../firmware/main/ipradio_ui_search.c:179),
[ipradio_ui_wifi.c:178](../firmware/main/ipradio_ui_wifi.c:178),
[ipradio_bridge.c:219](../firmware/main/ipradio_bridge.c:219),
[ipradio_net.c:774](../firmware/main/ipradio_net.c:774).

### Почему у сторожа такие разные лимиты

Лимит — это «сколько задача вправе молчать». Он подгоняется не под
желаемое, а под самое долгое законное действие.

* **`input` — 1 с.** Опрос идёт раз в 5 мс и блокироваться не на чем.
  Молчание в секунду означает настоящую беду.
* **`tuner` — 2 с.** Шина I²C общая, и отдельная транзакция может
  подождать своей очереди.
* **`state` — 3 с** плюс признак «блокировка допустима»: автомат
  законно стоит на пустой очереди.
* **`ui` — 5 с.** Отрисовка крупного шрифта Tiny TTF рисует глифы
  во время работы, а знак в 96 точек стоит заметно дороже мелкого.
* **`netradio_evt` — 10 с.** В пути повтора законная пауза 2 с плюс
  `audio_pipeline_wait_for_stop()`, а элемент HTTP в этот момент может
  сидеть в чтении сокета на умершей сети.
* **`netradio_cmd` — 20 с.** Остановка конвейера на умершей сети
  занимает секунды, и сторож не должен принимать это за зависание.

---

## Задачи конвейера звука (ESP-ADF)

Создаются не нами, а библиотекой, **на каждый запуск станции**.
Значения — умолчания ADF, мы меняем только ядро вывода и размещение
стеков.

| Задача | Прио | Ядро | Стек | Где стек |
|---|---:|---:|---:|---|
| `http` | 4 | 0 | 6144 | **PSRAM** |
| `dec` | 5 | 0 | 10240 | **PSRAM** |
| `alc` | 5 | 0 | 4096 | **PSRAM** |
| `i2s` | **23** | **1** | 3584 | **PSRAM** |

Источники: `http_stream.h:101-103`, `esp_decoder.h:31-33`,
`audio_element.h:179-181`, `i2s_stream.h:44-47` в дереве ESP-ADF.

**Ядро 1 у вывода звука — наша правка**, [ipradio_netradio.c](../firmware/main/ipradio_netradio.c).
По умолчанию ADF ставит его на ядро 0, туда же, где рисует LVGL.
Это и был тот самый конфликт.

**Стеки в PSRAM — тоже наша работа.** ADF умеет это сам, но создаёт
такие задачи функцией `xTaskCreateRestrictedPinnedToCore`, которой
в обычном ESP-IDF нет. Мы определяем её сами,
[ipradio_adf_stack.c](../firmware/main/ipradio_adf_stack.c), и раздаём
стеки из четырёх постоянных слотов — потому что задачи элементов
пересоздаются при каждом запуске, и обычное выделение текло бы.

Итого 24 КБ стеков уехали из внутренней памяти, которой на плате 445 КБ
всего.

---

## Системные задачи

Не наши, но приоритеты знать надо: наши стоят в той же очереди.
Снято переписью с работающей платы 2026-09-06.

| Задача | Прио | Что это |
|---|---:|---|
| `ipc0`, `ipc1` | 24 | межъядерные вызовы ESP-IDF |
| `sdio_write`, `sdio_read`, `sdio_rx_buf`, `sdio_process_rx` | 23 | обмен с сопроцессором Wi-Fi по SDIO |
| `rpc_tx`, `rpc_rx` | 23 | вызовы к сопроцессору |
| `esp_timer` | 22 | программные таймеры |
| `sys_evt` | 20 | события системы |
| `tiT` | 18 | сетевой стек lwIP |
| `lvgl` | 6 | отрисовка, **ядро 0** — наша правка |
| `Tmr Svc` | 1 | таймеры FreeRTOS |
| `main` | 1 | после подъёма только тик раз в секунду |
| `IDLE0`, `IDLE1` | 0 | простой |

Задача `lvgl` создаётся адаптером: стек 8192, приоритет 6
(`esp_lv_adapter.h:102-104`). Ядро по умолчанию не задано; мы
прибиваем её к нулевому, [ipradio_ui.c:1465](../firmware/main/ipradio_ui.c:1465).

Главная задача: стек 10240, ядро 0 (`CONFIG_ESP_MAIN_TASK_STACK_SIZE`,
`CONFIG_ESP_MAIN_TASK_AFFINITY_CPU0`).

---

## Правила, которые нельзя нарушать

Каждое написано кровью: все они — ошибки, которые уже случались.

### LVGL трогает только задача интерфейса

LVGL не потокобезопасен. Любое обращение к `lv_*` из другой задачи —
случайное падение через неделю.

У нас это решено **без** `lv_async_call`: фоновые задачи `cat_search`
и `wifi_scan` не трогают LVGL вовсе. Они складывают результат в буфер
под своим мьютексом, а задача интерфейса забирает его под
`esp_lv_adapter_lock()`. Проверено: обращений к `lv_*` в теле обеих
задач — ноль.

Обработчики нажатий — это тоже **не** задача интерфейса. Они
исполняются внутри `lv_timer_handler()`, то есть в задаче `lvgl`.
Отсюда следующее правило.

### `ipradio_store_t` на стек не кладём

Структура занимает 2548 байт. Обработчик касания исполняется в задаче
`lvgl`, и её стека на такую копию не хватает — прибор уходит
в перезагрузку.

Ловили **трижды**: при записи станции из поиска, при выходе с экрана
часов, при сохранении яркости.

Для правки банка есть `ipradio_storage_edit_begin()` и
`ipradio_storage_edit_end()`: они дают указатель на рабочую копию
под замком, ничего никуда не копируя. Для чтения одной ячейки —
`ipradio_storage_get_preset()`.

### Медленное — прочь из задачи автомата

`audio_pipeline_stop()` ждёт остановки всех четырёх элементов,
а элемент HTTP может сидеть в чтении сокета на умершей сети. Это
**секунды**. Пока автомат этого ждёт, он не разбирает события: нажатия
копятся в очереди на 24 места, а при переполнении молча теряются.

Поэтому пуск и остановка вынесены работнику `netradio_cmd`. Автомат
оставляет пожелание и идёт дальше.

Именно пожелание, а не очередь команд: если ткнуть три станции подряд,
играть надо **последнюю**, а очередь честно подняла бы и погасила
конвейер трижды.

### Конвейером распоряжается кто-то один

Две задачи имеют право трогать конвейер: работник `netradio_cmd`
и задача событий `netradio_evt`, которая при обрыве перезапускает
поток сама. Встретиться они могут в любой момент — отсюда `s_pipe_lock`.
Без него получается «Pipeline already started», после чего задача `i2s`
уходит в холостой цикл и сторож срабатывает без конца.

---

## Где лежат стеки и почему

Внутренней памяти на ESP32-P4 всего **445 КБ**, PSRAM — **32 МБ**,
и она почти пуста. Во время воспроизведения внутренней остаётся
около 30 КБ: её просят драйвер SDIO под буферы приёма и mbedTLS
под рукопожатие, и им нельзя в PSRAM.

Поэтому правило простое: **стек во внутренней памяти нужен только
тому, кто работает из обработчика прерывания.** У нас таких нет.

Не все наши задачи переехали — те, что остались (`input`, `tuner`,
`wdt`, `off`, `tuner_scan`, `click`), занимают около 22 КБ. Перевести
их тоже можно и, вероятно, стоит, но это не делалось: нехватку
закрыли переносом более крупных.

Управляющие блоки задач (TCB) остаются во внутренней памяти всегда —
планировщик трогает их там, где кеш PSRAM может быть выключен. Это
около двухсот байт на задачу.

---

## Что этой моделью не проверить

Всё перечисленное — статика: кто, где, с каким приоритетом. Настоящее
поведение при одновременности проверяется только на плате.

Проверки на машине разработчика (`tests/host`) намеренно подделывают
FreeRTOS: очередь там массив, мьютексы пустышки, задачи не создаются
вовсе. Это позволяет проверять **логику** автомата шаг за шагом,
но гонок, переполнения стека и голодания по процессору таким способом
не увидеть.
