Spok1978/hybrid-radio/docs/34-memory.md

# Память: почему прибор падал и что исправлено

**Дата:** 2026-10-06. Все утверждения проверены по исходникам, которые
реально собираются (ESP-IDF 5.5.3, esp_hosted 1.4.7, mbedTLS из IDF),
и по журналам платы. Ссылки на файлы и строки проставлены.

---

## Итог одной таблицей

Одинаковый прогон на плате: прибор сам переключает интернет-станции
каждые 15 с, каждый пятый раз ещё и ищет в каталоге
(`main/ipradio_soak.c`, ключ `IPRADIO_DEBUG_SOAK`). Числа сняты
из строк «ПУЛЬС» и счётчика отказов.

| | До | После |
|---|---|---|
| Переключений | 35 из 40 (кончилось время записи) | **40 из 40** |
| Отказов выделения памяти | **152** | **0** |
| Ошибок TLS «не хватило памяти» (0x4290) | 28 | 0 |
| Свободно внутренней, худшее | 12 КБ | 29 КБ |
| Исторический минимум внутренней | **0 КБ** | 27 КБ |
| Наибольший кусок внутренней, худшее | 6 КБ | 28 КБ |
| «Радио Искатель»: замеров со звуком / неудачных открытий | 2 / 26 | 17 / 0 |

В прогоне «до» перезагрузки не случилось, но свободная внутренняя
память доходила до нуля. 2026-10-05 та же прошивка падала на ровно
таком же сценарии (`assert failed: sdio_rx_get_buffer sdio_drv.c:670`,
журналы `switch2.log`, `after.log`).

---

## Что было не так

Внутренняя память у ESP32-P4 кончалась целиком, а не только рвалась
на куски. При загрузке свободно 56 КБ, через минуту игры — 12 КБ
(журнал 2026-10-05). Её забирали три потребителя, и ни один не был
обязан жить во внутренней.

### 1. mbedTLS — весь во внутренней памяти

По умолчанию ESP-IDF выделяет всю память TLS во внутренней:
`default MBEDTLS_INTERNAL_MEM_ALLOC` в `components/mbedtls/Kconfig:5`,
а `components/mbedtls/port/esp_mem.c:16-17`
зовёт `heap_caps_calloc(n, size, MALLOC_CAP_INTERNAL | MALLOC_CAP_8BIT)`.
Порог `SPIRAM_MALLOC_ALWAYSINTERNAL=256` на это не действует, свойство
памяти задано явно. Этот выбор никто не делал, он стоял по умолчанию.

Как это выглядело:

* «станция иногда не подключается» — `PK verify failed with error
  0x4290`. Это `RSA_PUBLIC_FAILED` (−0x4280, `mbedtls/rsa.h:41`) плюс
  `MPI_ALLOC_FAILED` (−0x0010, `mbedtls/bignum.h:39`): длинной
  арифметике не хватило памяти;
* все 152 отказа прогона «до» — `caps 0x804, heap_caps_calloc`, то есть
  INTERNAL|8BIT, ровно вызов из `esp_mem.c`.

### 2. Буфер приёма SDIO — непрерывный кусок внутренней DMA-памяти

Связь с сопроцессором Wi-Fi (esp_hosted 1.4.7) в потоковом режиме
читает за раз всё, что накопилось у C6, в двойной буфер. Буфер растёт
по ходу работы, старый освобождается, выделяется больший
(`host/drivers/transport/sdio/sdio_drv.c`, `sdio_rx_get_buffer()`),
через `MEM_ALLOC` = внутренняя DMA-память
(`host/port/include/os_wrapper.h:105`). Неудача — `assert(*buf)`
и перезагрузка. В прогоне «после» видно, как он растёт:
512 → 1536 → 3072 → 4608 → 6144 → 7680 байт, последний рост на 507-й
секунде.

### 3. cJSON — тысячи мелких выделений

Узлы дерева и строки cJSON меньше 256 байт, поэтому по порогу
`ALWAYSINTERNAL` уходят во внутреннюю. Один ответ каталога на 20 станций
даёт **2150** выделений (замер на плате 2026-10-06, строка «выделений
JSON»), и все подряд, посреди играющего потока.

---

## Что исправлено

| Правка | Где | Что даёт |
|---|---|---|
| mbedTLS в PSRAM | `sdkconfig.defaults`, `CONFIG_MBEDTLS_EXTERNAL_MEM_ALLOC=y` | убрал все 152 отказа; рукопожатие больше не борется за внутреннюю |
| Буфер SDIO в PSRAM | своя копия `components/esp_hosted`, см. её `PATCHES.md` | рост буфера больше не требует непрерывной внутренней памяти; правка только хостовая |
| cJSON в PSRAM | `main/ipradio_mem.c`, `cJSON_InitHooks` | 2150 выделений на поиск ушли из внутренней |
| Учёт отказов и пульс | `main/ipradio_mem.c`, `app_main.c` | каждый отказ выделения печатается; в пульсе минимум, кусок под DMA, PSRAM |
| Приёмный буфер TLS 16 КБ | `sdkconfig.defaults` | следствие переноса TLS в PSRAM, см. ниже |

**Почему в PSRAM можно.**

* **mbedTLS.** Аппаратный AES ESP32-P4 сам работает с буферами
  во внешней памяти: выравнивание и уровень кэша выбираются по адресу
  (`port/aes/dma/esp_aes_dma_core.c`, строки 212, 254–259, 464).
  Из прерываний mbedTLS никто не зовёт.
* **Буфер SDIO.** Контроллер SDMMC умеет DMA в PSRAM:
  `SOC_SDMMC_PSRAM_DMA_CAPABLE 1` (`soc/esp32p4/include/soc/soc_caps.h:531`).
  Драйвер проверяет выравнивание буфера во внешней памяти
  (`esp_driver_sdmmc/src/sdmmc_host.c:1289-1319`) и сам синхронизирует
  кэш (`sdmmc_transaction.c:141-147, 178`). Буфер выделяется публичной
  `esp_dma_capable_malloc()` с выравниванием по строке кэша PSRAM.
* **cJSON.** К дереву обращаются только задачи поиска и хранилища,
  без прерываний и DMA. Освобождение — обычной `free()`, в ESP-IDF она
  освобождает память из любой кучи.

**Приёмный буфер TLS снова 16 КБ.** 2026-09-05 его урезали до 8 КБ
ради внутренней памяти, с доводом «радиопоток такими записями не
пользуется». Довод неверен: размер записи выбирает сервер. mbedTLS
сверяет входящую запись с этой величиной (`mbedtls_ssl_fetch_input`
в `library/ssl_msg.c`; переменной длины буфера в сборке нет), и запись
больше 8 КБ отвергается с «read error -0x7100»
(`MBEDTLS_ERR_SSL_BAD_INPUT_DATA`, `mbedtls/ssl.h:51`). Так не играла
одна из пяти станций на карте: 32 отказа из 32 в прогоне «после».
Прежде её прятала нехватка памяти — она падала ещё на рукопожатии
(`Dynamic Impl: alloc(2389 bytes) failed`). Теперь буфер живёт в PSRAM
и стоит дёшево. Проверка с 16 КБ, 15 переключений: играют все пять
станций, у этой 3 запуска из 3, отказов памяти 0.

Эта станция берёт больше внутренней памяти, чем остальные: в худший
момент свободно 22 КБ, на остальных 31 КБ. Это сетевые буферы под
крупные пакеты; отказов при этом нет.

---

## Внешний разбор «оптимизация памяти»: что принято, что нет

Разбор (`Downloads/оптимизация_памяти_интернет_радио.md`) написан
по коммиту 188f912, ссылки на строки нашего кода в нём устарели.

| Мера разбора | Решение | Почему |
|---|---|---|
| 4.1 Приём SDIO в режиме MAX_SIZE «одной строкой» | **отклонена** | Хостовый MAX_SIZE рассчитан на то, что C6 отдаёт пакеты по одному и добивает остаток нулями (комментарий в ветке `H_SDIO_ALWAYS_HOST_RX_MAX_TRANSPORT_SIZE`, `sdio_drv.c`). Режим самого C6 задаётся при сборке его прошивки: `sending_mode = SDIO_SLAVE_SEND_STREAM` (`slave/main/sdio_slave_api.c`, по умолчанию включён). Наш буфер рос дальше 1536 байт — значит, C6 шлёт поток из нескольких пакетов, и MAX_SIZE терял бы данные. Без перепрошивки C6 мера неприменима |
| 4.2 Своя копия esp_hosted, заранее выделить буфер, вместо assert отбрасывать | **заменена на лучшее** | Буфер вынесен в PSRAM целиком — внутренняя не нужна вовсе, а не только заранее |
| 4.2 «alloc → free» | отклонена | разбор отклонил её сам |
| 4.3 Резервный блок при загрузке | не нужна | после переноса буфера в PSRAM беречь нечего |
| 4.4 cJSON в PSRAM | **принята** | замер на плате: 2150 выделений на поиск, как и в разборе (2143) |
| 4.4 Резерв `RESERVE_INTERNAL` 64 → 96 КБ | **отклонена** | забирает 32 КБ у всех прочих, а свободной внутренней было 12 КБ |
| 4.9 Учёт отказов, минимум, кусок под DMA | **принята** | |
| 4.5 Стеки, 4.6 DMA звука, 4.7 повтор без сброса | отложены | после правок внутренней памяти хватает, трогать конвейер незачем |
| 4.8 Новый esp_hosted с перепрошивкой C6 | отложена | правка хоста решает задачу без C6 |

Чего в разборе не было вовсе: **mbedTLS во внутренней памяти**. Там
сказано обратное — что крупные блоки TLS уходят в PSRAM по порогу 256.
Для нашей сборки это неверно, см. пункт 1. Неверно и «суммарно
свободной памяти хватает всегда»: по журналу 2026-10-05 она падала
до 12 КБ, по прогону «до» — до нуля.

---

## Как проверять дальше

* **Пульс** (`IPRADIO_DEBUG_MAIN_PULSE`) раз в 3 с: свободно,
  наибольший кусок, исторический минимум, кусок под DMA, PSRAM,
  отказов памяти. Отказов должно быть 0. Минимум на 2026-10-06 —
  22 КБ (станция с записями TLS по 16 КБ), на прочих 31 КБ; заметно
  ниже 20 КБ — повод разбираться.
* **«ОТКАЗ ПАМЯТИ: N байт, caps 0x…»** — каждое неудачное выделение,
  печатается из `ipradio_mem.c`. Caps расшифровываются по
  `heap/include/esp_heap_caps.h`.
* **«узлы JSON в PSRAM: да»** при загрузке — проверка делом, а не
  настройкой.
* **«H_SDIO_DRV: buf N size: … (PSRAM)»** — рост буфера приёма и где
  он лёг.
* **Прогон**: `IPRADIO_DEBUG_SOAK 1`, прошить, снять журнал 12 минут.
  В работе ключ **обязан** быть 0.

## Правила на будущее

* Всё, что не нужно прерываниям и DMA, — в PSRAM. Внутренняя память
  только для тех, кому без неё нельзя.
* Чужой компонент, выделяющий память «внутренне по умолчанию»,
  проверять по исходнику, а не верить порогу `ALWAYSINTERNAL`:
  явный `MALLOC_CAP_INTERNAL` порог не видит.
* Урезание буферов ради памяти — лечение следствия. Сначала найти,
  кто память забирает (счётчик отказов покажет caps), и переселить его.
