Spok1978/hybrid-radio/docs/28-screen-mockups.md

# 28. Образцы экранов интерфейса

Нарисованы 2026-08-26 по спецификации [26](26-firmware-spec.md) — как проверка
того, что задание понято правильно. **Приняты заказчиком как рабочий вариант**
в тот же день.

## Где лежат

| Что | Где |
|---|---|
| Исходники экранов | `design/*.dc.html`, по файлу на экран |
| Сборщик страницы | `design/` собирается скриптом, вклеивающим экраны в общую страницу |
| Собранная страница | `design/ip-radio-screens.html` |
| Опубликованный вид | https://claude.ai/code/artifact/f56b7200-34dc-466d-b2f4-98e7662892f4 |

Экраны нарисованы в натуральном кадре **1280×720** — в том виде, в каком они
окажутся на панели после поворота ([26](26-firmware-spec.md), §2.1).

## Двенадцать состояний

| № | Экран | Что демонстрирует |
|---|---|---|
| 01 | Эфир, станция с RDS | название из RDS крупно, частота под ним, активен пресет типа FM |
| 02 | Эфир, станция без RDS | названия нет — крупно частота; второй диапазон |
| 03 | Интернет-радио, играет | метаданные ICY, кодек, заполнение буфера |
| 04 | Интернет-радио, буферизация | переход по пресету другого типа: на экране написано, что происходит |
| 05 | Меню настроек | крупные строки, текущее значение справа у каждой |
| 06 | Настройка эфира | шкала с засечками автопоиска, переключатель диапазона |
| 07 | Экранная клавиатура | ЙЦУКЕН, клавиша выбрана энкодером, «Сохранить» отдельно |
| 08 | Ждущий режим | часы во весь экран, приглушено, внизу что играет |
| 09 | Звук выключен | красный перечёркнутый динамик, зачёркнутая громкость, плашка по центру |
| 10 | Wi-Fi не настроен | приглашение настроить сеть с прямым переходом, эфир играет |
| 11 | Сеть настроена, связи нет | предупреждение поверх эфира, идёт переподключение |
| 12 | Станция не отвечает | дело в станции, а не в сети; сразу предложены другие |

## Что из этого уже написано

Состояние на 2026-08-28. Собирается; **на железе не проверено ничего** —
платы нет.

| № | Экран | Модуль | Состояние |
|---|---|---|---|
| 01–04 | воспроизведение, оба режима | `ipradio_ui.c` | готов |
| 05 | меню настроек | `ipradio_ui_menu.c` | готов, все семь пунктов работают |
| 06 | настройка эфира | `ipradio_ui_tune.c` | готов, вместе с проходом автопоиска |
| 07 | экранная клавиатура | `ipradio_ui_keyboard.c` | готова, открывается из двух мест |
| 08 | ждущий режим | `ipradio_ui_idle.c` | готов |
| 09 | звук выключен | `ipradio_ui.c` | готов |
| 10–12 | недоступность сети | `ipradio_ui_dialog.c` | готовы, кнопки ведут куда обещано |

Сверх двенадцати макетов понадобились ещё шесть экранов. В макетах их
не было потому, что там нарисованы состояния **работающего** прибора,
а это экраны настройки:

| Экран | Модуль | Зачем понадобился |
|---|---|---|
| выбор сети Wi-Fi | `ipradio_ui_wifi.c` | §5.3.3.1; первое место, откуда открылась клавиатура |
| поиск станций | `ipradio_ui_search.c` | §5.3.2; **без него интернет-радио не играло вовсе** |
| список станций | `ipradio_ui_stations.c` | §5.3.3.4; подписать найденное, освободить ячейку |
| яркость | `ipradio_ui_brightness.c` | §5.3.3.3 |
| часы | `ipradio_ui_clock.c` | §5.3.3.2 |
| состояние прибора | `ipradio_ui_diag.c` | §5.3.3.5 |

### Что осталось незакрытым

Список короткий и каждый пункт с причиной, а не «не успели».

1. **Метаданные ICY** — что играет прямо сейчас в интернет-потоке.
   В `http_stream` из ESP-ADF поддержки ICY нет вовсе. Чтобы их
   получить, надо самому слать заголовок `Icy-MetaData` и вырезать
   блоки метаданных из потока каждые `icy-metaint` байт, то есть
   встроиться в путь чтения. Делать такую операцию вслепую — верный
   способ сломать воспроизведение ради строки текста. **До железа.**
2. **УКВ** — отложен решением заказчика 2026-08-28, не вырезан.
   Выключатель `IPRADIO_ENABLE_OIRT`.
3. **«Последняя ошибка»** на экране состояния — нужен журнал,
   переживающий перезагрузку. Обещать пустой строкой хуже, чем
   не обещать.
4. **Адреса регистров RDS** (`0x0C`–`0x0F`) взяты по общим сведениям
   о семействе, а не из даташита: его в проекте нет. Помечено в коде.
   **Сверить первым делом.**

---

### Как устроен перехват органов управления

Экранов, забирающих себе энкодеры, стало пять, и это отдельная
механика, а не свойство каждого из них.

Автомат состояния о экранах не знает — он знает про радио. Перехват
принадлежит интерфейсу и сделан **фильтром событий**
(`ipradio_set_event_filter`): фильтр ставится один раз при подъёме
и висит всегда, решая по обстановке. Ставить и снимать его при каждом
диалоге значило бы завести ещё одно состояние, которое можно
рассинхронизировать.

Порядок наложения — от верхнего к нижнему: клавиатура, настройка эфира,
меню, диалог. Он же порядок проверок в разборе команд.

Что фильтр **не** перехватывает никогда: громкость, звук и питание.
Прибор не должен становиться неуправляемым из-за плашки на экране.

Фильтр работает в задаче автомата, а виджеты LVGL можно трогать только
из задачи отрисовки. Поэтому он не рисует, а кладёт команду в короткое
кольцо, которое разбирает задача интерфейса.

---

## Решения, принятые при отрисовке

**Цвет кодирует режим.** Янтарь — эфир, циан — интернет. Не украшение:
режим читается раньше, чем прочитан текст — по бейджу справа вверху,
по подсветке активного пресета, по цвету частоты. Для пользователя, ради
которого заведено требование R4.1, это работает лучше подписи.

**Названия диапазонов на экране короткие — «УКВ» и «FM».** Решение заказчика
2026-08-26 по итогам просмотра. OIRT и CCIR остаются в документации:
пользователю они ничего не говорят, а место занимают. Внесено
в [26](26-firmware-spec.md), §5.1.

**Уровень громкости числом в статусной строке.** В ТЗ этого не было. Раз
энкодер 2 крутит громкость вслепую, цифру полезно видеть — тем более что
в эфире ступеней всего 16 ([23](23-volume-control.md)).

**В меню у каждой строки показано текущее значение** — «NTP, UTC+3», «80 %»,
«34 сохранено». Чтобы проверить настройку, не надо заходить внутрь пункта.

**Шрифт IBM Plex Sans и IBM Plex Mono.** Материал-дизайн предполагает Roboto,
но у Plex Mono табличные цифры: частота не дёргается при перестройке, когда
меняется разряд. На приборе это заметно. Окончательный выбор шрифта делается
при генерации кириллического шрифта для LVGL ([26](26-firmware-spec.md), §7).

**Mute показан крупно, а не только значком.** Заказчик просил красный
перечёркнутый динамик — он сделан, но к нему добавлена плашка «ЗВУК ВЫКЛЮЧЕН»
по центру. Значок 22 пикселя в углу для пожилого пользователя мал: человек
решит, что прибор сломался, а не что он сам выключил звук.

**Недоступность интернета показана до нажатия, а не после.** NET-ячейки
гаснут и получают перечёркнутый Wi-Fi, когда связи нет.

**Три состояния недоступности разведены** — уточнение заказчика 2026-08-26.
Переключение в интернет-режим блокируется, но реакция на MODE разная: если
сеть не настроена, прибор **приглашает её настроить** и ведёт прямо в
настройку; если настроена, но связи нет — просто предупреждает и никуда не
ведёт, потому что связь вернётся сама. Третий случай, когда сеть есть,
а станция молчит, отделён специально: иначе человек будет чинить Wi-Fi,
который исправен. Разбор — [26](26-firmware-spec.md), §5.2.

**Диалоги показываются поверх играющего эфира**, а не вместо него, и на
каждом написано, что эфир не прерывался. Это сознательно: молчащий прибор
с сообщением об ошибке читается как «сломалось всё».

## Оговорки

- Названия станций в пресетах — правдоподобные примеры, не реальные данные.
- Экраны нарисованы вёрсткой, а не в LVGL. Это макет соглашений и раскладки,
  а не проверка того, что LVGL нарисует то же самое с той же скоростью.
- Канву дизайн-редактора собрать не удалось: для неё нужен Node, а на машине
  его нет. Поэтому обычная страница; править экраны можно поштучно,
  исходники разделены по файлам.
