Spok1978/hybrid-radio/docs/29-yaml-review.md

# 29. Разбор стороннего описания железа (YAML)

2026-08-27 заказчик принёс `ESP32-P4-WIFI6-Touch-LCD-5_AI_Hardware_Reconstruction.yaml` —
реконструкцию железа платы, сделанную другой ИИ-системой по той же схеме
и документации Waveshare. Копия — `docs/ref/`.

Документ полезный и написан честно: он сам делит утверждения на `confirmed`,
`inferred` и `unknown` и просит не считать `inferred` пригодным для
производства. Проверка это подтвердила — **часть `inferred`-записей
ошибочна**. Ниже разобрано по трём корзинам.

---

## 1. Подтверждено проверкой по схеме — принимаем

Проверено визуально в `docs/ref/ESP32-P4-WIFI6-Touch-LCD-5-Schematic.pdf`.

### Отладочный UART занимает GPIO37 и GPIO38

Мост **U6 CH343P**: вывод 4 `TXD` ← **GPIO38**, вывод 5 `RXD` ← **GPIO37**.
Выводы 12 и 13 дают `DTR` и `RTS`.

### GPIO35 сидит в цепочке автосброса

**U7 EMH4T2R**, транзисторная сборка: вход 1 ← `RTS`, выход 6 → `ESP_EN`
(подтяжка R44 10 кОм к `ESP_3V3`, C30 1 мкФ на землю); вход 3 ← **GPIO35**,
вход 4 ← `DTR`. Это штатная схема «автоматически войти в загрузчик по
DTR/RTS»: GPIO35 здесь играет роль вывода BOOT.

**Практический вывод:** кнопку на GPIO35 вешать нельзя — помешает прошивке.
GPIO37 и GPIO38 занимать тоже нельзя, иначе теряется консоль и заливка
по USB-C.

### Измерение батареи на GPIO20

`BAT` → **R12 200 кОм ±1 %** → `BAT_ADC` → **R15 100 кОм ±1 %** → земля,
плюс C175 и C176 по 100 нФ. Цепь `BAT_ADC` идёт на **GPIO20**.

Делитель даёт **одну треть** напряжения батареи: полные 4,2 В превращаются
в 1,4 В на входе АЦП. Относится к вопросу Q14 — см. §4.

### Обозначения узлов

Совпали с тем, что читается в схеме: U1 — модуль ESP32-C6-MINI-1,
U6 — CH343P, U8 — ESP32-P4NRW32, U9 — AP3032 (подсветка), U10 — GD25Q256
(флеш 32 МБ), U11 и U13 — LDO, **U12 — ES8311**, **U14 — ES7210**,
**U15 — NS4150B**, U17 — SCT12A0 (основной преобразователь),
U19 — ETA6098 (зарядник), Y1 — кварц 40 МГц.

Разъёмы: **J2** — литиевая батарея 3,7 В, **H3** — перезаряжаемая батарейка
RTC через диод D2 (B5819WS), **J3** — гребёнка на 40 контактов,
**J8** — дисплей.

---

## 2. Опровергнуто проверкой — не принимаем

### Карта microSD в YAML сдвинута

YAML утверждает: `cmd: GPIO41, clk: GPIO42, d0: GPIO44, d1: GPIO43,
d2: GPIO39, d3: GPIO40`.

По схеме, разъём **SD1**, вывод за выводом:

| Вывод SD1 | Функция | Цепь |
|---|---|---|
| 1 | D2 | GPIO41 |
| 2 | CD/D3 | GPIO42 |
| 3 | **CMD** | **GPIO44** |
| 4 | VDD | `SD1_VDD` |
| 5 | **CLK** | **GPIO43** |
| 6 | VSS | земля |
| 7 | **D0** | **GPIO39** |
| 8 | **D1** | **GPIO40** |

То есть верно: **D0…D3 = GPIO39…GPIO42, CMD = GPIO44, CLK = GPIO43.**
В YAML имена функций разъехались с номерами цепей на две позиции.

Это ровно то, что говорит и `docs/IO.md` самого Waveshare. **Приоритет
источников установлен:** документация вендора и схема — да, `inferred`
из YAML — нет.

### GPIO7 и GPIO8 — не microSD, а шина I²C

YAML: «MicroSD-related / expansion», `inferred`. На деле это
`ESP_I2C_SDA` и `ESP_I2C_SCL` — общая шина платы, на которой висят
GT911, ES8311 и ES7210. Подтверждено и схемой, и `IO.md`.

### GPIO9…GPIO13 — не сопроцессор, а звук

YAML: «ESP32-C6-related», `inferred`. На деле это шина I²S:
MCLK = GPIO13, BCLK = GPIO12, LRCK = GPIO10, DOUT = GPIO9, DIN = GPIO11.

### Разъём динамика — не J5

YAML указывает `speaker_connector: J5`. В схеме рядом с J5 стоит подпись
**MIC2**, и у J5 четыре вывода, а не два. Номер разъёма динамика остаётся
**не установленным**; сам разъём существует и заказчик видит его
на фотографии как GH1.25 на два контакта.

---

## 3. Новое и непроверенное — принять к сведению

Ни подтвердить, ни опровергнуть по имеющимся данным не вышло:

| Утверждение YAML | Почему интересно |
|---|---|
| **Key1, Key2, Key3** — пользовательские кнопки, привязка неизвестна | Если на плате действительно есть три свободные кнопки, часть пресетов можно повесить на них. Проверить по приходе платы |
| GPIO45 — определение вставленной карты | На отрисованном фрагменте вывод CD уходит вправо, куда — не прослежено |
| J4 — шестиконтактный разъём тача, питание 1,8 В | Согласуется с тем, что тач сидит на `VCC_1.8V` |
| U20 `ECJ23001-4FCBD6`, «устройство ввода с АЦП» | Помечено `inferred` и выглядит сомнительно. Что это за узел — неясно |
| GPIO54 — управление включением C6 | Правдоподобно, не проверено |

---

## 4. Что меняется в проекте

### Q11: свободных выводов не двадцать один, а восемнадцать

Прежний список ([26](26-firmware-spec.md), §2.5) включал GPIO35, GPIO37
и GPIO38. Все три заняты: первый — цепочкой автосброса, два других —
отладочным UART. Исправленный список свободных выводов гребёнки:

> **GPIO3, 4, 5, 21, 22, 28, 29, 30, 31, 32, 34, 46, 47, 48, 49, 50, 51, 52**

**Восемнадцать линий при потребности в семнадцати.** Вывод «расширитель
портов не нужен» устоял, но запаса практически нет — раньше я писала
«с запасом», и это было неверно.

Если запас нужен, есть три способа его получить, и все дешёвые: поставить
шесть кнопок пресетов вместо восьми (заказчик 2026-08-26 сказал, что число
некритично), увести две ячейки на экранные плитки, либо проверить историю
про Key1–Key3 на плате.

### Q14: измерение батареи есть, признака пропадания питания — пока нет

`BAT_ADC` на GPIO20 даёт напряжение батареи через делитель 1:3. Это
**не прямой** признак «внешнее питание исчезло», но косвенно работает:
пока внешние 5 В есть, зарядник держит батарею у напряжения заряда;
как только пропали — напряжение начинает падать. Задержка при этом
неизбежна.

**Следующая проверка по Q14:** у зарядника **ETA6098 (U19)** обычно есть
выход состояния заряда. Разведён ли он на какой-нибудь GPIO — по схеме
не смотрели. Это и был бы прямой признак.

---

## 5. Вывод о самом документе

Пользоваться можно, но **только сверяясь**. Всё, что помечено `confirmed`,
у нас сошлось; всё, что `inferred`, требует проверки, и три записи из пяти
проверенных оказались неверными. Автор документа сам об этом предупреждает
в шапке — предупреждение оправдалось буквально.

Порядок доверия к источникам по железу этой платы:

1. **Схема платы** — `docs/ref/ESP32-P4-WIFI6-Touch-LCD-5-Schematic.pdf`;
2. **`docs/IO.md` в репозитории Waveshare** — сверен вендором с исходником
   BSP и со схемой;
3. исходники BSP и примеров;
4. этот YAML — как подсказка, куда смотреть, а не как источник значений.
