Spok1978/hybrid-radio/hardware/kicad/power/render/power_bottom.png

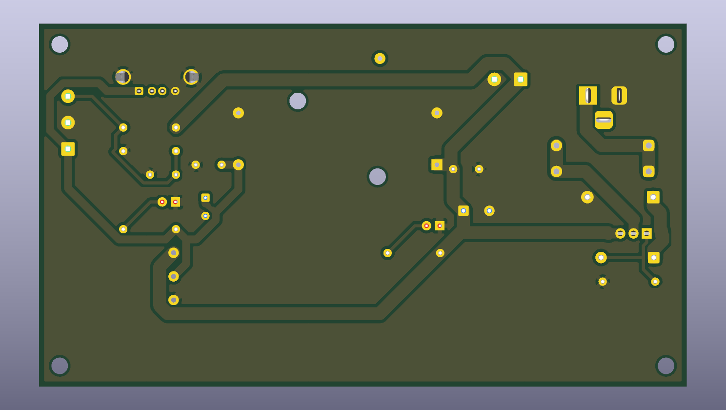
hardware/kicad/power/render/power_bottom.png
