Spok1978/hybrid-radio/hardware/kicad/power/render/power_top.png

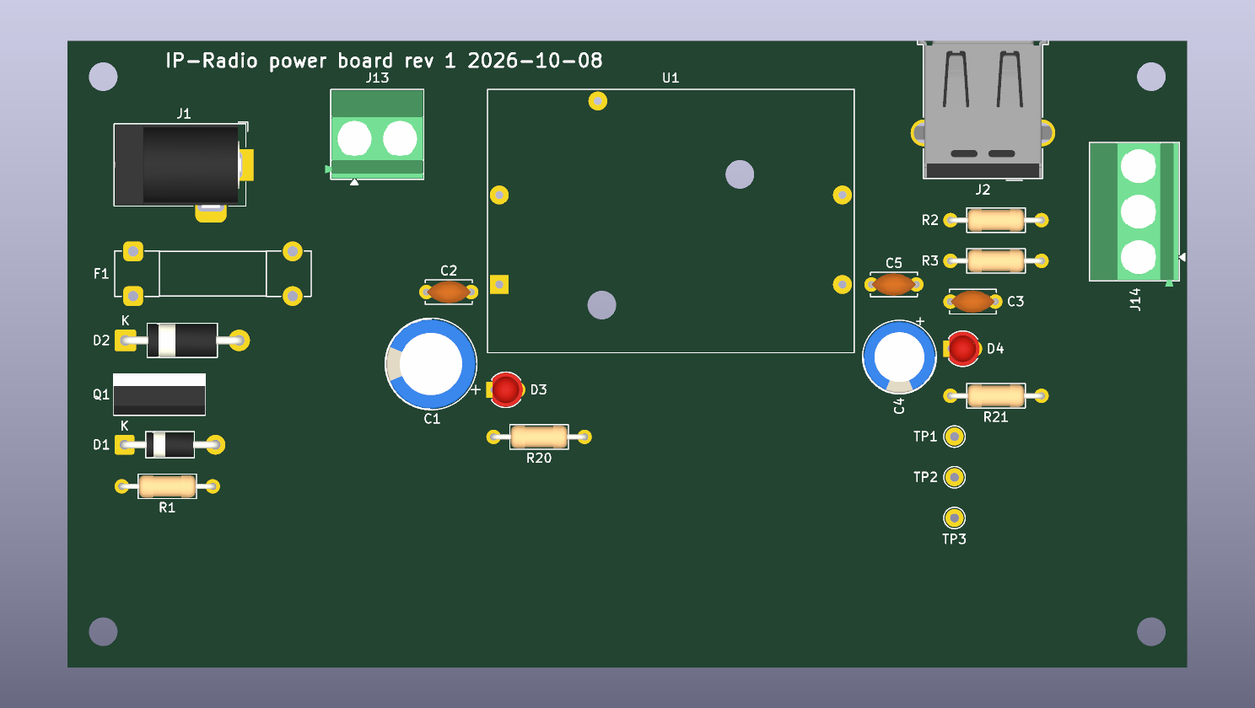
hardware/kicad/power/render/power_top.png
