Spok1978/hybrid-radio/docs/07-bom-draft.md

# 07. Черновой состав комплекта (для предлагаемой конфигурации)

> **НЕАКТУАЛЬНО — ревизия на Raspberry Pi.** С 2026-08-26 приёмник строится
> только на плате Waveshare ESP32-P4-WIFI6-Touch-LCD-5 ([24](24-main-build-p4.md)),
> Raspberry Pi в проекте не используется. Документ сохранён как история
> решений; для сборки, схемы и прошивки не применять. Актуальное: доп. платы —
> [33](33-carrier-board.md), перечень деталей — [35](35-carrier-boards-parts.md),
> выводы P4 — [33](33-carrier-board.md) §2, прошивка — [26](26-firmware-spec.md).

Это **не спецификация на закупку**, а прикидка под принятые решения
(2026-08-17): Radio Browser + локальная база (Q1-a), тюнер RDA5807M (Q2-a),
платформа Raspberry Pi (Q3), экран Touch Display 2 с сенсором (Q4).
Размер экрана и конкретная плата — вариант V1/V2 из [08](08-cost-and-board-choice.md).

## Основное

| Поз. | Наименование | Кол-во | Зачем | Примечание |
|---|---|---|---|---|
| 1 | **Raspberry Pi 3 Model B+** | 1 | вычислитель, Wi-Fi, экран, звук | 1 ГБ ОЗУ, DSI, dual-band Wi-Fi; интерфейс всё равно без браузера |
| 2 | microSD 16–32 ГБ (класс A1) | 1 | система | не самая дешёвая — иначе тормоза |
| 3 | Raspberry Pi Touch Display 2, **5″** ($40) | 1 | R3, R4 | 720×1280, ёмкостный тач; шлейф 15-way → 15-way (для Pi 3B+) |
| 4 | Модуль FM-тюнера RDA5807M (RRD-102V2.0 или аналог) | 1 | R1.1–R1.5 | **питание 3,3 В, 5 В нельзя** |
| 5 | ЦАП I²S PCM5102A (стерео, линейный выход) | 1 | звук из вычислителя | стерео сохраняем на будущее |
| 6 | УНЧ на **TPA3118D2** (модуль), питание 12 В, задействован один канал | 1 | R5 | усиление выставить 26 дБ; вывод SD через 100 кОм на землю |
| 7 | Динамик широкополосный **4 Ω, 10–15 Вт, 4″ (100 мм)** | 1 | R5 | нужен закрытый объём |
| 8 | Энкодер с кнопкой (EC11) | 1–2 | перестройка/громкость | см. [05](05-display-and-ui.md) |
| 9 | Кнопки тактовые с колпачками | 5 | R4 | ◄ ► SEEK MEM MENU |
| 10 | Тумблер 2-позиционный (лучше с двумя группами) | 1 | R2 | вторая группа — резерв под коммутацию звука |
| 10a | Кнопка питания (без фиксации) + фиксирующий ключ на 12 В | 1 компл. | мягкое выключение | `gpio-shutdown` + `gpio-poweroff`, см. [10](10-shutdown-and-data-safety.md), п. 4 |
| 11 | Узел питания: гнездо 12 В, защита, преобразователь 12→5 В, LDO 3,3 В | 1 | всё | **отдельный перечень P1…P14 в [09](09-power-supply.md)**, п. 14 |
| 12 | Внешний блок питания **12 В / 3 А**, стабилизированный | 1 | питание | штекер 5,5×2,1, «плюс» в центре |
| 13 | Антенна: провод 0,75–1 м, гнездо, кабель | 1 | R1.1 | телескопическая антенна удобнее |

## Мелочёвка

- Резисторы 10 к (4 шт.), 100 к (1 шт.) и конденсатор 4,7 мкФ — суммирующий
  узел, [04](04-audio-path.md), п. 3.1
- Развязка по питанию УНЧ и прочая обвязка — см. [09](09-power-supply.md)
- Провода DuPont для макета, потом — пайка
- Радиатор на Pi (при работе в закрытом корпусе — обязательно)

## Возможные замены и расширения потом

| Если понадобится | Что меняется |
|---|---|
| Не хватит чувствительности в эфире | модуль Si4735-D60 / Si4732-A10 вместо поз. 4, тот же I²C |
| Захочется спектр и все диапазоны | свисток RTL-SDR (R820T2) в USB; поз. 4 и суммирующий узел не нужны. У 3B+ четыре USB, хаб не нужен |
| Захочется стерео | задействовать второй канал того же TPA3118 и поставить второй динамик; ЦАП уже стерео, сумматор разделяется на два |
| Не хватит 1 ГБ | Pi 4 2 ГБ вместо поз. 1 — разъёмы и шлейф те же (для Pi 5 нужен другой шлейф, 22→15) |
| Питание от аккумулятора (Q6) | свинцовая батарея 12 В или сборка Li-ion 3S с балансиром — подключается на ту же шину 12 В |

## Порядок сборки макета

**Заменён 2026-08-21** — актуальный порядок в [14-software-stack.md](14-software-stack.md), §6:
начинаем с тюнера как с самого рискованного узла, параллельно с проверкой
эфира (Q7). Ниже — прежний вариант, оставлен для истории.

### Прежний порядок (не действует)

1. Pi + экран + автозапуск интерфейса — проверить, что рисуется меню.
   Интерфейс лёгкий (PyQt5 или pygame поверх KMS), без рабочего стола и
   браузера — иначе 512 МБ не хватит. Автозапуск — systemd, как в cable-tester.
2. Wi-Fi: сканирование, подключение, сохранение через `nmcli` — из интерфейса.
3. Интернет-радио: играем один захардкоженный URL через mpv/MPD → появился звук.
4. Radio Browser: поиск по стране/жанру, добавление в локальную базу.
5. Тюнер по I²C: чтение ID чипа, установка частоты, SEEK, чтение RDS.
6. Сведение звука, кнопка MODE, общая громкость.
7. Кнопки и энкодер, полное меню.
8. Корпус.

Каждый шаг проверяемый и не ломает предыдущий — это тот же принцип
«прототип → продукт», что и в cable-tester.
