Spok1978/hybrid-radio/docs/08-cost-and-board-choice.md

# 08. Как удешевить проект и какую плату брать

> **НЕАКТУАЛЬНО — ревизия на Raspberry Pi.** С 2026-08-26 приёмник строится
> только на плате Waveshare ESP32-P4-WIFI6-Touch-LCD-5 ([24](24-main-build-p4.md)),
> Raspberry Pi в проекте не используется. Документ сохранён как история
> решений; для сборки, схемы и прошивки не применять. Актуальное: доп. платы —
> [33](33-carrier-board.md), перечень деталей — [35](35-carrier-boards-parts.md),
> выводы P4 — [33](33-carrier-board.md) §2, прошивка — [26](26-firmware-spec.md).

Задача из обсуждения 2026-08-17: платформа — Raspberry Pi, но **без большой
платы под простую задачу** и с меньшей стоимостью.

## 1. Сначала факт, который меняет постановку

**Самый дорогой узел — не плата, а экран.**

Официальные цены с сайта Raspberry Pi (проверено 2026-08-17):

| Позиция | Цена |
|---|---|
| Touch Display 2, **7″** | **$60** |
| Touch Display 2, **5″** | **$40** |
| Raspberry Pi 4 Model B | «From $35» |

То есть выбранный 7″ экран стоит дороже, чем целая плата Pi 4. Экономия на
вычислителе при сохранении 7″ экрана даёт максимум пару десятков долларов,
а экономия на экране — сразу $20.

И главное: **у обеих версий Touch Display 2 одинаковое разрешение 720×1280**
(24-bit RGB, ёмкостный тач на 5 касаний). 5″ не хуже по картинке — он плотнее.
Если 5″ по размеру устраивает, это самое дешёвое место в проекте.

## 2. Жёсткое ограничение: Zero 2 W и Touch Display 2 несовместимы

Это надо знать до закупки. Проверено по официальной документации 2026-08-17:

- Раздел совместимости Touch Display 2: 5″ и 7″ — «Raspberry Pi B+ and later»,
  и **Raspberry Pi Zero series прямо указаны как несовместимые**.
- Спецификация Raspberry Pi Zero 2 W: есть только «CSI-2 camera connector»,
  разъёма DSI нет. Видеовыход — mini HDMI.
- Для Pi 5 нужен переходной шлейф 22-way → 15-way; для Pi 4 и старше —
  15-way → 15-way.

Вывод: **либо Touch Display 2 и плата с DSI, либо Zero 2 W и HDMI-панель.**
Третьего нет.

## 3. Самая дешёвая плата с DSI и Wi-Fi — Raspberry Pi 3 Model A+

Спецификация с официальной страницы (проверено 2026-08-17):

```
SoC        Broadcom BCM2837B0, Cortex-A53 (ARMv8) 64-bit @ 1.4 GHz
RAM        512 MB LPDDR2
Wi-Fi      2,4 и 5 ГГц 802.11 b/g/n/ac, Bluetooth 4.2/BLE
USB        один порт USB 2.0
Видео      full-size HDMI + DSI display port (для Touch Display)
Камера     CSI
Питание    5 В / 2,5 А
```

Плюсы под нашу задачу:

- **есть DSI** → Touch Display 2 подключается штатно;
- Wi-Fi двухдиапазонный на борту — ничего докупать не надо;
- процессор тот же класса, что у Zero 2 W, но 1,4 ГГц против 1,0 ГГц;
- по данным обсуждения заявлений о снятии с производства, 3A+ выпускается
  **как минимум до января 2030** — то есть это не тупик.

Минусы, честно:

- **512 МБ ОЗУ** — браузерный киоск (как в cable-tester) сюда не влезет
  нормально. См. п. 4;
- один USB 2.0 — если позже захочется RTL-SDR плюс клавиатура, нужен хаб;
- плата 2018 года, интерфейс надо писать экономно.

## 4. Ключевой ход: интерфейс без браузера

Именно это позволяет взять маленькую плату. Chromium в киоске на 512 МБ
работает на грани OOM. Но интерфейсу радиоприёмника браузер и не нужен:
там списки, крупные цифры частоты, пара индикаторов.

Варианты лёгкого интерфейса на Pi (пишем всё так же на Python):

| Стек | Плюсы | Минусы |
|---|---|---|
| **PyQt5** (пакет `python3-pyqt5` из репозитория Raspberry Pi OS) | настоящие виджеты: списки, кнопки, экранная клавиатура; кириллица штатно | тяжелее pygame, но в 512 МБ помещается |
| **pygame / SDL2** прямо на KMS, без рабочего стола | минимум памяти, полный контроль над видом | все виджеты (список, прокрутка, клавиатура) рисуем сами |
| **LVGL** через привязку к Python | сделан ровно под такие приборы | больше возни с установкой на Pi |

Что при этом теряем: часть наработок cable-tester (там NiceGUI + Chromium).
Что выигрываем: плата дешевле и меньше, загрузка быстрее, нет рабочего стола.

Само воспроизведение потоков от интерфейса не зависит — играет **MPD или mpv**
в фоне, а интерфейс им только командует. Zero-класс железа с этим справляется:
по отзывам, Pi Zero 2 W с MPD работает и потребляет ~1,3 Вт в простое.

## 5. Варианты комплектации по стоимости

| Вариант | Плата | Экран | Комментарий |
|---|---|---|---|
| **V1 — минимум цены** | Pi 3A+ | Touch Display 2 **5″**, $40 | Самый дешёвый комплект с родным DSI-экраном. Разрешение то же 720×1280 |
| **V2 — как выбрано** | Pi 3A+ | Touch Display 2 **7″**, $60 | Экран крупнее, всё остальное то же |
| **V3 — самая маленькая плата** | Pi Zero 2 W | HDMI-панель 5–7″ | Плата дешевле и меньше всех, но **Touch Display 2 не подходит**; нужны mini-HDMI переходник, USB для тача, отдельное питание панели |
| **V4 — с запасом** | Pi 4 2 ГБ | Touch Display 2 7″ | Дороже, зато работает браузерный стек как в cable-tester, и есть место под RTL-SDR |

Точные цены плат на сайте производителя не опубликованы в открытом виде
(на страницах 3A+ и Zero 2 W цена не показана) — уточняем у поставщика,
в разных регионах разброс большой.

## 6. Прочие места, где реально экономится

| Мера | Экономия | Риск |
|---|---|---|
| MAX98357A (ЦАП+УНЧ в одном) вместо PCM5102A + PAM8403 | одна плата вместо двух | моно; аналог с тюнера в него не подмешать → нужна схема 3 из [04](04-audio-path.md) |
| Динамик и корпус от старой техники | ощутимо | подбор по параметрам «на слух» |
| Антенна — кусок провода 0,75–1 м вместо телескопической | копейки | хуже на УКВ, но проверить приём можно сразу |
| microSD 16 ГБ вместо 32 ГБ | немного | берём A1, не самую дешёвую — иначе тормоза |
| Питание от имеющегося блока 5 В | — | **только если он честные 3 А и стабильный** |

## 7. На чём экономить нельзя

- **Питание.** Просадки на Pi = порча SD-карты и случайные перезагрузки.
- **Отдельный стабилизатор 3,3 В для тюнера.** Экономия на нём слышна в
  динамике как «цыканье» процессора в эфирном режиме.
- **Качество microSD.** Дешёвая карта — источник половины «непонятных
  глюков» на Pi.

## 8. Что предлагаю

**V1 или V2**, интерфейс — PyQt5 без рабочего стола, воспроизведение —
MPD в фоне. Разница между V1 и V2 — только размер экрана и $20.

V3 (Zero 2 W) имеет смысл, только если готов отказаться от родного экрана
в пользу HDMI-панели: тогда плата самая дешёвая, но появляются переходники,
второе питание и возня с настройкой разрешения.

**Принято 2026-08-18: экран Touch Display 2 5″ (вариант V1), плата —
Raspberry Pi 3 Model B+** (см. п. 9: тот же SoC, но 1 ГБ вместо 512 МБ).
Отказ от 3A+ стоит разницы в цене платы и большего размера, зато снимает
главный риск конфигурации — нехватку памяти. Интерфейс всё равно делаем
лёгким, без браузера: на 1 ГБ он тоже полезнее, чем Chromium.

## 9. Какие ещё платы имеют разъём DSI

Проверено 2026-08-17…18. Главное, что надо понимать: **«есть DSI» и
«заработает Touch Display 2» — разные вещи.** DSI это интерфейс, а панели
нужен ещё драйвер под её контроллер. Поэтому список делится на три уровня.

### Уровень 1 — Raspberry Pi, поддержка официальная

По документации Touch Display 2 совместимы «Raspberry Pi B+ and later» и все
платы Compute Module IO (CMIO). По таблице характеристик разъём
«standard 15-pin, 1.0 mm pitch, 16 mm width, DSI (display) port» есть у:

`Model A`, `Model B`, `Model A+`, `Model B+`, `2B`, `3B`, `3B+`, `3A+`, `4B`.
У `Pi 5` — совмещённые CSI/DSI разъёмы, нужен шлейф 22-way → 15-way.

**DSI нет:** вся серия **Zero** (только CSI), **Pi 400**, **Pi 500**.

Compute Module: DSI выведен на плату-носитель. У CM4 IO Board разъём
22-контактный → нужен переходник на 15 контактов; в `config.txt` прописывается
`dtoverlay=vc4-kms-dsi-ili9881-7inch` — это оверлей именно Touch Display 2.

Что из этого реально имеет смысл для нашего приёмника:

| Плата | ОЗУ | Комментарий |
|---|---|---|
| 3A+ | 512 МБ | самая маленькая и дешёвая с DSI и Wi-Fi, но памяти в обрез |
| **3B+** | **1 ГБ** | **выбрана 2026-08-18.** Тот же SoC BCM2837B0 @1,4 ГГц, но вдвое больше памяти, плюс Gigabit Ethernet и 4×USB. Крупнее (форм-фактор B) и ест больше |
| 4B 2 ГБ | 2 ГБ | запас, работает браузерный интерфейс |
| CM4 + носитель | 1–8 ГБ | компактно и «промышленно», но дороже и нужен переходник 22→15 |

**Резервный ход, если 512 МБ окажется тесно: не Pi 4, а Pi 3B+.** Тот же
процессор, вдвое больше памяти, тот же шлейф 15→15, тот же софт — переход
стоит только денег за плату.

### Уровень 2 — не-Pi SBC, которые умеют родной дисплей Pi

По руководству RS DesignSpark, официальный **7″ дисплей 800×480** (первого
поколения) заводится на платах Radxa:

- ROCK 3A / 3B / 3C и 4SE — штатным шлейфом дисплея, переходник не нужен;
- ROCK 4C+ / 5A / 5B — через отдельный переходной шлейф MIPI DSI
  (у них мини-разъёмы);
- включается оверлеем через утилиту `rsetup`, например
  `rock-3a-raspberrypi-7inch-touchscreen.dtbo`.

**Оговорка:** руководство описывает дисплей первого поколения 800×480.
Подтверждений, что там работает именно Touch Display 2, я не нашёл —
это надо проверять, а не предполагать.

Прочие платы с MIPI DSI: Orange Pi 5 Pro, платы Banana Pi на RK3588, часть
Radxa ROCK 5-й серии. Но их DSI рассчитан на свои панели; с дисплеем Pi это
каждый раз отдельная история с оверлеем.

### Уровень 3 — микроконтроллеры с DSI

- **ESP32-P4** — MIPI DSI на 1 или 2 линии, до 1,5 Гбит/с на линию
  (2 линии = 3 Гбит/с), форматы RGB565/RGB666/RGB888, поддерживается только
  video mode. Двух линий хватает на 1280×800 при 60 Гц. Именно на ESP32-P4
  проект MiniWebRadio поддерживает DSI-дисплей 1024×600.
- STM32H747 / STM32F769 / STM32MP1, NXP i.MX RT1170 — тоже с DSI, но это
  совсем другой путь разработки.

У микроконтроллеров нет готового ядра с драйвером панели Raspberry Pi:
драйвер пишется/берётся под конкретную панель. Поэтому вариант «ESP32-P4 +
Touch Display 2» я бы заранее считал неработающим, пока кто-то не покажет
обратное.

### Вывод для проекта

**Решение 2026-08-18: берём Pi 3 Model B+.** Не ждём, пока упрёмся в 512 МБ,
а сразу берём 1 ГБ на том же процессоре и с тем же шлейфом 15→15.
Побочные плюсы: четыре USB (RTL-SDR или клавиатура без хаба) и Ethernet
для отладки без Wi-Fi. Побочные минусы: плата крупнее (форм-фактор B) и
потребляет больше — учтено в бюджете тока, [09](09-power-supply.md).

## 10. Возврат к ESP32 после закупки (2026-08-21)

Идея: удешевить, взяв ESP32 и другой экран. Разбираю честно, потому что
арифметика здесь не в пользу того решения, которое мы приняли, — и это надо
признать прямо.

### Цифры

| Вариант | Состав | Порядок цены |
|---|---|---|
| Что заказано | Pi 3B+ + Waveshare 7″ DSI (C) + microSD | **≈$80–95** |
| **Sunton ESP32-8048S070** | ESP32-S3 + 7″ 800×480 RGB + ёмкостный тач **одной платой** | **$21–28** |
| Elecrow CrowPanel Advance 7″ | ESP32-S3 + 7″ IPS + тач, сменный радиомодуль | $30–40 |

То есть при выборе в самом начале эта дорога была бы **дешевле раза в три
по цифровой части**. Приятная деталь у Sunton: на плате уже стоит
I²S-усилитель MAX98357A на 3,2 Вт в 4 Ω — то есть в компактной версии можно
обойтись без отдельного ЦАП вообще.

### Почему всё же не переигрываем сейчас

1. **Железо уже куплено.** Переход не экономит, а добавляет: платим ещё
   за плату ESP32, а Pi с экраном ложатся в стол. Экономия становится
   отрицательной.
2. **Концепция ещё не подтверждена.** Не проверено главное: есть ли что
   принимать в УКВ (Q7), не убьёт ли приём помеха от преобразователя, как
   поведёт себя сумматор. Менять платформу до первого работающего макета —
   значит отлаживать два неизвестных сразу.
3. **Причины отказа из [03](03-controller-platform.md) никуда не делись:**
   HLS-потоки ESP32 не тянет, ввод пароля Wi-Fi требует второго устройства,
   кириллица в LVGL делается руками. Весь программный план
   [14](14-software-stack.md) при переходе выбрасывается.

Один аргумент за Pi при этом **ослаб и это честно признать**: «переиспользуем
стек cable-tester» больше не работает — мы отказались от браузера и пишем
нативный интерфейс, то есть интерфейс всё равно пишется с нуля. Вопрос лишь
в том, на Python с pygame или на C++ с LVGL.

### Что при таком переходе уцелеет из заказанного

Почти всё, кроме вычислителя с экраном: тюнер, ЦАП, усилитель, динамик,
**весь силовой узел на 12 В**, органы управления, провода и монтаж.
В стол ложатся Pi 3B+, экран, microSD, радиаторы и кабель micro-USB.

### Отдельно: ESP32-P4 с нашим DSI-экраном — не выйдет

Соблазнительная мысль: взять ESP32-P4, у которого есть MIPI DSI, и оставить
уже купленную панель 1024×600. Проект MiniWebRadio такую связку даже
поддерживает.

Не берём: **у ESP32-P4 нет ни Wi-Fi, ни Bluetooth вообще.** Радио на нём
делается только через компаньон ESP32-C6 по SDIO, платы с таким сочетанием
новее и дороже, а у самой связки P4 + C6 есть открытые проблемы со стабильностью
Wi-Fi. Для интернет-радиоприёмника это не тот фундамент.

### C-серия (C3, C5, C6) — не подходит

Проверено 2026-08-21. Вариант «C4» не существует.

| | ESP32-C3 | ESP32-C6 | ESP32-C5 | ESP32-S3 |
|---|---|---|---|---|
| Ядра / частота | 1 × 160 МГц | 1 × 160 МГц | 1 × 240 МГц | **2 × 240 МГц** |
| SRAM | 400 КБ | 512 КБ | 384 КБ | 512 КБ |
| PSRAM | **не поддерживается** | опционально | есть | **есть, до 8 МБ** |

Интернет-радио упирается в PSRAM: там живёт буфер потока и рабочая память
декодера. Готовая база `ESP32-MiniWebRadio` требует **S3 с PSRAM от 4 МБ**,
под C-серию её нет вовсе — пришлось бы писать приём потока, декодер и
интерфейс с нуля.

### Готовые платы «экран + процессор» на S3

**Waveshare ESP32-S3-Touch-LCD-2.8**: S3 два ядра 240 МГц, **8 МБ PSRAM**,
16 МБ флеш, экран 2,8″ IPS 240×320 с ёмкостным тачем на 5 касаний,
Wi-Fi и Bluetooth 5. Требованиям MiniWebRadio соответствует.

Варианты того же размера: **2.8B** — 480×640, **2.8C** — круглый 480×480.
Под интерфейс со списками станций правильнее брать 2.8B: вдвое больше строк
на том же диагонали.

Звукового выхода на этих платах нет — ЦАП PCM5102A и усилитель из заказа
остаются в деле, как и тюнер, динамик, силовой узел 12 В и органы управления.
В стол ложатся Pi 3B+, экран 7″ и microSD.

**Требование R3 при этом нарушается** — там записано «5″ или 7″».
Переход на 2,8″ означает переписывание R3 и всей раскладки меню.

### Что уже стоит на плате ESP32-S3-Touch-LCD-2.8

По вики Waveshare (SKU 27690, проверено 2026-08-21):

ESP32-S3R8, 16 МБ флеш, **8 МБ PSRAM**; экран 2,8″ 240×320 с ёмкостным тачем;
**ЦАП PCM5101**; **микросхема усилителя мощности** и разъём динамика
с **комплектным динамиком 8 Ом 2 Вт**; **регулятор громкости**;
**слот TF-карты**; **микросхема часов PCF85063**; датчик QMI8658;
контроллер заряда и разъём MX1.25 под литиевый аккумулятор 3,7 В;
LDO ME6217C33M5G на 800 мА; разъём I²C, разъём UART, 12-контактный
многофункциональный разъём, USB-C.

Оговорка из вики про I²C: разъём внутренне соединён с другими микросхемами
платы, поэтому **переназначить эти выводы под другие функции нельзя** —
но внешние устройства по I²C к нему подключать можно, для этого он и выведен.

Тюнер туда встаёт. Адреса на шине не пересекаются: тач 0x1A или 0x15,
часы PCF85063 — 0x51, датчик QMI8658 — 0x6A или 0x6B, RDA5807M — 0x10 и 0x11.

Отсюда следует, что при переходе на эту плату из заказанного **не нужны**:
ЦАП PCM5102A (на плате PCM5101), часы DS3231 (на плате PCF85063),
карта памяти для Pi, сам Pi и экран 7″.

**Остаются нужными:** тюнер RDA5807M, антенна с кабелем, усилитель TPA3118D2
с динамиком 4 Ом (если нужна громкость больше комплектных 2 Вт) и весь
силовой узел 12 В — но только вместе с этим усилителем. Если 2 Вт хватает,
плата питается от USB-C или литиевого аккумулятора, и силовой узел не нужен
вовсе.

### Два узких места этой платы

**Звук.** Встроенный тракт рассчитан только на свой ЦАП: аналогового входа
снаружи не предусмотрено. Завести туда выход тюнера некуда. Варианты:
отказаться от встроенного звука и вывести I²S на свой ЦАП с усилителем
(нужно проверить, выведен ли I²S на 12-контактный разъём), либо оставить
встроенный тракт интернет-радио, а эфир пустить через отдельный усилитель
и коммутировать на уровне динамика.

**Выводы под органы управления.** Наружу выведены I²C, UART и
12-контактный разъём. Выводы I²C заняты шиной и как обычные GPIO
использоваться не могут. Два энкодера, шесть кнопок и приглушение
усилителя — это тринадцать линий, столько там нет. Основным вводом
становится тач, а физические органы уходят на ту же шину I²C:

- **энкодеры** — готовые модули с интерфейсом I²C (Adafruit Stemma QT Rotary
  Encoder на прошивке seesaw, адрес 0x36, перемычками до 0x3D, то есть до
  восьми штук на шину). Такой применён в переделанных часах-радио Alan Boris;
- **кнопки** — через расширитель портов PCF8574.

Тюнер при этом там же: RDA5807M управляется только по I²C, другого интерфейса
у него нет.

### Рабочий пример интерфейса на такой плате

Проект «ESP32-S3 Smart Weather Station with Touchscreen Dashboard and LVGL»
(PCBWay): плата **VIEWE 2.8″ ESP32-S3 Smart Display**, интерфейс на **LVGL 8.4.0**,
среда **ESP-IDF 5.3.5** в VS Code, датчики по I²C на GPIO9 (SDA) и GPIO10 (SCL),
аналоговые входы на GPIO6 и GPIO7. Исходники опубликованы.

Что оттуда берём, если пойдём этим путём: связку версий LVGL 8.4.0 + ESP-IDF 5.3.5
как заведомо рабочую и номера выводов I²C, свободных на таких платах — туда
пойдёт тюнер.

Чего этот пример **не доказывает**: приборная панель, обновляемая раз в
несколько секунд, и декодирование потока AAC с одновременной перерисовкой
экрана — нагрузки разного порядка. Звуковую часть на S3 подтверждает
MiniWebRadio, а не этот проект.

### Сравнение пяти плат со смарт-экраном (2026-08-21)

| Плата | Экран | PSRAM | GPIO | Карта | Кодек с аналоговым входом |
|---|---|---|---|---|---|
| Waveshare ESP32-P4-WIFI6-Touch-LCD-4B | 4,0″ 720×720 DSI | 32 МБ | ~27 | есть | **ES8311 + ES7210** |
| Espressif ESP32-S3-BOX-3 | 2,4″ 320×240 | 16 МБ | 16 | нет | **ES8311 + ES7210** |
| M5Stack CoreS3 | 2,0″ 320×240 | 8 МБ | M-Bus + Grove | есть | ES7210 (микрофонный) |
| LILYGO T-Display-S3 | 1,9″ 170×320, **без тача** | 8 МБ | 13 на гребёнках | нет | нет |
| Seeed SenseCAP Indicator D1 | 3,95″ 480×480 | — | 2 порта Grove | есть | нет |

**Ни одна не подходит под MiniWebRadio без переделки дисплейного порта.**
Прошивка поддерживает SPI ILI9341/ILI9486/ILI9488/ST7796, RGB 800×480 и
DSI 1024×600, и требует тач. Ни одно из этих сочетаний в списке нет, а
T-Display-S3 отпадает совсем — у него нет тача. Значит аргумент «есть
готовая прошивка» при любом выборе из этой пятёрки перестаёт работать.

**Главное различие в таблице — не размер экрана, а кодек.** У плат с ES8311
есть аналоговый вход. Выход тюнера заводится туда напрямую, микширование
и переключение делаются программно, и разом отпадают сумматор, аналоговый
ключ, узел смещения и весь разбор про ±3 В из [19](19-future-features.md).

Замечания по конкретным платам, которых нет в исходной таблице:

- **P4-плата — это настенная панель формата 86×86 мм** под стандартную
  монтажную коробку, активная область экрана 71,9×71,9 мм. И на момент
  проверки она **отсутствует в продаже**.
- У P4 нет своего Wi-Fi, он работает через сопроцессор ESP32-C6, и
  разработка ведётся только в ESP-IDF.
- У BOX-3 нет слота карты — список станций пришлось бы держать во флеш-памяти.

### Семейство плат ESP32-P4 с аналоговым входом (2026-08-21)

Оказалось, что почти все платы на P4 построены вокруг одной и той же
референсной обвязки: **кодек ES8311 (24-битные АЦП и ЦАП, 8–96 кГц) +
усилитель NS4150B класса D на 3 Вт + слот microSD по SDIO 3.0 + дисплей
по MIPI-DSI**. То есть аналоговый вход есть у всех.

| Производитель | Плата | Экран |
|---|---|---|
| **Espressif** | **ESP32-P4-Function-EV-Board** | **7″ 1024×600 DSI, ёмкостный тач** |
| Waveshare | ESP32-P4-NANO, ESP32-P4-Module-DEV-KIT, ESP32-P4-ETH | DSI разных размеров, вплоть до 10,1″ |
| Waveshare | ESP32-P4-WIFI6-Touch-LCD-4B | 4,0″ 720×720, панель 86×86 |
| 4D Systems | ESP32-P4 Round Series | круглые 3,4″ и 4,0″ |
| Guition | модуль P4 + C6 | разные, от 14 долларов |
| M5Stack | Tab5 | 5″ |

### Поправка к предыдущему выводу

Вчера записано, что ни одна плата не подходит под MiniWebRadio без переделки
дисплейного порта. **Для ESP32-P4-Function-EV-Board это неверно.**

MiniWebRadio поддерживает **ESP32-P4 с дисплеем DSI 1024×600 и тачем по I²C** —
это ровно то, что стоит на этой плате. Плюс:

- **7 дюймов — требование R3 выполняется**, переписывать его не нужно;
- **ES8311 с аналоговым входом** — выход тюнера заводится внутрь, микширование
  программное, сумматор и ключ не нужны;
- **слот microSD** — под `/stations.json`;
- на борту усилитель 3 Вт с разъёмом динамика и микрофон; если нужна громкость
  больше, линейный выход кодека идёт на наш TPA3118;
- официальная плата Espressif, цена при выходе — около 55 долларов.

Против неё остаётся прежнее: у P4 **нет своего Wi-Fi**, он работает через
сопроцессор ESP32-C6, разработка только в ESP-IDF, и у связки P4 + C6 есть
сообщения о нестабильности радиочасти.

Это лучший из рассмотренных вариантов ESP32 и единственный, при котором
доводы «дешевле» и «есть готовая прошивка» работают одновременно.

### Где хранятся станции и настройки

По устройству MiniWebRadio, которое и предполагается брать за основу:

| Что | Где |
|---|---|
| Список станций | файл `/stations.json` в корне **карты TF**; запись — массив из четырёх строк. Исправлено 2026-08-26, было «`stations.csv`, до 999 записей» — [24](24-main-build-p4.md), §2 |
| Настройки Wi-Fi, громкость, последняя станция | внутренняя флеш-память контроллера (NVS) |

Ввод и правка списка — двумя способами: через **встроенную веб-страницу**,
которую прошивка отдаёт по Wi-Fi (там же поиск по каталогу Radio Browser и
добавление найденной станции с иконкой), либо вынуть карту и отредактировать
файл на компьютере.

Отметить для протокола: это ровно тот веб-интерфейс, который мы отклонили
в Q9 для варианта на Pi. На экране 2,8″ набирать адрес потока нереально,
поэтому здесь он становится не дополнением, а **единственным практичным
способом** управлять списком.

### Заказана вторая платформа (2026-08-21)

Заказчик купил **Waveshare ESP32-P4-WIFI6-Touch-LCD-5** (5″, 720×1280 DSI,
ES8311, 40-контактная гребёнка, слот TF). Срок поставки — около двух недель.
Плату Espressif найти на AliExpress не удалось.

Теперь в работе два комплекта железа. Что из заказанного под Pi переходит
на плату P4 без изменений:

| Позиция | Переходит |
|---|---|
| Тюнер RDA5807M, антенна, коаксиал | да, I²C на гребёнке |
| Энкодеры, кнопки (тумблер отменён, см. [22](22-mode-switching.md)) | да, на гребёнку |
| Усилитель TPA3118D2, динамик 4 Ω | да, если 2 Вт комплектного мало |
| Силовой узел 12 В | только вместе с TPA3118; сама плата питается от USB-C |
| ЦАП PCM5102A | **не нужен** — на плате ES8311 |
| Часы DS3231 | **не нужны** — у P4 свои часы, на плате разъём батарейки |
| Pi 3B+, экран 7″, microSD для Pi | **не нужны** |

**Первое, что проверить при получении:** выведен ли **аналоговый вход ES8311**
на разъём. Микрофоны на плате обслуживает ES7210, а вход АЦП у ES8311 может
оказаться никуда не разведён. От этого зависит, заводится ли эфирный тракт
внутрь программно или остаётся наш пассивный сумматор.

Второе: выходит ли наружу **линейный выход кодека**, чтобы подать его на
TPA3118. Разъём динамика на плате — уже усиленный мостовой выход, для этого
он не годится.

### Решение по основной сборке

**Изменено 2026-08-26: основная сборка — ESP32-P4**, плата Waveshare
ESP32-P4-WIFI6-Touch-LCD-5. Разбор переноса, что переезжает без изменений
и что открывается заново — [24](24-main-build-p4.md).

Прежнее решение сохранено ниже как история, потому что на нём построены
документы 13, 15 и 16.

> **Собираем на Pi, как заказано** (решение 2026-08-17, отменено 2026-08-26).
> Вариант на ESP32-S3 записывался как полностью проработанная младшая
> ревизия: если Pi-версия заработает, а вопрос цены останется актуальным,
> второй экземпляр строится на плате Sunton или Elecrow.
>
> Что при этом придётся переписать: требование R3 остаётся выполнимым
> (800×480 вместо 1024×600 — раскладка та же, строк в списке меньше), но
> документы 05, 13 и 14 переписываются целиком, а часть потоков перестанет
> играть.

Оговорка про «раскладка та же» к нынешней плате **не относится**: у неё
720×1280, то есть книжная ориентация, а не альбомная. Это вопрос Q12.

## 11. Источники

- Цены и характеристики Touch Display 2: https://www.raspberrypi.com/products/touch-display-2/
- Совместимость Touch Display 2 (Zero series — несовместимы, шлейфы):
  https://www.raspberrypi.com/documentation/accessories/touch-display-2.html
- Характеристики Pi 3 Model A+: https://www.raspberrypi.com/products/raspberry-pi-3-model-a-plus/
- Характеристики Pi Zero 2 W: https://www.raspberrypi.com/products/raspberry-pi-zero-2-w/
- Цена Pi 4 «From $35»: https://www.raspberrypi.com/products/raspberry-pi-4-model-b/
- Сроки выпуска 3A+ (не менее чем до января 2030) — обсуждение заявлений
  об обсолесценции: https://forums.raspberrypi.com/viewtopic.php?t=374010
- Потребление и работа Zero 2 W с MPD, ограничения 512 МБ:
  https://www.hackster.io/news/raspberry-pi-zero-2-w-review-hands-on-with-the-fastest-zero-ever-b85b155905a5
- Характеристики Pi 3 Model B+ (1 ГБ, DSI):
  https://www.raspberrypi.com/products/raspberry-pi-3-model-b-plus/
- Официальный дисплей Pi на платах Radxa ROCK (оверлеи, переходной шлейф):
  https://www.rs-online.com/designspark/how-to-add-a-raspberry-pi-7-inch-display-to-radxa-rock-single-board-computers
- MIPI DSI в ESP32-P4 (линии, скорость, форматы, video mode):
  https://docs.espressif.com/projects/esp-idf/en/latest/esp32p4/api-reference/peripherals/lcd/dsi_lcd.html
- Подключение DSI-дисплея к CM4 IO Board (22→15 контактов, оверлей
  vc4-kms-dsi-ili9881-7inch): https://www.raspberrypi.com/documentation/accessories/touch-display-2.html

Ссылки проверены 2026-08-17 и 2026-08-18.
