Spok1978/hybrid-radio/docs/11-shopping-list.md

# 11. Список покупок

> **НЕАКТУАЛЬНО — ревизия на Raspberry Pi.** С 2026-08-26 приёмник строится
> только на плате Waveshare ESP32-P4-WIFI6-Touch-LCD-5 ([24](24-main-build-p4.md)),
> Raspberry Pi в проекте не используется. Документ сохранён как история
> решений; для сборки, схемы и прошивки не применять. Актуальное: доп. платы —
> [33](33-carrier-board.md), перечень деталей — [35](35-carrier-boards-parts.md),
> выводы P4 — [33](33-carrier-board.md) §2, прошивка — [26](26-firmware-spec.md).

Составлен 2026-08-18 под принятую конфигурацию: Raspberry Pi 3 Model B+,
экран 1024×600 по DSI, тюнер RDA5807M, ЦАП PCM5102A, усилитель TPA3118D2,
питание 12 В от внешнего блока.

Каждая позиция — отдельная строка с количеством и названием, по которому
она ищется у поставщика. Цены не проставлены: зависят от поставщика и региона.

**Всего к заказу: 51 позиция** (A — 4, B — 3, C — 4, D — 11, E — 9, F — 2,
G — 6, H — 12).

Правки от 2026-08-21 по итогам внешнего аудита: заменены экран (A3),
преобразователь (D6) и TVS (D9), увеличены разделительные конденсаторы (E3),
добавлен резистор E9 под усиление 20 дБ. Разбор — [12](12-audit-response.md).

---

## A. Вычислитель и экран

| № | Наименование | Кол-во |
|---|---|---|
| A1 | Raspberry Pi 3 Model B+ | 1 шт |
| A2 | Карта памяти microSD 32 ГБ, Class 10, A1 (SanDisk Ultra) | 1 шт |
| A3 | Сенсорный экран с интерфейсом DSI, 1024×600 — **варианты см. ниже** | 1 шт |
| A4 | Радиатор алюминиевый самоклеящийся 14×14×8 мм | 2 шт |

### A3 — какой экран заказывать

**Вариант A3-a — оригинальный Raspberry Pi Touch Display 2, 5″**

- артикул производителя **SC1975**, UPC 5056561803944; 7-дюймовая версия — SC1635;
- 720×1280, IPS, ёмкостный тач на 5 касаний;
- **на AliExpress его нет.** Это официальный продукт Raspberry Pi, продаётся
  через авторизованных продавцов: raspberrypi.com, PiShop, Adafruit
  (артикул 6408), The Pi Hut, Vilros, Micro Center, Kubii;
- плюс: гарантированно поддержан в Raspberry Pi OS, обновления его не ломают;
- минус: панель портретная, для ландшафта нужен программный поворот.

**Вариант A3-b — Waveshare 7inch DSI LCD (C)** ← рекомендую для AliExpress

- **1024×600, ландшафтная** — поворачивать ничего не надо;
- IPS, ёмкостный тач, подключение шлейфом FFC к **15-контактному DSI**;
- **главное: поддержана мейнлайн-оверлеем Raspberry Pi OS.** В официальном
  списке оверлеев (проверено 2026-08-21 по веткам ядра rpi-6.6.y, 6.12.y и
  6.17.y) у `vc4-kms-dsi-waveshare-panel` есть параметр
  **`7_0_inchC   7.0" C 1024x600`** — это ровно она. Драйвер от производителя
  ставить не нужно, и обновление системы его не сломает;
- запрос: `Waveshare 7inch DSI LCD C 1024x600`.

**Вариант A3-c — Waveshare 5inch DSI LCD (C), 1024×600** — тот, что стоял
здесь раньше. **Отозван из рекомендации 2026-08-21.** Причина: параметра
`5_0_inchC` в мейнлайн-оверлее **нет ни в одной ветке ядра** — все 5-дюймовые
записи там 720×1280 (`5_0_inch`, `5_0_inch_a`). Значит эта панель заводится
только оверлеем производителя, со всеми рисками при обновлении ОС.
Брать, только если 7″ не влезает в задуманный корпус, и осознанно.

Полный перечень панелей, которые поддержаны без вендорских драйверов
(параметры `vc4-kms-dsi-waveshare-panel`): 2,8″ 480×640; 3,4″ 800×800;
4,0″ 480×800; 4,0″C 720×720; **5,0″ 720×1280**; 6,25″ 720×1560;
**7,0″C 1024×600**; 7,0″H 1280×720; 7,9″ 400×1280; 8,0″ 1280×800;
10,1″ 1280×800; 13,3″ 1920×1080.

### Что проверить в карточке товара перед заказом

1. **Интерфейс именно DSI**, шлейф FFC. Не HDMI и не DPI.
2. **НЕ брать «5inch DPI LCD» / «5inch LCD for Pi»** — эта версия подключается
   к колодке GPIO и занимает почти все выводы. У нас на GPIO висят I²C тюнера,
   кнопки, энкодеры и приглушение усилителя — конфликт гарантирован.
3. В списке поддерживаемых плат должен быть **3B+**.
4. **Шлейф в комплекте — 15-контактный на 15-контактный.** Вариант 22→15
   предназначен для Pi 5 и нам не подойдёт.
5. Чем питается: часть панелей берёт питание по тому же шлейфу, часть — с
   контактов GPIO отдельным проводом. Уточнить в описании.
6. Магазин с большим числом заказов и отзывами: DSI-панели у разных продавцов
   отличаются, а ошибка тут стоит дороже экономии.

**Про риск «оверлей отвалится» — уточнено 2026-08-21.** Он касается не всех
сторонних панелей, а только тех, которых нет в мейнлайн-списке выше.
У варианта A3-b (7″C) риска нет: панель в списке. У A3-c (5″C) риск остаётся.

**Питание панели.** По оценкам, 5″ 800×480 берёт ~250 мА, 7″C — ~500 мА.
Уточнить в карточке, откуда панель питается: по шлейфу DSI (тогда ток ложится
на шину 3,3 В самой Pi — для 3B+ это надо померить) или отдельным проводом
5 В с колодки GPIO. Второе предпочтительнее.

## B. Радиоприёмный тракт

| № | Наименование | Кол-во |
|---|---|---|
| B1 | Модуль FM-тюнера RDA5807M, плата RRD-102V2.0, интерфейс I²C | 1 шт |
| B2 | Антенна телескопическая FM, длина в разложенном виде 1 м, с креплением на корпус | 1 шт |
| B3 | Кабель коаксиальный RG-174, 50 Ом | 1 м |

## C. Звуковой тракт

| № | Наименование | Кол-во |
|---|---|---|
| C1 | Модуль ЦАП PCM5102A (плата GY-PCM5102A), вход I²S, линейный выход | 1 шт |
| C2 | Модуль усилителя TPA3118D2, 2×30 Вт, питание 8–24 В | 1 шт |
| C3 | Динамик широкополосный 100 мм (4″), 4 Ом, 15 Вт | 1 шт |
| C4 | Подстроечный резистор многооборотный 3296W, 10 кОм | 1 шт |

Задействуем **один канал** усилителя C2. Усиление на плате выставить **26 дБ**
(R1 = 20 кОм на землю, R2 = 100 кОм на GVDD) — заводской делитель заменить.

## D. Питание

| № | Наименование | Кол-во |
|---|---|---|
| D1 | Блок питания импульсный стабилизированный 12 В, **5 А** (было 3 А; стерео, [33](33-carrier-board.md) §10), штекер 5,5×2,1 мм, «плюс» в центре | 1 шт |
| D2 | Гнездо питания 5,5×2,1 мм, панельное, с гайкой | 1 шт |
| D3 | Выключатель клавишный KCD1-101, 250 В, 6 А | 1 шт |
| D4 | Держатель предохранителя 5×20 мм, панельный | 1 шт |
| D5 | Предохранитель 5×20 мм, 3 А, быстродействующий | 2 шт |
| D6 | Модуль DC-DC понижающий **синхронный** (без внешнего диода Шоттки), 12 В → 5 В, ток ≥3 А, с регулировкой выходного напряжения — например на SY8205 или MP2307 | 1 шт |
| D7 | Транзистор IRF4905, P-канальный MOSFET, корпус TO-220 | 1 шт |
| D8 | Стабилитрон 1N4744A, 15 В, 1 Вт | 1 шт |
| D9 | TVS-диод **P6KE16A**, 600 Вт, однонаправленный, корпус DO-15 (либо SMBJ14A в корпусе SMB) | 1 шт |
| D10 | Стабилизатор напряжения HT7333-A, 3,3 В, 250 мА, корпус TO-92 | 1 шт |
| D11 | Дроссель силовой 10 мкГн, 3 А, экранированный | 1 шт |

**D6 обязательно выставить на 5,10 В до подключения Raspberry Pi.**

## E. Резисторы и конденсаторы

| № | Наименование | Кол-во | Куда идёт |
|---|---|---|---|
| E1 | Резистор 10 кОм, 0,25 Вт, 1 % | 4 шт | суммирующий узел звука |
| E2 | Резистор 100 кОм, 0,25 Вт, 5 % | 3 шт | разряд сумматора, затвор IRF4905, подтяжка SD усилителя |
| E3 | Конденсатор плёночный 2,2 мкФ, 63 В (K73-17 или MKP) | 2 шт | ~~вход усилителя~~ — **заменён на 3,3 мкФ**, см. дозаказ ниже |
| E9 | Резистор 5,6 кОм, 0,25 Вт | 1 шт | ~~делитель GAIN на 20 дБ~~ — не используется после пересчёта уровней, см. дозаказ ниже |
| E4 | Конденсатор электролитический 1000 мкФ, 25 В, low ESR | 1 шт | питание усилителя |
| E5 | Конденсатор электролитический 470 мкФ, 25 В | 1 шт | вход преобразователя D6 |
| E6 | Конденсатор электролитический 470 мкФ, 16 В | 1 шт | выход преобразователя D6 |
| E7 | Конденсатор электролитический 10 мкФ, 50 В | 2 шт | вход и выход стабилизатора D10 |
| E8 | Конденсатор керамический 0,1 мкФ, 50 В, шаг 5 мм | 6 шт | развязка по питанию всех узлов |

## F. Помехоподавление

| № | Наименование | Кол-во |
|---|---|---|
| F1 | Ферритовая защёлка на кабель, внутренний диаметр 5 мм | 2 шт |
| F2 | Ферритовая бусина (трубка) 3,5×6 мм | 2 шт |

## G. Органы управления

| № | Наименование | Кол-во |
|---|---|---|
| G1 | Энкодер EC11, 20 импульсов на оборот, со встроенной кнопкой, вал 20 мм | 2 шт |
| G2 | Ручка на вал 6 мм с лыской, алюминиевая | 2 шт |
| G3 | Кнопка тактовая 12×12×7,3 мм, 4 вывода | 5 шт |
| G4 | Колпачок круглый для тактовой кнопки 12×12 мм | 5 шт |
| G5 | Кнопка без фиксации, антивандальная, диаметр 16 мм | 1 шт |
| G6 | Кнопка тактовая 12×12×7,3 мм, 4 вывода, колпачок другого цвета | 1 шт |

G1 — перестройка частоты и громкость. G3 — кнопки ◄, ►, SEEK, MEM, MENU.
G5 — кнопка питания. G6 — кнопка MODE «эфир ↔ интернет»; тумблер MTS-202
отменён 2026-08-25, см. [22](22-mode-switching.md).

## H. Монтаж и провода

| № | Наименование | Кол-во |
|---|---|---|
| H1 | Провод монтажный многожильный 0,5 мм² (20 AWG), красный | 2 м |
| H2 | Провод монтажный многожильный 0,5 мм² (20 AWG), чёрный | 2 м |
| H3 | Провод монтажный МГТФ 0,12 мм² | 5 м |
| H4 | Провод соединительный DuPont «мама-мама», 20 см | 40 шт |
| H5 | Плата макетная монтажная двусторонняя 50×70 мм | 2 шт |
| H6 | Клеммник винтовой KF301-2P, 2 контакта, шаг 5 мм | 2 шт |
| H7 | Стойка латунная M2,5×10 мм, «мама-папа» | 4 шт |
| H8 | Винт M2,5×6 мм | 4 шт |
| H9 | Гайка M2,5 | 4 шт |
| H10 | Трубка термоусадочная 2 мм | 1 м |
| H11 | Трубка термоусадочная 4 мм | 1 м |
| H12 | Припой ПОС-61 с канифолью, диаметр 1 мм, 100 г | 1 шт |

H4 — **только для сигнальных цепей на макете**. В цепях питания
DuPont-перемычки не применять, см. [09](09-power-supply.md), п. 9.

---

## Что НЕ заказываем сейчас и почему

| Что | Почему отложено |
|---|---|
| Корпус, стойки и крепёж экрана, решётка динамика | зависит от Q8 (корпус не выбран) |
| Антенное гнездо на корпус (BNC / F / SMA) | зависит от корпуса и способа крепления антенны B2 |
| Детали фиксирующего ключа для мягкого выключения (второй P-MOSFET, транзисторы, резисторы) | схема защёлки будет выбрана при разводке; на макете прибор работает и без неё, см. [10](10-shutdown-and-data-safety.md), п. 4 |
| Второй усилитель и второй динамик | только если позже решим делать стерео |
| Модуль Si4735/Si4732 | резервная замена тюнеру B1, берётся только если не хватит чувствительности |
| Свисток RTL-SDR | второй этап, если захочется спектр и все диапазоны |
| Промышленная microSD с защитой от потери питания | при read-only корне необязательна, см. [10](10-shutdown-and-data-safety.md), п. 6 |

## Дозаказ по итогам расчёта схемы (2026-08-21)

Расчёт уровней при составлении схемы соединений ([15](15-wiring-breadboard.md), п. 7)
показал, что номиналы сумматора и делителя усиления нужно поменять.

| Наименование | Кол-во | Зачем |
|---|---|---|
| Резистор 1 кОм, 0,25 Вт | **3 шт** | две в эфирную ветвь сумматора, одна последовательно в линию SD усилителя |
| Резистор 20 кОм, 0,25 Вт | 1 шт | делитель GAIN усилителя на 26 дБ |
| Резистор 100 кОм, 0,25 Вт | 1 шт | второй резистор того же делителя |
| Конденсатор плёночный **3,3 мкФ**, 63 В | 2 шт | вход усилителя под 26 дБ; заказанные 2,2 мкФ рассчитаны на 20 дБ |
| **Кабель micro-USB короткий (≤0,5 м), с толстыми силовыми жилами** | 1 шт | питание Pi — этой позиции в основном списке не было |
| Набор резисторов россыпью 0,25 Вт | 1 шт | номиналы сумматора придётся подбирать по факту |

## Журнал изменений списка

Что изменилось с первой редакции (коммит `dc1c154`) по текущую. Сверено
командой `git diff dc1c154 HEAD -- docs/11-shopping-list.md`, не по памяти.
Остальные 46 позиций не менялись.

| Поз. | Было в первой редакции | Стало сейчас | Почему |
|---|---|---|---|
| **A3** | Raspberry Pi Touch Display 2, 5″, 720×1280 | **Waveshare 7inch DSI LCD (C), 1024×600** | оригинала нет на AliExpress; из панелей 1024×600 только 7″ (C) есть в штатном оверлее (`7_0_inchC`), у 5″ (C) параметра не существует |
| **D6** | Модуль на XL4015, 5 А | **Синхронный** модуль 12→5 В, ≥3 А (SY8205 / MP2307) | XL4015 несинхронный и противоречил требованию документа 09; внешний диод шумит в полосе приёма |
| **D9** | TVS-диод P6KE15A | **TVS-диод P6KE16A** (или SMBJ14A) | у P6KE15A рабочее напряжение 12,8 В — впритык к шине 12 В с допуском ±5 % |
| **E3** | Конденсатор плёночный 1 мкФ ×2 | Конденсатор плёночный **2,2 мкФ** ×2 | даташит TI при усилении 20 дБ рекомендует 1,5 мкФ |
| **E9** | — | **Резистор 5,6 кОм, 0,25 Вт ×1** | новая позиция: делитель GAIN/SLV усилителя под 20 дБ |

Позиций стало 51 вместо 50.

## Что, возможно, уже есть дома

Проверить перед заказом, чтобы не купить второй раз: USB-клавиатура (нужна
один раз при первичной настройке), кабель HDMI, картридер для microSD,
мультиметр, паяльник.
