Spok1978/hybrid-radio/docs/35-carrier-boards-parts.md

# Дополнительные платы IP-Radio: состав и перечень деталей

Срез на 2026-10-09. Источник — нетлист схемы `hardware/kicad/Hybryd Radio.net`,
который генерирует `hardware/skidl/carrier.py`; разбиение по платам —
`hardware/skidl/boards.py`. Подробности решений — [33-carrier-board.md](33-carrier-board.md).

Дополнительное «железо» к плате Waveshare ESP32-P4-WIFI6-Touch-LCD-5 — три
самодельные платы, соединённые проводами. Всего 91 деталь.

| Плата | Размер | Слои | Деталей | Состояние |
|---|---|---|---|---|
| Питания | 125 × 70 мм | 1 (медь снизу) | 24 | разведена, DRC пройден, 1 проволочная перемычка |
| Сигнальная | 230 × 70 мм | 2 | 58 | разведена, DRC 0 нарушений |
| Площадка усилителей | 150 × 70 мм | 1 | 9 | расставлена, не разведена |

## Как это работает

- **Плата питания** принимает 12 В от блока питания и защищает вход. Она отдаёт
  12 В на усилители и 5 В на P4 (через USB) и на сигнальную плату.
- **Сигнальная плата** соединяется с P4 плоским шлейфом. На ней FM-тюнер, ЦАП
  для интернет-радио, микшер, который сводит оба звука, расширитель входов для
  кнопок пресетов и подключение энкодеров и кнопок.
- **Площадка усилителей** — два моно-усилителя (левый и правый канал) и клеммы
  динамиков.

```
 БП 12 В ──► ПЛАТА ПИТАНИЯ ──12 В──► ПЛОЩАДКА УСИЛИТЕЛЕЙ ──► динамики L, R
                 │  │                        ▲
                 │  └─5 В (USB-A→USB-C)──► P4│
                 └─5 В, PWR_SENSE──► СИГНАЛЬНАЯ ПЛАТА ◄──шлейф 2×20──► P4
                                     (тюнер, ЦАП, микшер, кнопки) ──L/R, SD──┘
```

## 1. Плата питания — 24 детали

| Обозн. | Номинал / тип | Корпус | Назначение |
|---|---|---|---|
| J1 | гнездо питания 5,5×2,1 | под пайку на плату | вход 12 В |
| F1 | предохранитель T5A | держатель 5×20 | защита входа |
| Q1 | IRF4905 | TO-220 | защита от переполюсовки |
| D1 | 1N4744A, стабилитрон 15 В | DO-41 | защита затвора Q1 |
| R1 | 100 кОм | выводной 0,25 Вт | затвор Q1 |
| D2 | P6KE16A, TVS | DO-15 | подавление выбросов |
| C1 | 470 мкФ 25 В | электролит Ø10 | объёмный конденсатор на 12 В |
| C2 | 100 нФ | керамика, шаг 5 мм | вход DC-DC |
| U1 | модуль WeAct SY8205 | на стойках, провода | DC-DC 12 → 5 В |
| C4 | 470 мкФ 16 В | электролит Ø8 | объёмный конденсатор на 5 В |
| C5 | 100 нФ | керамика, шаг 5 мм | выход DC-DC |
| J2 | USB-A Molex 67643 | горизонтальный | 5 В на P4 (кабель USB-A → USB-C) |
| J13 | клеммник на 2 контакта | шаг 5,08 мм | 12 В на усилители |
| J14 | клеммник на 3 контакта | шаг 5,08 мм | 5 В, GND, PWR_SENSE на сигнальную плату |
| R2 | 39 кОм | выводной | делитель PWR_SENSE (контроль 12 В для P4) |
| R3 | 12 кОм | выводной | делитель PWR_SENSE |
| C3 | 100 нФ | керамика | фильтр PWR_SENSE |
| D3 | светодиод зелёный | 3 мм | индикатор 12 В |
| R20 | 2,2 кОм | выводной | ток D3 |
| D4 | светодиод зелёный | 3 мм | индикатор 5 В |
| R21 | 1 кОм | выводной | ток D4 |
| TP1–TP3 | контрольные точки | площадка Ø2 мм | +12V, +5V, GND |

## 2. Сигнальная плата — 58 деталей

### Модули

| Обозн. | Модуль | Монтаж | Назначение |
|---|---|---|---|
| U3 | RRD-102 V2.0 (RDA5807M) | на SMD-площадки, микросхемой вверх | FM-тюнер, I²C |
| U4 | GY-PCM5102A | на гнёздах 2,54 | ЦАП I²S, звук интернет-радио |
| U5 | MCP23017, плата CJMCU | на гнёздах 2,54 | 8 кнопок пресетов и MODE по I²C |

### Питание тюнера (отдельные 3,3 В)

| Обозн. | Номинал | Назначение |
|---|---|---|
| L1 | дроссель 10 мкГн 3 А, радиальный Ø10 | фильтр 5 В |
| FB1 | ферритовая бусина, выводная | фильтр до стабилизатора |
| U2 | HT7333-A, TO-92 | стабилизатор 3,3 В |
| C6 | 10 мкФ, электролит Ø5 | вход стабилизатора |
| C7 | 100 нФ | вход стабилизатора |
| C8 | 10 мкФ, электролит Ø5 | выход стабилизатора |
| C9 | 100 нФ | выход стабилизатора |
| FB2 | ферритовая бусина, выводная | фильтр после стабилизатора |
| C27 | 100 нФ | у вывода питания тюнера |

### Тюнер

| Обозн. | Номинал | Назначение |
|---|---|---|
| C10, C11 | 4,7 мкФ 25 В, электролит Ø5 | разделительные на выходах L/R (на них постоянка ~1,05 В) |
| C12 | 100 пФ C0G | вход антенны |
| J4 | клеммник на 2 контакта | антенна |

### ЦАП

| Обозн. | Номинал | Назначение |
|---|---|---|
| R4, R5, R6 | 47 Ом | последовательные в линиях I²S: BCK, LRCK, DIN |
| C13 | 100 нФ | питание 5 В модуля |

### Микшер (левый / правый канал)

| Обозн. L / R | Номинал | Назначение |
|---|---|---|
| R7 / R10 | 1 кОм | вход от тюнера |
| R8 / R11 | 10 кОм | вход от ЦАП |
| R9 / R12 | 100 кОм | на землю |
| RV1 / RV2 | 10 кОм, многооборотный 3296W | уровень канала |
| C14 / C18 | 3,3 мкФ, плёнка 63 В | на вход «+» усилителя |
| C15 / C19 | 3,3 мкФ, плёнка 63 В | на вход «−» усилителя |

### Выключение усилителей (AMP_SD)

| Обозн. | Номинал | Назначение |
|---|---|---|
| R13 | 1 кОм | от GPIO49 |
| R14 | 100 кОм на GND | ставить, если на HW-327 выведен SDZ |
| R15 | 100 кОм на 3,3 В | ставить, если на HW-327 выведен MUTE |

Ставится **один** из R14 / R15. Какой — зависит от того, какой вывод выведен
на модуле HW-327; это ещё не выяснено.

### Органы управления (провода паяются к площадкам)

| Обозн. | Что подключается |
|---|---|
| J9 | энкодер 1, EC11: A, B, кнопка, GND |
| J10 | энкодер 2, EC11: A, B, кнопка, GND |
| R16–R19 | подтяжки 10 кОм к линиям A/B энкодеров |
| C23–C26 | 10 нФ, фильтры на линиях A/B энкодеров |
| J11 | кнопка питания |
| J7 | пресеты 1–4 + GND |
| J12 | пресеты 5–8, MODE + GND |
| J8 | JST-XH на 6 контактов, резерв: 4 свободных GPIO P4, 3,3 В и GND |

### Связи

| Обозн. | Тип | Назначение |
|---|---|---|
| J3 | вилка IDC 2×20 | шлейф к P4 |
| J15 | клеммник на 3 контакта | 5 В, GND, PWR_SENSE с платы питания |
| J16 | 6 площадок под провода | к усилителям: L+, L−, R+, R−, SD, GND |

### Контрольные точки

TP4 +3V3_FM, TP5 PWR_SENSE, TP6 SUM_L, TP7 SUM_R, TP8 GND.

## 3. Площадка усилителей — 9 деталей

| Обозн. | Номинал / тип | Назначение |
|---|---|---|
| A1 | модуль HW-327 (TPA3118, моно), на стойках, провода | левый канал |
| A2 | модуль HW-327 (TPA3118, моно), на стойках, провода | правый канал |
| C16, C20 | 1000 мкФ 25 В, электролит Ø12,5 | питание 12 В у каждого усилителя |
| C17, C21 | 100 нФ | питание 12 В у каждого усилителя |
| J5 | клеммник на 2 контакта | динамик L |
| J6 | клеммник на 2 контакта | динамик R |
| J17 | клеммник на 2 контакта | 12 В с платы питания |

## 4. Вне плат (подключается проводами или кабелями)

- **Блок питания** 12 В / 5 А.
- **Шлейф IDC** на 40 контактов к P4.
- **Кабель USB-A → USB-C** для питания P4.
- **Динамики:** 2 × LY2102-3 (сменные JBL Charge 3), 4 Ом, 10 Вт.
- **Органы управления:** 2 энкодера EC11, кнопка питания, 8 кнопок пресетов,
  кнопка MODE.
- **Антенна FM.**

## 5. Сводка по номиналам

Резисторы — выводные 0,25 Вт, шаг 10,16 мм; керамика — диски, шаг 5 мм.

| Номинал | Кол-во | Обозначения |
|---|---|---|
| 47 Ом | 3 | R4, R5, R6 |
| 1 кОм | 4 | R7, R10, R13, R21 |
| 2,2 кОм | 1 | R20 |
| 10 кОм | 6 | R8, R11, R16–R19 |
| 12 кОм | 1 | R3 |
| 39 кОм | 1 | R2 |
| 100 кОм | 5 | R1, R9, R12, R14, R15 (из R14/R15 ставится один) |
| подстроечный 10 кОм 3296W | 2 | RV1, RV2 |
| 100 пФ C0G | 1 | C12 |
| 10 нФ | 4 | C23–C26 |
| 100 нФ | 10 | C2, C3, C5, C7, C9, C13, C17, C21, C22, C27 |
| 3,3 мкФ плёнка 63 В | 4 | C14, C15, C18, C19 |
| 4,7 мкФ 25 В | 2 | C10, C11 |
| 10 мкФ | 2 | C6, C8 |
| 470 мкФ 16 В | 1 | C4 |
| 470 мкФ 25 В | 1 | C1 |
| 1000 мкФ 25 В | 2 | C16, C20 |
| дроссель 10 мкГн 3 А | 1 | L1 |
| ферритовая бусина | 2 | FB1, FB2 |
| светодиод зелёный 3 мм | 2 | D3, D4 |
| 1N4744A | 1 | D1 |
| P6KE16A | 1 | D2 |
| IRF4905 | 1 | Q1 |
| HT7333-A | 1 | U2 |
| предохранитель T5A + держатель 5×20 | 1 | F1 |
| клеммник на 2 контакта, 5,08 | 5 | J4, J5, J6, J13, J17 |
| клеммник на 3 контакта, 5,08 | 2 | J14, J15 |
| гнездо питания 5,5×2,1 | 1 | J1 |
| USB-A Molex 67643 | 1 | J2 |
| вилка IDC 2×20 | 1 | J3 |
| JST-XH B6B-XH-A | 1 | J8 |
| модули | 6 | U1 SY8205, U3 RRD-102, U4 GY-PCM5102A, U5 MCP23017, A1/A2 HW-327 |
