Spok1978/hybrid-radio/firmware/components/esp_hosted/PATCHES.md

# Своя копия esp_hosted 1.4.7

Это компонент `espressif/esp_hosted` **1.4.7** из реестра Espressif
(репозиторий esp-hosted-mcu, коммит `d24d1dc3`, см. `idf_component.yml`),
взятый в проект с одной правкой. Подключается из
`firmware/main/idf_component.yml` через `override_path` и подменяет
компонент реестра для всех, кто от него зависит, включая
`esp_wifi_remote`.

Скопированы только части, которые идут в сборку: `host/`, `common/`
и файлы корня. `slave/`, `examples/` и `docs/` оригинала не нужны:
прошивку сопроцессора C6 мы не собираем.

## Правка: буфер приёма SDIO в PSRAM

Файл `host/drivers/transport/sdio/sdio_drv.c`, функция
`sdio_rx_get_buffer()` потокового режима. Все изменения помечены
`[ip-radio]`.

**Было.** Двойной буфер приёма выделялся через `MEM_ALLOC()`, то есть
одним непрерывным куском внутренней DMA-памяти
(`host/port/include/os_wrapper.h:105`). Буфер растёт во время работы:
старый освобождается, выделяется больший. Неудача выделения кончается
`assert(*buf)` и перезагрузкой.

**Что ломалось.** 2026-10-05, журналы `switch2.log` и `after.log`: после
нескольких переключений интернет-станций свободной внутренней памяти
оставалось 12–24 КБ, наибольший кусок 5–8 КБ. Следующий рост буфера
не находил места, и прибор перезагружался:
`assert failed: sdio_rx_get_buffer sdio_drv.c:670 (*buf)`.

**Стало.** Буфер выделяется в PSRAM функцией ESP-IDF
`esp_dma_capable_malloc()` с выравниванием по строке кэша PSRAM.
Если PSRAM вдруг не хватит, остаётся прежний путь через `MEM_ALLOC()`.
Рост буфера теперь пишется в журнал на уровне INFO, с размером и местом.

**Почему так можно.**

* Контроллер SDMMC у ESP32-P4 умеет DMA в PSRAM:
  `SOC_SDMMC_PSRAM_DMA_CAPABLE 1` в
  `components/soc/esp32p4/include/soc/soc_caps.h`.
* Драйвер ESP-IDF 5.5.3 сам проверяет выравнивание буфера во внешней
  памяти (`sdmmc_host_check_buffer_alignment()`, `sdmmc_host.c`) и сам
  синхронизирует кэш до и после передачи (`sdmmc_transaction.c`).
* Порт esp_hosted отдаёт этот буфер в `sdmmc_io_read_blocks()` напрямую,
  без промежуточной копии (`host/port/src/sdio_wrapper.c`).
* Правка только хостовая, прошивку C6 она не затрагивает.

## Чего здесь сознательно НЕ сделано

**Режим приёма MAX_SIZE** вместо потокового. Его советовал внешний
разбор, но хостовый MAX_SIZE рассчитан на то, что сопроцессор отдаёт
пакеты по одному и добивает остаток нулями (комментарий в ветке
`H_SDIO_ALWAYS_HOST_RX_MAX_TRANSPORT_SIZE` в `sdio_drv.c`). Потоковый
режим самого C6 задаётся при сборке его прошивки
(`slave/main/sdio_slave_api.c`, `sending_mode = SDIO_SLAVE_SEND_STREAM`,
по умолчанию включён). То, что буфер у нас рос и падал на строке 670,
означает, что за одно чтение приходило больше одного пакета, а значит,
C6 работает в потоковом режиме. MAX_SIZE с ним терял бы данные.
Подробности в `docs/34-memory.md`.

## Как обновлять

Взять новую версию из реестра, заново внести правку по пометкам
`[ip-radio]` и сверить, не изменились ли `sdio_rx_get_buffer()`
и `MEM_ALLOC()`. Версию в `firmware/main/idf_component.yml` менять
только вместе с копией.
