Spok1978/hybrid-radio/docs/15-wiring-breadboard.md

# 15. Схема соединений для сборки на макете

> **НЕАКТУАЛЬНО — ревизия на Raspberry Pi.** С 2026-08-26 приёмник строится
> только на плате Waveshare ESP32-P4-WIFI6-Touch-LCD-5 ([24](24-main-build-p4.md)),
> Raspberry Pi в проекте не используется. Документ сохранён как история
> решений; для сборки, схемы и прошивки не применять. Актуальное: доп. платы —
> [33](33-carrier-board.md), перечень деталей — [35](35-carrier-boards-parts.md),
> выводы P4 — [33](33-carrier-board.md) §2, прошивка — [26](26-firmware-spec.md).

Составлено 2026-08-21 под заказанный комплект ([11](11-shopping-list.md))
и карту выводов ([13](13-gpio-map.md)). Цель — собрать работающий макет,
а не финальный монтаж.

## 0. Главное правило макетирования

**Силовые цепи на макетную плату не заводятся.** Ни 12 В к усилителю, ни
5 В к Pi. Беспаечная макетка и перемычки DuPont рассчитаны на десятки
миллиампер и имеют переходное сопротивление контактов в десятки миллиом —
при 2 А это просадка и нагрев.

| Что | Где собираем |
|---|---|
| Ввод 12 В, защита, преобразователь, питание усилителя | **пайка** на клеммниках H6 и монтажной плате H5, провод 20 AWG (H1/H2) |
| 5 В к Pi | **пайка**, отрезок кабеля с разъёмом micro-USB (дозаказ, п. 12) |
| Шина 3,3 В к тюнеру | пайка либо короткие перемычки — ток 25 мА, некритично |
| I²C, I²S, кнопки, энкодеры, сумматор звука | **беспаечная макетка**, перемычки DuPont — можно |

## 1. Блок-схема

```
      антенна B2
         │ RG-174 (B3)
   ┌─────┴──────┐
   │ RDA5807M   │ 3,3 В ◄── HT7333 (D10) ◄── шина 5 В
   │    B1      │ I²C   ◄──────────────────────────┐
   └──┬──────┬──┘ L/R аналог ──┐                   │
      │      │                 │                   │
      │      │            ┌────▼─────────┐    ┌────┴──────────────┐
      │      │            │  сумматор    │    │  Raspberry Pi 3B+ │
      │      │            │  (макетка)   │    │        A1         │
      │      └────────────┤              │    │                   │
      │                   │   + подстро- │    │  GPIO ◄── кнопки, │
      │              ┌────► ечник C4     │    │      энкодеры     │
      │              │    └────┬─────────┘    │                   │
      │         L/R  │         │              │                   │
      │      ┌───────┴───┐     │              │  DSI ──► экран A3 │
      │      │ PCM5102A  │◄────┼─── I²S ──────┤                   │
      │      │    C1     │     │              │  micro-USB ◄─ 5 В │
      │      └───────────┘     │              └───────────────────┘
      │                   ┌────▼─────────┐
      │                   │ TPA3118D2 C2 │◄── 12 В (напрямую)
      │                   │  один канал  │◄── SD (GPIO11)
      │                   └────┬─────────┘
      │                        │
      │                   динамик C3
      │
     GND ── общая точка у гнезда питания D2
```

## 2. Ввод питания и защита

Собирается **пайкой**, до подключения чего-либо ещё.

```
  D1 (блок 12 В / 3 А)
       │ штекер 5,5×2,1
  ┌────▼────┐
  │ гнездо  │ D2
  │  «+» ───┼──► D3 (выключатель KCD1-101) ──► D4/D5 (предохранитель 3 А)
  │ «−» ────┼──────────────────────────────────────────┐
  └─────────┘                                          │
                                                       │
     ─── D7 IRF4905 ────────────────────────────────┐  │
         сток (вывод 2 и фланец) ◄── от предохранителя│ │
         исток (вывод 3) ────────────► шина 12 В      │ │
         затвор (вывод 1) ──[E2 100 кОм]──► GND       │ │
         затвор ──[D8 1N4744A, анод к затвору,        │ │
                   катод к истоку]──► исток           │ │
                                                      │ │
     шина 12 В ──┬── D9 P6KE16A (полоска к +12 В) ── GND     │ │
                 │                                    │ │
                 ├── E5 470 мкФ/25 В + E8 0,1 мкФ ─── GND
                 │                                    │ │
                 ├──► вход D6 (преобразователь)       │ │
                 │                                    │ │
                 └──► питание C2 (усилитель)          │ │
                      + E4 1000 мкФ/25 В + E8 0,1 мкФ │ │
                                                      │ │
     GND-звезда ◄─────────────────────────────────────┴─┘
```

Электролиты E4 и E5 — **минусом на землю**. TVS D9 однонаправленный: полоской
(катодом) к +12 В; поставленный наоборот он откроется как обычный диод и
сожжёт предохранитель при первом же скачке.

**Проверка защиты от переполюсовки — до подключения нагрузки.**
Подать 12 В правильной полярностью: на шине есть напряжение. Подать наоборот:
на шине **ноль**. Схема при этом уже зафиксирована по даташиту (сток — к входу,
исток — к шине, см. [09](09-power-supply.md), п. 4), и проверка нужна как
контроль монтажа, а не как способ подобрать включение методом перестановки.

## 3. Шина 5 В

```
  D6 (модуль DC-DC) ── выход + ──┬── шина 5 В
                                 │
       E6 470 мкФ/16 В («−» на GND) + E8 0,1 мкФ ─┴── GND
```

**Дроссель D11 в общую шину не ставим** (исправлено 2026-08-21): последовательная
индуктивность с большой ёмкостью после неё звенит на импульсной нагрузке Pi
и съедает и без того малый запас по напряжению. Он переехал в ветвь LDO, п. 4.

Порядок: **сначала выставить выход D6 на 5,10 В на холостом ходу**, обесточить,
и только потом подключать что-либо. Дальше от шины 5 В:

- **к Pi** — отрезок кабеля с micro-USB (дозаказ, п. 12), припаянный к шине. Не через макетку;
- **к дисплею A3** — отдельным кабелем питания панели, около 0,5 А (п. 9);
- **к стабилизатору D10**.

## 4. Шина 3,3 В для тюнера

```
  шина 5 В ──[D11 дроссель 10 мкГн]──[F2 феррит]──► VIN (D10 HT7333-A)
                        E7 10 мкФ + E8 0,1 мкФ ─┴─ GND
                                                       │
              VCC тюнера ◄──[F2 феррит]──◄ VOUT ───────┘
                E7 10 мкФ + E8 0,1 мкФ ─┴─ GND
```

**Распиновку TO-92 у D10 сверить с даташитом конкретного экземпляра** — у
корпусов TO-92 её легко перепутать, а 5 В на выходе убьют тюнер. Перед
подключением тюнера измерить напряжение на выходе: должно быть 3,3 В ±0,1.

## 5. Тюнер RDA5807M (B1)

У клонов RRD-102V2.0 порядок выводов различается — **ориентироваться на
маркировку своей платы**, а не на картинку из интернета.

| Сигнал модуля | Куда |
|---|---|
| VCC | шина 3,3 В (п. 4) |
| GND | GND-звезда |
| SDIO / SDA | Pi, контакт 3 (GPIO2) |
| SCLK / SCL | Pi, контакт 5 (GPIO3) |
| ANT | центральная жила RG-174 → антенна B2 |
| LOUT | сумматор, вход «эфир L» (п. 7) |
| ROUT | сумматор, вход «эфир R» (п. 7) |

Оплётку RG-174 — на GND тюнера, оттуда одним проводом к звезде.
Подтягивающие резисторы на I²C ставить не нужно: на Pi они уже есть на плате.

**Первая проверка после подачи питания:** `i2cdetect -y 1` должен показать
адреса **0x10** и **0x11** (последовательный доступ и прямой доступ к регистрам).

## 6. ЦАП PCM5102A (C1)

| Сигнал модуля | Куда |
|---|---|
| VCC (5 В) | шина 5 В |
| GND | GND-звезда |
| BCK | Pi, контакт 12 (GPIO18) |
| LCK / LRCK | Pi, контакт 35 (GPIO19) |
| DIN | Pi, контакт 40 (GPIO21) |
| SCK | **на GND** — см. ниже |
| L OUT / R OUT | сумматор, входы «интернет L/R» |

**Типовая настройка платы GY-PCM5102A** (проверить по шелкографии своего
экземпляра, конфигурационные площадки обычно подписаны):

- **SCK → GND** — иначе модуль ждёт внешний тактовый сигнал, которого Pi
  не выдаёт, и звука не будет. Это самая частая причина «собрал, тишина»;
- FLT → GND, DEMP → GND, FMT → GND;
- **XSMT → VCC** (иначе выход заглушён).

**Разделительные конденсаторы на выходе ЦАП не нужны.** У PCM5102A выходы
типа DirectPath — сигнал 2,1 В действующего центрирован относительно земли,
постоянной составляющей нет. Лишний конденсатор здесь только завалит низы
и добавит щелчки при перезаряде. Постоянка есть только у тюнера, и её
блокирует общий E3 на входе усилителя.

Если на купленной плате GY-PCM5102A выходные конденсаторы всё же впаяны —
оставить как есть, они не мешают; но добавлять свои не нужно.

## 7. Сумматор звука и усилитель

### 7.1. Почему нельзя просто поставить четыре одинаковых резистора

Уровни двух источников сильно разные:

| Источник | Уровень | Источник данных |
|---|---|---|
| RDA5807M, громкость 1111 | **360 мВ** | даташит, стр. 6: «Audio L/R Output Voltage, Volume[3:0]=1111 — 360 — mV» |
| PCM5102A, полная шкала | **2,1 В** | даташит TI |

Разница около **15 дБ**. С одинаковыми резисторами эфир будет заметно тише
интернета, и выровнять это регулятором нельзя — он общий.

Выравниваем номиналами: эфирной ветви даём резисторы меньше. Заодно
даташит тюнера сам нормирует искажения при нагрузке 1 кОм — значит 1 кОм
для него штатная нагрузка.

### 7.2. Схема узла

```
   тюнер LOUT ──[1 кОм]──┐
   тюнер ROUT ──[1 кОм]──┤
                         ├──┬───► верхний вывод C4 (подстроечник 10 кОм)
   ЦАП L OUT ──[10 кОм]──┤  │              средний вывод (движок)
   ЦАП R OUT ──[10 кОм]──┘  │                    │
                            │            [E3 3,3 мкФ]
                        [E2 100 кОм]             │
                            │                    ▼
                           GND        нижний вывод C4 ── GND
                                                  вход IN усилителя C2
```

Расчёт (оценка, проверяется измерением): неактивный источник глушится
программно, его выход становится низкоомным и работает как шунт на землю.
При этих номиналах на верхнем выводе подстроечника получается около
**0,3 В** от эфира и около **0,2 В** от интернета — то есть источники
выровнены с точностью до пары децибел.

**Ёмкость E3 увеличена с 2,2 до 3,3 мкФ** (2026-08-21): при усилении 26 дБ
входное сопротивление усилителя не 60, а **30 кОм**, и таблица рекомендованных
ёмкостей в даташите TI для этого случая даёт 3,3 мкФ (срез 1,6 Гц).
Нет 3,3 — два по 2,2 параллельно.

**Обязательный замер на макете.** Подать на вход каждого источника по
очереди максимальный уровень и измерить переменное напряжение на движке C4:

- цель — **0,2…0,3 В действующего** от обоих источников;
- если расхождение больше 3–4 дБ, подправить номинал эфирной ветви
  в сторону 1,5–2,2 кОм;
- предположение «заглушённый источник ведёт себя как низкоомный шунт»
  расчётом не доказывается, только измерением. Собирать узел так, чтобы
  резисторы можно было быстро менять.

**Тонкость по тюнеру.** У RDA5807M есть бит **DHIZ** (регистр 02H, бит 15) —
перевод аудиовыхода в высокоомное состояние. Для нашего сумматора выход
неактивного тюнера должен оставаться **низкоомным**, поэтому DHIZ держим
включённым (выход активен), а тишину делаем регистром громкости и mute.
Если случайно уйти в high-Z, эфирная ветвь перестанет шунтировать узел
и уровень интернета скакнёт.

### 7.3. Усилитель TPA3118D2 (C2)

| Вывод модуля | Куда |
|---|---|
| VCC / 12 V | шина 12 В (через E4 и E8) |
| GND | GND-звезда |
| вход одного канала (L IN или R IN) | движок C4 через E3 |
| вход второго канала | **на GND через конденсатор**, канал не используем |
| выходы этого канала (+ и −) | динамик C3 через клеммник H6 |
| SD / SHDN / MUTE | Pi, контакт 23 (GPIO11) **через резистор 1 кОм**, и **E2 100 кОм на GND** |

**Усиление ставим 26 дБ.** По таблице 1 даташита TPA31xxD2 это
**R1 = 20 кОм на землю, R2 = 100 кОм на GVDD** на выводе GAIN/SLV.
При 26 дБ и уровне ~0,25 В на входе получаем около 5 В на выходе, то есть
6–7 Вт на 4 Ω — рабочая громкость с запасом до клиппинга.

Три обязательные проверки по этому узлу:

1. **Выведен ли SD на разъём.** На части дешёвых плат он не выведен — тогда
   либо припаяться к выводу микросхемы, либо смириться со щелчком при
   включении. Без резистора 100 кОм на землю усилитель на старте будет
   включён, пока Pi не поднимет линию.
2. **Какой делитель GAIN стоит с завода.** Часто 36 дБ (R1 = 47 к, R2 = 75 к) —
   перепаять под 26 дБ.
3. **Выходы класса D нельзя соединять с землёй** — динамик подключается
   между «+» и «−» одного канала, общей земли у него нет.

## 8. Кнопки и энкодеры

Все кнопки — на землю, подтяжка включается оверлеем (`gpio_pull=up`),
внешние резисторы не нужны.

| Орган | Вывод Pi | Контакт |
|---|---|---|
| Кнопка MENU (G3) | GPIO4 | 7 |
| Кнопка MEM (G3) | GPIO27 | 13 |
| Кнопка ◄ (G3) | GPIO22 | 15 |
| Кнопка ► (G3) | GPIO23 | 16 |
| Кнопка SEEK (G3) | GPIO24 | 18 |
| Энкодер 1 (G1): A / B / кнопка | GPIO5 / GPIO6 / GPIO25 | 29 / 31 / 22 |
| Энкодер 2 (G1): A / B / кнопка | GPIO7 / GPIO8 / GPIO12 | 26 / 24 / 32 |
| Кнопка MODE (G6) | GPIO9 | 21 |
| Кнопка питания (G5) | GPIO17 | 11 |

Вторые выводы всех кнопок и средний вывод каждого энкодера — на **GND**.

Кнопка MODE (G6) подключается как все остальные: один вывод на GPIO9, второй
на GND. Тумблер MTS-202, стоявший здесь до 2026-08-25, отменён —
[22](22-mode-switching.md).

## 9. Дисплей (A3)

Шлейф FFC в разъём DSI на Pi, контактами в нужную сторону (на плате Pi
подписано). Питание — **отдельным кабелем 5 В** от шины (п. 3), земля общая;
потребление около 500 мА с подсветкой. Точную схему питания сверить с вики
Waveshare по своей ревизии панели: сайт производителя из моего окружения
недоступен, эта деталь взята из внешнего разбора и мной не проверена.

**Тач и ревизия панели.** У новых ревизий 7inch DSI LCD (C) сенсор идёт по
шлейфу DSI на отдельную шину, с тюнером не пересекается. Есть сведения, что
у старых ревизий тач выведен на **I2C1, то есть на GPIO2/3** — те самые
выводы, где висит тюнер. План действий:

1. подключить как описано, ключ `i2c1` у оверлея **не включать**;
2. тач работает — ревизия новая, ничего не делаем;
3. тач не работает — посмотреть `i2cdetect` по обеим шинам. Контроллер тача
   обычно виден по адресу 0x38, тюнер — 0x10 и 0x11. Адреса разные, поэтому
   если тач окажется на i2c-1, его можно там и оставить, добавив ключ `i2c1`;
   конфликта с тюнером не будет.

`config.txt` — строка `dtoverlay=vc4-kms-dsi-waveshare-panel,7_0_inchC`
и остальные из [13](13-gpio-map.md).

## 10. Земля

Одна точка — у гнезда питания D2. К ней приходят: минус блока питания,
земля усилителя, земля преобразователя, земля Pi, земля тюнера с оплёткой
антенны, земля макетки.

Земли усилителя и цифровой части **больше нигде не соединяются**.

## 11. Порядок первого включения

Каждый шаг — с выключенным питанием, включаем только для замера.

1. Собрать только п. 2. Проверить защиту от переполюсовки.
2. Подключить D6, выставить **5,10 В** на холостом ходу.
3. Подключить D10, проверить **3,3 В** на его выходе.
4. Подключить Pi (micro-USB) и дисплей. Измерить напряжение **на самой плате
   Pi** (контакты 2 и 6 колодки) под нагрузкой — не ниже **4,75 В**; убедиться,
   что система грузится и `vcgencmd get_throttled` даёт `0x0`.
5. Подключить тюнер. `i2cdetect -y 1` → адреса 0x10 и 0x11. Обнаружение
   на шине — ещё не работоспособность: дальше прочитать регистр, задать
   частоту и убедиться, что на LOUT/ROUT реально есть звук.
6. Подключить ЦАП. `speaker-test -c2 -twav` — звук на выходе модуля
   проверить наушниками, **до** подключения усилителя.
7. Собрать сумматор, подключить усилитель и динамик. Громкость с самого
   начала на минимуме, подстроечник C4 — в положение минимального сигнала.
8. Поднять уровень подстроечником до нужной громкости без искажений.
9. Подключить кнопки и энкодеры. Проверить утилитой `evtest`.

## 12. Чего не хватает в заказанном комплекте

Расчёт уровней в п. 7 показал, что часть номиналов нужно доложить.
Это мелочь, но без неё узел не собрать как задумано:

| Что | Кол-во | Зачем |
|---|---|---|
| Резистор 1 кОм, 0,25 Вт | **3 шт** | две в эфирную ветвь сумматора (п. 7.2), одна последовательно в линию SD усилителя |
| Резистор 20 кОм, 0,25 Вт | 1 шт | делитель GAIN усилителя на 26 дБ |
| Резистор 100 кОм, 0,25 Вт | 1 шт | второй резистор того же делителя (в комплекте три уже заняты) |
| Конденсатор плёночный 3,3 мкФ, 63 В | 2 шт | вход усилителя под усиление 26 дБ (вместо 2,2 мкФ) |
| Кабель micro-USB, короткий (≤0,5 м), с толстыми силовыми жилами | 1 шт | питание Pi — в списке покупок этой позиции не было |

Резистор E9 (5,6 кОм) при этом остаётся неиспользованным — он был рассчитан
на усиление 20 дБ, от которого отказались после расчёта уровней.

Отдельно: на макете полезен **набор резисторов россыпью** — номиналы
сумматора почти наверняка придётся подбирать по факту, а не по расчёту.

## 13. Источники

- Уровень выхода RDA5807M: даташит, стр. 6 — «Audio L/R Output Voltage,
  Volume[3:0]=1111 — 360 — mV», там же «Rload=1KΩ» как условие нормирования
  искажений и «Directly support 32Ω resistance loading» на стр. 1.
- Таблица усиления TPA31xxD2 (26 дБ → R1 20 кОм, R2 100 кОм) — даташит TI,
  таблица 1, разбор в [12](12-audit-response.md), §3.
- Уровень PCM5102A 2,1 В — даташит TI.
- Карта выводов Pi — [13-gpio-map.md](13-gpio-map.md).
