Spok1978/hybrid-radio/docs/17-audit-response-wiring.md

# 17. Ответ на три внешних разбора схемы (2026-08-21)

> **НЕАКТУАЛЬНО — ревизия на Raspberry Pi.** С 2026-08-26 приёмник строится
> только на плате Waveshare ESP32-P4-WIFI6-Touch-LCD-5 ([24](24-main-build-p4.md)),
> Raspberry Pi в проекте не используется. Документ сохранён как история
> решений; для сборки, схемы и прошивки не применять. Актуальное: доп. платы —
> [33](33-carrier-board.md), перечень деталей — [35](35-carrier-boards-parts.md),
> выводы P4 — [33](33-carrier-board.md) §2, прошивка — [26](26-firmware-spec.md).

Три независимых разбора документов 15 и 16. Ниже — что принято, что
исправлено, где разборы противоречат друг другу и где ошибается один из них.

Проверяемое сверялось с первоисточниками: локальные копии даташитов
RDA5807M и TPA31xxD2, официальный список оверлеев Raspberry Pi (файл README
скачан целиком). Что проверить из моего окружения нельзя — помечено явно.

## 1. Самое важное: включение IRF4905 было описано по-разному в двух документах

Документ 09 говорил «исток к «+» входа, сток к нагрузке», документ 15 —
наоборот. Разборы разошлись во мнениях: один предложил вариант документа 09,
два других подтвердили вариант документа 15.

**Прав документ 15.** Вывод независимый, из физики прибора:

- у P-канального транзистора паразитный диод направлен от **стока** к истоку
  (анод — сток);
- при включении «сток к входу» и обратной полярности этот диод **заперт** —
  защита работает;
- при включении «исток к входу» и обратной полярности он оказывается смещён
  **в прямом направлении** и пропускает обратный ток в устройство через
  нагрузку. То есть защита превращается в её видимость.

Документ 09 исправлен, теперь оба документа говорят одно и то же и обоснование
записано. **Собирать по документу 15.**

Отдельно принимаю замечание по методике: фраза «если при обратной полярности
напряжение проходит — поменять сток и исток» была неправильной по духу.
Включение фиксируется по даташиту заранее, а проверка нужна как контроль
монтажа. Формулировка исправлена.

## 2. Что принято и исправлено

| Замечание | Вердикт | Что сделано |
|---|---|---|
| В `config.txt` нет строк `gpio-key` для тумблера (GPIO9) и кнопки второго энкодера (GPIO12) | **верно** | строки добавлены в [13](13-gpio-map.md) |
| У кнопок не задан `keycode` | **верно** | всем восьми входам заданы уникальные коды. В описании оверлея значение по умолчанию не документировано, но без явного кода кнопки в лучшем случае неразличимы |
| Позиции H14 (кабель micro-USB) в списке покупок не существует | **верно, мой недосмотр** | кабель добавлен в дозаказ [11](11-shopping-list.md), ссылки в 15 и 16 поправлены |
| При 26 дБ вход усилителя 30 кОм, даташит рекомендует 3,3 мкФ, а не 2,2 | **верно** | E3 → **3,3 мкФ** в документах 04, 11, 15, 16. Таблица даташита: 20 дБ → 60 кОм → 1,5 мкФ; **26 дБ → 30 кОм → 3,3 мкФ**; 32 дБ → 15 кОм → 5,6 мкФ |
| Конденсаторы на выходе PCM5102A не нужны — выходы DirectPath, центрированы на земле | **принято** | формулировка в [04](04-audio-path.md) исправлена. Проверяется на макете за минуту: постоянное напряжение на выходе ЦАП относительно земли должно быть около нуля |
| Дроссель 10 мкГн в общей шине 5 В — плохая идея | **верно** | перенесён в ветвь LDO. Последовательная индуктивность с большой ёмкостью звенит на импульсной нагрузке Pi и съедает запас по напряжению, которого и так мало |
| Мерить не только выход преобразователя, но и напряжение на самой плате Pi | **верно** | добавлено в порядок включения: **не ниже 4,75 В** на контактах 2 и 6 колодки под нагрузкой |
| Полярность TVS и электролитов прописать явно | **верно** | прописано в 15 и 16 |
| Последовательный резистор 1 кОм между GPIO11 и SD усилителя | **принято** | дешёвая страховка GPIO при ошибке монтажа, добавлен в схему и в дозаказ |
| Mini360 (MP2307) по факту отдаёт заметно меньше 3 А | **принято** | в [09](09-power-supply.md) записано предпочтение **SY8205**, и требование брать **регулируемую** версию, а не с фиксированными 5,0 В |
| Питание панели — отдельным кабелем 5 В, около 500 мА | **принято к сведению** | записано в [15](15-wiring-breadboard.md) с пометкой: сайт Waveshare из моего окружения недоступен, эту деталь я не проверила |
| У старых ревизий панели тач может сидеть на I2C1 (GPIO2/3) | **принято** | в 15 добавлен план на этот случай. Хорошая новость оттуда же: адреса разные (тач 0x38, тюнер 0x10/0x11), поэтому даже на одной шине они уживутся |
| Номиналы сумматора считать стартовыми и мерить | **верно** | в 15 добавлена процедура: цель 0,2…0,3 В действующего на движке от каждого источника по отдельности, при расхождении больше 3–4 дБ править эфирную ветвь в сторону 1,5–2,2 кОм |
| «Адрес на шине — не доказательство работоспособности» | **верно** | в порядок включения добавлено: после `i2cdetect` прочитать регистр, задать частоту и убедиться, что звук реально есть |
| Формулировка про земли слишком категорична | **принято частично** | смысл в документах был верный (одна точка, аудиоземля одним проводом), но проверить топологию на макете действительно надо |

## 3. Что нашла сама при разборе замечаний

**Бит DHIZ у RDA5807M** (регистр 02H, бит 15) переводит аудиовыход в
высокоомное состояние. Для нашего пассивного сумматора это важно: выход
неактивного тюнера должен оставаться **низкоомным**, иначе он перестанет
шунтировать узел и уровень интернет-тракта скакнёт. Значит DHIZ держим
включённым, а тишину делаем громкостью и mute. Ни один из трёх разборов
этого не заметил; записано в [15](15-wiring-breadboard.md), п. 7.2.

## 4. Что не принято

**Активный сумматор на операционном усилителе** вместо пассивного.
Предложение разумное и для серийного прибора правильное: нет взаимного
влияния источников, точная настройка уровней, честное переключение. Но это
плюс микросхема, плюс её питание (нужна двуполярка или искусственная средняя
точка), плюс ещё один узел для отладки. Для первого макета пассивный сумматор
проверяем как есть; если измерения покажут, что взаимное влияние мешает —
вернёмся к этому вопросом отдельно.

**Полный формальный аудит «позиция → производитель → part number → даташит»**
перед монтажом. По сути он уже проведён для всех критичных узлов — питание,
тюнер, ЦАП, усилитель, оверлеи. Для дешёвых модулей с AliExpress такой аудит
всё равно упирается в то, что реальная плата может отличаться от картинки,
поэтому вместо бумажной сверки в документах стоят конкретные измерения при
сборке. Это надёжнее.

## 5. Что осталось непроверяемым из моего окружения

- **Вики Waveshare** (питание панели, ревизии, поведение тача) — сайт
  недоступен, все связанные утверждения помечены как непроверенные.
- **Распиновки конкретных купленных модулей** (RRD-102V2.0, GY-PCM5102A,
  плата TPA3118D2, HT7333 в TO-92) — сверяются по шелкографии при получении.
  Особенно HT7333: у TO-92 порядок выводов у разных производителей разный,
  а 5 В на тюнере убивают его сразу.
- **Реальные уровни в сумматоре** — только измерением.

## 6. Итог

Три разбора дали одну критическую находку (противоречие по включению
MOSFET), две важные (отсутствующие строки `config.txt` и отсутствующая
позиция кабеля в списке покупок) и десяток полезных уточнений. Все приняты
и внесены. Схема после правок собирается как написано.
