Spok1978/hybrid-radio/hardware/kicad/Hybryd Radio.pdf

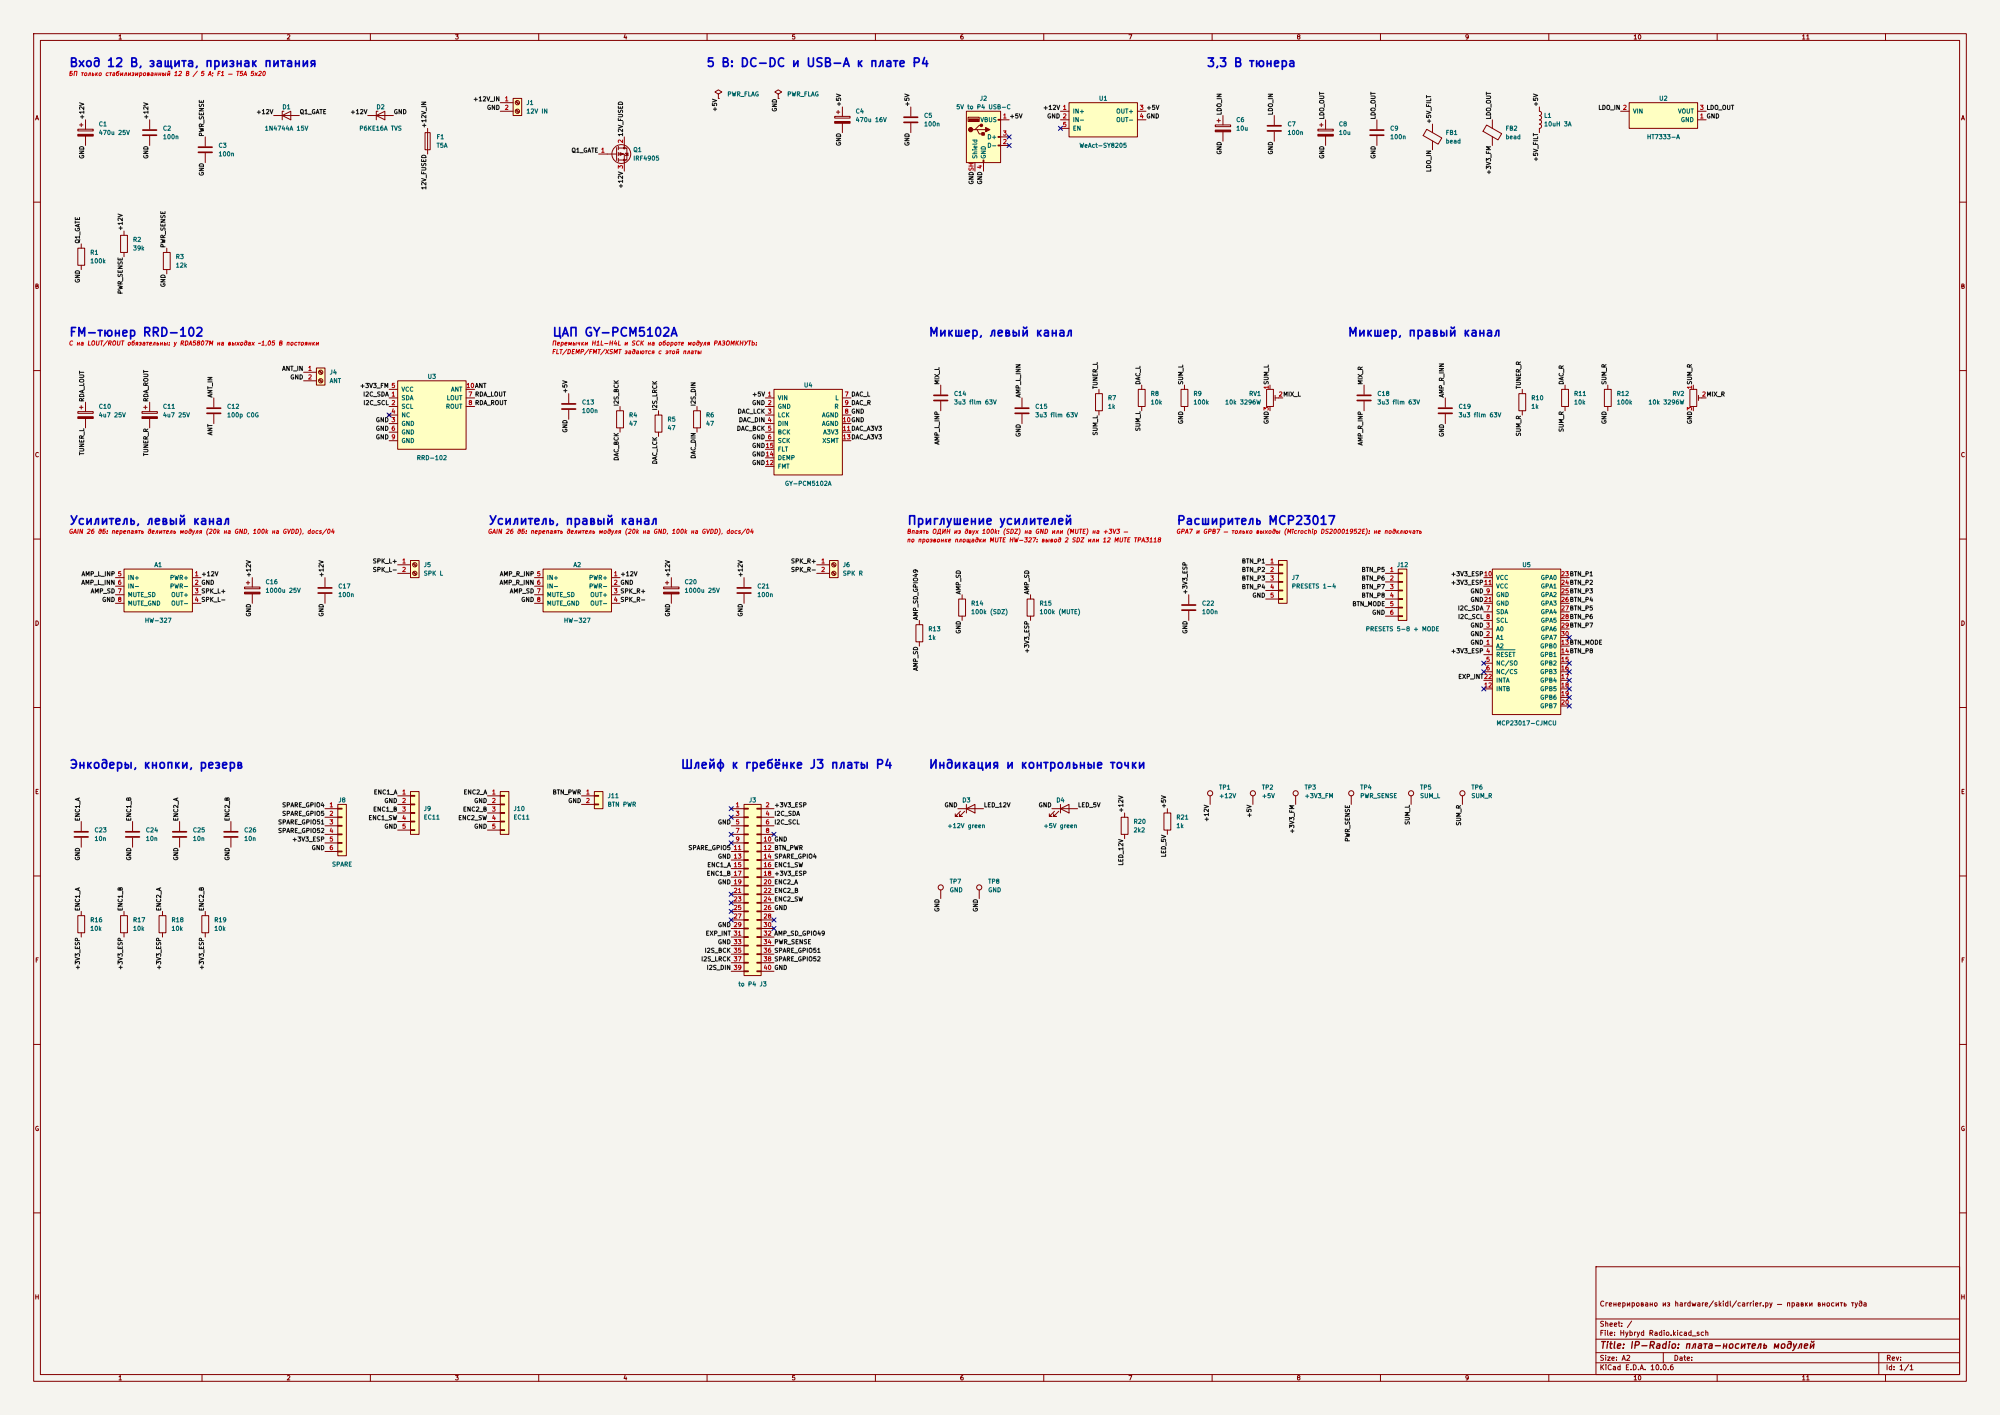
[picture p3: page 1]

Вход 12 В, защита, признак питания

по прозвонке площадки MUTE HW-327: вывод 2 SDZ или 12 MUTE TPA3118 FM-тюнер RRD-102

Перемычки H1L-H4L и SCK на обороте модуля РАЗОМКНУТЬ: FLT/DEMP/FMT/XSMT задаются с этой платы Усилитель, левый канал

GAIN 26 дБ: перепаять делитель модуля (20k на GND, 100k на GVDD), docs/04

Сгенерировано из hardware/skidl/carrier.py — правки вносить туда

Sheet: /
File: Hybryd Radio.kicad_sch
Title: IP-Radio: плата-носитель модулей

Size: A2 | Rev:
KiCad E.D.A. 10.0.6 | Id: 1/1
