Spok1978/hybrid-radio/hardware/kicad/amp/amp.kicad_pcb

## KiCad design hardware/kicad/amp/amp.kicad_pcb (2026-10-18)

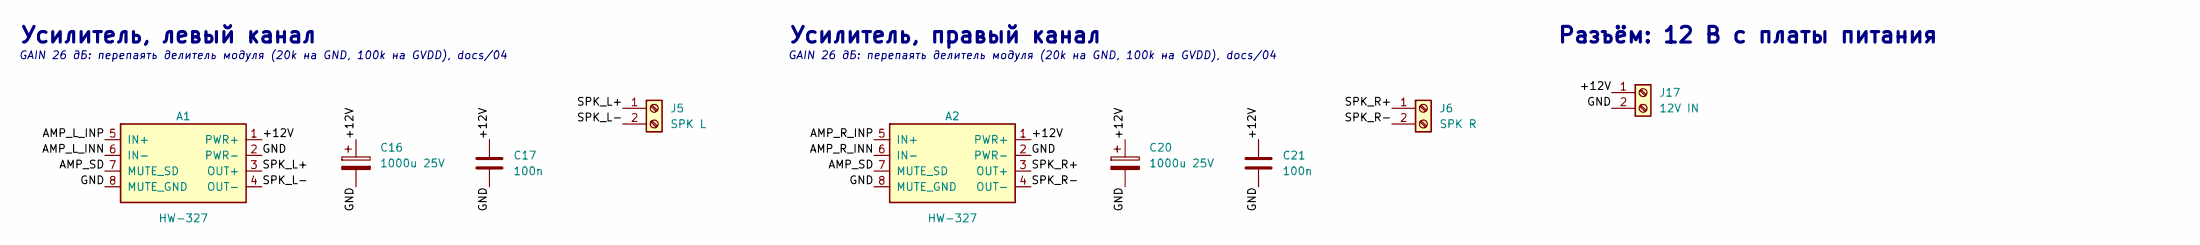
[picture p4: schematic amp.kicad_sch, Разъём: 12 В с платы питания]

Parts:
A1, A2: HW-327
C16, C20: 1000u 25V; CP_Radial_D12.5mm_P5.00mm
C17, C21: 100n; C_Disc_D5.0mm_W2.5mm_P5.00mm
J5: SPK L; TerminalBlock_Phoenix_MKDS-1,5-2-5.08_1x02_P5.08mm_Horizont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
J6: SPK R; TerminalBlock_Phoenix_MKDS-1,5-2-5.08_1x02_P5.08mm_Horizont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
J17: 12V IN; TerminalBlock_Phoenix_MKDS-1,5-2-5.08_1x02_P5.08mm_Horizont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

Connections:
/+12V: A1.1 (PWR+), A2.1 (PWR+), C16.1, C17.1, C20.1, C21.1, J17.1
/AMP_L_INN: A1.6 (IN-)
/AMP_L_INP: A1.5 (IN+)
/AMP_R_INN: A2.6 (IN-)
/AMP_R_INP: A2.5 (IN+)
/AMP_SD: A1.7 (MUTE_SD), A2.7 (MUTE_SD)
/GND: A1.2 (PWR-), A1.8 (MUTE_GND), A2.2 (PWR-), A2.8 (MUTE_GND), C16.2, C17.2, C20.2, C21.2, J17.2
/SPK_L+: A1.3 (OUT+), J5.1
/SPK_L-: A1.4 (OUT-), J5.2
/SPK_R+: A2.3 (OUT+), J6.1
/SPK_R-: A2.4 (OUT-), J6.2

Notes on the sheet:
Усилитель, левый канал
GAIN 26 дБ: перепаять делитель модуля (20k на GND, 100k на GVDD), docs/04
Усилитель, правый канал
Разъём: 12 В с платы питания

Board: 2 copper layers, 13 parts (0 on the bottom side), 7 nets, no tracks yet.

Other parts of the board:
H1, H2, H3, H4: M3; MountingHole_M3_FabRef
