Spok1978/hybrid-radio/hardware/kicad/signal/signal.kicad_pcb

## KiCad design hardware/kicad/signal/signal.kicad_pcb (2026-10-18)

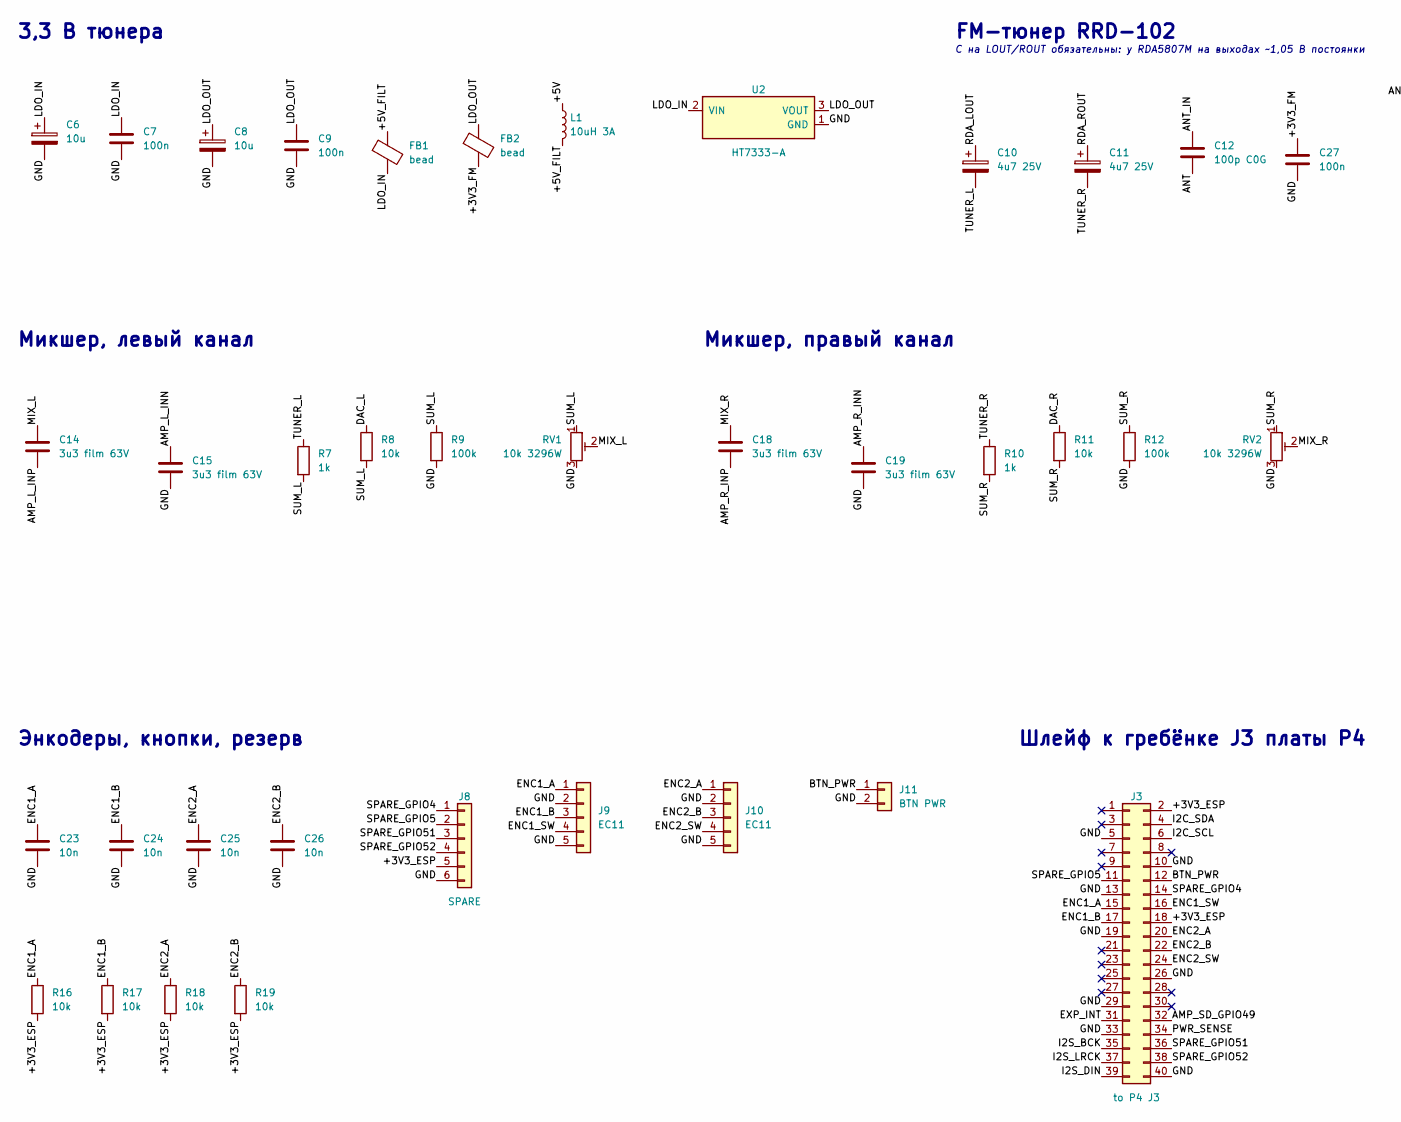
[picture p5: schematic signal.kicad_sch, Разъёмы: питание, провода к усилителям, part in row 1, column 1]

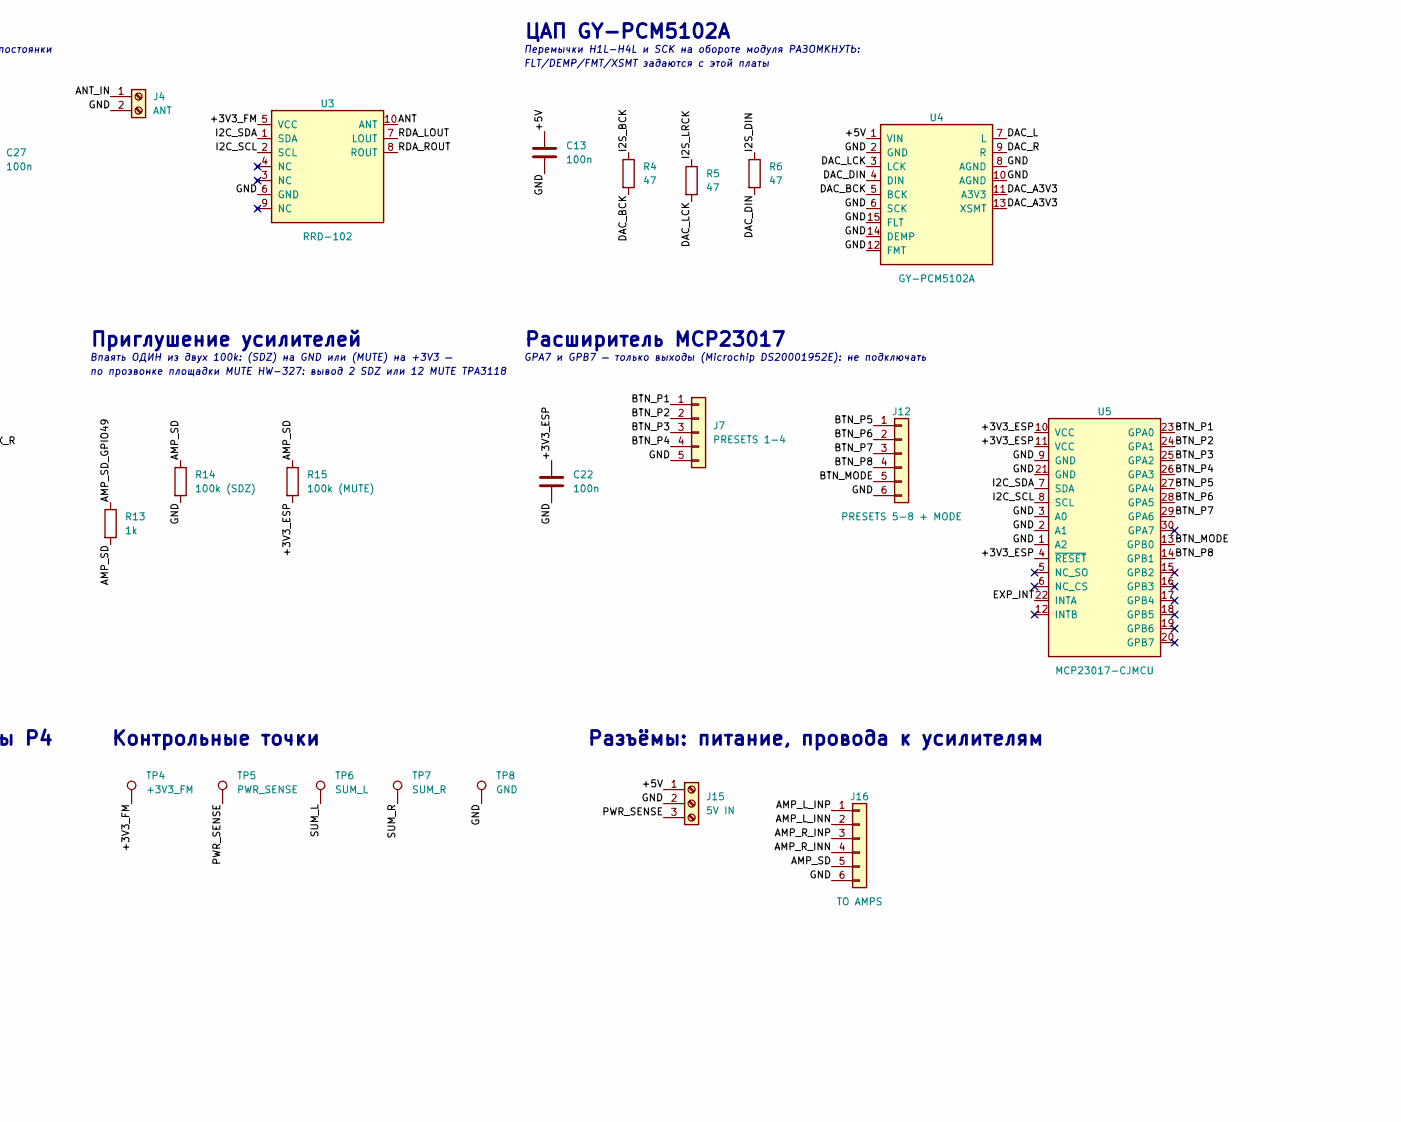
[picture p6: schematic signal.kicad_sch, Разъёмы: питание, провода к усилителям, part in row 1, column 2]

Parts:
C6, C8: 10u; CP_Radial_D5.0mm_P2.00mm
C7, C9, C13, C22, C27: 100n; C_Disc_D5.0mm_W2.5mm_P5.00mm
C10, C11: 4u7 25V; CP_Radial_D5.0mm_P2.00mm
C12: 100p C0G; C_Disc_D5.0mm_W2.5mm_P5.00mm
C14, C15, C18, C19: 3u3 film 63V; C_Rect_L18.0mm_W8.0mm_P15.00mm_FKS3_FKP3
C23, C24, C25, C26: 10n; C_Disc_D5.0mm_W2.5mm_P5.00mm
FB1, FB2: bead; L_Axial_L5.3mm_D2.2mm_P10.16mm_Horizontal_Vishay_IM-1
J3: to P4 J3; IDC-Header_2x20_P2.54mm_Vertical
J4: ANT; TerminalBlock_Phoenix_MKDS-1,5-2-5.08_1x02_P5.08mm_Horizont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
J7: PRESETS 1-4; SolderWire-0.25sqmm_1x05_P4.2mm_D0.65mm_OD1.7mm
J8: SPARE; JST_XH_B6B-XH-A_1x06_P2.50mm_Vertical
J9, J10: EC11; SolderWire-0.25sqmm_1x05_P4.2mm_D0.65mm_OD1.7mm
J11: BTN PWR; SolderWire-0.25sqmm_1x02_P4.2mm_D0.65mm_OD1.7mm
J12: PRESETS 5-8 + MODE; SolderWire-0.25sqmm_1x06_P4.2mm_D0.65mm_OD1.7mm
J15: 5V IN; TerminalBlock_Phoenix_MKDS-1,5-3-5.08_1x03_P5.08mm_Horizont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
J16: TO AMPS; SolderWire-0.25sqmm_1x06_P4.2mm_D0.65mm_OD1.7mm
L1: 10uH 3A; L_Radial_D10.0mm_P5.00mm_Fastron_07P
R4, R5, R6: 47; R_Axial_DIN0207_L6.3mm_D2.5mm_P10.16mm_Horizontal
R7, R10, R13: 1k; R_Axial_DIN0207_L6.3mm_D2.5mm_P10.16mm_Horizontal
R8, R11, R16, R17, R18, R19: 10k; R_Axial_DIN0207_L6.3mm_D2.5mm_P10.16mm_Horizontal
R9, R12: 100k; R_Axial_DIN0207_L6.3mm_D2.5mm_P10.16mm_Horizontal
R14: 100k (SDZ); R_Axial_DIN0207_L6.3mm_D2.5mm_P10.16mm_Horizontal
R15: 100k (MUTE); R_Axial_DIN0207_L6.3mm_D2.5mm_P10.16mm_Horizontal
RV1, RV2: 10k 3296W; Potentiometer_Bourns_3296W_Vertical
TP4: +3V3_FM; TestPoint_THTPad_D2.0mm_Drill1.0mm
TP5: PWR_SENSE; TestPoint_THTPad_D2.0mm_Drill1.0mm
TP6: SUM_L; TestPoint_THTPad_D2.0mm_Drill1.0mm
TP7: SUM_R; TestPoint_THTPad_D2.0mm_Drill1.0mm
TP8: GND; TestPoint_THTPad_D2.0mm_Drill1.0mm
U2: HT7333-A; TO-92_Inline_Wide
U3: RRD-102
U4: GY-PCM5102A
U5: MCP23017-CJMCU

Connections:
/+3V3_ESP: C22.1, J3.2, J3.18, J8.5, R15.2, R16.2, R17.2, R18.2, R19.2, U5.4 (~RESET), U5.10 (VCC), U5.11 (VCC)
/+3V3_FM: C27.1, FB2.2, TP4.1, U3.5 (VCC)
/+5V: C13.1, J15.1, L1.1, U4.1 (VIN)
/+5V_FILT: FB1.1, L1.2
/AMP_L_INN: C15.1, J16.2
/AMP_L_INP: C14.2, J16.1
/AMP_R_INN: C19.1, J16.4
/AMP_R_INP: C18.2, J16.3
/AMP_SD: J16.5, R13.2, R14.1, R15.1
/AMP_SD_GPIO49: J3.32, R13.1
/ANT: C12.2, U3.10 (ANT)
/ANT_IN: C12.1, J4.1
/BTN_MODE: J12.5, U5.13 (GPB0)
/BTN_P1: J7.1, U5.23 (GPA0)
/BTN_P2: J7.2, U5.24 (GPA1)
/BTN_P3: J7.3, U5.25 (GPA2)
/BTN_P4: J7.4, U5.26 (GPA3)
/BTN_P5: J12.1, U5.27 (GPA4)
/BTN_P6: J12.2, U5.28 (GPA5)
/BTN_P7: J12.3, U5.29 (GPA6)
/BTN_P8: J12.4, U5.14 (GPB1)
/BTN_PWR: J3.12, J11.1
/DAC_A3V3: U4.11 (A3V3), U4.13 (XSMT)
/DAC_BCK: R4.2, U4.5 (BCK)
/DAC_DIN: R6.2, U4.4 (DIN)
/DAC_L: R8.1, U4.7 (L)
/DAC_LCK: R5.2, U4.3 (LCK)
/DAC_R: R11.1, U4.9 (R)
/ENC1_A: C23.1, J3.15, J9.1, R16.1
/ENC1_B: C24.1, J3.17, J9.3, R17.1
/ENC1_SW: J3.16, J9.4
/ENC2_A: C25.1, J3.20, J10.1, R18.1
/ENC2_B: C26.1, J3.22, J10.3, R19.1
/ENC2_SW: J3.24, J10.4
/EXP_INT: J3.31, U5.22 (INTA)
/GND: C6.2, C7.2, C8.2, C9.2, C13.2, C15.2, C19.2, C22.2, C23.2, C24.2, C25.2, C26.2, C27.2, J3.5, J3.10, J3.13, J3.19, J3.26, J3.29, J3.33, J3.40, J4.2, J7.5, J8.6, J9.2, J9.5, J10.2, J10.5, J11.2, J12.6, J15.2, J16.6, R9.2, R12.2, R14.2, RV1.3, RV2.3, TP8.1, U2.1 (GND), U3.6 (GND), U4.2 (GND), U4.6 (SCK), U4.8 (AGND), U4.10 (AGND), U4.12 (FMT), U4.14 (DEMP), U4.15 (FLT), U5.1 (A2), U5.2 (A1), U5.3 (A0), U5.9 (GND), U5.21 (GND)
/I2C_SCL: J3.6, U3.2 (SCL), U5.8 (SCL)
/I2C_SDA: J3.4, U3.1 (SDA), U5.7 (SDA)
/I2S_BCK: J3.35, R4.1
/I2S_DIN: J3.39, R6.1
/I2S_LRCK: J3.37, R5.1
/LDO_IN: C6.1, C7.1, FB1.2, U2.2 (VIN)
/LDO_OUT: C8.1, C9.1, FB2.1, U2.3 (VOUT)
/MIX_L: C14.1, RV1.2
/MIX_R: C18.1, RV2.2
/PWR_SENSE: J3.34, J15.3, TP5.1
/RDA_LOUT: C10.1, U3.7 (LOUT)
/RDA_ROUT: C11.1, U3.8 (ROUT)
/SPARE_GPIO4: J3.14, J8.1
/SPARE_GPIO5: J3.11, J8.2
/SPARE_GPIO51: J3.36, J8.3
/SPARE_GPIO52: J3.38, J8.4
/SUM_L: R7.2, R8.2, R9.1, RV1.1, TP6.1
/SUM_R: R10.2, R11.2, R12.1, RV2.1, TP7.1
/TUNER_L: C10.2, R7.1
/TUNER_R: C11.2, R10.1

Notes on the sheet:
3,3 В тюнера
FM-тюнер RRD-102
C на LOUT/ROUT обязательны: у RDA5807M на выходах ~1,05 В постоянки
ЦАП GY-PCM5102A
Перемычки H1L-H4L и SCK на обороте модуля РАЗОМКНУТЬ:
FLT/DEMP/FMT/XSMT задаются с этой платы
Микшер, левый канал
Микшер, правый канал
Приглушение усилителей
Впаять ОДИН из двух 100k: (SDZ) на GND или (MUTE) на +3V3 —
по прозвонке площадки MUTE HW-327: вывод 2 SDZ или 12 MUTE TPA3118
Расширитель MCP23017
GPA7 и GPB7 — только выходы (Microchip DS20001952E): не подключать
Энкодеры, кнопки, резерв
Шлейф к гребёнке J3 платы P4
Контрольные точки
Разъёмы: питание, провода к усилителям

Board: 2 copper layers, 62 parts (0 on the bottom side), 56 nets, no tracks yet.

Other parts of the board:
H1, H2, H3, H4: M3; MountingHole_M3_FabRef
