Spok1978/hybrid-radio/hardware/kicad/power/power.kicad_pcb

## KiCad design hardware/kicad/power/power.kicad_pcb (2026-10-18)

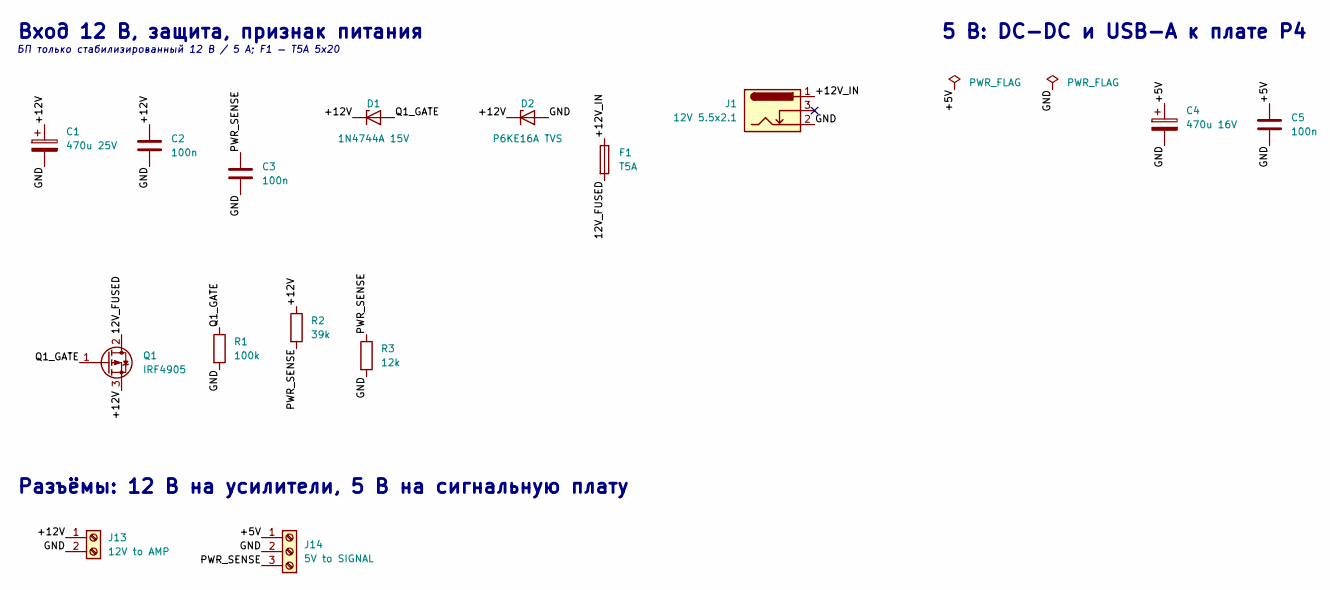
[picture p7: schematic power.kicad_sch, Разъёмы: 12 В на усилители, 5 В на сигнальную плату, part in row 1, column 1]

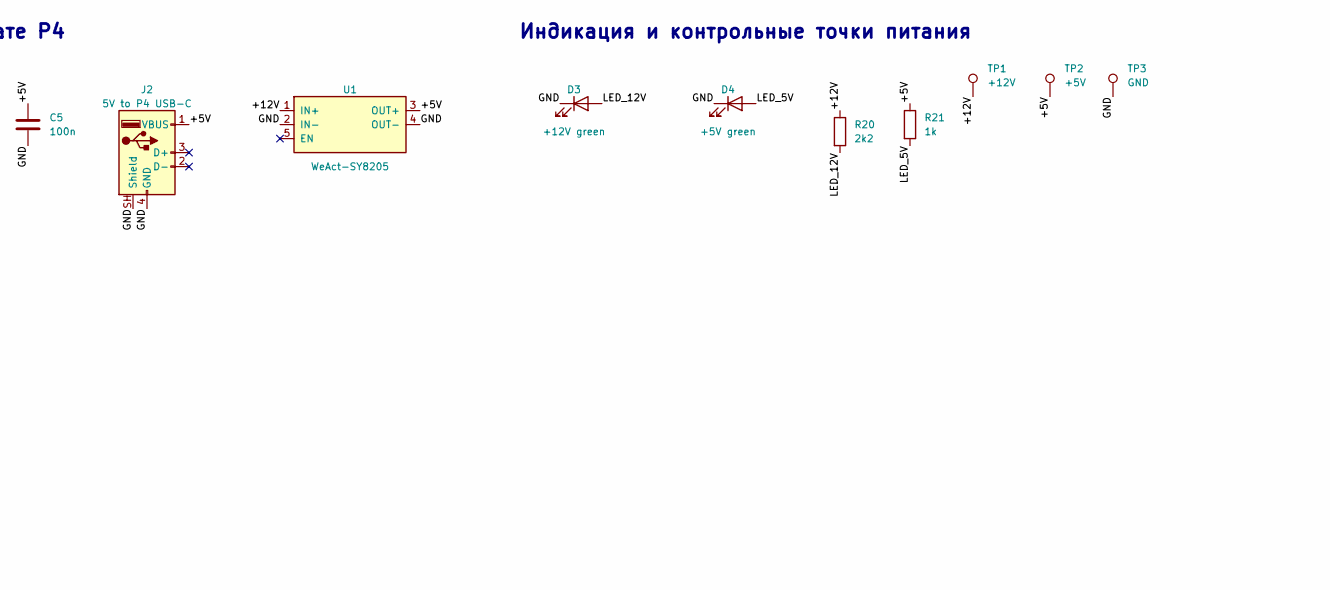
[picture p8: schematic power.kicad_sch, Разъёмы: 12 В на усилители, 5 В на сигнальную плату, part in row 1, column 2]

Parts:
C1: 470u 25V; CP_Radial_D10.0mm_P5.00mm
C2, C3, C5: 100n; C_Disc_D5.0mm_W2.5mm_P5.00mm
C4: 470u 16V; CP_Radial_D8.0mm_P3.50mm
D1: 1N4744A 15V; D_DO-41_SOD81_P10.16mm_Horizontal
D2: P6KE16A TVS; D_DO-15_P12.70mm_Horizontal
D3: +12V green; LED_D3.0mm
D4: +5V green; LED_D3.0mm
F1: T5A; Fuseholder_Clip-5x20mm_Bel_FC-203-22_Lateral_P17.80x5.00mm_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
J1: 12V 5.5x2.1; BarrelJack_Horizontal
J2: 5V to P4 USB-C; USB_A_Molex_67643_Horizontal
J13: 12V to AMP; TerminalBlock_Phoenix_MKDS-1,5-2-5.08_1x02_P5.08mm_Horizont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
J14: 5V to SIGNAL; TerminalBlock_Phoenix_MKDS-1,5-3-5.08_1x03_P5.08mm_Horizont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
Q1: IRF4905; TO-220-3_Vertical
R1: 100k; R_Axial_DIN0207_L6.3mm_D2.5mm_P10.16mm_Horizontal
R2: 39k; R_Axial_DIN0207_L6.3mm_D2.5mm_P10.16mm_Horizontal
R3: 12k; R_Axial_DIN0207_L6.3mm_D2.5mm_P10.16mm_Horizontal
R20: 2k2; R_Axial_DIN0207_L6.3mm_D2.5mm_P10.16mm_Horizontal
R21: 1k; R_Axial_DIN0207_L6.3mm_D2.5mm_P10.16mm_Horizontal
TP1: +12V; TestPoint_THTPad_D2.0mm_Drill1.0mm
TP2: +5V; TestPoint_THTPad_D2.0mm_Drill1.0mm
TP3: GND; TestPoint_THTPad_D2.0mm_Drill1.0mm
U1: WeAct-SY8205

Connections:
/12V_FUSED: F1.2, Q1.2 (D)
/+5V: C4.1, C5.1, J2.1 (VBUS), J14.1, R21.1, TP2.1, U1.3 (OUT+)
/+12V: C1.1, C2.1, D1.1 (K), D2.1 (K), J13.1, Q1.3 (S), R2.1, R20.1, TP1.1, U1.1 (IN+)
/+12V_IN: F1.1, J1.1
/GND: C1.2, C2.2, C3.2, C4.2, C5.2, D2.2 (A), D3.1 (K), D4.1 (K), J1.2, J2.4 (GND), J2.SH (Shield), J13.2, J14.2, R1.2, R3.2, TP3.1, U1.2 (IN-), U1.4 (OUT-)
/LED_5V: D4.2 (A), R21.2
/LED_12V: D3.2 (A), R20.2
/PWR_SENSE: C3.1, J14.3, R2.2, R3.1
/Q1_GATE: D1.2 (A), Q1.1 (G), R1.1

Notes on the sheet:
Вход 12 В, защита, признак питания
БП только стабилизированный 12 В / 5 А; F1 — T5A 5x20
5 В: DC-DC и USB-A к плате P4
Индикация и контрольные точки питания
Разъёмы: 12 В на усилители, 5 В на сигнальную плату

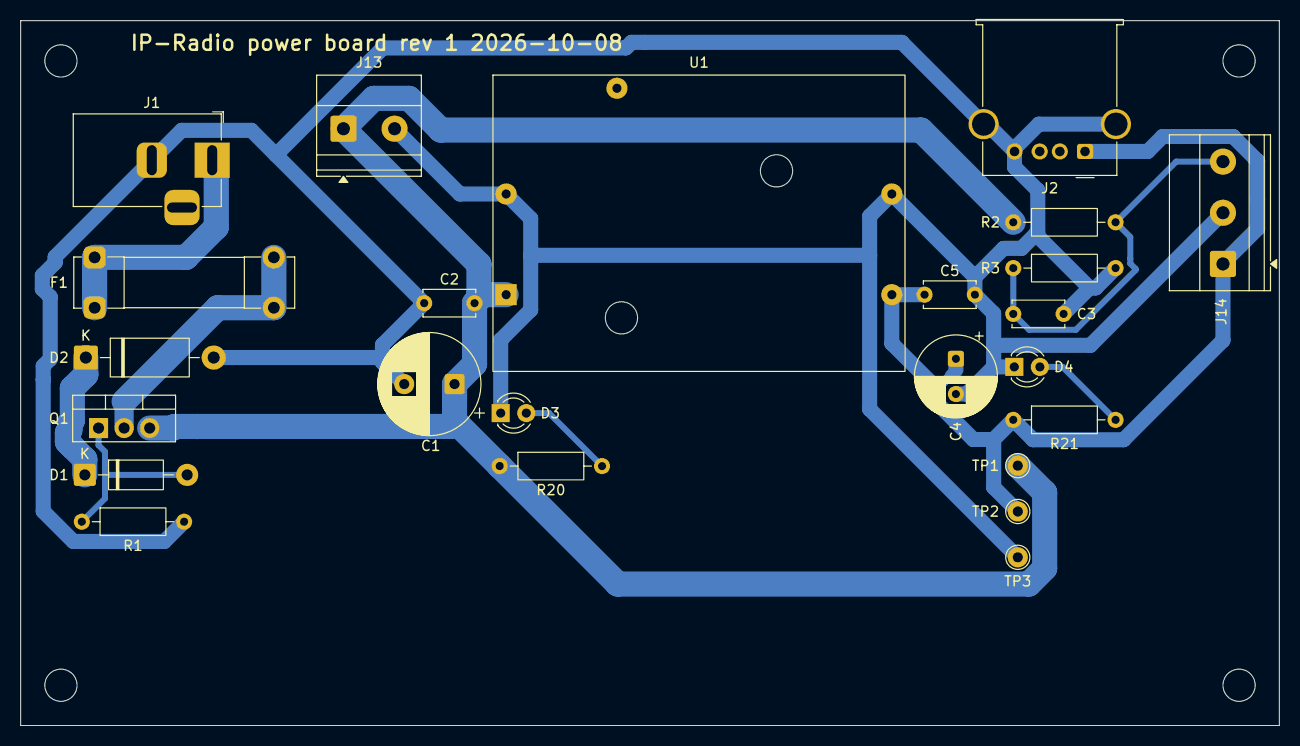
[picture p9: board power.kicad_pcb from above]

Board: 2 copper layers, 125.0 x 70.0 mm, 28 parts (0 on the bottom side), 9 nets.

Other parts of the board:
H1, H2, H3, H4: M3; MountingHole_M3_FabRef
