Spok1978/hybrid-radio/firmware/main/ipradio_state.h

/*
 * ipradio_state.h — конечный автомат прибора: единственный владелец состояния.
 *
 * Требование docs/26-firmware-spec.md, §3: режим, станция, частота,
 * громкость и mute живут в одном месте. Остальные модули состояние
 * ЧИТАЮТ, а меняют только отправкой сообщения в очередь. Двух копий
 * истины быть не должно — из этого прямо следует поведение громкости
 * (§6.3) и пресетов (§6.2).
 */

#pragma once

#include <stdbool.h>
#include <stdint.h>

#include "esp_err.h"

#ifdef __cplusplus
extern "C" {
#endif

/* ------------------------------------------------------------------ *
 *  Типы
 * ------------------------------------------------------------------ */

/** Режим воспроизведения. Физического переключателя нет: режим —
 *  программное состояние, docs/22-mode-switching.md. */
typedef enum {
    IPRADIO_MODE_FM = 0,   /**< эфир: УКВ или FM */
    IPRADIO_MODE_NET,      /**< интернет-радио   */
} ipradio_mode_t;

/** Эфирный диапазон. На экране подписывается коротко — «УКВ» и «FM»,
 *  без OIRT и CCIR (§5.1).
 *
 *  РЕШЕНИЕ ЗАКАЗЧИКА 2026-08-28: УКВ пока не делаем. Работы хватает
 *  и без него, а вернуть его дешевле, чем написать заново.
 *
 *  Поэтому диапазон не вырезан, а выключен: тюнер умеет оба (регистр
 *  03H, коды диапазона и шага в ipradio_tuner.c), и удалять рабочий
 *  код, чтобы через месяц писать его снова, - плохой размен.
 *  Выключено ровно то, что торчит наружу: выбор диапазона, подписи
 *  и перестройка по сетке УКВ.
 *
 *  Чтобы вернуть: поставить единицу ниже и добавить орган
 *  переключения на экране настройки эфира. Больше ничего. */
#define IPRADIO_ENABLE_OIRT  0
typedef enum {
    IPRADIO_BAND_OIRT = 0, /**< УКВ, 65,8–74 МГц   */
    IPRADIO_BAND_CCIR,     /**< FM, 87,5–108 МГц   */
} ipradio_band_t;

/** Состояние сети. Три разных случая недоступности требуют разной
 *  реакции — docs/26-firmware-spec.md, §5.2. */
typedef enum {
    IPRADIO_NET_NOT_CONFIGURED = 0, /**< сохранённых сетей нет вовсе      */
    IPRADIO_NET_DISCONNECTED,       /**< настроена, связи нет             */
    IPRADIO_NET_CONNECTING,         /**< идёт подключение                 */
    IPRADIO_NET_CONNECTED,          /**< связь есть                       */
} ipradio_net_state_t;

/** Что происходит со звуком прямо сейчас. */
typedef enum {
    IPRADIO_PLAY_IDLE = 0,   /**< ничего не играет                       */
    IPRADIO_PLAY_PLAYING,    /**< играет                                 */
    IPRADIO_PLAY_BUFFERING,  /**< поток открыт, наполняется буфер        */
    IPRADIO_PLAY_ERROR,      /**< станция не отвечает                    */
} ipradio_play_state_t;

/* ------------------------------------------------------------------ *
 *  Снимок состояния
 * ------------------------------------------------------------------ */

#define IPRADIO_NAME_MAX   64

/** Полный снимок. Читатели получают копию, а не указатель на живые
 *  данные: иначе состояние поменяется прямо во время отрисовки. */
typedef struct {
    ipradio_mode_t       mode;

    /* Эфир */
    ipradio_band_t       band;
    uint32_t             freq_khz;                 /**< текущая частота     */
    char                 rds_name[IPRADIO_NAME_MAX];   /**< имя из RDS      */
    bool                 rds_valid;                /**< RDS синхронизирован */
    uint8_t              signal_level;             /**< 0…100               */

    /* Интернет */
    char                 station_name[IPRADIO_NAME_MAX]; /**< имя станции   */
    char                 icy_title[IPRADIO_NAME_MAX];    /**< метаданные    */
    uint16_t             bitrate_kbps;
    uint8_t              buffer_fill;              /**< 0…100               */

    /* Общее */
    ipradio_play_state_t play;
    ipradio_net_state_t  net;
    int8_t               active_preset;            /**< 1…N, или -1         */

    /* Растёт на КАЖДОЕ нажатие ячейки, даже если номер не изменился.
     *
     * Нужен мосту, чтобы отличить «человек попросил ещё раз» от
     * «ничего не изменилось, просто пришёл тик». Без этого мост
     * не мог понять, повторять ли попытку, и либо не повторял
     * никогда, либо повторял без конца. Переполнение безобидно -
     * важно лишь неравенство. */
    uint16_t             preset_seq;

    /* Громкость: ОДНО логическое значение на оба режима, §6.3.
     * Поправка на режим применяется при переносе на железо, а не
     * хранится отдельными значениями. */
    uint8_t              volume;                   /**< 0…100               */
    bool                 muted;

    /* Счётчик отказов кнопке MODE. Растёт каждый раз, когда человек
     * попросил интернет-режим, а сеть недоступна.
     *
     * Именно счётчик, а не флаг: флаг пришлось бы кем-то сбрасывать,
     * и между «поставили» и «сбросили» встряла бы гонка с отрисовкой.
     * Читатель просто запоминает последнее увиденное значение
     * и сравнивает. Переполнение безобидно - важно лишь неравенство. */
    uint16_t             mode_denied_seq;

    /* Запрошено выключение. Автомат сам в сон не уходит: это действие
     * над всем прибором, а не над его состоянием.
     *
     * Разделение такое. НАСТРОЙКИ СОХРАНЯЕТ АВТОМАТ, до того как
     * поднимет этот флаг: он единственный владелец состояния, и
     * записывать его должен он. Флаг видит мост и делает остальное -
     * глушит звук, гасит подсветку, уводит кристалл в глубокий сон.
     *
     * Раньше здесь было написано, что настройки сохраняет мост.
     * Это было неверно и однажды уже вызвало подозрение, что они
     * теряются при выключении. */
    bool                 power_off;
} ipradio_snapshot_t;

/* ------------------------------------------------------------------ *
 *  События
 * ------------------------------------------------------------------ */

typedef enum {
    /* От органов управления */
    IPRADIO_EV_VOLUME_DELTA,      /**< поворот регулятора 2, arg = ±шаги      */
    IPRADIO_EV_VOLUME_SET,        /**< ползунок на экране, arg = 0…100       */
    IPRADIO_EV_MUTE_TOGGLE,       /**< нажатие регулятора 2                   */
    IPRADIO_EV_MODE_TOGGLE,       /**< кнопка MODE                          */
    IPRADIO_EV_PRESET_PRESSED,    /**< arg = номер ячейки, 1…N              */
    IPRADIO_EV_PRESET_HOLD,       /**< долгое нажатие: записать текущую     */
    IPRADIO_EV_PRESET_EDITED,     /**< ячейку поправили с экрана,
                                       arg = IPRADIO_PRESET_ARG(режим, ячейка) */
    IPRADIO_EV_NET_PRESET_PRESSED,/**< включить интернетную ячейку из любого
                                       режима, arg = номер ячейки           */
    IPRADIO_EV_TUNE_DELTA,        /**< поворот регулятора 1, arg = ±шаги      */
    /* Внимание: TUNE_DELTA - это ПЕРЕБОР СТАНЦИЙ, а не перестройка
     * частоты. Так задано в §6.1: на экране воспроизведения регулятор 1
     * перебирает сохранённое, в обоих режимах.
     *
     * Плавная перестройка живёт только на экране настройки эфира
     * и ходит отдельным событием. Разводить их обязательно: иначе
     * один поворот значил бы разное в зависимости от того, что сейчас
     * на экране, а автомат про экраны не знает и знать не должен. */
    IPRADIO_EV_FREQ_DELTA,        /**< перестройка частоты, arg = ±шаги     */
    IPRADIO_EV_BAND_TOGGLE,       /**< сменить диапазон: УКВ ↔ FM           */
    IPRADIO_EV_SELECT,            /**< короткое нажатие регулятора 1          */
    IPRADIO_EV_MENU,              /**< долгое нажатие регулятора 1            */
    IPRADIO_EV_POWER,             /**< кнопка питания                       */

    /* От железа и сети */
    IPRADIO_EV_RDS_UPDATE,        /**< пришло имя станции из RDS            */
    IPRADIO_EV_ICY_UPDATE,        /**< пришли метаданные потока             */
    IPRADIO_EV_NET_STATE,         /**< arg = ipradio_net_state_t            */
    IPRADIO_EV_PLAY_STATE,        /**< arg = ipradio_play_state_t           */
    IPRADIO_EV_SIGNAL_LEVEL,      /**< arg = 0…100                          */
    IPRADIO_EV_BUFFER_FILL,       /**< arg = 0…100                          */
    IPRADIO_EV_BITRATE,           /**< arg = кбит/с, из декодера            */

    /* Служебное */
    IPRADIO_EV_TICK,              /**< раз в секунду: часы, ждущий режим    */
} ipradio_event_type_t;

/** Режим и ячейка в одном arg - для IPRADIO_EV_PRESET_EDITED.
 *
 *  Банки у режимов свои, и номер ячейки без режима ничего не значит:
 *  третья эфирная и третья интернетная - разные станции. Править
 *  с экрана можно банк не того режима, в котором прибор сейчас
 *  (режим могут переключить, пока открыто меню ячейки). */
#define IPRADIO_PRESET_ARG(mode, cell) \
    ((int32_t) ((((int32_t) (mode)) << 8) | ((int32_t) (cell) & 0xFF)))

typedef struct {
    ipradio_event_type_t type;
    int32_t              arg;
    const char          *text;    /**< для RDS и ICY; копируется автоматом  */
} ipradio_event_t;

/* ------------------------------------------------------------------ *
 *  Интерфейс
 * ------------------------------------------------------------------ */

/** Поднять автомат и его задачу. Вызывать один раз при старте. */
esp_err_t ipradio_state_init(void);

/** Отправить событие. Можно звать из любой задачи и из обработчика
 *  прерывания (в последнем случае — из нижней половины, не из ISR). */
esp_err_t ipradio_post(const ipradio_event_t *ev);

/** Короткая форма для событий без текста. */
esp_err_t ipradio_post_simple(ipradio_event_type_t type, int32_t arg);

/** Получить копию текущего состояния. Безопасно из любой задачи. */
void ipradio_get(ipradio_snapshot_t *out);

/** Подписка на изменения: вызывается после каждого применённого события.
 *  Обработчик исполняется в контексте задачи автомата, поэтому должен
 *  быть коротким — обычно он просто будит задачу интерфейса. */
typedef void (*ipradio_observer_t)(const ipradio_snapshot_t *snap, void *ctx);

esp_err_t ipradio_subscribe(ipradio_observer_t cb, void *ctx);

/* ------------------------------------------------------------------ *
 *  Модальный перехват
 * ------------------------------------------------------------------ */

/** Фильтр событий: вызывается ДО их применения. Вернул true - событие
 *  считается израсходованным и до автомата не доходит.
 *
 *  Нужен ровно для одного: пока на экране висит диалог, регулятор 1
 *  должен переставлять выделение в нём, а не перебирать станции.
 *  Требование R4.1 - любой сценарий проходим физическими органами,
 *  а значит и диалог тоже.
 *
 *  Почему фильтр, а не состояние «в диалоге» внутри автомата: автомат
 *  не должен знать про экраны. Он знает про радио. Кто и что рисует -
 *  дело интерфейса, и перехват принадлежит ему же.
 *
 *  Вызывается в задаче автомата. Отрисовывать из него нельзя: LVGL
 *  живёт в своей задаче, см. правило 1 в ipradio_ui.c. */
typedef bool (*ipradio_event_filter_t)(const ipradio_event_t *ev, void *ctx);

/** Поставить фильтр или снять его (cb = NULL). */
void ipradio_set_event_filter(ipradio_event_filter_t cb, void *ctx);

#ifdef __cplusplus
}
#endif
