Spok1978/hybrid-radio/firmware/main/ipradio_audio.c

/*
 * ipradio_audio.c — звуковой тракт: усилитель, приглушение, громкость.
 *
 * Разделение обязанностей, которое стоит держать в голове:
 *
 *   автомат   — хранит ОДНО логическое значение громкости 0…100
 *               и флаг mute, ничего не знает про железо;
 *   этот файл — переводит их в действия: для эфира это регистр
 *               тюнера, для интернета — регулятор в конвейере ADF;
 *   железо    — пассивный сумматор на резисторах, про который
 *               прошивка не знает вовсе.
 *
 * Из-за пассивного сумматора неактивный источник обязан быть заглушён
 * ПО-НАСТОЯЩЕМУ, иначе его шум слышен всегда (docs/04-audio-path.md).
 *
 * ------------------------------------------------------------------
 * Чего здесь больше нет, и почему
 * ------------------------------------------------------------------
 *
 * Раньше этот файл сам поднимал контроллер I²S, сам писал в него
 * отсчёты и сам масштабировал их таблицей множителей. Всё это удалено,
 * и не ради стройности: оно ЛОМАЛО интернет-радио.
 *
 * `i2s_new_channel(I2S_NUM_AUTO, …)` забирал первый свободный
 * контроллер, то есть нулевой. А `i2s_stream` из ESP-ADF просит
 * именно `I2S_NUM_0` — это зашито в `I2S_STREAM_CFG_DEFAULT()`.
 * Тракт поднимается раньше конвейера, значит порт оказывался занят,
 * и до ЦАП конвейер не доходил вовсе.
 *
 * Комментарий, которым это когда-то оправдывалось — «нулевой занят
 * кодеком платы» — был неверен: кодек платы мы не инициализируем,
 * нулевой свободен, и AUTO брал ровно его.
 *
 * Теперь выходом владеет ADF целиком: и портом, и записью отсчётов,
 * и частотой дискретизации, которую он меняет по сообщению декодера.
 * Громкость интернет-потока делает элемент ALC внутри конвейера
 * (ipradio_netradio_set_volume) — тем же способом, каким устроено
 * всё остальное в тракте, а не самодельным умножением в обход.
 */

#include <string.h>

#include "driver/gpio.h"
#include "esp_log.h"

#include "board_pins.h"
#include "ipradio_audio.h"
#include "ipradio_netradio.h"
#include "ipradio_tuner.h"

static const char *TAG = "audio";

/* ------------------------------------------------------------------ *
 *  Применение состояния
 * ------------------------------------------------------------------ */

esp_err_t ipradio_audio_apply(const ipradio_snapshot_t *snap)
{
    if (!snap) {
        return ESP_ERR_INVALID_ARG;
    }

    bool fm = (snap->mode == IPRADIO_MODE_FM);

    /* Эфир. Приглушение — отдельным битом, а не громкостью в ноль.
     * Когда эфир неактивен, дополнительно уводим выход в Hi-Z:
     * так тюнер почти отключается от сумматора и не шумит в него. */
    if (ipradio_tuner_present()) {
        ipradio_tuner_set_mute(!fm || snap->muted);
        ipradio_tuner_set_hiz(!fm);
        if (fm) {
            ipradio_tuner_set_volume(snap->volume);
        }
    }

    /* Интернет. Физически глушить нечего: если поток не играет,
     * на ЦАП просто ничего не идёт. Достаточно увести регулятор
     * в конвейере в тишину. */
#if IPRADIO_DEBUG_AUDIO_FLOW
    /* Печатаем ВЕСЬ расклад, а не одну громкость.
     *
     * 2026-10-05: на плате звука не было, в журнале стояло mute=1.
     * По одной этой строке нельзя было понять, кто его включил -
     * человек или несовпадение режима. Теперь видно сразу. */
    {
        static int last;
        int now = (snap->mode << 8) | (snap->play << 4) |
                  (snap->muted ? 1 : 0);
        if (now != last) {
            last = now;
            ESP_LOGW("audio", "ЗАМЕР: режим %s, состояние %d, mute %d, "
                              "ячейка %d, сеть %d",
                     fm ? "эфир" : "интернет", (int) snap->play,
                     (int) snap->muted, (int) snap->active_preset,
                     (int) snap->net);
        }
    }
#endif

    ipradio_netradio_set_volume(snap->volume, snap->muted || fm);

    /* Усилитель выключаем, только когда молчат оба источника: щелчок
     * при каждом переключении режима был бы слышнее, чем польза. */
    bool anything_audible = !snap->muted &&
                            (fm ? ipradio_tuner_present()
                                : snap->play == IPRADIO_PLAY_PLAYING);
    ipradio_audio_amp_enable(anything_audible);

    return ESP_OK;
}

/* ------------------------------------------------------------------ *
 *  Усилитель
 * ------------------------------------------------------------------ */

esp_err_t ipradio_audio_amp_enable(bool on)
{
    /* SD у TPA3118: низкий уровень переводит выходы в Hi-Z. */
    return gpio_set_level(PIN_AMP_SD, on ? 1 : 0);
}

/* ------------------------------------------------------------------ *
 *  Подъём
 * ------------------------------------------------------------------ */

esp_err_t ipradio_audio_init(void)
{
    /* Линия приглушения усилителя. Настраиваем и сразу выключаем:
     * усилитель не должен щёлкнуть при подаче питания. */
    gpio_config_t amp = {
        .pin_bit_mask = 1ULL << PIN_AMP_SD,
        .mode         = GPIO_MODE_OUTPUT,
        .pull_up_en   = GPIO_PULLUP_DISABLE,
        .pull_down_en = GPIO_PULLDOWN_ENABLE,
        .intr_type    = GPIO_INTR_DISABLE,
    };
    ESP_ERROR_CHECK(gpio_config(&amp));
    ipradio_audio_amp_enable(false);

    /* Штатный усилитель платы держим выключенным: звук идёт мимо него,
     * через наш TPA3118. Иначе получилось бы двойное усиление. */
    gpio_config_t board_pa = {
        .pin_bit_mask = 1ULL << PIN_BOARD_PA_CTRL,
        .mode         = GPIO_MODE_OUTPUT,
        .pull_up_en   = GPIO_PULLUP_DISABLE,
        .pull_down_en = GPIO_PULLDOWN_ENABLE,
        .intr_type    = GPIO_INTR_DISABLE,
    };
#if IPRADIO_USE_BOARD_CODEC
    /* ВРЕМЕННО: усилителем платы распоряжается драйвер ES8311,
     * он же его и включает. Трогать вывод отсюда нельзя - погасим
     * то, что сами же и слушаем. */
    (void) board_pa;
#else
    ESP_ERROR_CHECK(gpio_config(&board_pa));
    gpio_set_level(PIN_BOARD_PA_CTRL, 0);
#endif

    ESP_LOGI(TAG, "тракт готов: усилитель выключен, штатный PA платы тоже");
    ESP_LOGI(TAG, "  I²S поднимет конвейер ADF: BCK=GPIO%d, LRCK=GPIO%d, DIN=GPIO%d",
             PIN_I2S_BCK, PIN_I2S_LRCK, PIN_I2S_DIN);

    return ESP_OK;
}
