Spok1978/hybrid-radio/firmware/main/ipradio_storage.h

/*
 * ipradio_storage.h — хранение на карте microSD.
 *
 * Один файл — источник истины: /ipradio.json (docs/26-firmware-spec.md, §8).
 * Прошивка своя, поэтому чужой формат не поддерживается и проекция
 * не нужна — решение Q13 снято, разбор в docs/25-station-storage.md, §10.
 *
 * Правила записи, из §8 и вопроса Q14:
 *   - запись атомарная: временный файл, сброс на носитель, переименование;
 *   - две копии по очереди с контрольной суммой, потому что гарантии
 *     FATFS при обрыве питания не установлены;
 *   - при отсутствии или повреждении обеих копий создаётся дефолтная,
 *     и прибор поднимается с пустым списком, а не отказывается стартовать.
 */

#pragma once

#include <stdbool.h>
#include <stdint.h>

#include "esp_err.h"
#include "ipradio_state.h"

#ifdef __cplusplus
extern "C" {
#endif

#define IPRADIO_URL_MAX        192
#define IPRADIO_UUID_MAX       40
/* Восемь ячеек В КАЖДОМ из двух банков: эфирном и интернетном.
 *
 * Банки раздельные с 2026-09-15. Раньше банк был один, а тип лежал
 * в самой ячейке, и нажатие пресета само переключало режим. Заказчик
 * попросил разнести: эфирные пресеты работают и показываются только
 * в эфире, интернетные - только в интернете.
 *
 * Восемь, потому что столько кнопок даёт расширитель MCP23017;
 * напрямую на выводах процессора помещается лишь пять
 * (docs/30-pin-assignment.md, §«Остаётся свободным шесть выводов»).
 * До появления расширителя пять кнопок адресуют первые пять ячеек
 * ТЕКУЩЕГО режима, остальные три доступны касанием. */
#define IPRADIO_PRESET_MAX     8

/** Ячейка банка пресетов.
 *
 *  Структура одна на оба банка, хотя половина полей в каждом случае
 *  не нужна: эфирной ячейке ни к чему url и uuid, интернетной -
 *  частота. Заводить две разные структуры значило бы переписать
 *  каждое обращение к полям в семи файлах ради экономии двух
 *  килобайт - а лежит банк в PSRAM, где у нас тридцать мегабайт.
 *  Размен не в пользу разделения.
 *
 *  Поле type теперь избыточно - принадлежность задаётся тем, в каком
 *  массиве лежит ячейка. Оставлено как проверка: запись его
 *  выставляет, чтение может сверить. */
typedef struct {
    bool            used;
    ipradio_mode_t  type;
    char            name[IPRADIO_NAME_MAX];

    /* Для эфирных */
    ipradio_band_t  band;
    uint32_t        freq_khz;

    /* Для интернетных */
    char            url[IPRADIO_URL_MAX];
    char            stationuuid[IPRADIO_UUID_MAX];
} ipradio_preset_t;

/** Настройки, переживающие выключение. */
typedef struct {
    uint8_t         volume;          /**< 0…100                          */
    ipradio_mode_t  last_mode;
    ipradio_band_t  last_band;
    uint32_t        last_freq_khz;
    /* Своя последняя ячейка у КАЖДОГО режима: банки разделены,
     * и номер из эфирного банка в интернетном означает другую
     * станцию. Одно общее поле после разделения банков указывало бы
     * при переключении режима на случайную ячейку. */
    int8_t          last_preset_fm;  /**< 1…N или -1                     */
    int8_t          last_preset_net; /**< 1…N или -1                     */
    uint8_t         brightness;      /**< 0…100                          */
    char            tz[32];          /**< часовой пояс, формат POSIX TZ  */
    bool            clock_24h;
} ipradio_settings_t;

/** Всё содержимое файла. */
typedef struct {
    ipradio_settings_t settings;

    /* Два независимых банка. Индекс - номер ячейки минус один;
     * снаружи ячейки нумеруются с единицы, как на кнопках. */
    ipradio_preset_t   fm[IPRADIO_PRESET_MAX];
    ipradio_preset_t   net[IPRADIO_PRESET_MAX];
} ipradio_store_t;

/** Смонтировать карту и прочитать файл.
 *  Возвращает ESP_OK и при повреждении файла: в этом случае store
 *  заполняется умолчаниями, а в журнал уходит предупреждение.
 *  ESP_ERR_NOT_FOUND означает, что карты нет вовсе. */
esp_err_t ipradio_storage_init(void);

/** Копия текущего содержимого. */
void ipradio_storage_get(ipradio_store_t *out);

/** Записать. Атомарно, с чередованием двух копий. */
esp_err_t ipradio_storage_save(const ipradio_store_t *in);

/** Сохранить только настройки, не трогая пресеты. */
esp_err_t ipradio_storage_save_settings(const ipradio_settings_t *s);

/** Начать правку хранилища НА МЕСТЕ.
 *
 *  Возвращает указатель на рабочую копию и удерживает замок до
 *  ipradio_storage_edit_end(). Между ними хранилище принадлежит
 *  вызывающему целиком.
 *
 *  Зачем это нужно. Раньше каждый, кому надо было изменить одну
 *  ячейку, делал так: ipradio_storage_get() в свою копию, правка,
 *  ipradio_storage_save() целиком. Замок при этом брался ДВАЖДЫ,
 *  и между чтением и записью успевала вклиниться другая задача -
 *  её правка терялась молча. Писателей пять, и сидят они в разных
 *  задачах: автомат, экран станций, поиск по каталогу, проход
 *  по диапазону.
 *
 *  Побочная выгода: пропадает копия хранилища на стеке. Те самые
 *  2548 байт, из-за которых прибор трижды уходил в перезагрузку
 *  из обработчиков касания.
 *
 *  Возвращает NULL, если хранилище ещё не поднято; тогда end()
 *  звать НЕ надо. */
ipradio_store_t *ipradio_storage_edit_begin(void);

/** Закончить правку. save = записать на карту, иначе просто
 *  отпустить замок (тогда правки останутся только в памяти -
 *  так делают, когда менять ничего не пришлось). */
esp_err_t ipradio_storage_edit_end(bool save);

/** Есть ли карта и читается ли она. */
bool ipradio_storage_ready(void);

/** Номер поколения содержимого: растёт при каждой удачной записи.
 *
 *  Нужен тому, кто показывает банк на экране. Перечитывать файл
 *  на каждую перерисовку нельзя - это копия в пару килобайт под
 *  замком, десять раз в секунду. Сравнить одно число дёшево,
 *  а меняется банк редко: автопоиском, поиском по каталогу
 *  и долгим нажатием кнопки пресета. */
uint32_t ipradio_storage_generation(void);

/** Положить содержимое в память, НЕ записывая на носитель.
 *
 *  Нужно для проверок на столе, когда карты нет: без неё обычная
 *  запись отказывает целиком, и прибор нечем наполнить — ни станцией,
 *  ни настройкой. Между включениями такое, разумеется, не переживает. */
void ipradio_storage_put_ram(const ipradio_store_t *in);

/* Выборочное чтение. Целая структура банка занимает около 2,5 КБ,
 * и класть её на стек ради одного поля - непозволительно дорого:
 * на этом переполнился стек задачи автомата (4 КБ) при первом же
 * нажатии пресета. Ячейка стоит около 300 байт, настройки - меньше
 * сотни.
 *
 * Полную копию берут только те, кому она правда нужна: перебор
 * ячеек и запись. */

/** Одна ячейка банка, cell = 1…IPRADIO_PRESET_MAX.
 *
 *  Банк выбирается режимом: у эфира и интернета они разные и
 *  независимые. Возвращает false, если номер вне диапазона или
 *  ячейка пуста.
 *
 *  Берём именно одну ячейку, а не весь банк: полная копия - 2548
 *  байт, и на стеке задачи она не помещается. */
bool ipradio_storage_get_preset(ipradio_mode_t mode, int cell,
                                ipradio_preset_t *out);

/** Банк по режиму. Указатель внутрь рабочей копии; звать только
 *  между edit_begin() и edit_end(), иначе получите гонку. */
static inline ipradio_preset_t *ipradio_storage_bank(ipradio_store_t *st,
                                                     ipradio_mode_t mode)
{
    return (mode == IPRADIO_MODE_NET) ? st->net : st->fm;
}

/** Только настройки. */
void ipradio_storage_get_settings(ipradio_settings_t *out);

#ifdef __cplusplus
}
#endif
