Spok1978/hybrid-radio/firmware/main/ipradio_fonts.h

/*
 * ipradio_fonts.h — шрифты интерфейса с кириллицей.
 *
 * Почему не встроенные шрифты LVGL. Montserrat, который идёт в поставке,
 * собран под ASCII: кириллицы в нём нет ни в одном кегле. Достроить её
 * штатным путём мешает то, что конвертер шрифтов LVGL написан на Node.js,
 * а его на машине сборки нет.
 *
 * Решение: рендерить TTF прямо на плате. LVGL это умеет — lv_tiny_ttf,
 * сборка на stb_truetype. Шрифт лежит в образе файлом, урезанный до
 * латиницы с кириллицей (tools/subset_font.py): 756 КБ исходного
 * DejaVu Sans превращаются в 52 КБ.
 *
 * Побочная выгода важнее исходной задачи: кегль задаётся во время
 * работы. Двенадцать экранов из docs/28-screen-mockups.md пользуются
 * шестью кеглями, и ни под один не надо собирать отдельную таблицу
 * глифов — тот же файл обслуживает все.
 *
 * Кегли ровно те, что были у Montserrat, чтобы вёрстка не поехала.
 * DejaVu шире Montserrat при одном кегле, поэтому места под длинные
 * названия станций стало меньше — LVGL обрезает их многоточием,
 * знак U+2026 в урезанный шрифт включён намеренно.
 */

#pragma once

#include "esp_err.h"
#include "lvgl.h"

#ifdef __cplusplus
extern "C" {
#endif

/** Создать шрифты. Звать из задачи LVGL до постройки экранов.
 *  До вызова все указатели ниже равны NULL. */
esp_err_t ipradio_fonts_init(void);

/* Обычное начертание. */
extern const lv_font_t *ipradio_font_14;   /* подписи, полоса подсказок */
extern const lv_font_t *ipradio_font_16;   /* названия пресетов, громкость */
extern const lv_font_t *ipradio_font_20;   /* часы */
extern const lv_font_t *ipradio_font_22;   /* значок «звук выключен» */
extern const lv_font_t *ipradio_font_28;   /* подзаголовок: диапазон, поток */

/* Полужирное — только крупный кегль: то, что читается через комнату. */
extern const lv_font_t *ipradio_font_48b;  /* частота и название станции */

/* Крупный набор для главного экрана.
 *
 * Заказчик посмотрел на прибор вживую 2026-08-30: пятидюймовая панель
 * 1280x720 стоит в комнате, и то, что на макете выглядело соразмерно,
 * на столе оказалось мелким и потерянным в пустоте. Всё, что читают
 * с расстояния, увеличено вдвое.
 *
 * Даром это не обходится: Tiny TTF рисует глифы во время работы,
 * и кегль 96 стоит примерно вчетверо больше кегля 48 по памяти кэша.
 * Запас есть - LVGL теперь берёт из общей кучи, где 30 МБ PSRAM. */
extern const lv_font_t *ipradio_font_28b;  /* подписи крупно     */
extern const lv_font_t *ipradio_font_40;   /* часы, громкость    */
extern const lv_font_t *ipradio_font_56;   /* диапазон, строка   */
extern const lv_font_t *ipradio_font_64b;  /* название станции   */
extern const lv_font_t *ipradio_font_96b;  /* частота во всю ширь */

/* Ждущий экран. Его читают с другого конца комнаты, поэтому
 * кегли здесь свои и заметно крупнее всего остального. */
extern const lv_font_t *ipradio_font_44;   /* что играет        */
extern const lv_font_t *ipradio_font_60;   /* дата и день недели */
extern const lv_font_t *ipradio_font_144b; /* часы               */

#ifdef __cplusplus
}
#endif
