Spok1978/hybrid-radio/firmware/main/ipradio_watchdog.h

/*
 * ipradio_watchdog.h — надзор за долгоживущими задачами прошивки.
 *
 * Зачем модуль. Штатный сторож задач (TWDT) в конфигурации включён,
 * но следит только за задачами простоя обоих ядер: зависание системы
 * целиком он поймает, а зависание одной нашей задачи — нет, потому
 * что простаивающие задачи продолжат исправно отмечаться, и сторож
 * промолчит. Зависшая задача для человека выглядит как молча
 * отказавшая функция прибора, поэтому требование — перезагрузка,
 * а не предупреждение в журнале.
 *
 * Почему задачи не подписаны на TWDT напрямую. Три причины:
 *
 *   1. У TWDT один таймаут на всех подписанных (сейчас 5 с), а у
 *      задач прошивки разные бюджеты молчания: опрос органов живёт
 *      с периодом 5 мс, обработчик событий интернет-радио просыпается
 *      раз в полсекунды, и подогнать их под одно значение нельзя.
 *   2. TWDT не умеет отличить «задача ждёт очередь» от «задача
 *      крутится в цикле». Задача автомата блокируется на очереди
 *      без таймаута и в исправном приборе молчит, пока нечего
 *      делать; наивная подписка перезагружала бы здоровый прибор.
 *   3. CONFIG_ESP_TASK_WDT_PANIC выключен: при срабатывании сторож
 *      только печатает предупреждение и работа продолжается, а
 *      требуется перезагрузка.
 *
 * Поэтому устроено так. Наблюдаемые задачи сами регистрируются
 * в модуле при старте и отмечаются в своём цикле вызовом
 * ipradio_watchdog_feed(). Задача-надзиратель — единственная,
 * кто подписан на штатный TWDT, — раз в 250 мс проверяет свежесть
 * всех отметок; задача, промолчавшая дольше своего лимита, получает
 * контрольную проверку, и если молчание подтвердилось, прибор уходит
 * в перезагрузку через esp_restart() с именем виновника в журнале.
 * Это и есть наше «срабатывание сторожа»: осмысленная строка в логе
 * и перезагрузка вместо молчаливого предупреждения.
 *
 * Для задачи автомата предусмотрен флаг IPRADIO_WDT_F_BLOCKED_OK:
 * молчание дольше лимита не считается зависанием, если задача
 * заблокирована в ожидании. Отличить «ждёт» от «крутится» надзиратель
 * может по состоянию задачи в планировщике — это единственный способ
 * наблюдать за задачей, которая исправно молчит, пока нет событий.
 *
 * Разовые задачи (поиск сетей, поиск станций, проход по диапазону,
 * выключение) под надзор не берутся: они живут секунды, блокируются
 * внутри чужих вызовов (сканирование Wi-Fi, HTTP), где отметиться
 * нельзя, и их зависание оставляет зомби, но не останавливает прибор.
 * Подписка с парой «подписать/отписать» на каждый запуск добавила
 * бы гонок без выигрыша в надёжности.
 *
 * Глубокий сон. Задача выключения заканчивается esp_deep_sleep_start(),
 * который останавливает все задачи и таймеры; сторож в глубоком сне
 * не работает, а пробуждение — это холодный старт, где всё поднимается
 * заново. Окно между последней отметкой любой задачи и сном — доли
 * секунды, лимиты молчания — секунды, ложного срабатывания нет.
 * Предпринимать ничего не нужно.
 *
 * Проверки на плате не было: её пока нет ни у нас, ни у заказчика.
 * Модуль опирается на документированное поведение FreeRTOS и ESP-IDF;
 * место, которое стоит перепроверить при первом прогоне на железе,
 * помечено в ipradio_watchdog.c.
 */

#pragma once

#include <stdint.h>

#include "esp_err.h"

#ifdef __cplusplus
extern "C" {
#endif

/** Флаг регистрации: молчание в заблокированном состоянии — норма.
 *  Для задач, которые ждут очередь без таймаута: надзиратель при
 *  просрочке отметки посмотрит на состояние задачи и засчитает
 *  блокировку как признак жизни, а «крутится» — как зависание. */
#define IPRADIO_WDT_F_BLOCKED_OK   (1U << 0)

/** Поднять надзор. Вызывать из app_main ПЕРВЫМ, до остальных
 *  модулей: задачи регистрируются в модуле сами при своём старте,
 *  значит таблица регистрации должна существовать раньше первой
 *  задачи. Сам надзиратель при пустой таблице просто отмечается
 *  у сторожа и спит, ранняя инициализация ему не вредит. */
esp_err_t ipradio_watchdog_init(void);

/** Поставить задачу под надзор. Вызывать ИЗ САМОЙ наблюдаемой
 *  задачи при её старте: дескриптор снимается с текущей задачи.
 *
 *  @param name      имя для журнала; указатель не копируется,
 *                   поэтому только строковый литерал;
 *  @param quiet_ms  сколько миллисекунд задача может не отмечаться,
 *                   прежде чем её заподозрят; считать от худшего
 *                  законного периода с запасом в разы;
 *  @param flags     0 или IPRADIO_WDT_F_BLOCKED_OK;
 *  @return номер под наблюдением для feed(), или -1, если таблица
 *          полна (задача останется без надзора, об этом скажет лог). */
int ipradio_watchdog_register(const char *name, uint32_t quiet_ms,
                              uint32_t flags);

/** Отметка «жив». Вызывать в цикле задачи на каждом витке, где
 *  задача доказала свою исправность. Дёшево: одна запись слова. */
void ipradio_watchdog_feed(int id);

#ifdef __cplusplus
}
#endif
