Spok1978/hybrid-radio/firmware/main/ipradio_input.h

/*
 * ipradio_input.h — регуляторы и кнопки.
 *
 * Единственный модуль, который превращает действия человека в события
 * автомата. Требования — docs/26-firmware-spec.md, §6.1, и R4.1:
 * любой сценарий проходим физическими органами, без касания экрана.
 *
 * Различает короткое, двойное и длинное нажатие. Тайминги — из §6.1,
 * вынесены в board_pins.h и уточняются на макете.
 */

#pragma once

#include "esp_err.h"
#include "driver/i2c_master.h"

#ifdef __cplusplus
extern "C" {
#endif

/** Поднять опрос органов управления и его задачу.
 *  Вызывать ПОСЛЕ ipradio_state_init(): модуль сразу начнёт слать
 *  события в автомат.
 *
 *  bus - шина I²C платы: на ней расширитель MCP23017 с кнопками
 *  пресетов и MODE (IPRADIO_USE_IO_EXPANDER). Может быть NULL - тогда
 *  работают только кнопки и регуляторы на выводах самого ESP32. */
esp_err_t ipradio_input_init(i2c_master_bus_handle_t bus);

/** Сколько миллисекунд прошло с последнего действия человека.
 *  Нужно ждущему режиму: вход через три минуты бездействия (§5.4). */
uint32_t ipradio_input_idle_ms(void);

/** Отметить действие человека, пришедшее не от кнопок.
 *
 *  Счёт бездействия вёлся только по кнопкам и регуляторам, то есть
 *  по обвязке, которой пока нет вовсе. Касание экрана действием
 *  не считалось: ждущий режим включался бы прямо под рукой, а
 *  пальцем не убирался. Зовёт задача интерфейса, увидев нажатие. */
void ipradio_input_note_activity(void);

#ifdef __cplusplus
}
#endif
