Spok1978/hybrid-radio/hardware/skidl/boards.py

"""Раздел схемы на три платы (решение заказчика 2026-10-08, docs/33, §15).

Размеры — под односторонние самодельные платы: детали (с зазором 1,5 мм)
занимают ~40 % площади, остальное — под дорожки на одном слое; у площадки
усилителей ~65 % (там почти нет дорожек). Высота 70 мм — предел корпуса.

Ключ — имя подсхемы SKiDL, как оно стоит в sheetpath нетлиста.
Модуль без зависимостей: его импортируют и обычный Python, и Python KiCad.
"""

BOARDS = {
    "power": {
        "title": "IP-Radio: плата питания",
        "size": (125.0, 70.0),
        "blocks": ["power_input1", "supply_5v1", "indication_power1", "links_power1"],
        # Поток: вход 12 В и защита -> DC-DC -> выходы. Полосы (x от, x до, детали).
        "zones": [
            (0.0, 45.0, ["J1", "F1", "D2", "Q1", "D1", "R1", "J13"]),
            (45.0, 90.0, ["U1", "D3", "R20"]),
            # Под USB-A (он занимает y 0…15,3) и левее клеммника J14.
            (96.0, 113.0, ["R2", "R3", "C3", "D4", "R21", "TP1", "TP2", "TP3"], 17.0, 70.0),
        ],
        # Разъёмы у краёв (решение заказчика 2026-10-08, вариант 2):
        # J2 USB-A повёрнут на 180°, гнездо упирается в верхний край
        # (по посадочному месту Molex 67643 фланец гнезда на +12,99 мм от
        # выводов -> после поворота начало на y = 12,99); корпус x 95…109,4,
        # левее отверстия H2. J14 вертикально у правого края ниже H2:
        # выводы x = 119,4, y 14…24,2; корпус до x = 124 (по F.Fab −5,32…4,6).
        # Конденсаторы DC-DC — к выводам модуля (руководство §4.7: входной
        # керамический вплотную к VIN; §4.5: меньший номинал ближе). C1 —
        # объёмный на входе DC-DC; амперы на усилители идут через J13 мимо.
        "near": [
            ("C2", "U1", ["1"]),             # SY8205 VIN, 100 нФ
            ("C5", "U1", ["3"]),             # SY8205 VOUT, 100 нФ
            ("C1", "U1", ["1"]),             # VIN, 470 мкФ
            ("C4", "U1", ["3"]),             # VOUT, 470 мкФ
        ],
        "fixed": {
            "J2": (105.7, 12.99, 180.0),
            "J14": (119.4, 24.16, 90.0),
        },
    },
    "signal": {
        "title": "IP-Radio: сигнальная плата",
        # Двусторонняя (решение заказчика 2026-10-08): на одном слое оставалось
        # 50 неразведённых связей — порядок выводов шлейфа P4 не совпадает с
        # порядком модулей и площадок.
        "layers": 2,
        "size": (230.0, 70.0),
        "blocks": ["ribbon1", "expander1", "controls1", "amp_mute1", "dac1",
                   "supply_3v3_tuner1", "tuner1", "mixer_channel1", "mixer_channel2",
                   "indication_signal1", "links_signal1"],
        # Поток слева направо: шлейф P4 и цифра -> ЦАП -> микшер -> тюнер.
        # Тюнер с антенной у правого края, дальше всего от шлейфа с I2S.
        "fixed": {
            # Вилка шлейфа вдоль верхнего края, но в 6 мм от него: внешний ряд
            # из 20 выводов выходит только вверх (между выводами 2,54 дорожка
            # 0,6 с зазорами 0,4 не проходит), при 1 мм туда влезали 2 дорожки
            # и 6-7 связей к J3 оставались неразведёнными (2026-10-08).
            "J3": ("top", 40.0, 90.0, 6.0),
            "J15": ("top", 100.0, 180.0),    # 5 В с платы питания, вход провода вверх
            "J4": ("right", 20.0, 90.0),     # антенна, вход провода вправо
            "J16": ("right", 50.0, 90.0),    # провода к усилителям
            "J9": ("bottom", 60.0, 0.0),     # энкодер 1
            "J10": ("bottom", 85.0, 0.0),    # энкодер 2
            "J11": ("bottom", 105.0, 0.0),   # кнопка питания
            "J7": ("bottom", 125.0, 0.0),    # пресеты 1-4
            "J12": ("bottom", 150.0, 0.0),   # пресеты 5-8 и MODE
            "J8": ("bottom", 175.0, 0.0),    # резерв
        },
        # Развязка вплотную к выводу питания своей микросхемы (руководство
        # разводки §4.5, §6.1 п.4): ставится после зон, в ближайшее свободное
        # место у вывода. Порядок важен: 100 нФ — первыми и ближе, 10 мкФ —
        # за ними. (конденсатор, микросхема, выводы питания).
        "near": [
            ("C27", "U3", ["5"]),            # RRD-102 VCC
            ("C13", "U4", ["1"]),            # GY-PCM5102A VIN (+5V)
            ("C22", "U5", ["10", "11"]),     # MCP23017-CJMCU VCC
            ("C7", "U2", ["2"]),             # HT7333 VIN, 100 нФ
            ("C9", "U2", ["3"]),             # HT7333 VOUT, 100 нФ
            ("C6", "U2", ["2"]),             # HT7333 VIN, 10 мкФ
            ("C8", "U2", ["3"]),             # HT7333 VOUT, 10 мкФ
        ],
        "zones": [
            (10.0, 58.0, ["U5", "R16", "R17", "R18", "R19", "C23", "C24", "C25", "C26"], 18.0, 58.0),
            (58.0, 112.0, ["U4", "R4", "R5", "R6", "R13", "R14", "R15", "TP5", "TP8"], 18.0, 58.0),
            (112.0, 162.0, ["R7", "R8", "R9", "RV1", "C14", "C15", "R10", "R11", "R12", "RV2",
                            "C18", "C19", "TP6", "TP7"], 14.0, 58.0),
            (162.0, 212.0, ["U3", "C10", "C11", "C12", "U2", "L1", "FB1", "FB2", "TP4"], 0.0, 58.0),
        ],
    },
    "amp": {
        "title": "IP-Radio: площадка усилителей",
        "size": (150.0, 70.0),
        "blocks": ["amp_channel1", "amp_channel2", "links_amp1"],
    },
}


def layers_of(board):
    """1 — односторонняя (медь только B.Cu), 2 — двусторонняя."""
    return BOARDS[board].get("layers", 1)


def board_of(block):
    for name, b in BOARDS.items():
        if block in b["blocks"]:
            return name
    raise KeyError(f"подсхема {block} не отнесена ни к одной плате (boards.py)")
