Spok1978/hybrid-radio/firmware/main/ipradio_mem.h

/*
 * ipradio_mem.h — политика памяти и наблюдение за ней.
 *
 * Внутренней памяти у ESP32-P4 мало, и делят её те, кому без неё
 * нельзя: драйвер связи с сопроцессором Wi-Fi, DMA звука и карты,
 * стеки задач. Всё, что может жить в PSRAM (32 МБ), должно жить там.
 * Разбор с замерами и что из чужих советов принято, а что нет, -
 * docs/34-memory.md.
 */

#pragma once

#include <stdint.h>

#ifdef __cplusplus
extern "C" {
#endif

/** Зовётся первой строкой app_main: до самопроверки и до чтения карты,
 *  потому что обе разбирают JSON. */
void ipradio_mem_init(void);

/** Сколько раз с начала работы не удалось выделить память - по всем
 *  кучам, всеми задачами. Выводится в «пульсе». */
uint32_t ipradio_mem_failed_count(void);

/** Сколько выделений сделал cJSON с начала работы. Для замера:
 *  разница до и после поиска - столько стоит один ответ каталога. */
uint32_t ipradio_mem_json_allocs(void);

#ifdef __cplusplus
}
#endif
