Spok1978/hybrid-radio/firmware/main/ipradio_preset_edit.h

/*
 * ipradio_preset_edit.h — правка ячеек банка: имя, очистка, запись
 * интернет-станции.
 *
 * Зачем отдельный модуль. Ячейки правят три экрана: список станций,
 * поиск по каталогу и меню долгого нажатия на ячейку. До 2026-10-06
 * каждый делал это сам, и последовательность «взять замок, найти
 * ячейку, поправить, записать, отпустить» была написана в каждом
 * заново. В поиске она была с ошибкой: при полном банке функция
 * возвращалась, не отпустив замок, и следующее же обращение
 * к хранилищу из любой задачи вставало навсегда.
 *
 * Здесь нет LVGL, поэтому модуль собирается и на машине разработчика
 * (tests/host) и проверяется там с поддельным хранилищем, которое
 * следит, отпущен ли замок после каждого вызова.
 *
 * Номера ячеек везде 1…IPRADIO_PRESET_MAX, как на кнопках и в событиях
 * автомата.
 */

#pragma once

#include <stdbool.h>

#include "ipradio_state.h"
#include "ipradio_storage.h"

#ifdef __cplusplus
extern "C" {
#endif

/** Итог правки. Экрану нужно различать случаи, потому что человеку
 *  о них говорится по-разному. */
typedef enum {
    IPRADIO_PEDIT_OK = 0,
    IPRADIO_PEDIT_BAD_ARG,       /**< номер вне банка, пустой адрес          */
    IPRADIO_PEDIT_NO_CARD,       /**< карты нет: записать некуда, не менялось */
    IPRADIO_PEDIT_EMPTY,         /**< ячейка свободна, править нечего        */
    IPRADIO_PEDIT_FULL,          /**< свободных ячеек нет                    */
    IPRADIO_PEDIT_WRITE_FAILED,  /**< в памяти поправлено, на карту не легло */
} ipradio_pedit_t;

/** Переименовать занятую ячейку. Пробелы по краям срезаются; пустое
 *  имя допустимо — экран тогда покажет частоту или «без названия».
 *  Если имя не изменилось, на карту ничего не пишется. */
ipradio_pedit_t ipradio_preset_rename(ipradio_mode_t mode, int cell,
                                      const char *name);

/** Освободить ячейку. Свободную освобождать нечего — IPRADIO_PEDIT_EMPTY. */
ipradio_pedit_t ipradio_preset_clear(ipradio_mode_t mode, int cell);

/** Записать интернет-станцию в интернетный банк.
 *
 *  @param cell      1…N — именно в эту ячейку, что бы в ней ни было
 *                   (замена из меню ячейки);
 *                   0 — туда, где станция с тем же адресом уже есть,
 *                   иначе в первую свободную (обычный поиск).
 *  @param out_cell  куда легла станция, 1…N. Может быть NULL.
 *
 *  Станция, которая уже есть в банке, при cell = 0 второй раз
 *  не заводится: возвращается её ячейка, на карту ничего не пишется. */
ipradio_pedit_t ipradio_preset_put_net(int cell, const char *name,
                                       const char *url, const char *uuid,
                                       int *out_cell);

#ifdef __cplusplus
}
#endif
