Spok1978/hybrid-radio/firmware/main/ipradio_soak.h

/*
 * ipradio_soak.h — прогон на выносливость: прибор сам переключает
 * интернет-станции.
 *
 * Только для проверки на столе, ключ IPRADIO_DEBUG_SOAK в board_pins.h.
 * Повторяет то, на чём прибор падал 2026-10-05: переключение станций
 * подряд, а каждый пятый раз ещё и поиск в каталоге - там рукопожатие
 * TLS и разбор JSON, главные потребители памяти. Человеку при этом
 * нажимать ничего не надо, и прогоны «до» и «после» правки получаются
 * одинаковыми.
 *
 * Ход виден в журнале по строкам «ПРОГОН» и «ПУЛЬС».
 */

#pragma once

#ifdef __cplusplus
extern "C" {
#endif

/** Запустить прогон в своей задаче. Ждёт сеть сам. */
void ipradio_soak_start(void);

#ifdef __cplusplus
}
#endif
