Spok1978/hybrid-radio/firmware/main/ipradio_store_format.h

/*
 * ipradio_store_format.h — формат файла хранилища.
 *
 * Разбор и печать содержимого, без единого обращения к карте памяти.
 * Вынесено из ipradio_storage.c, чтобы формат можно было проверять
 * самопроверкой (ipradio_selftest.c): она гоняет печать и разбор
 * в памяти и сверяет результат, ничего не монтируя.
 *
 * ФОРМАТ ФАЙЛА
 *
 *   {"crc":"xxxxxxxx","payload":{ …полезная часть… }}
 *
 * Сумма считается от того же текста полезной части, что уходит
 * в файл. Полезная часть - объект, а не строка: раньше она клалась
 * строкой с экранированием, и файл раздувался вдвое.
 *
 * Внутри полезной части:
 *
 *   generation    - номер записи, растёт при каждом сохранении;
 *   settings      - настройки;
 *   presets_fm    - эфирный банк, IPRADIO_PRESET_MAX ячеек;
 *   presets_net   - интернетный банк, столько же.
 *
 * СТАРЫЕ ОБРАЗЦЫ, которые надо продолжать читать:
 *
 *   payload строкой         - до 2026-09-06;
 *   один массив "presets"   - до 2026-09-15, тип лежал в ячейке;
 *   одно поле "last_preset" - до 2026-09-15, общее на оба режима;
 *   ячейка без поля "used"  - самые ранние файлы.
 */

#pragma once

#include <stdbool.h>
#include <stdint.h>

#include "ipradio_storage.h"

#ifdef __cplusplus
extern "C" {
#endif

/** Заполнить умолчаниями. Зовётся и перед разбором: то, чего нет
 *  в файле, останется умолчанием, а не мусором. */
void ipradio_store_fill_defaults(ipradio_store_t *st);

/** Контрольная сумма текста, FNV-1a.
 *
 *  Нам надо отличить целый файл от обрезанного, а не защититься
 *  от подделки, поэтому коротко и без таблиц. */
uint32_t ipradio_store_crc(const char *s);

/** Разобрать документ целиком: проверить сумму, вынуть содержимое.
 *
 *  Возвращает false, если текст не разобрался или сумма не сошлась.
 *  Понимает все старые образцы, перечисленные в шапке файла. */
bool ipradio_store_parse(const char *text, ipradio_store_t *st,
                         uint32_t *generation);

/** Напечатать полезную часть. Строку освобождает вызывающий. */
char *ipradio_store_build(const ipradio_store_t *st, uint32_t generation);

#ifdef __cplusplus
}
#endif
