Spok1978/hybrid-radio/firmware/main/ipradio_board_codec.h

/*
 * ipradio_board_codec.h — ВРЕМЕННО: звук через штатный кодек платы.
 *
 * ЗАЧЕМ ЭТО ЕСТЬ
 *
 * По замыслу звук идёт мимо платы: ЦАП PCM5102A на выводах 46/47/48,
 * дальше свой усилитель TPA3118 (docs/30, §звуковой тракт). Ни ЦАП,
 * ни усилитель пока не подключены, и услышать проигрывание нечем -
 * а убедиться, что интернет-радио действительно играет, надо.
 *
 * У платы Waveshare есть собственный тракт: кодек ES8311 на выводах
 * 9-13, усилитель NS4150B и разъём динамика GH1.25 (позиция 13 в
 * описании платы, динамик 8 Ом 2 Вт). Он полностью исправен, мы его
 * просто не используем: ipradio_audio.c держит вывод 53 в нуле,
 * чтобы не было двойного усиления.
 *
 * Этот модуль временно включает штатный тракт, чтобы можно было
 * послушать. УБРАТЬ, когда подключим свой ЦАП.
 *
 * ПОЧЕМУ НЕ audio_board_init() ИЗ ESP-ADF
 *
 * У ADF есть готовая поддержка ровно этой платы
 * (esp32_p4_function_ev_board), и выводы там совпадают с нашими
 * один в один. Но её audio_board_init() поднимает шину I²C через
 * СТАРЫЙ драйвер (i2c_param_config + i2c_driver_install,
 * esp_peripherals/driver/i2c_bus/i2c_bus.c:74), а панель и касание
 * работают через новый (i2c_new_master_bus, app_main.c:128).
 * Один порт двумя драйверами занять нельзя - отвалилось бы касание.
 *
 * Поэтому кодек настраивается напрямую через esp_codec_dev: его
 * драйвер ES8311 умеет принимать готовую ручку шины нового драйвера
 * (audio_codec_i2c_cfg_t.bus_handle). Данные при этом по-прежнему
 * гонит конвейер ADF - мы трогаем только настройку микросхемы.
 */

#pragma once

#include "driver/i2c_master.h"
#include "esp_err.h"

#ifdef __cplusplus
extern "C" {
#endif

/** Поднять кодек платы и включить её усилитель.
 *
 *  @param bus  шина I²C, уже созданная в app_main. */
esp_err_t ipradio_board_codec_init(i2c_master_bus_handle_t bus);

/** Сообщить кодеку параметры потока.
 *
 *  Звать, когда декодер доложил формат: частота у станций разная,
 *  и кодек должен знать ту же, что и I²S, иначе звук поедет по темпу. */
esp_err_t ipradio_board_codec_set_format(int sample_rate, int bits, int channels);

#ifdef __cplusplus
}
#endif
