Spok1978/hybrid-radio/firmware/main/ipradio_audio.h

/*
 * ipradio_audio.h — звуковой тракт.
 *
 * Схема принята в docs/26-firmware-spec.md, §2.5, вариант C:
 * свой ЦАП PCM5102A на выводах гребёнки, штатный кодек платы
 * и её усилитель не используются.
 *
 * Почему не штатный кодек: у ES8311 аналоговый вход наружу
 * не разведён (выводы 17 и 18 ни к чему не подключены), а линия
 * записи на общей шине I²S занята микрофонным ES7210. Завести
 * эфир внутрь нечем.
 *
 * Три линии вместо четырёх: SCK у PCM5102A сажается на землю,
 * внутренняя ФАПЧ получает тактирование из BCK (даташит TI).
 *
 * Эфир подмешивается ПАССИВНО, резисторами, уже после ЦАП —
 * см. docs/04-audio-path.md. Прошивка про сумматор не знает;
 * её дело — глушить неактивный источник по-настоящему.
 */

#pragma once

#include <stdbool.h>
#include <stdint.h>

#include "esp_err.h"
#include "ipradio_state.h"

#ifdef __cplusplus
extern "C" {
#endif

/* ------------------------------------------------------------------
 * ЧЕМ ЭТОТ МОДУЛЬ БОЛЬШЕ НЕ ЗАНИМАЕТСЯ
 * ------------------------------------------------------------------
 * Контроллером I²S владеет конвейер ADF, а не мы. Раньше владели
 * оба сразу, и это ломало интернет-радио: наш вызов брал первый
 * свободный контроллер, то есть нулевой, а i2s_stream из ADF просит
 * именно нулевой — он зашит в I2S_STREAM_CFG_DEFAULT(). Поскольку
 * тракт поднимается раньше конвейера, порт оказывался занят,
 * и до ЦАП конвейер не доходил вовсе.
 *
 * Вместе с портом ушли отсюда запись отсчётов, смена частоты
 * дискретизации и масштабирование громкости: всё это ADF делает сам,
 * а громкость интернет-потока задаёт элемент ALC в конвейере
 * (ipradio_netradio_set_volume).
 */

/** Поднять линию приглушения усилителя и выключить штатный PA платы.
 *  Усилитель стартует ВЫКЛЮЧЕННЫМ: щелчка при включении быть не должно. */
esp_err_t ipradio_audio_init(void);

/** Применить громкость и mute к активному тракту.
 *  Единственное место, где логическое значение автомата превращается
 *  в действия над железом. Для эфира это регистр тюнера, для интернета —
 *  регулятор в конвейере. */
esp_err_t ipradio_audio_apply(const ipradio_snapshot_t *snap);

/** Включить или выключить внешний усилитель TPA3118 (линия SD).
 *  Выключение переводит его выходы в высокоимпедансное состояние. */
esp_err_t ipradio_audio_amp_enable(bool on);

#ifdef __cplusplus
}
#endif
