Spok1978/hybrid-radio/tests/host/test_state.c

/*
 * test_state.c — проверки автомата состояния.
 *
 * Идут только на машине разработчика: на плате у автомата своя
 * задача и своя очередь, а здесь мы подаём событие и тут же смотрим,
 * что стало с состоянием. Без планировщика, без ожидания,
 * без непредсказуемости.
 *
 * Хранилище подменено на то, что в памяти (fakes/fake_storage.c):
 * карта для проверки логики не нужна, а мешала бы.
 */

#include <stdio.h>
#include <string.h>

#include "ipradio_state.h"
#include "ipradio_storage.h"

/* Прокрутить очередь вручную. Собирается только при IPRADIO_HOST_TEST. */
void ipradio_state_pump(void);

/* Из поддельного хранилища. */
void             fake_storage_reset(void);
ipradio_store_t *fake_storage_raw(void);

static int s_pass;
static int s_fail;

static void check(bool ok, const char *what)
{
    if (ok) {
        s_pass++;
        printf("I (state)   ok   %s\n", what);
    } else {
        s_fail++;
        printf("E (state)   ОТКАЗ %s\n", what);
    }
}

/* Подать событие и сразу его разобрать. */
static void post(ipradio_event_type_t type, int32_t arg)
{
    ipradio_post_simple(type, arg);
    ipradio_state_pump();
}

static ipradio_snapshot_t now(void)
{
    ipradio_snapshot_t s;
    ipradio_get(&s);
    return s;
}

/* Завести станцию в банке. */
static void put_station(ipradio_mode_t mode, int cell, const char *name)
{
    ipradio_preset_t *bank = ipradio_storage_bank(fake_storage_raw(), mode);
    ipradio_preset_t *p = &bank[cell - 1];

    memset(p, 0, sizeof(*p));
    p->used = true;
    p->type = mode;
    snprintf(p->name, IPRADIO_NAME_MAX, "%s", name);

    if (mode == IPRADIO_MODE_FM) {
        p->band     = IPRADIO_BAND_CCIR;
        p->freq_khz = 100000 + (uint32_t) cell * 100;
    } else {
        snprintf(p->url, IPRADIO_URL_MAX, "http://example/%d", cell);
    }
}

/* ------------------------------------------------------------------ *
 *  1. Громкость
 * ------------------------------------------------------------------ */

static void test_volume(void)
{
    printf("I (state) громкость\n");

    post(IPRADIO_EV_VOLUME_SET, 70);
    check(now().volume == 70, "ползунок задаёт уровень");

    post(IPRADIO_EV_VOLUME_DELTA, 10);
    check(now().volume == 80, "регулятор прибавляет");

    /* За края шкалы уходить нельзя. */
    post(IPRADIO_EV_VOLUME_SET, 200);
    check(now().volume == 100, "выше ста не поднимается");

    post(IPRADIO_EV_VOLUME_SET, -5);
    check(now().volume == 0, "ниже нуля не опускается");

    /* Поворот регулятора снимает приглушение: иначе человек крутит,
     * ничего не слышит, а при снятии mute получается неожиданно
     * громко (§6.3). */
    post(IPRADIO_EV_VOLUME_SET, 50);
    post(IPRADIO_EV_MUTE_TOGGLE, 0);
    check(now().muted, "приглушение включилось");

    post(IPRADIO_EV_VOLUME_DELTA, 5);
    check(!now().muted, "поворот регулятора снял приглушение");
    check(now().volume == 55, "и уровень при этом поднялся");
}

/* ------------------------------------------------------------------ *
 *  2. Пресеты работают только в своём режиме
 * ------------------------------------------------------------------ */
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
