Spok1978/hybrid-radio/(commit log)

2026-08-17 Заведён проект IP-Radio: требования и разбор вариантов по узлам
    Исследование перед закупкой: каталоги интернет-станций (Radio Browser,
    SHOUTcast, Xiph, TuneIn, vTuner), эфирный тракт (RDA5807M / Si4735 / RTL-SDR),
    платформа (Raspberry Pi против ESP32-S3), звук, экран и меню.
    Открытые вопросы Q1-Q10 вынесены отдельно.
2026-08-17 Решения по Q1, Q2, Q4; разбор удешевления и выбора платы
    Приняты: Radio Browser + локальная база станций; тюнер RDA5807M;
    платформа Raspberry Pi; экран Touch Display 2 с сенсором.
    Добавлен документ 08: экран дороже платы, у 5 и 7 дюймов одно разрешение
    720x1280, Zero 2 W с Touch Display 2 несовместим (нет DSI), самая дешёвая
    плата с DSI - Pi 3A+; следствие 512 МБ - интерфейс без браузера,
    PyQt5/pygame + MPD в фоне.
2026-08-17 Закрыты Q3, Q4, Q5: Pi 3A+, экран 5 дюймов, PCM5102A + PAM8302A, один динамик
    Комплектация V1 как самая дешёвая с родным DSI-экраном: разрешение то же
    720x1280, в ландшафте 1280x720. Звук: стерео-ЦАП сохраняем на будущее,
    но каналы сводятся в моно в том же пассивном узле, где подмешивается аналог
    с тюнера, - один узел на четырёх резисторах решает обе задачи.
    Усилитель PAM8302A выбран из-за аналогового входа: MAX98357A при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
2026-08-17 Обзор плат с разъёмом DSI: три уровня совместимости
    Внутри Raspberry Pi разъём DSI есть у A/B/A+/B+/2B/3B/3B+/3A+/4B, у Pi 5 -
    совмещённый CSI/DSI со шлейфом 22-15; у всей серии Zero, Pi 400 и Pi 500
    разъёма нет. Compute Module - через плату-носитель, оверлей
    vc4-kms-dsi-ili9881-7inch.
    Платы Radxa ROCK умеют оригинальный дисплей Pi 800x480 через свои оверлеи,
    но про Touch Display 2 подтверждений нет. ESP32-P4 имеет MIPI DSI, но
    драйвера панели Pi у него нет.
    Резерв на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
2026-08-17 Плата Pi 3B+; проработан узел питания с входом USB Type-C
    Питание: бюджет тока 1,2-1,5 А рабочее и до 2,5 А пик, отсюда требование
    к заряднику 5 В / 3 А. Два резистора 5,1 кОм на CC1 и CC2 - без них
    зарядник C-to-C не даёт напряжения вообще. Раздача звездой от одной точки,
    усилитель отдельной парой мимо входа Pi, ввод в Pi через micro-USB
    с сохранением штатной защиты.
    Запас по просадке всего 0,3 В (порог контроля 4,63 В),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
2026-08-17 Разбор входа питания: Type-C 5 В против гнезда 5 В против 12 В
    12 В сама по себе не проще - она не убирает узлы, а добавляет понижающий
    преобразователь и риск импульсной помехи прямо в полосе приёма 65-108 МГц.
    Зато снимает проблему просадки (порог 4,63 В, запас 0,3 В) и позволяет
    питать усилитель напрямую: TPA3118 на 12 В в 4 Ом даёт расчётный потолок
    V^2/(2R) = 18 Вт, реально 12-15 Вт против 2,5 Вт у PAM8302A.
    Добавлен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
2026-08-17 Питание 12 В от внешнего блока; усилитель заменён на TPA3118D2
    Вход: гнездо 5,5x2,1, блок 12 В / 3 А, предохранитель, защита от
    переполюсовки на P-MOSFET, TVS на 12 В. Усилитель питается 12 В напрямую,
    Pi с дисплеем - через синхронный buck, выставленный на 5,1 В, ввод в Pi
    через micro-USB. Расчёт: по 5 В нужно 1,0-1,6 А, это ~0,8 А со стороны 12 В,
    плюс до 1,1 А на усилитель.
    PAM8302A заменён на TPA3118D2, потому что выше 5,5 В не питается: п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
2026-08-17 Сохранность данных при снятии питания: батарея не нужна
    Причина порчи карты - не обрыв питания, а прерванная запись. Поэтому:
    корень только для чтения (overlayfs), swap выключен, отдельный раздел
    данных смонтирован ro и открывается на запись на доли секунды, запись
    атомарная через временный файл, fsync и rename, плюс две копии с
    контрольной суммой.
    Кнопка мягкого выключения на штатных оверлеях: gp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
2026-08-17 Q9 закрыт: веб-интерфейс с телефона не делаем
    Оба основания отпали. Ввод пароля Wi-Fi решён выбором сенсорного экрана,
    а после отказа от NiceGUI в пользу нативного интерфейса веб-слой перестал
    быть бесплатным - это был бы второй интерфейс со своим списком станций,
    пресетами и настройками, который надо держать в согласии с основным.
    Вместо него: SSH для обслуживания, поиск по Radio Browser прямо на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
2026-08-18 Список покупок: 50 позиций, каждая с количеством и поисковым названием
    Разбит по узлам: вычислитель и экран, радиотракт, звук, питание, пассивные
    компоненты, помехоподавление, органы управления, монтаж. Без комплектов и
    россыпей - каждая деталь отдельной строкой с номиналом, корпусом и типом.
    Отдельно выделено, что не заказываем сейчас и почему: корпус и всё, что от
    него зависит, дета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
2026-08-20 Уточнён экран: оригинала нет на AliExpress, к заказу Waveshare 5inch DSI LCD (C)
    Оригинальный Touch Display 2 - официальный продукт Raspberry Pi (артикул
    SC1975 для 5 дюймов, SC1635 для 7) и продаётся только через авторизованных
    продавцов. На AliExpress его нет, отсюда и не нашёлся.
    Замена: Waveshare 5inch DSI LCD (C), 1024x600, IPS, ёмкостный тач, шлейф
    на 15-контактный DSI, заявлена поддержка 3B+. Для приёмника он даже удобнее
    оригинала - панель лан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
2026-08-20 Разбор внешнего аудита: приняты 6 правок, две находки аудита опровергнуты
    Проверял по первоисточникам, а не по тексту аудита.
    Подтвердилось и исправлено: XL4015 несинхронный и противоречил требованию
    документа 09; TVS P6KE15A с рабочим напряжением 12,8 В стоял впритык к шине
    12 В - заменён на P6KE16A; питание RDA5807M по даташиту 2,7-3,3 В, а не 3,6;
    усиление 20 дБ на TPA3118 это R1 5,6 кОм и R2 не установлен, а модули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
2026-08-20 Принят стек софта: большая часть рекомендаций, четыре пункта с изменениями
    Приняты: абстракция громкости с двумя реализациями (регистр чипа в FM,
    setvol у MPD в интернете), MPD с python-mpd2 и idle-событиями, своё
    разворачивание плейлистов, хранение stationuuid ради счётчика и обновления
    URL, порт логики PU2CLR RDA5807 на smbus2, разные пороги SEEK по диапазонам,
    evdev с длинным нажатием по таймстампам ядра и ускорени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
2026-08-20 Сквозная сверка документов после аудита: устранены четыре недосмотра
    Правки аудита были внесены в профильные документы, но остались хвосты
    в смежных. Найдено поиском по всем файлам и исправлено:
    - документ 09 всё ещё требовал для тюнера 2,7-3,6 В, хотя в 02 уже стояло
    правильное 2,7-3,3 В по даташиту;
    - в бюджете тока документа 09 висел экран 5 дюймов с оценкой 0,4 А -
    заменён на 7 дюймов и 0,5 А,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
2026-08-20 В список покупок добавлен журнал изменений позиций
    Сведено то, что менялось с первой редакции: экран A3, преобразователь D6,
    TVS D9, конденсаторы E3 и новая позиция E9. Дельта снята командой git diff
    по файлу списка, а не составлена по памяти. Остальные 46 позиций не менялись.
2026-08-21 Схема соединений для сборки на макете; усиление пересчитано на 26 дБ
    Документ 15: узел за узлом от гнезда питания до динамика, с разделением
    что паяем (все силовые цепи) и что можно на беспаечной макетке (I2C, I2S,
    кнопки, сумматор). Порядок первого включения по шагам с замерами.
    При расчёте уровней вскрылось: выход тюнера 360 мВ по даташиту против 2,1 В
    у ЦАП - разница около 15 дБ. Одинаковые ре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
2026-08-21 Перечень соединений откуда-куда: 98 строк для монтажа по списку
    Разложено по узлам: ввод 12 В, преобразователь, питание Pi, шина 3,3 В,
    тюнер, ЦАП, сумматор, усилитель с динамиком, органы управления, дисплей.
    Отдельно перечислено что сходится в точке земли и что на этом этапе
    не подключается.
2026-08-21 README: статус «железо заказано», номиналы сумматора в схеме приведены к текущим
2026-08-21 Три внешних разбора схемы: исправлена критическая ошибка по MOSFET и ещё девять пунктов
    Критическое: документы 09 и 15 описывали включение IRF4905 по-разному.
    Прав документ 15 - сток к входу, исток к шине. Проверила по физике прибора:
    паразитный диод P-канального идёт от стока к истоку, и при обратном
    включении он при переполюсовке смещается в прямом направлении и пропускает
    ток в устройство.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
2026-08-21 Машиночитаемый список цепей и проверка к нему
    netlist/ip-radio.yaml: 49 компонентов, 43 цепи, 155 точек подключения.
    Написан из документа 16 напрямую, а не пересказан из прозы - пересказ прозы
    это ровно тот способ, которым в проект уже дважды заезжали ошибки.
    netlist/check_netlist.py ищет цепи из одной точки, один и тот же вывод
    в разных цепях и ссылки на неописанные компоненты. Сейчас проходит чисто.
    При сост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
2026-08-21 Разбор двух похожих приёмников: аналоговый ключ переведён в запасной план
    Оба автора решали ту же задачу сведения эфира и интернета на один усилитель
    и оба поставили аналоговый ключ - MAX4544 и ADG884. Пассивным сумматором
    не пошёл никто, а это ровно то место, к которому цеплялись внешние аудиты.
    Ключ лучше тем, что источники развязаны и у каждого может быть свой
    подстроечник уровня - тог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
2026-08-21 ESP32 после закупки разобран честно; часы DS3231 приняты в развитие
    Про ESP32: арифметика не в пользу принятого решения, и это признано прямо.
    Плата Sunton ESP32-8048S070 даёт ESP32-S3 плюс 7 дюймов 800x480 с тачем и
    усилителем MAX98357A на борту за 21-28 долларов против 80-95 за связку
    Pi 3B+ с DSI-панелью. При выборе в начале это было бы втрое дешевле по
    цифровой части. Но железо уже куплено, концепция ещё не подтверждена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
2026-08-21 Разбор iRadio: берём дисциплину, а не количество процессов
    Поправка к описанию, пришедшему со ссылкой: mediaplayerd у них отвечает
    за проигрывание с USB-носителей, звук рендерит VLC в демоне vlcd, а
    отдельного демона тюнера RDA5807 нет вовсе.
    Их разделение на демоны продиктовано не надёжностью, а комбинаторикой
    железа: платы от Pi 1 до Pi 4, экраны четырёх типов, приём интернет,
    DAB+, УКВ и SDR. Демон на класс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
2026-08-21 Проработан переход на аналоговый ключ: ADG884 против 4053 против реле
    ADG884 существует только в SMD-корпусах - WLCSP, LFCSP, MSOP-10, версии DIP
    нет вовсе. На беспаечной макетке это означает переходник и пайку шага
    0,5 мм. Питание однополярное 1,8-5,5 В, диапазон сигнала до шин питания,
    значит центрированный на земле сигнал требует смещения к середине питания
    на каждом входе. И полный сигнал ЦАП 2,1 В действ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
2026-08-21 Поправка: готовая плата ключа существует, но на MAX4544, и она нам лучше
    В первой редакции раздела я смотрела корпус микросхемы и не проверила
    готовые модули. Плата в этом классе есть - Adafruit STEMMA Analog SPDT
    Switch на MAX4544, артикул 5892, с разъёмами JST PH.
    Для нас она подходит лучше, чем подошёл бы ADG884: питание 3-12 В против
    1,8-5,5, значит ключ можно запитать от уже имеющейся шины 12 В, поставить
    смещение 6 В и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
2026-08-21 Поиск плат на AliExpress и разбор реальной схемы с ADG884
    AliExpress автоматическому просмотру не отдаётся - редиректит на главную,
    каталог рисует скриптами. Конкретные лоты не перечисляю. Вместо этого
    записаны точные запросы и признаки отбора по трём группам: микросхемы
    россыпью в DIP-16, готовые модули аудиоселектора на реле и реле отдельно.
    Отмечена ловушка: обычные модули реле силовые, с сер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
2026-08-21 Дописано, откуда берутся плюс-минус 3 В и почему это касается только ключа
    В тексте был вывод, но не было вывода. Теперь показано: 2,1 В действующего
    на выходе ЦАП это 2,1 умножить на корень из двух, около 3 В амплитуды,
    а выход DirectPath центрирован на земле, значит сигнал ходит от минус 3
    до плюс 3 В относительно нашей земли.
    Явно сказано, чего раньше нигде не было: в нынешней схеме этой пробле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
2026-08-21 Найден модуль 74HC4051 с выводом VEE - лучший вариант ключа из рассмотренных
    Заказчик нашёл на AliExpress готовую плату HW-529 с восьмиканальным
    аналоговым мультиплексором. Ключевое отличие от всего рассмотренного ранее:
    у микросхемы есть отдельный вывод отрицательного питания VEE, а значит
    узел смещения не нужен вообще - сигнал проходит как есть.
    По даташиту Nexperia: VCC до 10 В над землёй, VEE ниже VCC,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
2026-08-21 Разобраны аналоги TS5A23157 и TS3A5018: для нас шаг назад
    Приведённые заказчиком цифры верны, проверила по даташитам TI. Но сравнение
    шло по параметру, который в нашей схеме не значит ничего.
    Сопротивление канала: ключ работает на вход усилителя 30 кОм, поэтому
    разница между 0,38 Ом у ADG884, 10 Ом у микросхем TI и 120 Ом у 4051 -
    это четыре десятых процента, то есть 0,03 дБ. Выбирать по нему не нужно.
    Оно было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
2026-08-21 Схема ключа ADG884 для макета, по образцу чужого проекта с исправлением
    Схема-образец разобрана рендерингом PDF - текстового слоя в файле нет.
    Прочитана распиновка ADG884, задействованы обе секции по одной на канал,
    IN1 и IN2 соединены вместе, тюнер развязан электролитами 220 мкФ с нагрузкой
    10 кОм, ЦАП подключён к входам ключа напрямую без единой детали.
    Главное наблюдение: узла смещения в обр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
2026-08-21 Документ по ADG884 переписан: только соединения, вывод за выводом
    Старый документ удалён. Новый содержит распиновку ADG884 и таблицу выводов
    каждой детали узла с указанием, куда идёт каждый вывод, плюс перечень того,
    что садится на шины питания и земли. Рассуждения и разбор образца убраны.
2026-08-21 ADG884: документ и рисунок сведены к отдельному узлу без внешних связей
    Убраны сумматоры, подстроечники, тюнер, ЦАП, усилитель и GPIO. Осталась
    микросхема с обвязкой и шесть точек, выведенных наружу: два входа, выход,
    управление, питание и общий. Рисунок перерисован под то же.
2026-08-22 UG-428: добавлены таблица истинности управления и второй конденсатор питания
    Из руководства по отладочной плате: при нуле на управляющем входе открыт
    S1B, при единице - S1A. Питание VDD у ADI развязано парой 10 мкФ и 0,1 мкФ -
    добавлен C6 на 10 мкФ, раньше стоял только керамический.
2026-08-22 Исправлен чертёж: у R3 провод к шине +3,3 В обрывался и никуда не приходил
2026-08-23 Разобрана C-серия ESP32 и готовые платы экран-плюс-процессор
    C3 не поддерживает PSRAM вовсе, у C6 она опциональна, у C5 есть, но под
    C-серию нет готовой базы MiniWebRadio - она требует S3 с PSRAM от 4 МБ.
    Варианта C4 не существует.
    Из готовых плат подходит Waveshare ESP32-S3-Touch-LCD-2.8: два ядра
    240 МГц, 8 МБ PSRAM, 16 МБ флеш, 2,8 дюйма 240x320 с тачем. Вариант 2.8B
    на 480x640 лучше под списки станций.
    Отмечено, что 2,8 дюйма нарушает требо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
2026-08-23 Добавлен рабочий пример интерфейса на смарт-дисплее 2,8 дюйма
    Метеостанция на VIEWE ESP32-S3 Smart Display: LVGL 8.4.0, ESP-IDF 5.3.5,
    датчики по I2C на GPIO9 и GPIO10. Берём связку версий как заведомо рабочую
    и номера свободных выводов I2C. Отмечено, что этот пример не доказывает
    сосуществование графики с декодированием потока - у панели, обновляемой
    раз в несколько секунд, нагрузка другого порядка.
2026-08-23 Состав платы ESP32-S3-Touch-LCD-2.8, два её узких места и хранение станций
    На плате уже есть ЦАП PCM5101, усилитель с комплектным динамиком 8 Ом 2 Вт,
    регулятор громкости, слот TF-карты, часы PCF85063, контроллер заряда
    и разъём под литиевый аккумулятор. Значит из заказанного не нужны PCM5102A,
    DS3231 и карта для Pi.
    Первое узкое место: встроенный звуковой тракт рассчитан только на свой ЦАП,
    аналогового входа сн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
2026-08-23 Уточнение про I2C платы: внешние устройства вешать можно, тюнер туда встаёт
    Формулировка была неточной. Оговорка вики означает, что выводы нельзя
    переназначить под другие функции, а не что к шине нельзя подключаться.
    Адреса не пересекаются: тач 0x1A или 0x15, часы 0x51, датчик 0x6A или 0x6B,
    тюнер 0x10 и 0x11. Дефицит линий под кнопки при этом остаётся.
2026-08-23 Дефицит выводов на смарт-дисплее решается шиной I2C
    Энкодеры существуют готовыми модулями с интерфейсом I2C (Adafruit Stemma QT
    на прошивке seesaw, адрес 0x36, до восьми на шину), кнопки заводятся через
    расширитель PCF8574. Тюнер там же - другого интерфейса у RDA5807M нет.
2026-08-23 Сравнение пяти плат со смарт-экраном
    Ни одна не подходит под MiniWebRadio без переделки дисплейного порта:
    прошивка поддерживает SPI ILI9341/9486/9488/ST7796, RGB 800x480 и DSI
    1024x600 и требует тач, а T-Display-S3 без тача отпадает совсем. Значит
    довод про готовую прошивку при любом выборе из этой пятёрки не работает.
    Главное различие не размер экрана, а кодек: у плат с ES8311 есть аналоговый
    вход, выход тюнера заводит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
2026-08-23 Семейство плат P4 с аналоговым входом; поправка к вчерашнему выводу
    Почти все платы на P4 построены вокруг одной обвязки: кодек ES8311 с
    24-битными АЦП и ЦАП, усилитель NS4150B на 3 Вт, слот microSD по SDIO 3.0
    и дисплей по MIPI-DSI. Аналоговый вход есть у всех. Производители:
    Espressif, Waveshare, 4D Systems, Guition, M5Stack.
    Поправка: вчера записано, что ни одна плата не подходит под MiniWebRadio
    без переделки дисплейного порта. Для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
2026-08-23 Задание на поиск плат ESP32 с экраном: отсекающие требования и веса
    Пять отсекающих: PSRAM от 4 МБ, Wi-Fi, цветной экран, выведенная шина I2C,
    наличие в продаже. Дальше сто баллов, из которых двадцать за кодек
    с аналоговым входом и восемнадцать за дисплей из списка MiniWebRadio -
    это два пункта, которые убирают больше всего работы.
    Отдельно перечислено, что баллов не даёт: камера, датчики, микрофоны,
    E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
2026-08-23 Уточнён состав комплекта P4-Function-EV-Board и расписаны минусы трёх лучших
    За 55 долларов в комплекте идут плата, экран 7 дюймов 1024x600 с тачем,
    камера и кабели. Подтверждена 40-контактная гребёнка GPIO, поэтому оценка
    поднята с 76 до 86 баллов.
2026-08-24 Оценена Waveshare ESP32-S3-Touch-LCD-4.3B: 58 баллов, один критичный вопрос
    Плюсы: 8 МБ PSRAM, экран 4,3 дюйма 800x480 RGB с ёмкостным тачем по I2C -
    ровно то сочетание, которое поддерживает MiniWebRadio, слот TF-карты,
    Wi-Fi на кристалле, Arduino и ESP-IDF. Сверх таблицы: питание 7-36 В
    постоянного тока, то есть наш блок 12 В подключается напрямую и
    преобразователь для платы не нужен, и часы PCF85063 на борту вместо DS3231.
    Риск, который над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
2026-08-24 У обеих плат Waveshare 4.3 звука нет вовсе; найдена Sunton 5 дюймов на 70 баллов
    Прочитаны вики обеих версий, 4.3 и 4.3B. Аудиокодека нет ни у одной:
    в перечне интерфейсов только дисплей, тач, USB, карта, RS485, CAN, RTC и I2C.
    Это промышленные панели HMI, звук в их назначение не входил. У версии без B
    прямо назван расширитель портов CH422G - подтверждение, что выводы кончились.
    Взамен найдено семейство Sunton: те же ESP32-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
2026-08-24 Добавлено требование R4.1 про два способа управления; таблица весов пересчитана
    Прибор рассчитан в том числе на пожилых пользователей, которым крутить ручку
    и нажимать кнопку привычнее сенсора. Гибкость управления - заявленная
    особенность, а не запасной вариант. Записано как R4.1.
    Две правки в критериях. Убран критерий поддержки Arduino: он мерил не то,
    MiniWebRadio это проект ESP-IDF, в репозитор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
2026-08-25 Заказана вторая платформа: Waveshare ESP32-P4-WIFI6-Touch-LCD-5
    Плату Espressif на AliExpress найти не удалось. Записано, что из комплекта
    под Pi переходит на P4: тюнер с антенной, органы управления, усилитель
    с динамиком и силовой узел 12 В при необходимости. Не нужны ЦАП PCM5102A,
    часы DS3231, сам Pi с экраном и картой.
    Отмечены две проверки при получении: выведен ли аналоговый вход ES8311
    на разъём и выходит ли наружу лин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
2026-08-25 Режим переключается программно: тумблер заменён кнопкой MODE
    Пресеты 1-8 хранят станции обоих типов, поэтому нажатие пресета само
    переводит прибор из эфира в интернет и обратно. Тумблер при этом становится
    вторым источником истины: его положение расходится с тем, что реально играет,
    и любое разрешение конфликта плохое. Проверено по документам, что коммутации
    он и не делал: в принято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
2026-08-25 Основная сборка перенесена на ESP32-P4
    Решение заказчика 2026-08-26, отменяет «собираем на Pi» от 2026-08-17.
    Плата — Waveshare ESP32-P4-WIFI6-Touch-LCD-5, софт на ESP-IDF с базой
    schreibfaul1/ESP32-MiniWebRadio. Q3 переигран, решение в документе 08
    перевёрнуто с сохранением прежнего текста как истории. Q4 (панель
    1024×600) и Q5 (ЦАП PCM5102A) помечены отменёнными: экран у платы свой,
    кодек ES8311 на борту. Ревизия на Pi сохранена — документы 10, 13, 14,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
2026-08-25 Q13 закрыт: мастер — наш файл, /stations.json — проекция
    Получены два сторонних разбора постановки. Оба за вариант 1 и против форка,
    но архитектуру предлагают разную. Принят тот, что переворачивает связь:
    источник истины — наш /ipradio.json с пресетами обоих режимов и полными
    полями станций, а /stations.json генерируется из него как проекция в четыре
    строки на запись. Связь нужна только в одну сторону,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
2026-08-26 ТЗ на прошивку: свой документ, прошивка пишется с нуля
    Заказчик написал черновик ТЗ и попросил дополнить его данными проекта.
    Результат — docs/26-firmware-spec.md. Исправлены расхождения с принятыми
    решениями: плата не Espressif EV-Board, а Waveshare с панелью 720x1280;
    PCM5102A и DS3231 убраны, на плате ES8311 и разъём батарейки RTC; возвращён
    диапазон УКВ OIRT, в черновике был только FM 87,5-108; пресеты переписаны
    на единый ба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
2026-08-26 Разведка готовых решений: звуковой тракт берём из ESP-ADF
    Заказчик попросил собрать всё, что можно взять готовым, и оформить листом
    для сверки. Результат — docs/27-reference-sheet.md, разделённый по степени
    связывания: что ставим в зависимость, что читаем как референс, и список
    известных граблей с симптомами.
    Главная находка: официальный аудиофреймворк Espressif поддерживает
    ESP32-P4 — в README esp-adf чип на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
2026-08-26 Лист для сверки дополнен разделом «что можно делать без платы»
    Проверено, какие эмуляторы доступны под ESP32-P4. Вывод: логику
    и интерфейс закрыть можно, рискованные узлы — нет.
    LVGL штатно собирается на настольном ПК, официальный порт под Windows —
    lv_port_pc_visual_studio, зависимостей кроме Win32 API и STL нет. Через
    него до прихода платы делаются все экраны, меню, русская клавиатура,
    списки станций и жд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
2026-08-26 Образцы экранов интерфейса, приняты как рабочий вариант
    Восемь состояний, нарисованных по спецификации из документа 26, чтобы
    проверить, что задание понято правильно: эфир со станцией и без RDS,
    интернет-радио в игре и в буферизации, меню, шкала настройки, экранная
    клавиатура и ждущий режим. Кадр 1280x720 - в том виде, в каком он окажется
    на панели после поворота. Заказчик принял 2026-08-26.
    Пр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
2026-08-26 Индикация mute и поведение интернет-режима без сети
    Заказчик попросил отрисовать mute красным перечёркнутым динамиком
    и блокировать интернет-радио, когда Wi-Fi недоступен. Оба состояния
    нарисованы и добавлены в набор образцов, экраны 09 и 10.
    По mute: значок красный и перечёркнутый, число громкости зачёркнуто,
    плюс крупная плашка ЗВУК ВЫКЛЮЧЕН по центру. Значка в углу для целевого
    пользов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
2026-08-26 Три состояния недоступности интернета разведены по поведению
    Уточнение заказчика: реакция на кнопку MODE зависит от того, почему
    интернет недоступен, и прежнее решение "MODE переключает всегда,
    экран объясняет" этим заменяется.
    Сеть не настроена: MODE не переключает, а приглашает настроить сеть,
    с прямым переходом в настройку и кнопкой "не сейчас". Сеть настроена,
    но связи нет: MODE не пер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
2026-08-26 Правки заказчика к ТЗ: готовый BSP платы закрывает Q12
    Заказчик прислал редакцию документа 26 с результатами проверки по
    документации. Файл был собран из более раннего снимка, поэтому не заменён,
    а слит: три блока последних решений - короткие названия диапазонов,
    индикация mute и три состояния недоступности сети - восстановлены на местах.
    Главное в правках: Waveshare публикует готовый стек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
2026-08-26 Найден репозиторий платы: карта выводов, схема, матрица версий Wi-Fi
    Проверяя допущение из правок заказчика о том, что схему платы можно
    прочитать заранее, нашёл официальный репозиторий waveshareteam/
    ESP32-P4-WIFI6-Touch-LCD-5. Прежний вывод, что Waveshare схему не
    публикует, был верен для страницы товара и вики, но неверен вообще:
    схема лежит в каталоге hardware/schematic, там же двенадцать примеров
    под ESP-IDF и заво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
2026-08-26 Схема платы разобрана: Q11 закрыт, вход ES8311 никуда не разведён
    Прочитана схема ESP32-P4-WIFI6-Touch-LCD-5-Schematic.pdf из репозитория
    платы. Копия положена в docs/ref. Закрыты два вопроса, висевшие с начала
    работы над платформой P4.
    Аналоговый вход кодека наружу не выведен. Выводы 17 и 18 у ES8311, то есть
    MIC1N и MIC1P, ни к чему не подключены: у них нет ни цепи, ни площадки, ни
    контрольной точки. Проверено на большом у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
2026-08-26 Разъём динамика меняет расклад по звуку: три пути, рекомендация третья
    Заказчик заметил на фотографии платы разъём динамика GH1.25 на два контакта.
    Наблюдение верное и важное: разъём есть, но на нём уже усиленный мостовой
    сигнал после ферритов, то есть выход NS4150B.
    Проверено по схеме: контрольных точек на звуковом тракте нет вовсе, во всей
    схеме их две и обе у дисплея. Линейный выход ко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
2026-08-26 Разбор стороннего YAML по железу: три записи опровергнуты, Q11 поправлен
    Заказчик принёс реконструкцию железа платы, сделанную другой ИИ-системой.
    Документ честный: сам делит утверждения на confirmed, inferred и unknown
    и просит не считать inferred пригодным для производства. Проверка это
    предупреждение оправдала буквально.
    Подтверждено по схеме и принято. Отладочный мост CH343P занимает GPIO38
    на TXD и GPI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
    [ESP32-P4-WIFI6-Touch-LCD-5_AI_Hardware_Reconstruction.yaml]
2026-08-26 Подключение тюнера: шина I2C платы годится как есть, но бюджет выводов конфликтует с вариантом C
    Питание тюнера с ESP_3V3 гребёнки, пять вольт подавать нельзя. Шина I2C
    проверена по схеме: подтяжки R49 и R50 по 2,2 килоома к ESP_3V3 уже стоят,
    то есть шина трёхвольтовая и своих резисторов не надо. Адреса тюнера
    с GT911, ES8311 и ES7210 не конфликтуют.
    Своя шина I2C отпадает не по стилю, а по бюджету: отдельная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
2026-08-26 Закрыты два ограничения по выводам: strapping и пробуждение из сна
    Проверка по даташиту ESP32-P4 версии 0.7 и документации esptool, копия
    даташита положена в docs/ref.
    Strapping-выводы это GPIO34, GPIO35, GPIO36, GPIO37 и GPIO38. Из нашего
    списка свободных под это попадает только GPIO34, он задаёт источник
    сигналов JTAG. Оттуда же важное: защёлки считывают уровень при сбросе
    и далее выводы освобождаются как обычные IO, то ест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
2026-08-26 Раскладка выводов до конкретного GPIO и каркас прошивки
    Раз ограничения по выводам закрылись, обе конфигурации расписаны
    до вывода, чтобы решение по расширителю принималось по готовым таблицам.
    Вариант с расширителем занимает двенадцать выводов из восемнадцати
    и оставляет шесть в запасе плюс семь линий расширителя. Вариант без
    расширителя на шесть кнопок занимает все восемнадц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
    [partitions.csv]
2026-08-26 Q14: выход состояния зарядника есть, но только на контрольной точке
    Проверено по схеме. У ETA6098 вывод 9 это STAT, цепь подписана change,
    очевидная описка вместо charge. На процессор он не разведён: идёт только
    на контрольную точку TP1 и больше никуда.
    Это скорее хорошая новость. Контрольная точка нормальная площадка, паять
    к ней несравнимо проще, чем к конденсатору типоразмера 0201, а свободные
    вы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
2026-08-26 Из склонированного ADF: подтверждены ключи конфигурации и найден конфликт версий
    ESP-ADF склонирован, и то, что вчера бралось из поисковой выдачи или
    оставлялось пустым, теперь читается по официальному источнику локально.
    Подтверждено по examples/player/pipeline_http_mp3/sdkconfig.defaults.esp32p4.
    Ключ ESP_WIFI_REMOTE_LIBRARY_HOSTED пишется именно так и стоит рядом
    с SLAVE_IDF_TARGET_ESP32C6, раньше был известен только по поиску
    и пом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
2026-08-26 Код проверочной программы сверен с заголовками IDF 5.5.3
    ESP-IDF разложился локально, и все вызовы из app_main.c, написанные вчера
    вслепую, сверены с его заголовками. Совпало всё: i2c_new_master_bus,
    i2c_master_probe с сигнатурой из трёх аргументов, i2c_del_master_bus,
    esp_psram_get_size, esp_psram_is_initialized, поля структуры конфигурации
    шины, включая i2c_port равный минус единице для автовыбора порта
    и flags.enable_internal_pullup, а также формат пол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
2026-08-27 Конфигурация перестроена по вендору платы: скорость PSRAM зависит от ревизии
    Склонирован репозиторий платы, и его пример 04_wifistation оказался ближе
    к нашему железу, чем общий для кристалла набор ADF.
    Главная находка: скорость PSRAM зависит от ревизии кристалла. Двести
    мегагерц для rev1.x, двести пятьдесят для rev3.x. Это объясняет
    расхождение, на которое я едва не наступила: у ADF стоит двести,
    у Wave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
2026-08-27 Инструментарий установлен, пример вендора собирается
    Установка обошлась без интерактивного установщика: скрипт ESP-IDF вызван
    напрямую с указанием цели. Инструменты под одну цель заняли 3,4 гигабайта.
    Пример 04_wifistation из репозитория платы собран успешно: цель esp32p4,
    двоичный файл на 553 килобайта, свободно 47 процентов раздела приложения.
    Зависимости решились в esp_hosted версии 1.4.7, то есть р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
2026-08-27 Каркас прошивки собирается: 412 КБ, 90 процентов раздела свободно
    Первая сборка нашего проекта прошла успешно. Код проверочной программы,
    написанный вчера без компилятора, собрался без единой ошибки и без
    предупреждений: все вызовы работы с шиной, PSRAM и опроса кристалла
    оказались верными.
    Таблица разделов прочиталась ровно так, как написана, включая смещения
    загрузчика, данных обн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
2026-08-27 Модуль состояния: конечный автомат, единственный владелец истины
    Первый настоящий модуль прошивки. Реализует требование из параграфа 3
    спецификации: режим, станция, частота, громкость и mute живут в одном
    месте, остальные модули их читают, а меняют только отправкой события
    в очередь.
    Устройство простое и потому надёжное: одна задача, одна очередь, один
    мьютекс на снимок. Все изменен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
2026-08-27 Модуль ввода: энкодеры и кнопки с антидребезгом и различением нажатий
    Второй модуль. Единственный, кто превращает действия человека в события
    автомата, поэтому без него автомат нечем кормить.
    Выбран опрос раз в пять миллисекунд, а не прерывания на каждую линию.
    Кнопок много и все медленные, а опрос даёт антидребезг бесплатно:
    состояние считается установившимся, когда совпало три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
2026-08-27 Модуль хранения: /ipradio.json с двумя копиями и контрольной суммой
    Третий модуль. Автомат больше не стартует с выдуманных умолчаний.
    Устойчивость к обрыву питания строится тремя слоями, потому что гарантий
    файловой системы у нас нет и вопрос Q14 остаётся открытым. Запись во
    временный файл с последующим переименованием: даже если переименование
    на FAT окажется не атомарным, испорченным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
2026-08-27 Драйвер эфирного тюнера RDA5807M: два диапазона, аппаратный автопоиск
    Четвёртый модуль. Первый, который реально заставит прибор звучать.
    Особенности чипа, из-за которых драйвер выглядит именно так. У него два
    адреса на шине: по одному идёт последовательная запись начиная с регистра
    управления, по другому произвольное чтение статуса. Пользуемся обоими,
    так меньше обменов. Отдельной з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
2026-08-27 Звуковой тракт: I2S на PCM5102A, и автомат наконец управляет железом
    Пятый модуль. Здесь замыкается круг: изменение состояния сразу
    применяется к железу.
    Разделение обязанностей получилось чистым. Автомат хранит одно
    логическое значение громкости и флаг приглушения, про железо не знает
    вовсе. Этот модуль переводит их в действия: для эфира это регистр
    тюнера, для интернета масштабиров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
2026-08-27 Сеть: Wi-Fi через сопроцессор, время и клиент каталога станций
    Шестой модуль. Собирается вместе с esp_wifi_remote, то есть связка
    с сопроцессором прошла компоновку.
    Правила сервиса Radio-Browser соблюдены все четыре. Список зеркал берётся
    через DNS, из полученных адресов выбирается случайный - это не про
    надёжность нашего прибора, а про то, чтобы не бить всегда в один и тот же
    общественный сервер. П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
2026-08-27 Интерфейс: главный экран воспроизведения на LVGL
    Седьмой модуль. Экран, который прибор показывает почти всё время;
    остальные одиннадцать состояний добавляются поверх этой же основы.
    Два правила задали устройство файла. Отрисовка идёт только в задаче
    LVGL: автомат зовёт нас из своей, поэтому его вызов лишь копирует снимок
    и ставит флаг, иначе правили бы виджеты из двух задач сразу. И ц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
2026-08-27 Интернет-радио: конвейер приёма потока на ESP-ADF
    Седьмой и последний модуль первого слоя прошивки. Конвейер:
    http_stream -> декодер по типу потока -> i2s_stream -> PCM5102A
    Три решения, заложенные в модуль:
    1. Декодер выбирается по типу потока, а не фиксируется. Станции
    приходят в mp3, aac, ogg; фиксированный MP3 означал бы, что часть
    станций молчит без объяснения причины.
    2. Конвейер поднимается один ра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
2026-08-27 Кириллица в интерфейсе: рендерим TTF на плате
    Подписи были латиницей не по замыслу, а вынужденно: встроенные шрифты
    LVGL (Montserrat) собраны под ASCII, кириллицы в них нет. Штатный путь
    её добавить - конвертер lv_font_conv, но он на Node.js, которого
    на машине сборки нет.
    Обошли конвертер целиком. LVGL умеет рендерить TTF прямо на плате
    (lv_tiny_ttf, сборка на stb_truetype): шрифт кладётся в образ файлом
    через EMBED_FILES, lv_ti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
2026-08-27 Три диалога недоступности сети: экраны 10-12
    Форма у трёх случаев общая, поведение разное - так и сделано:
    один модуль, три набора текста и кнопок.
    Что определяет устройство:
    1. Прибор не замолкает (§5.2, правило 3). Плашка показывается ПОВЕРХ
    играющего эфира, затемнение неполное - 70%, чтобы было видно, что
    прибор работает. Внизу всегда строка "Эфир при этом не прерывался".
    Полноэкранн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
2026-08-27 Ждущий режим: экран 08
    По §5.4: три минуты без нажатий, поворотов и касаний - часы во весь
    экран, яркость принудительно 50%. Любое действие возвращает экран
    играющей станции, воспроизведение не прерывается.
    Решения, которые стоит держать в голове.
    Не гасим подсветку, а показываем часы. Радио стоит в комнате и работает
    часами; гореть полной яркостью всё это время незачем, но и гаснуть
    на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
2026-08-27 Меню настроек: экран 05
    Семь пунктов по §5.3, вёрстка из макета: крупные строки, текущее
    значение справа у каждой.
    Значение справа - главное свойство экрана, а не украшение. Меню, где
    надо зайти в пункт, чтобы узнать, что там сейчас, заставляет обходить
    себя целиком. Здесь состояние прибора читается с одного взгляда.
    По той же причине под названием есть пояснение мелким шрифтом: "Wi-Fi"
    сам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
2026-08-27 Настройка эфира: экран 06
    Шкала диапазона по §5.3.1: указатель текущей частоты, засечки станций,
    границы подписаны у краёв.
    Почему шкала, а не просто число. Частота цифрами говорит, где мы стоим,
    но не говорит, где мы стоим относительно диапазона и что рядом. Шкала
    отвечает на оба вопроса сразу - это ровно та работа, ради которой
    на приёмниках была шкала со стрелкой.
    Засечки автопоиска -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
2026-08-27 Экранная клавиатура: экран 07
    Три раскладки по §5.3.3.1 - ЙЦУКЕН, латиница, знаки и цифры - плюс
    скрытый ввод для пароля. Нужна в двух местах: подписать станцию без
    RDS-названия (§5.3.1) и ввести пароль Wi-Fi (§5.3.3.1).
    Раскладка ЙЦУКЕН, а не алфавит по порядку. Алфавитная кажется удобнее
    для крутилки - букву проще найти, - но человек, набиравший что-нибудь
    на телефоне, ищет буквы там, где привык. Спор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
2026-08-27 Состояние интерфейса в макетах: что написано, чего нет
    Таблица по всем двенадцати экранам с указанием модуля и состояния,
    плюс список того, что мешает считать интерфейс законченным: выбор сети
    Wi-Fi, список станций, поиск по каталогу, экран диагностики и сам проход
    автопоиска.
    Отдельно описана механика перехвата органов управления - экранов,
    забирающих себе энкодеры, стало пять, и э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
2026-08-28 Проводка: панель, органы управления и мост до железа
    Три дырки, из-за которых прошивка собиралась, но не заработала бы.
    1. Панель и LVGL никто не поднимал. ipradio_ui_init сразу звал
    lv_screen_active, а тот при неподнятом LVGL возвращает NULL,
    и дальше срабатывало утверждение LVGL. Теперь вызывается
    bsp_display_start_with_config: панель, HX8394, GT911, буферы
    и задача LVGL одним вызовом. Поворот 90 градусов - панель книжная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
2026-08-28 УКВ откладывается: диапазон выключен, а не вырезан
    Решение заказчика 2026-08-28: работы хватает и без УКВ, вернуть
    потом, если понадобится.
    Сделано выключателем IPRADIO_ENABLE_OIRT, а не удалением кода.
    Тюнер умеет оба диапазона - коды диапазона и шага в регистр 03H
    уже написаны и работают. Удалять рабочий код, чтобы через месяц
    писать заново, - плохой размен. Выключено то, что торчит наружу:
    выбор д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
2026-08-28 Экран выбора сети Wi-Fi: клавиатура наконец достижима
    Экрана не было в двенадцати макетах - там нарисованы состояния
    работающего прибора, а это настройка. Устройство по §5.3.3.1:
    сканирование, список сетей, энкодер 1 - навигация, кнопка - выбор,
    дальше клавиатура для пароля.
    Это первое место, откуда клавиатура вообще открывается. До него она
    была написана, но недостижима.
    В сетевой модуль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
2026-08-28 RDS: имя станции в эфире
    Тюнер отмечал только флаг синхронизации, декодера групп не было -
    на экране висела частота вместо названия. Теперь разбирается группа 0,
    та, что несёт имя станции. Прочее - время, радиотекст, альтернативные
    частоты - пропускаем: на экране им места нет.
    Имя приходит по две буквы в четырёх сообщениях. Собирается через три
    буфера, и это не избыточность. Эфир шумит,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
2026-08-28 Автопоиск: проход по диапазону с записью найденного
    Шкала умела показывать засечки, но никто их не ставил - самого прохода
    не было. Теперь есть.
    Проход идёт аппаратным SEEK: чип сам решает, есть ли на частоте
    станция, по порогу уровня. Перебирать частоты в коде было бы
    и медленнее, и хуже - у чипа для этого отдельный тракт.
    Три условия выхода, и все нужны. Флаг SF - край диапазона, нормальн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
2026-08-28 Поиск станций в каталоге: интернет-радио наконец играет
    Самый важный из недостающих экранов. Без него в ячейках
    интернет-пресетов нет адреса потока, а значит интернет-радио
    не играло вовсе - весь конвейер ADF, переключение режимов и диалоги
    недоступности были написаны и ждали именно этого.
    Порядок работы: клавиатура спрашивает, что искать; запрос уходит
    в своей задаче; список найде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
2026-08-28 Список станций: переименование и освобождение ячеек
    Экран нужен по трём причинам, и все три возникли по ходу работы,
    а не были придуманы заранее.
    Автопоиск записывает станции без имён - RDS за доли секунды прохода
    не прочитать. Подписать их можно только здесь. Поиск по каталогу
    отказывается сохранять станцию, когда все ячейки заняты, и отсылает
    человека сюда освобождать место. И §5.3.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
2026-08-28 Диагностика, заполнение буфера и настройки, которые применяются
    Экран состояния прибора (§5.3.3.5). Формулировка спецификации -
    "экран диагностики без подключения к компьютеру" - и есть точная
    постановка: всё это видно и в журнале через USB, смысл в том, чтобы
    для этого не нужен был компьютер.
    Отбор строк: не всё, что можно измерить, а то, чего не хватает, когда
    прибор ведёт себя странно. Се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
2026-08-28 Яркость экрана и таблица модальных экранов вместо цепочки if
    Яркость (§5.3.3.3). Единственная настройка, где важен способ показа:
    её надо крутить, глядя на результат. Поэтому значение применяется сразу
    при вращении, а не при подтверждении - настройка яркости вслепую это
    подбор наугад. Обратная сторона: выход кнопкой "назад" возвращает
    прежнюю, запомненную при входе.
    Нижний предел 10%, не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
2026-08-28 Часы: последний неработающий пункт меню закрыт
    По §5.3.3.2: NTP по умолчанию, ручной режим, часовой пояс, формат
    24 часа или AM/PM.
    Ручная установка сделана полностью, хотя нужна редко. Оставить её
    недоделанной было нельзя: переключатель "источник времени" без
    работающего ручного режима - тупик, который прибор сам же и предлагает.
    Правка идёт полем за полем прямо в строке, отдельного экрана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
2026-08-28 Состояние проекта в документах: восемнадцать экранов и четыре пробела
    Таблица в макетах устарела на семь экранов. Обновлена, и к ней добавлен
    отдельный список того, чего в макетах не было вовсе: шесть экранов
    настройки. Их там и не могло быть - в макетах нарисованы состояния
    работающего прибора.
    Список незакрытого теперь короткий, и у каждого пункта причина, а не
    "не успели": ICY-мета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
2026-08-28 Два владельца I2S: интернет-звук не поднялся бы вовсе
    Найдено проверкой мёртвого кода, а не сборкой - собиралось всё это
    прекрасно.
    ipradio_audio_init поднимал свой канал I2S с I2S_NUM_AUTO, то есть
    брал первый свободный контроллер - нулевой. А i2s_stream из ESP-ADF
    просит именно I2S_NUM_0: это зашито в I2S_STREAM_CFG_DEFAULT().
    Звуковой тракт поднимается раньше конвейера, значит порт оказывался
    занят, и конвейер до ЦАП не д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
2026-08-28 Полоса пресетов и правило 4: два требования §5.2, до которых не дошли
    Найдено сверкой кода со спецификацией, а не по памяти.
    ПРАВИЛО 2. Интернет-ячейки должны гаснуть заранее, когда сети нет:
    недоступность видна ДО нажатия, а не после - нажатие не должно
    отвечать тишиной. Не было сделано вовсе: полоса пресетов показывала
    восемь заглушек "-" и не читала банк.
    Теперь читает. Каждая ячейка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
2026-08-29 Сторож задач: принят с правками, плюс замечания стороннего разбора
    Модуль написан сторонним исполнителем по ТЗ. Главную ловушку задания
    он взял верно: задача автомата ждёт очередь без таймаута и в исправном
    приборе молчит минутами, поэтому регистрируется с флагом BLOCKED_OK -
    при просрочке отметки надзиратель смотрит на состояние задачи в
    планировщике. Разовые задачи под надзор не в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
    [app_main.c, ipradio_input.c, ipradio_netradio.c, ipradio_state.c, ipradio_state.h, ipradio_tuner.c, ipradio_ui.c, ipradio_ui.h]
2026-08-29 Исправления по стороннему разбору кода
    Все замечания проверены по нашему коду, ложных не было.
    КРИТИЧЕСКИЕ
    1. Расширитель портов был включён по умолчанию, а драйвера MCP23017
    в прошивке нет вовсе. Из-за этого таблица кнопок собиралась в ветке
    #else, и при обычной сборке восемь кнопок пресетов и кнопка режима
    были мертвы. Переключено на 0: пять пресетов и MODE работают
    напрямую с выво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
    [app_main.c, board_pins.h, ipradio_audio.c, ipradio_bridge.c, ipradio_input.c, ipradio_net.c, ipradio_net.h, ipradio_netradio.c]
2026-08-29 Тюнер по даташиту RDA5807M v1.1
    Даташит получен и положен в docs/ref. Сверено всё, что раньше бралось
    по общим сведениям.
    ПОДТВЕРДИЛОСЬ БЕЗ ИЗМЕНЕНИЙ: адреса блоков RDS 0x0C-0x0F именно
    RDSA-RDSD (стр. 12); уровень сигнала в 0BH биты 15:9; флаги 0AH -
    RDSR 15, STC 14, SF 13, RDSS 12; база отсчёта каналов 87 МГц для
    BAND=0. Пометка "не проверено" снята: гадать не пришлось, всё совпало.
    ИСПРАВЛЕНО ЧЕТЫРЕ ВЕЩИ.
    1. Предыскажения были а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
    [ipradio_tuner.c]
2026-09-04 Первый запуск на плате: три ошибки, из-за которых экран был белым
    Плата пришла, прошивка залита. Загружалась до конца, а панель показывала
    белый экран. Разобрано по журналу с живого железа.
    1. ПЕРЕПУТАННЫЙ ЗНАК У ЗАМКА LVGL.
    bsp_display_lock() в BSP платы объявлена как bool, а возвращает
    esp_err_t от адаптера, где ESP_OK - это НОЛЬ. То есть при удачном
    захвате она отдаёт ложь.
    Проверка "if (!bsp_display_lock(1000)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
2026-09-04 Крупный шрифт на главном экране, значок сети, «регулятор» вместо «энкодера»
    По замечаниям заказчика после первого включения на живой плате.
    Пятидюймовая панель 1280x720 стоит в комнате, и то, что на макете
    выглядело соразмерно, вживую оказалось мелким и потерянным в пустоте.
    УВЕЛИЧЕНО ВДВОЕ: часы (20 -> 40), громкость (16 -> 40), плашка режима
    (14 -> 28 полужирный), частота (48 -> 96 полужирный), диапа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
2026-09-04 Громкость не налезает на плашку режима, подсказки читаемы
    Замечания заказчика по виду на живой панели.
    Громкость сдвинута влево на 60 точек. Панель 1280 точек на пяти
    дюймах - это около 110 мм ширины, то есть примерно 11,6 точки
    на миллиметр; полсантиметра, о которых шла речь, и есть эти 60.
    Полоса подсказок белым и кеглем 20 вместо приглушённого 14. Она
    объясняет, каким органом что делается, -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
2026-09-04 Подпись диапазона над частотой
    По замечанию заказчика после просмотра на живой панели: сверху
    "FM диапазон", под ней частота. Раньше было наоборот, и крупное
    число висело без объяснения, что это вообще за число.
    Кегли не менялись: подпись взяла тот же 56, что был у голого "FM",
    частота осталась на 96.
    Диапазон теперь отдельной строкой и не зависит от RDS - он один
    и тот же, передаёт станция н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
2026-09-04 Переполнение стека автомата и вёрстка интернет-режима
    Главное найдено при показе экрана интернет-режима, но к показу
    отношения не имеет: ПРИ ПЕРВОМ ЖЕ НАЖАТИИ ПРЕСЕТА задача автомата
    падала с защитой стека.
    Причина: структура банка занимает около 2,5 КБ, и она ложилась
    на стек в 4 КБ - сперва в обработчике события, потом ещё раз
    в подписчике, который зовётся из этой же задачи. То есть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
2026-09-05 Показ экранов при старте — для проверок без регуляторов
    Ключ IPRADIO_DEMO_SCREEN в app_main: при единице через две секунды
    после запуска само открывается меню настроек.
    Заведено по нужде. Регуляторы к плате ещё не подключены, а меню
    открывается только долгим нажатием регулятора 1 — то есть до всех
    экранов настройки без пайки не добраться никак, и посмотреть их
    на живой панели было нечем.
    Откр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
2026-09-05 Карта памяти заработала: питание слота и длинные имена файлов
    Две ошибки, обе видны только на железе.
    1. СЛОТ КАРТЫ НЕ БЫЛ ЗАПИТАН. У ESP32-P4 линия питания карты идёт
    не напрямую, а через внутренний стабилизатор кристалла, и его надо
    включать руками. Пока он выключен, карта обесточена: контроллер
    шлёт команду инициализации и получает тайм-аут - «send_op_cond
    returned 0x107». Выводы при этом с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
2026-09-05 Внутренняя память кончилась, оси касания и «занятые» пустые ячейки
    Разбор на живой плате. Четыре настоящие ошибки, все видны только
    на железе.
    1. ОСИ КАСАНИЯ НЕ ПОВЁРНУТЫ. Экран крутится на 90 градусов, а тач
    выдавал координаты в родных осях панели, 720x1280. Нажатия попадали
    мимо всего: не отзывалась ни одна кнопка, и выглядело это как
    «тачскрин не работает».
    Соответствие снято з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
2026-09-05 Освободить внутреннюю память: стеки в PSRAM, динамический TLS, урезанные сетевые буферы
    Внутренней памяти оставалось 2 КБ при наибольшем свободном куске 0.
    Отсюда шли все три беды: интерфейс тормозил вдвое, задача поиска
    станций не создавалась молча (человек видел «ничего не нашлось»),
    а поток по https падал на рукопожатии.
    Сделано:
    * Стеки своих задач - в PSRAM через xTaskCreateWithCaps: автомат,
    инт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
2026-09-05 Интернет-радио заиграло: память, зависание PPA, шина I²C
    За день нашлись четыре причины, и ни одна не была той, на которую
    думали вначале.
    1. НЕХВАТКА ВНУТРЕННЕЙ ПАМЯТИ
    В момент подключения к станции свободной внутренней оставалось 2 КБ:
    рукопожатие TLS падало на alloc(2389 bytes) failed, драйвер SDIO -
    на нехватке буферов приёма.
    * Стеки задач ESP-ADF - в PSRAM. Патчи ADF к ESP-IDF для этого
    не нужны: ADF объявляет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
    [app_main.c, board_pins.h, ipradio_adf_stack.c, ipradio_audio.c, ipradio_board_codec.c, ipradio_board_codec.h, ipradio_net.c, ipradio_netradio.c]
2026-09-05 Управление с экрана: громкость, часы, яркость, ячейки станций
    Обвязка ещё не подключена - ни энкодеров, ни кнопок. Всё, что штатно
    делается ими, должно быть доступно пальцем, иначе прибором нельзя
    пользоваться вовсе.
    ГРОМКОСТЬ
    Вертикальный ползунок на главном экране. Он один на оба режима:
    экран у эфира и интернет-радио общий, и регулятор в тракте тоже один.
    Постоянно висеть ему нез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
2026-10-02 Плата-носитель модулей: схема, проверки и правки по внешним разборам
    Отдельная плата под тюнер RRD-102, ЦАП GY-PCM5102A, два усилителя HW-327,
    пассивный микшер, MCP23017, DC-DC и вход 12 В; к ESP32-P4 — шлейфом 2x20.
    Обоснования — docs/33-carrier-board.md.
    Почему так устроено:
    - Плата P4 питается 5 В через USB-A -> USB-C, а не через гребёнку J3:
    по схеме Waveshare зарядник батареи ETA6098 стоит на VCC'_5V за
    идеальным диодом Q4, и 5 В с гребёнк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
2026-10-05 Плата-носитель: исправлены ошибки, найденные самопроверкой
    Схема:
    - Разделительные 4,7 мкФ на выходах LOUT/ROUT тюнера. У RDA5807M
    выходы сидят на постоянном напряжении 1,0-1,1 В (даташит V1.1, с. 7),
    в типовой схеме производителя (рис. 8-1) стоят 4,7 мкФ. Без них
    постоянка шла в узел микшера и через 10 кОм в выход ЦАП. Ошибка
    тянулась со сборки на Pi.
    - Последовательный 100 пФ на входе антенны — как C7 в то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
2026-10-05 docs/33: динамики LY2102-3 и расчёт уровней на них
    Динамики 4 Ом / 10 Вт подходят: минимальная нагрузка TPA3118D2 3,2 Ом
    в BTL и 1,6 Ом в PBTL (даташит TI, с. 5); БП 5 А с запасом.
    Расчёт при 26 дБ показал перекос микшера: ЦАП на полной шкале даёт ~3 Вт,
    эфир на пиках перегружает динамик. Схему не меняем — уровни выставить
    на плате после замера усиления HW-327, громкость тюнера ограничить
    в прошивке.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
2026-10-06 Прошивка: память в PSRAM, меню ячейки, раздельные банки, проверки на машине
    Всё, что накопилось с 188f912 и проверено на плате 2026-10-05/06.
    Память (разбор и замеры - docs/34-memory.md):
    - mbedTLS в PSRAM: по умолчанию IDF держал всю память TLS во
    внутренней (esp_mem.c), отсюда «станция не подключается» (0x4290);
    - буфер приёма SDIO в PSRAM: своя копия esp_hosted 1.4.7 в
    firmware/components/esp_hosted (override_path, правка описана в
    PATCHES.md); прежде его рост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
2026-10-07 Плата-носитель: посадочные места модулей, пайка проводов органов управления
    Посадочные места всех пяти модулей (hardware/skidl/make_footprints.py ->
    hybrid-radio.pretty), геометрия и источники — docs/33, §13:
    - RRD-102: площадки по библиотеке JLCEDA (LCSC C9900205627); раскладка
    совпала с реверсом модуля (briankhuu.com, 2015) — паять микросхемой вверх.
    - GY-PCM5102A, MCP23017-CJMCU: в гнёзда 2,54, микросхемой вверх (подтверждено).
    Взаимное положение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
2026-10-13 Тюнер на плате: поиск и RDS работают; каталог по https
    Тюнер RDA5807M впервые подключён к плате 2026-10-14.
    Тюнер (ipradio_tuner.c):
    - бит TUNE снимается в копии регистра 03H сразу после записи: чип
    сбрасывает его сам (даташит V1.1, с. 10), а write_regs шлёт
    02H..05H вместе - каждая запись, включая SEEK, перезапускала
    настройку, и проход по диапазону не находил ничего;
    - таймаут шага поиска 3 -> 10 с (время поиска в даташите не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
2026-10-18 Доп. платы к P4, кнопки пресетов на MCP23017, Raspberry Pi помечен неактуальным
    Прошивка:
    - драйвер расширителя MCP23017 в модуле ввода: опрос портов по I2C
    в цикле ввода (5 мс), подтяжки, GPA7/GPB7 - выходы с нулём (только
    выходы, Microchip DS20001952D); пресеты 1-7 GPA0-6, пресет 8 GPB0,
    MODE GPB1 - по фактической проводке макета;
    - защита от ложных нажатий: проверка настройки расширителя раз в
    секунду с повторной настройкой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
2026-10-20 board_pins.h: раскладка MCP23017 (GPB0 - пресет 8, GPB1 - MODE) совпадает со схемой
    Кнопка MODE проверена на плате 2026-10-20: контакт NO между GPB1 и GND,
    переключает эфир <-> интернет в обе стороны.
